cpldcpu/TouchSynth/docs/figures/s7_power.pdf

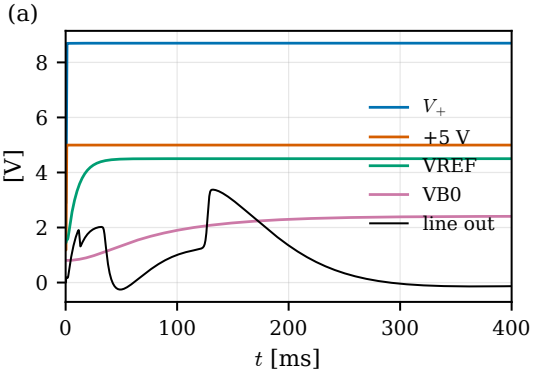
[picture p52: figure]
V + +5 V VREF; VB0 line out

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
−2024

# ¢VREF [mV] (b)
