cpldcpu/TouchSynth/docs/figures/s1_dco_waveforms.pdf

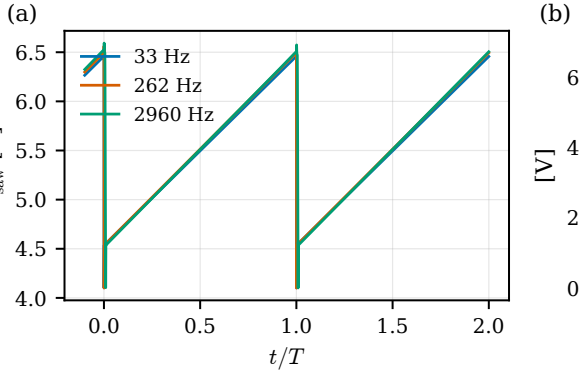
[picture p53: figure]
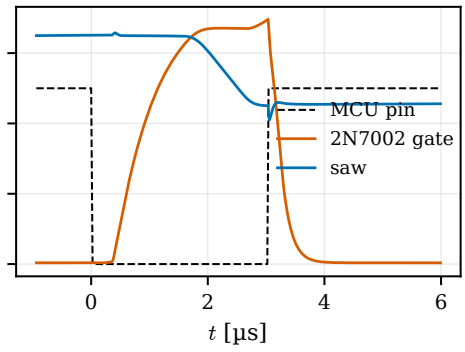
[picture p54: figure]
MCU pin; 2N7002 gate saw

### Vsaw [V]
