cpldcpu/TouchSynth/docs/figures/s2_cv_filter.pdf

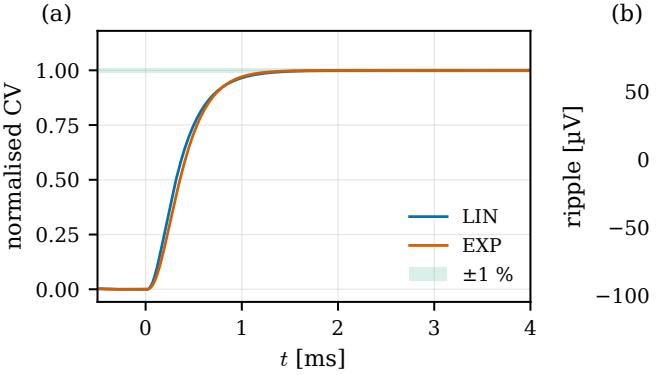
[picture p55: figure]
normalised CV; LIN EXP ±1 %; ripple [µV]
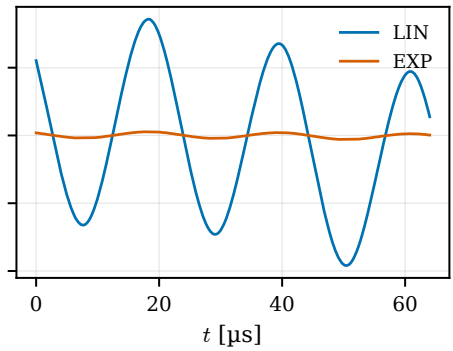
[picture p56: figure]
LIN EXP
