cpldcpu/TouchSynth/docs/figures/audio/01_saw.png

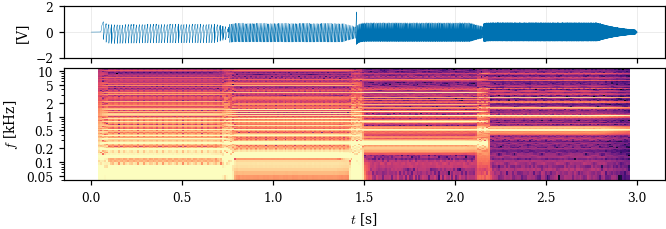
docs/figures/audio/01_saw.png
