cpldcpu/TouchSynth/docs/figures/audio/02_pulse.png

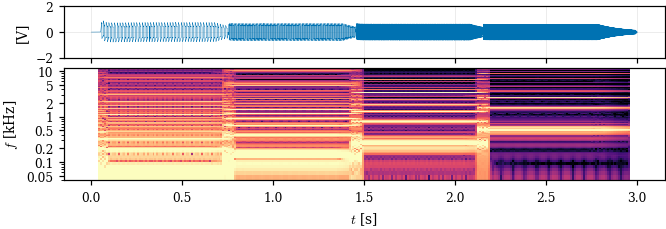
docs/figures/audio/02_pulse.png
