cpldcpu/TouchSynth/docs/figures/audio/03_pw_sweep.png

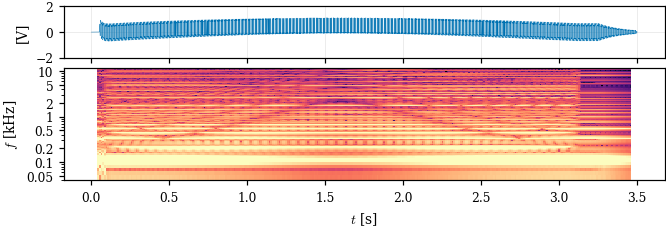
docs/figures/audio/03_pw_sweep.png
