cpldcpu/TouchSynth/docs/figures/audio/04_pwm_lfo.png

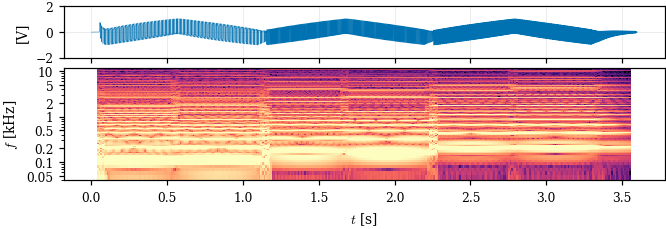
docs/figures/audio/04_pwm_lfo.png
