cpldcpu/TouchSynth/docs/figures/audio/05_sub.png

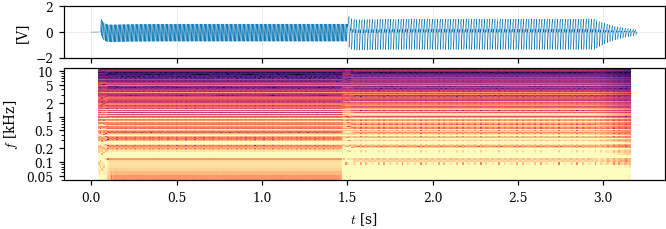
docs/figures/audio/05_sub.png
