cpldcpu/TouchSynth/docs/figures/audio/06_noise.png

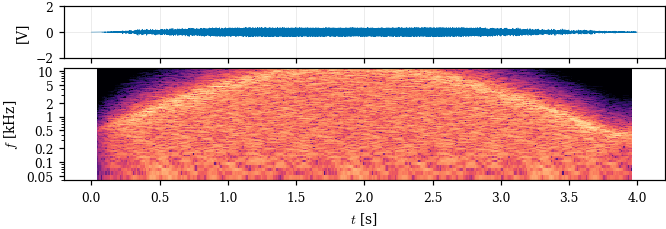
docs/figures/audio/06_noise.png
