cpldcpu/TouchSynth/docs/figures/audio/07_mix_drive.png

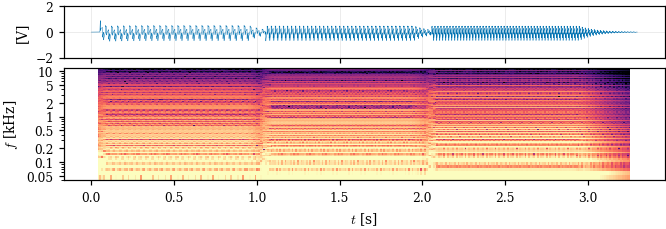
docs/figures/audio/07_mix_drive.png
