cpldcpu/TouchSynth/docs/figures/audio/09_resonance.png

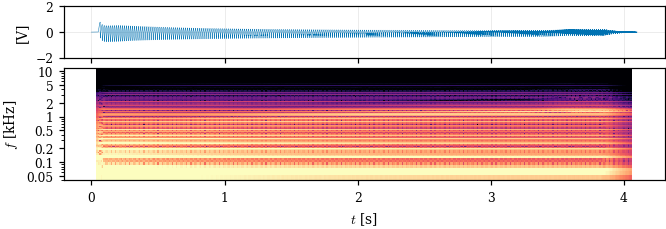
docs/figures/audio/09_resonance.png
