cpldcpu/TouchSynth/docs/figures/audio/12_filter_env.png

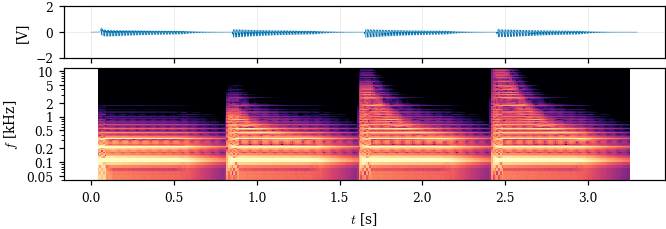
docs/figures/audio/12_filter_env.png
