cpldcpu/TouchSynth/docs/figures/audio/13_keytrack.png

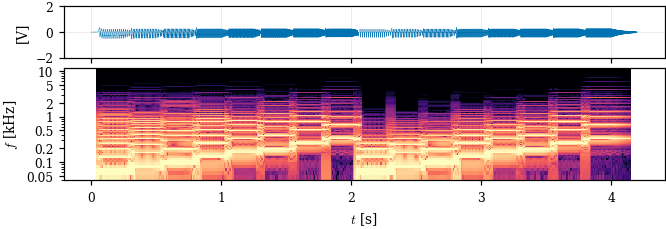
docs/figures/audio/13_keytrack.png
