cpldcpu/TouchSynth/docs/figures/audio/14_amp_env.png

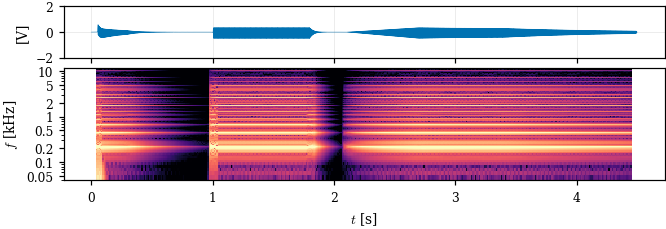
docs/figures/audio/14_amp_env.png
