cpldcpu/TouchSynth/docs/figures/audio/15_vca_trim.png

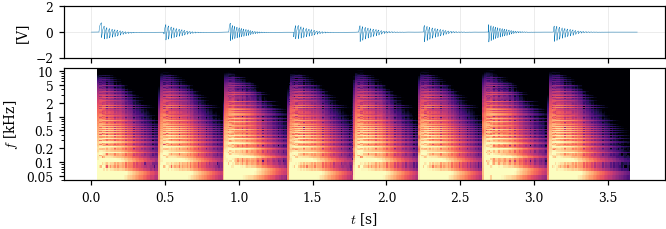
docs/figures/audio/15_vca_trim.png
