cpldcpu/TouchSynth/docs/figures/audio/16_glide.png

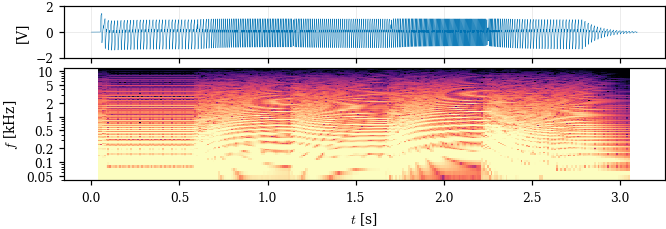
docs/figures/audio/16_glide.png
