cpldcpu/TouchSynth/docs/figures/audio/17_vibrato.png

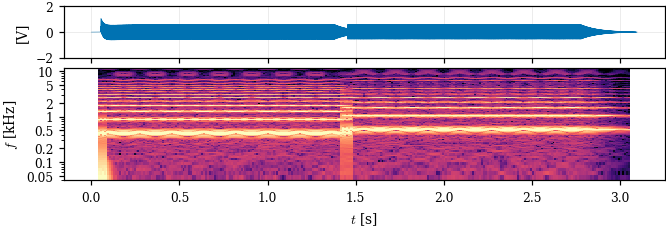
docs/figures/audio/17_vibrato.png
