cpldcpu/TouchSynth/docs/figures/audio/18_wah.png

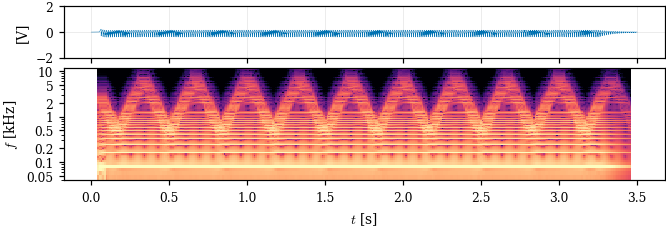
docs/figures/audio/18_wah.png
