cpldcpu/TouchSynth/docs/figures/audio/19_arp.png

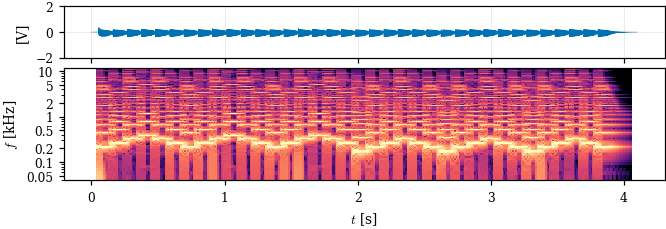
docs/figures/audio/19_arp.png
