cpldcpu/TouchSynth/docs/figures/hw_board1_dco.png

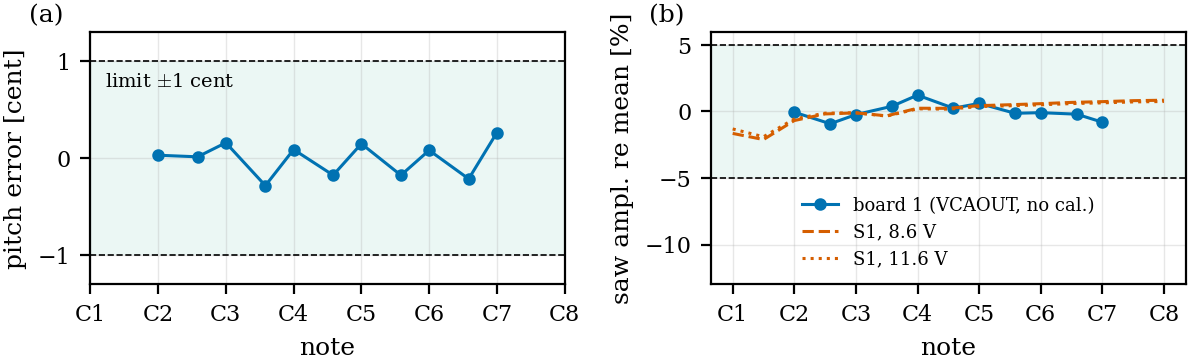
docs/figures/hw_board1_dco.png
