cpldcpu/TouchSynth/docs/figures/hw_board1_hum.png

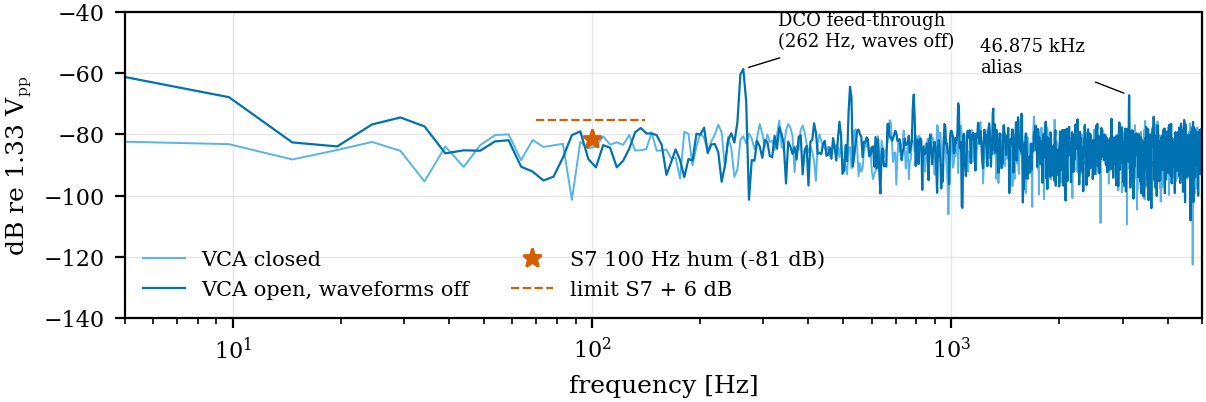
docs/figures/hw_board1_hum.png
