cpldcpu/TouchSynth/docs/figures/hw_board1_vca.png

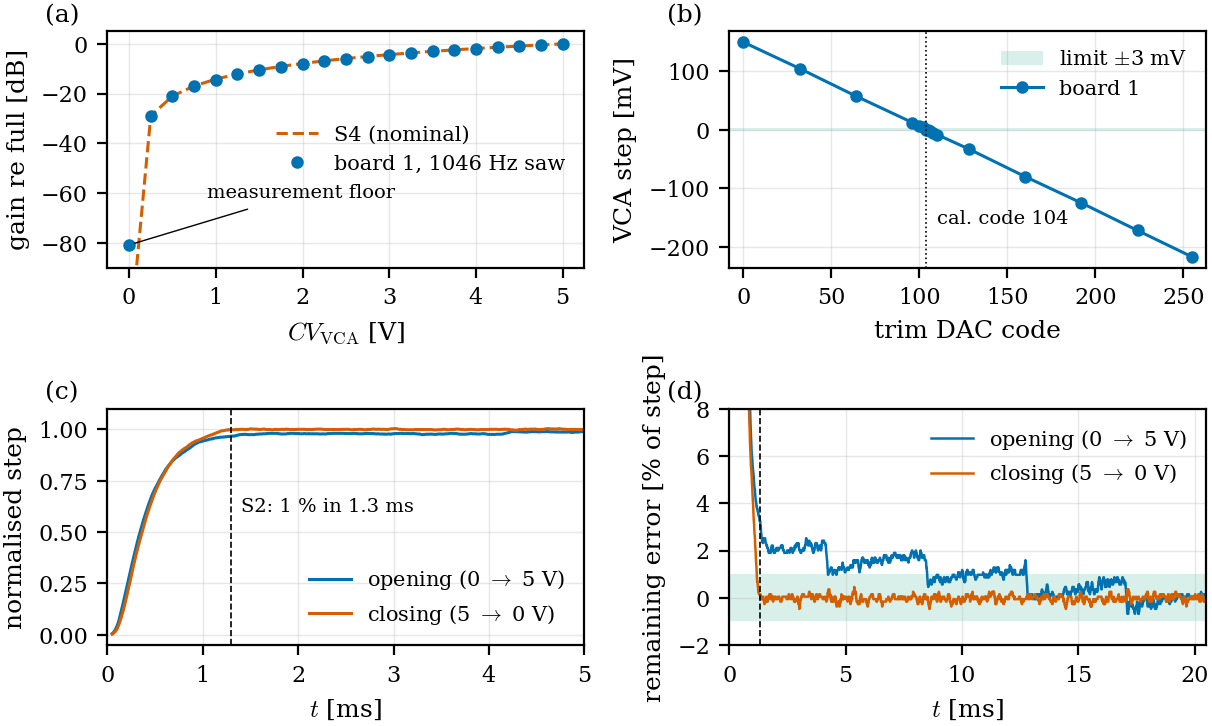
docs/figures/hw_board1_vca.png
