cpldcpu/TouchSynth/docs/figures/hw_board1_vcf.png

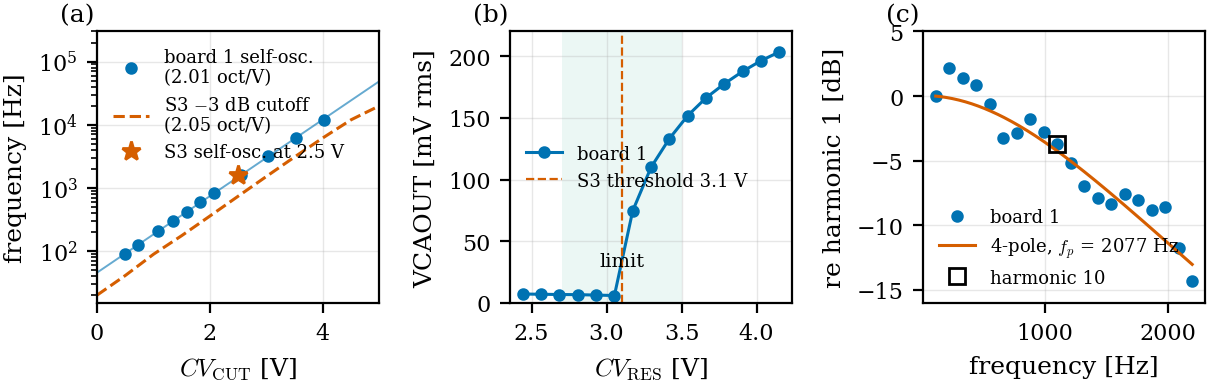
docs/figures/hw_board1_vcf.png
