cpldcpu/TouchSynth/docs/figures/pcb/render_top_placed.png

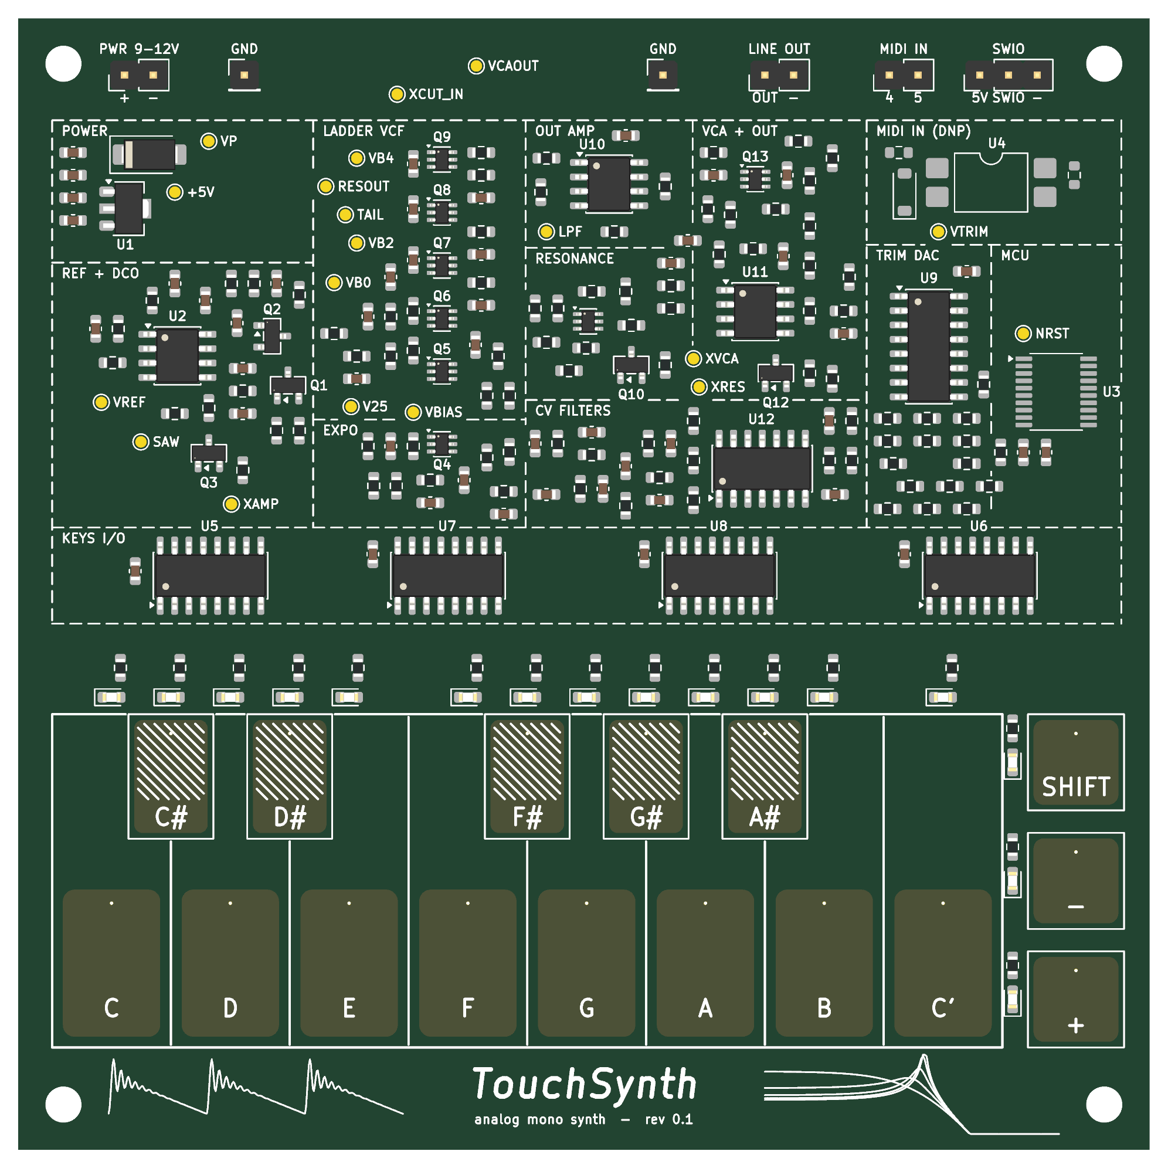
docs/figures/pcb/render_top_placed.png
