cpldcpu/TouchSynth/parts/jlcpcb_basic_and_promotional_parts.csv

lcsc | library | category | subcategory | mfr_part | brand | package | description | stock | price_usd | attributes | datasheet | url
C9634 | basic | Bipolar (BJT) | Bipolar (BJT) | D882(RANGE:160-320) | Jiangsu Changjing Electronics Technology Co., Ltd. | SOT-89-3L | -55℃~+150℃ 1 NPN 160 1uA 30V 3A 500mV 500mW 50MHz 6V NPN SOT-89-3L Bipolar (BJT) ROHS | 171660 | 0.0648 | Operating Temperature=-55℃~+150℃; Transition frequency(fT)=50MHz; Collector - Emitter Voltage VCEO=30V; Number=1 NPN; DC Current Gain=160; Current - Collector(Ic)=3A; Vce Saturation(VCE(sat))=500mV; Emitter-Base Voltage(Vebo)=6V; Pd - Power Dissipation=500mW; type=NPN; Current - Collector Cutoff=1uA | https://www.lcsc.com/datasheet/lcsc_datasheet_1809192311_Jiangsu-Changjing-Electronics-Technology-Co---Ltd--D882-RANGE-160-320_C9634.pdf | https://jlcpcb.com/partdetail/10164-D882_RANGE_160_320/C9634
C8512 | basic | Bipolar (BJT) | Bipolar (BJT) | MMBT2222A 1P | Jiangsu Changjing Electronics Technology Co., Ltd. | SOT-23 | -55℃~+150℃ 1 NPN 100 10nA 300MHz 300mW 40V 600mA 6V NPN SOT-23 Bipolar (BJT) ROHS | 585299 | 0.0174 | Operating Temperature=-55℃~+150℃; Transition frequency(fT)=300MHz; Collector - Emitter Voltage VCEO=40V; Number=1 NPN; DC Current Gain=100; Current - Collector(Ic)=600mA; Vce Saturation(VCE(sat))=-; Emitter-Base Voltage(Vebo)=6V; Pd - Power Dissipation=300mW; type=NPN; Current - Collector Cutoff=10nA | https://www.lcsc.com/datasheet/lcsc_datasheet_1811081957_Jiangsu-Changjing-Electronics-Technology-Co---Ltd--MMBT2222A-1P_C8512.pdf | https://jlcpcb.com/partdetail/9007-MMBT2222A1P/C8512
C20526 | basic | Bipolar (BJT) | Bipolar (BJT) | MMBT3904(RANGE:100-300) | Jiangsu Changjing Electronics Technology Co., Ltd. | SOT-23 | -55℃~+150℃ 1 NPN 100 100nA 200mA 200mW 300MHz 300mV 40V 6V NPN SOT-23 Bipolar (BJT) ROHS | 307260 | 0.0115 | Operating Temperature=-55℃~+150℃; Transition frequency(fT)=300MHz; Collector - Emitter Voltage VCEO=40V; Number=1 NPN; DC Current Gain=100; Current - Collector(Ic)=200mA; Vce Saturation(VCE(sat))=300mV; Emitter-Base Voltage(Vebo)=6V; Pd - Power Dissipation=200mW; type=NPN; Current - Collector Cutoff=100nA | https://www.lcsc.com/datasheet/lcsc_datasheet_2207041900_Jiangsu-Changjing-Electronics-Technology-Co---Ltd--MMBT3904-RANGE-100-300_C20526.pdf | https://jlcpcb.com/partdetail/21237-MMBT3904_RANGE_100_300/C20526
C8326 | basic | Bipolar (BJT) | Bipolar (BJT) | MMBT5401(RANGE:200-300) | Jiangsu Changjing Electronics Technology Co., Ltd. | SOT-23 | -55℃~+150℃ 1 PNP 100MHz 100nA 150V 300 300mW 500mV 5V 600mA PNP SOT-23 Bipolar (BJT) ROHS | 758577 | 0.0151 | Operating Temperature=-55℃~+150℃; Transition frequency(fT)=100MHz; Collector - Emitter Voltage VCEO=150V; Number=1 PNP; Configuration=-; DC Current Gain=300; Current - Collector(Ic)=600mA; Vce Saturation(VCE(sat))=500mV; Emitter-Base Voltage(Vebo)=5V; Pd - Power Dissipation=300mW; type=PNP; Current - Collector Cutoff=100nA | https://www.lcsc.com/datasheet/lcsc_datasheet_1809140241_Jiangsu-Changjing-Electronics-Technology-Co---Ltd--MMBT5401-RANGE-200-300_C8326.pdf | https://jlcpcb.com/partdetail/8818-MMBT5401_RANGE_200_300/C8326
C2145 | basic | Bipolar (BJT) | Bipolar (BJT) | MMBT5551(RANGE:200-300) | Jiangsu Changjing Electronics Technology Co., Ltd. | SOT-23 | -55℃~+150℃ 1 NPN 160V 200 200mV 300MHz 300mW 50nA 600mA 6V NPN SOT-23 Bipolar (BJT) ROHS | 1900579 | 0.0152 | Operating Temperature=-55℃~+150℃; Transition frequency(fT)=300MHz; Collector - Emitter Voltage VCEO=160V; Number=1 NPN; DC Current Gain=200; Current - Collector(Ic)=600mA; Vce Saturation(VCE(sat))=200mV; Emitter-Base Voltage(Vebo)=6V; Pd - Power Dissipation=300mW; type=NPN; Current - Collector Cutoff=50nA | https://www.lcsc.com/datasheet/lcsc_datasheet_2304140030_Jiangsu-Changjing-Electronics-Technology-Co---Ltd--MMBT5551-RANGE-200-300_C2145.pdf | https://jlcpcb.com/partdetail/2502-MMBT5551_RANGE_200_300/C2145
C2146 | basic | Bipolar (BJT) | Bipolar (BJT) | S8050 J3Y(RANGE:200-350) | Jiangsu Changjing Electronics Technology Co., Ltd. | SOT-23 | -55℃~+150℃ 1 NPN 100nA 150MHz 200 25V 300mW 500mA 5V 600mV NPN SOT-23 Bipolar (BJT) ROHS | 1263036 | 0.0147 | Operating Temperature=-55℃~+150℃; Transition frequency(fT)=150MHz; Collector - Emitter Voltage VCEO=25V; Number=1 NPN; Configuration=-; DC Current Gain=200; Current - Collector(Ic)=500mA; Vce Saturation(VCE(sat))=600mV; Emitter-Base Voltage(Vebo)=5V; Pd - Power Dissipation=300mW; type=NPN; Current - Collector Cutoff=100nA | https://www.lcsc.com/datasheet/lcsc_datasheet_2310131500_Jiangsu-Changjing-Electronics-Technology-Co---Ltd--S8050-J3Y-RANGE-200-350_C2146.pdf | https://jlcpcb.com/partdetail/2503-S8050_J3Y_RANGE_200_350/C2146
C105432 | basic | Bipolar (BJT) | Bipolar (BJT) | S8550(RANGE:120-200) | Jiangsu Changjing Electronics Technology Co., Ltd. | SOT-23 | -55℃~+150℃ 1 PNP 100nA 120 150MHz 25V 300mW 500mA 5V 600mV PNP SOT-23 Bipolar (BJT) ROHS | 191059 | 0.0166 | Operating Temperature=-55℃~+150℃; Transition frequency(fT)=150MHz; Collector - Emitter Voltage VCEO=25V; Number=1 PNP; DC Current Gain=120; Current - Collector(Ic)=500mA; Vce Saturation(VCE(sat))=600mV; Emitter-Base Voltage(Vebo)=5V; Pd - Power Dissipation=300mW; type=PNP; Current - Collector Cutoff=100nA | https://www.lcsc.com/datasheet/lcsc_datasheet_2304140030_Jiangsu-Changjing-Electronics-Technology-Co---Ltd--S8550-RANGE-120-200_C105432.pdf | https://jlcpcb.com/partdetail/106647-S8550_RANGE_120_200/C105432
C8543 | basic | Bipolar (BJT) | Bipolar (BJT) | S9012 2T1(RANGE:200-350) | Jiangsu Changjing Electronics Technology Co., Ltd. | SOT-23 | -55℃~+150℃ 1 PNP 100nA 120 150MHz 25V 300mW 500mA 5V 600mV PNP SOT-23 Bipolar (BJT) ROHS | 259409 | 0.0192 | Operating Temperature=-55℃~+150℃; Transition frequency(fT)=150MHz; Collector - Emitter Voltage VCEO=25V; Number=1 PNP; DC Current Gain=120; Current - Collector(Ic)=500mA; Vce Saturation(VCE(sat))=600mV; Emitter-Base Voltage(Vebo)=5V; Pd - Power Dissipation=300mW; type=PNP; Current - Collector Cutoff=100nA | https://www.lcsc.com/datasheet/lcsc_datasheet_2304140030_Jiangsu-Changjing-Electronics-Technology-Co---Ltd--S9012-2T1-RANGE-200-350_C8543.pdf | https://jlcpcb.com/partdetail/9038-S9012_2T1_RANGE_200_350/C8543
C6749 | basic | Bipolar (BJT) | Bipolar (BJT) | S9013 J3(RANGE:200-350) | Jiangsu Changjing Electronics Technology Co., Ltd. | SOT-23 | -55℃~+150℃ 1 NPN 100nA 120 150MHz 25V 300mW 500mA 5V 600mV NPN SOT-23 Bipolar (BJT) ROHS | 853229 | 0.0153 | Operating Temperature=-55℃~+150℃; Transition frequency(fT)=150MHz; Collector - Emitter Voltage VCEO=25V; Configuration=Standalone; Number=1 NPN; DC Current Gain=120; Current - Collector(Ic)=500mA; Vce Saturation(VCE(sat))=600mV; Emitter-Base Voltage(Vebo)=5V; Pd - Power Dissipation=300mW; type=NPN; Current - Collector Cutoff=100nA | https://www.lcsc.com/datasheet/lcsc_datasheet_1810051504_Jiangsu-Changjing-Electronics-Technology-Co---Ltd--S9013-J3-RANGE-200-350_C6749.pdf | https://jlcpcb.com/partdetail/7216-S9013_J3_RANGE_200_350/C6749
C2150 | basic | Bipolar (BJT) | Bipolar (BJT) | SS8050(RANGE:200-350) | Jiangsu Changjing Electronics Technology Co., Ltd. | SOT-23 | -55℃~+150℃ 1 NPN 1.5A 100MHz 100nA 200 25V 300mW 500mV 5V NPN SOT-23 Bipolar (BJT) ROHS | 1824424 | 0.0156 | Operating Temperature=-55℃~+150℃; Transition frequency(fT)=100MHz; Collector - Emitter Voltage VCEO=25V; Configuration=Standalone; Number=1 NPN; DC Current Gain=200; Current - Collector(Ic)=1.5A; Vce Saturation(VCE(sat))=500mV; Emitter-Base Voltage(Vebo)=5V; Pd - Power Dissipation=300mW; type=NPN; Current - Collector Cutoff=100nA | https://www.lcsc.com/datasheet/lcsc_datasheet_2303221100_Jiangsu-Changjing-Electronics-Technology-Co---Ltd--SS8050-RANGE-200-350_C2150.pdf | https://jlcpcb.com/partdetail/2507-SS8050_RANGE_200_350/C2150
C8542 | basic | Bipolar (BJT) | Bipolar (BJT) | SS8550 Y2(RANGE:200-350) | Jiangsu Changjing Electronics Technology Co., Ltd. | SOT-23 | -55℃~+150℃ 1 PNP 1.5A 100MHz 100nA 200 25V 300mW 500mV 5V PNP SOT-23 Bipolar (BJT) ROHS | 1075970 | 0.0155 | Operating Temperature=-55℃~+150℃; Transition frequency(fT)=100MHz; Collector - Emitter Voltage VCEO=25V; Number=1 PNP; Configuration=-; DC Current Gain=200; Current - Collector(Ic)=1.5A; Vce Saturation(VCE(sat))=500mV; Emitter-Base Voltage(Vebo)=5V; Pd - Power Dissipation=300mW; type=PNP; Current - Collector Cutoff=100nA | https://www.lcsc.com/datasheet/lcsc_datasheet_1810161212_Jiangsu-Changjing-Electronics-Technology-Co---Ltd--SS8550-Y2-RANGE-200-350_C8542.pdf | https://jlcpcb.com/partdetail/9037-SS8550_Y2_RANGE_200_350/C8542
C2488 | basic | Bridge Rectifiers | Bridge Rectifiers | MB10S-50MIL | MDD(Microdiode Semiconductor) | MBS | -55℃~+150℃ 1.1V@400mA 1A 1kV 35A 5uA@1kV Single-Phase Rectifier MBS Bridge Rectifiers ROHS | 690760 | 0.027 | Voltage - Forward(Vf@If)=1.1V@400mA; Type=Single-Phase Rectifier; Non-Repetitive Peak Forward Surge Current=35A; Voltage - DC Reverse(Vr)=1kV; Operating Junction Temperature Range=-55℃~+150℃; Current - Rectified=1A; Reverse Leakage Current (Ir)=5uA@1kV | https://www.lcsc.com/datasheet/lcsc_datasheet_2408090954_MDD-Microdiode-Semiconductor-MB10S_C2488.pdf | https://jlcpcb.com/partdetail/2865-MB10S50MIL/C2488
C17168 | basic | Chip Resistor - Surface Mount | Chip Resistor - Surface Mount | 0402WGF0000TCE | UNI-ROYAL(Uniroyal Elec) | 0402 | -55℃~+155℃ 0Ω 50V 62.5mW Thick Film Resistor ±1% ±800ppm/℃ 0402 Chip Resistor - Surface Mount ROHS | 10247414 | 0.0025 | Resistance=0Ω; Operating Temperature=-55℃~+155℃; Power(Watts)=62.5mW; Type=Thick Film Resistor; Voltage-Supply(Max)=50V; Tolerance=±1%; Temperature Coefficient=±800ppm/℃ | https://www.lcsc.com/datasheet/lcsc_datasheet_2206010216_UNI-ROYAL-Uniroyal-Elec-0402WGF0000TCE_C17168.pdf | https://jlcpcb.com/partdetail/17853-0402WGF0000TCE/C17168
C25076 | basic | Chip Resistor - Surface Mount | Chip Resistor - Surface Mount | 0402WGF1000TCE | UNI-ROYAL(Uniroyal Elec) | 0402 | -55℃~+155℃ 100Ω 50V 62.5mW Thick Film Resistor ±1% ±100ppm/℃ 0402 Chip Resistor - Surface Mount ROHS | 4679469 | 0.0012 | Resistance=100Ω; Operating Temperature=-55℃~+155℃; Power(Watts)=62.5mW; Type=Thick Film Resistor; Voltage-Supply(Max)=50V; Tolerance=±1%; Temperature Coefficient=±100ppm/℃ | https://www.lcsc.com/datasheet/lcsc_datasheet_2205311900_UNI-ROYAL-Uniroyal-Elec-0402WGF1000TCE_C25076.pdf | https://jlcpcb.com/partdetail/25819-0402WGF1000TCE/C25076
C11702 | basic | Chip Resistor - Surface Mount | Chip Resistor - Surface Mount | 0402WGF1001TCE | UNI-ROYAL(Uniroyal Elec) | 0402 | -55℃~+155℃ 1kΩ 50V 62.5mW Thick Film Resistor ±1% ±100ppm/℃ 0402 Chip Resistor - Surface Mount ROHS | 8639962 | 0.0018 | Resistance=1kΩ; Operating Temperature=-55℃~+155℃; Power(Watts)=62.5mW; Type=Thick Film Resistor; Voltage-Supply(Max)=50V; Tolerance=±1%; Temperature Coefficient=±100ppm/℃ | https://www.lcsc.com/datasheet/lcsc_datasheet_2206010216_UNI-ROYAL-Uniroyal-Elec-0402WGF1001TCE_C11702.pdf | https://jlcpcb.com/partdetail/12256-0402WGF1001TCE/C11702
C25744 | basic | Chip Resistor - Surface Mount | Chip Resistor - Surface Mount | 0402WGF1002TCE | UNI-ROYAL(Uniroyal Elec) | 0402 | -55℃~+155℃ 10kΩ 50V 62.5mW Thick Film Resistor ±1% ±100ppm/℃ 0402 Chip Resistor - Surface Mount ROHS | 23696554 | 0.0034 | Resistance=10kΩ; Operating Temperature=-55℃~+155℃; Power(Watts)=62.5mW; Type=Thick Film Resistor; Voltage-Supply(Max)=50V; Tolerance=±1%; Temperature Coefficient=±100ppm/℃ | https://www.lcsc.com/datasheet/lcsc_datasheet_2411221126_UNI-ROYAL-Uniroyal-Elec-0402WGF1002TCE_C25744.pdf | https://jlcpcb.com/partdetail/26487-0402WGF1002TCE/C25744
C25741 | basic | Chip Resistor - Surface Mount | Chip Resistor - Surface Mount | 0402WGF1003TCE | UNI-ROYAL(Uniroyal Elec) | 0402 | -55℃~+155℃ 100kΩ 50V 62.5mW Thick Film Resistor ±1% ±100ppm/℃ 0402 Chip Resistor - Surface Mount ROHS | 9789764 | 0.0025 | Resistance=100kΩ; Operating Temperature=-55℃~+155℃; Power(Watts)=62.5mW; Type=Thick Film Resistor; Voltage-Supply(Max)=50V; Tolerance=±1%; Temperature Coefficient=±100ppm/℃ | https://www.lcsc.com/datasheet/lcsc_datasheet_2206010100_UNI-ROYAL-Uniroyal-Elec-0402WGF1003TCE_C25741.pdf | https://jlcpcb.com/partdetail/26484-0402WGF1003TCE/C25741
C26083 | basic | Chip Resistor - Surface Mount | Chip Resistor - Surface Mount | 0402WGF1004TCE | UNI-ROYAL(Uniroyal Elec) | 0402 | -55℃~+155℃ 1MΩ 50V 62.5mW Thick Film Resistor ±1% ±100ppm/℃ 0402 Chip Resistor - Surface Mount ROHS | 2677038 | 0.0026 | Resistance=1MΩ; Operating Temperature=-55℃~+155℃; Power(Watts)=62.5mW; Type=Thick Film Resistor; Voltage-Supply(Max)=50V; Tolerance=±1%; Temperature Coefficient=±100ppm/℃ | https://www.lcsc.com/datasheet/lcsc_datasheet_2206010030_UNI-ROYAL-Uniroyal-Elec-0402WGF1004TCE_C26083.pdf | https://jlcpcb.com/partdetail/26826-0402WGF1004TCE/C26083
C25077 | basic | Chip Resistor - Surface Mount | Chip Resistor - Surface Mount | 0402WGF100JTCE | UNI-ROYAL(Uniroyal Elec) | 0402 | -55℃~+155℃ 10Ω 50V 62.5mW Thick Film Resistor ±1% ±200ppm/℃ 0402 Chip Resistor - Surface Mount ROHS | 1977483 | 0.0029 | Resistance=10Ω; Operating Temperature=-55℃~+155℃; Power(Watts)=62.5mW; Type=Thick Film Resistor; Voltage-Supply(Max)=50V; Tolerance=±1%; Temperature Coefficient=±200ppm/℃ | https://www.lcsc.com/datasheet/lcsc_datasheet_2411221126_UNI-ROYAL-Uniroyal-Elec-0402WGF100JTCE_C25077.pdf | https://jlcpcb.com/partdetail/25820-0402WGF100JTCE/C25077
C25079 | basic | Chip Resistor - Surface Mount | Chip Resistor - Surface Mount | 0402WGF1200TCE | UNI-ROYAL(Uniroyal Elec) | 0402 | -55℃~+155℃ 120Ω 50V 62.5mW Thick Film Resistor ±1% ±100ppm/℃ 0402 Chip Resistor - Surface Mount ROHS | 834434 | 0.0034 | Resistance=120Ω; Operating Temperature=-55℃~+155℃; Power(Watts)=62.5mW; Type=Thick Film Resistor; Voltage-Supply(Max)=50V; Tolerance=±1%; Temperature Coefficient=±100ppm/℃ | https://www.lcsc.com/datasheet/lcsc_datasheet_2205311900_UNI-ROYAL-Uniroyal-Elec-0402WGF1200TCE_C25079.pdf | https://jlcpcb.com/partdetail/25822-0402WGF1200TCE/C25079
C25752 | basic | Chip Resistor - Surface Mount | Chip Resistor - Surface Mount | 0402WGF1202TCE | UNI-ROYAL(Uniroyal Elec) | 0402 | -55℃~+155℃ 12kΩ 50V 62.5mW Thick Film Resistor ±1% ±100ppm/℃ 0402 Chip Resistor - Surface Mount ROHS | 1166447 | 0.0018 | Resistance=12kΩ; Operating Temperature=-55℃~+155℃; Power(Watts)=62.5mW; Type=Thick Film Resistor; Voltage-Supply(Max)=50V; Tolerance=±1%; Temperature Coefficient=±100ppm/℃ | https://www.lcsc.com/datasheet/lcsc_datasheet_2206010100_UNI-ROYAL-Uniroyal-Elec-0402WGF1202TCE_C25752.pdf | https://jlcpcb.com/partdetail/26495-0402WGF1202TCE/C25752
C25867 | basic | Chip Resistor - Surface Mount | Chip Resistor - Surface Mount | 0402WGF1501TCE | UNI-ROYAL(Uniroyal Elec) | 0402 | -55℃~+155℃ 1.5kΩ 50V 62.5mW Thick Film Resistor ±1% ±100ppm/℃ 0402 Chip Resistor - Surface Mount ROHS | 2260625 | 0.0029 | Resistance=1.5kΩ; Operating Temperature=-55℃~+155℃; Power(Watts)=62.5mW; Type=Thick Film Resistor; Voltage-Supply(Max)=50V; Tolerance=±1%; Temperature Coefficient=±100ppm/℃ | https://www.lcsc.com/datasheet/lcsc_datasheet_2206010045_UNI-ROYAL-Uniroyal-Elec-0402WGF1501TCE_C25867.pdf | https://jlcpcb.com/partdetail/26610-0402WGF1501TCE/C25867
C25756 | basic | Chip Resistor - Surface Mount | Chip Resistor - Surface Mount | 0402WGF1502TCE | UNI-ROYAL(Uniroyal Elec) | 0402 | -55℃~+155℃ 15kΩ 50V 62.5mW Thick Film Resistor ±1% ±100ppm/℃ 0402 Chip Resistor - Surface Mount ROHS | 1232322 | 0.0016 | Resistance=15kΩ; Operating Temperature=-55℃~+155℃; Power(Watts)=62.5mW; Type=Thick Film Resistor; Voltage-Supply(Max)=50V; Tolerance=±1%; Temperature Coefficient=±100ppm/℃ | https://www.lcsc.com/datasheet/lcsc_datasheet_2206010100_UNI-ROYAL-Uniroyal-Elec-0402WGF1502TCE_C25756.pdf | https://jlcpcb.com/partdetail/26499-0402WGF1502TCE/C25756
C25087 | basic | Chip Resistor - Surface Mount | Chip Resistor - Surface Mount | 0402WGF2000TCE | UNI-ROYAL(Uniroyal Elec) | 0402 | -55℃~+155℃ 200Ω 50V 62.5mW Thick Film Resistor ±1% ±100ppm/℃ 0402 Chip Resistor - Surface Mount ROHS | 2671147 | 0.0029 | Resistance=200Ω; Operating Temperature=-55℃~+155℃; Power(Watts)=62.5mW; Type=Thick Film Resistor; Voltage-Supply(Max)=50V; Tolerance=±1%; Temperature Coefficient=±100ppm/℃ | https://www.lcsc.com/datasheet/lcsc_datasheet_2205311900_UNI-ROYAL-Uniroyal-Elec-0402WGF2000TCE_C25087.pdf | https://jlcpcb.com/partdetail/25830-0402WGF2000TCE/C25087
C4109 | basic | Chip Resistor - Surface Mount | Chip Resistor - Surface Mount | 0402WGF2001TCE | UNI-ROYAL(Uniroyal Elec) | 0402 | -55℃~+155℃ 2kΩ 50V 62.5mW Thick Film Resistor ±1% ±100ppm/℃ 0402 Chip Resistor - Surface Mount ROHS | 8525192 | 0.0026 | Resistance=2kΩ; Operating Temperature=-55℃~+155℃; Power(Watts)=62.5mW; Type=Thick Film Resistor; Voltage-Supply(Max)=50V; Tolerance=±1%; Temperature Coefficient=±100ppm/℃ | https://www.lcsc.com/datasheet/lcsc_datasheet_2206010230_UNI-ROYAL-Uniroyal-Elec-0402WGF2001TCE_C4109.pdf | https://jlcpcb.com/partdetail/4516-0402WGF2001TCE/C4109
C25765 | basic | Chip Resistor - Surface Mount | Chip Resistor - Surface Mount | 0402WGF2002TCE | UNI-ROYAL(Uniroyal Elec) | 0402 | -55℃~+155℃ 20kΩ 50V 62.5mW Thick Film Resistor ±1% ±100ppm/℃ 0402 Chip Resistor - Surface Mount ROHS | 1274594 | 0.0022 | Resistance=20kΩ; Operating Temperature=-55℃~+155℃; Power(Watts)=62.5mW; Type=Thick Film Resistor; Voltage-Supply(Max)=50V; Tolerance=±1%; Temperature Coefficient=±100ppm/℃ | https://www.lcsc.com/datasheet/lcsc_datasheet_2206010100_UNI-ROYAL-Uniroyal-Elec-0402WGF2002TCE_C25765.pdf | https://jlcpcb.com/partdetail/26508-0402WGF2002TCE/C25765
C25764 | basic | Chip Resistor - Surface Mount | Chip Resistor - Surface Mount | 0402WGF2003TCE | UNI-ROYAL(Uniroyal Elec) | 0402 | -55℃~+155℃ 200kΩ 50V 62.5mW Thick Film Resistor ±1% ±100ppm/℃ 0402 Chip Resistor - Surface Mount ROHS | 2438420 | 0.0018 | Resistance=200kΩ; Operating Temperature=-55℃~+155℃; Power(Watts)=62.5mW; Type=Thick Film Resistor; Voltage-Supply(Max)=50V; Tolerance=±1%; Temperature Coefficient=±100ppm/℃ | https://www.lcsc.com/datasheet/lcsc_datasheet_2206010100_UNI-ROYAL-Uniroyal-Elec-0402WGF2003TCE_C25764.pdf | https://jlcpcb.com/partdetail/26507-0402WGF2003TCE/C25764
C25091 | basic | Chip Resistor - Surface Mount | Chip Resistor - Surface Mount | 0402WGF2200TCE | UNI-ROYAL(Uniroyal Elec) | 0402 | -55℃~+155℃ 220Ω 50V 62.5mW Thick Film Resistor ±1% ±100ppm/℃ 0402 Chip Resistor - Surface Mount ROHS | 1478349 | 0.0034 | Resistance=220Ω; Operating Temperature=-55℃~+155℃; Power(Watts)=62.5mW; Type=Thick Film Resistor; Voltage-Supply(Max)=50V; Tolerance=±1%; Temperature Coefficient=±100ppm/℃ | https://www.lcsc.com/datasheet/lcsc_datasheet_2205311900_UNI-ROYAL-Uniroyal-Elec-0402WGF2200TCE_C25091.pdf | https://jlcpcb.com/partdetail/25834-0402WGF2200TCE/C25091
C25879 | basic | Chip Resistor - Surface Mount | Chip Resistor - Surface Mount | 0402WGF2201TCE | UNI-ROYAL(Uniroyal Elec) | 0402 | -55℃~+155℃ 2.2kΩ 50V 62.5mW Thick Film Resistor ±1% ±100ppm/℃ 0402 Chip Resistor - Surface Mount ROHS | 1179138 | 0.0053 | Resistance=2.2kΩ; Operating Temperature=-55℃~+155℃; Power(Watts)=62.5mW; Type=Thick Film Resistor; Voltage-Supply(Max)=50V; Tolerance=±1%; Temperature Coefficient=±100ppm/℃ | https://www.lcsc.com/datasheet/lcsc_datasheet_2206010045_UNI-ROYAL-Uniroyal-Elec-0402WGF2201TCE_C25879.pdf | https://jlcpcb.com/partdetail/26622-0402WGF2201TCE/C25879
C25768 | basic | Chip Resistor - Surface Mount | Chip Resistor - Surface Mount | 0402WGF2202TCE | UNI-ROYAL(Uniroyal Elec) | 0402 | -55℃~+155℃ 22kΩ 50V 62.5mW Thick Film Resistor ±1% ±100ppm/℃ 0402 Chip Resistor - Surface Mount ROHS | 903059 | 0.0024 | Resistance=22kΩ; Operating Temperature=-55℃~+155℃; Power(Watts)=62.5mW; Type=Thick Film Resistor; Voltage-Supply(Max)=50V; Tolerance=±1%; Temperature Coefficient=±100ppm/℃ | https://www.lcsc.com/datasheet/lcsc_datasheet_2206010100_UNI-ROYAL-Uniroyal-Elec-0402WGF2202TCE_C25768.pdf | https://jlcpcb.com/partdetail/26511-0402WGF2202TCE/C25768
C25092 | basic | Chip Resistor - Surface Mount | Chip Resistor - Surface Mount | 0402WGF220JTCE | UNI-ROYAL(Uniroyal Elec) | 0402 | -55℃~+155℃ 22Ω 50V 62.5mW Thick Film Resistor ±1% ±100ppm/℃ 0402 Chip Resistor - Surface Mount ROHS | 5223959 | 0.0027 | Resistance=22Ω; Operating Temperature=-55℃~+155℃; Power(Watts)=62.5mW; Type=Thick Film Resistor; Voltage-Supply(Max)=50V; Tolerance=±1%; Temperature Coefficient=±100ppm/℃ | https://www.lcsc.com/datasheet/lcsc_datasheet_2205311900_UNI-ROYAL-Uniroyal-Elec-0402WGF220JTCE_C25092.pdf | https://jlcpcb.com/partdetail/25835-0402WGF220JTCE/C25092
C25104 | basic | Chip Resistor - Surface Mount | Chip Resistor - Surface Mount | 0402WGF3300TCE | UNI-ROYAL(Uniroyal Elec) | 0402 | -55℃~+155℃ 330Ω 50V 62.5mW Thick Film Resistor ±1% ±100ppm/℃ 0402 Chip Resistor - Surface Mount ROHS | 1303252 | 0.004 | Resistance=330Ω; Operating Temperature=-55℃~+155℃; Power(Watts)=62.5mW; Type=Thick Film Resistor; Voltage-Supply(Max)=50V; Tolerance=±1%; Temperature Coefficient=±100ppm/℃ | https://www.lcsc.com/datasheet/lcsc_datasheet_2205311900_UNI-ROYAL-Uniroyal-Elec-0402WGF3300TCE_C25104.pdf | https://jlcpcb.com/partdetail/25847-0402WGF3300TCE/C25104
C25890 | basic | Chip Resistor - Surface Mount | Chip Resistor - Surface Mount | 0402WGF3301TCE | UNI-ROYAL(Uniroyal Elec) | 0402 | -55℃~+155℃ 3.3kΩ 50V 62.5mW Thick Film Resistor ±1% ±100ppm/℃ 0402 Chip Resistor - Surface Mount ROHS | 2209038 | 0.0035 | Resistance=3.3kΩ; Operating Temperature=-55℃~+155℃; Power(Watts)=62.5mW; Type=Thick Film Resistor; Voltage-Supply(Max)=50V; Tolerance=±1%; Temperature Coefficient=±100ppm/℃ | https://www.lcsc.com/datasheet/lcsc_datasheet_2206010045_UNI-ROYAL-Uniroyal-Elec-0402WGF3301TCE_C25890.pdf | https://jlcpcb.com/partdetail/26633-0402WGF3301TCE/C25890
C25779 | basic | Chip Resistor - Surface Mount | Chip Resistor - Surface Mount | 0402WGF3302TCE | UNI-ROYAL(Uniroyal Elec) | 0402 | -55℃~+155℃ 33kΩ 50V 62.5mW Thick Film Resistor ±1% ±100ppm/℃ 0402 Chip Resistor - Surface Mount ROHS | 1303267 | 0.0058 | Resistance=33kΩ; Operating Temperature=-55℃~+155℃; Power(Watts)=62.5mW; Type=Thick Film Resistor; Voltage-Supply(Max)=50V; Tolerance=±1%; Temperature Coefficient=±100ppm/℃ | https://www.lcsc.com/datasheet/lcsc_datasheet_2206010100_UNI-ROYAL-Uniroyal-Elec-0402WGF3302TCE_C25779.pdf | https://jlcpcb.com/partdetail/26522-0402WGF3302TCE/C25779
C25105 | basic | Chip Resistor - Surface Mount | Chip Resistor - Surface Mount | 0402WGF330JTCE | UNI-ROYAL(Uniroyal Elec) | 0402 | -55℃~+155℃ 33Ω 50V 62.5mW Thick Film Resistor ±1% ±100ppm/℃ 0402 Chip Resistor - Surface Mount ROHS | 2133942 | 0.0035 | Resistance=33Ω; Operating Temperature=-55℃~+155℃; Power(Watts)=62.5mW; Type=Thick Film Resistor; Voltage-Supply(Max)=50V; Tolerance=±1%; Temperature Coefficient=±100ppm/℃ | https://www.lcsc.com/datasheet/lcsc_datasheet_2205311900_UNI-ROYAL-Uniroyal-Elec-0402WGF330JTCE_C25105.pdf | https://jlcpcb.com/partdetail/25848-0402WGF330JTCE/C25105
C25117 | basic | Chip Resistor - Surface Mount | Chip Resistor - Surface Mount | 0402WGF4700TCE | UNI-ROYAL(Uniroyal Elec) | 0402 | -55℃~+155℃ 470Ω 50V 62.5mW Thick Film Resistor ±1% ±100ppm/℃ 0402 Chip Resistor - Surface Mount ROHS | 1039898 | 0.0027 | Resistance=470Ω; Operating Temperature=-55℃~+155℃; Power(Watts)=62.5mW; Type=Thick Film Resistor; Voltage-Supply(Max)=50V; Tolerance=±1%; Temperature Coefficient=±100ppm/℃ | https://www.lcsc.com/datasheet/lcsc_datasheet_2205311900_UNI-ROYAL-Uniroyal-Elec-0402WGF4700TCE_C25117.pdf | https://jlcpcb.com/partdetail/25860-0402WGF4700TCE/C25117
C25900 | basic | Chip Resistor - Surface Mount | Chip Resistor - Surface Mount | 0402WGF4701TCE | UNI-ROYAL(Uniroyal Elec) | 0402 | -55℃~+155℃ 4.7kΩ 50V 62.5mW Thick Film Resistor ±1% ±100ppm/℃ 0402 Chip Resistor - Surface Mount ROHS | 16216317 | 0.0027 | Resistance=4.7kΩ; Operating Temperature=-55℃~+155℃; Power(Watts)=62.5mW; Type=Thick Film Resistor; Voltage-Supply(Max)=50V; Tolerance=±1%; Temperature Coefficient=±100ppm/℃ | https://www.lcsc.com/datasheet/lcsc_datasheet_2206010045_UNI-ROYAL-Uniroyal-Elec-0402WGF4701TCE_C25900.pdf | https://jlcpcb.com/partdetail/26643-0402WGF4701TCE/C25900
C25792 | basic | Chip Resistor - Surface Mount | Chip Resistor - Surface Mount | 0402WGF4702TCE | UNI-ROYAL(Uniroyal Elec) | 0402 | -55℃~+155℃ 47kΩ 50V 62.5mW Thick Film Resistor ±1% ±100ppm/℃ 0402 Chip Resistor - Surface Mount ROHS | 5804332 | 0.0026 | Resistance=47kΩ; Operating Temperature=-55℃~+155℃; Power(Watts)=62.5mW; Type=Thick Film Resistor; Voltage-Supply(Max)=50V; Tolerance=±1%; Temperature Coefficient=±100ppm/℃ | https://www.lcsc.com/datasheet/lcsc_datasheet_2206010100_UNI-ROYAL-Uniroyal-Elec-0402WGF4702TCE_C25792.pdf | https://jlcpcb.com/partdetail/26535-0402WGF4702TCE/C25792
C25120 | basic | Chip Resistor - Surface Mount | Chip Resistor - Surface Mount | 0402WGF499JTCE | UNI-ROYAL(Uniroyal Elec) | 0402 | -55℃~+155℃ 49.9Ω 50V 62.5mW Thick Film Resistor ±1% ±100ppm/℃ 0402 Chip Resistor - Surface Mount ROHS | 1499133 | 0.0027 | Resistance=49.9Ω; Operating Temperature=-55℃~+155℃; Power(Watts)=62.5mW; Type=Thick Film Resistor; Voltage-Supply(Max)=50V; Tolerance=±1%; Temperature Coefficient=±100ppm/℃ | https://www.lcsc.com/datasheet/lcsc_datasheet_2205311900_UNI-ROYAL-Uniroyal-Elec-0402WGF499JTCE_C25120.pdf | https://jlcpcb.com/partdetail/25863-0402WGF499JTCE/C25120
C25123 | basic | Chip Resistor - Surface Mount | Chip Resistor - Surface Mount | 0402WGF5100TCE | UNI-ROYAL(Uniroyal Elec) | 0402 | -55℃~+155℃ 50V 510Ω 62.5mW Thick Film Resistor ±1% ±100ppm/℃ 0402 Chip Resistor - Surface Mount ROHS | 2158015 | 0.0017 | Resistance=510Ω; Operating Temperature=-55℃~+155℃; Power(Watts)=62.5mW; Type=Thick Film Resistor; Voltage-Supply(Max)=50V; Tolerance=±1%; Temperature Coefficient=±100ppm/℃ | https://www.lcsc.com/datasheet/lcsc_datasheet_2205311900_UNI-ROYAL-Uniroyal-Elec-0402WGF5100TCE_C25123.pdf | https://jlcpcb.com/partdetail/25866-0402WGF5100TCE/C25123
C25905 | basic | Chip Resistor - Surface Mount | Chip Resistor - Surface Mount | 0402WGF5101TCE | UNI-ROYAL(Uniroyal Elec) | 0402 | -55℃~+155℃ 5.1kΩ 50V 62.5mW Thick Film Resistor ±1% ±100ppm/℃ 0402 Chip Resistor - Surface Mount ROHS | 6639240 | 0.0024 | Resistance=5.1kΩ; Operating Temperature=-55℃~+155℃; Power(Watts)=62.5mW; Type=Thick Film Resistor; Voltage-Supply(Max)=50V; Tolerance=±1%; Temperature Coefficient=±100ppm/℃ | https://www.lcsc.com/datasheet/lcsc_datasheet_2206010045_UNI-ROYAL-Uniroyal-Elec-0402WGF5101TCE_C25905.pdf | https://jlcpcb.com/partdetail/26648-0402WGF5101TCE/C25905
C25794 | basic | Chip Resistor - Surface Mount | Chip Resistor - Surface Mount | 0402WGF5102TCE | UNI-ROYAL(Uniroyal Elec) | 0402 | -55℃~+155℃ 50V 51kΩ 62.5mW Thick Film Resistor ±1% ±100ppm/℃ 0402 Chip Resistor - Surface Mount ROHS | 2000998 | 0.0019 | Resistance=51kΩ; Operating Temperature=-55℃~+155℃; Power(Watts)=62.5mW; Type=Thick Film Resistor; Voltage-Supply(Max)=50V; Tolerance=±1%; Temperature Coefficient=±100ppm/℃ | https://www.lcsc.com/datasheet/lcsc_datasheet_2411221126_UNI-ROYAL-Uniroyal-Elec-0402WGF5102TCE_C25794.pdf | https://jlcpcb.com/partdetail/26537-0402WGF5102TCE/C25794
C21189 | basic | Chip Resistor - Surface Mount | Chip Resistor - Surface Mount | 0603WAF0000T5E | UNI-ROYAL(Uniroyal Elec) | 0603 | -55℃~+155℃ 0Ω 100mW 75V Thick Film Resistor ±1% 0603 Chip Resistor - Surface Mount ROHS | 24113015 | 0.0023 | Resistance=0Ω; Operating Temperature=-55℃~+155℃; Power(Watts)=100mW; Type=Thick Film Resistor; Voltage-Supply(Max)=75V; Tolerance=±1%; Temperature Coefficient=- | https://www.lcsc.com/datasheet/lcsc_datasheet_2411221126_UNI-ROYAL-Uniroyal-Elec-0603WAF0000T5E_C21189.pdf | https://jlcpcb.com/partdetail/21903-0603WAF0000T5E/C21189
C22775 | basic | Chip Resistor - Surface Mount | Chip Resistor - Surface Mount | 0603WAF1000T5E | UNI-ROYAL(Uniroyal Elec) | 0603 | -55℃~+155℃ 100mW 100Ω 75V Thick Film Resistor ±1% ±100ppm/℃ 0603 Chip Resistor - Surface Mount ROHS | 12407886 | 0.0031 | Resistance=100Ω; Operating Temperature=-55℃~+155℃; Power(Watts)=100mW; Type=Thick Film Resistor; Voltage-Supply(Max)=75V; Tolerance=±1%; Temperature Coefficient=±100ppm/℃ | https://www.lcsc.com/datasheet/lcsc_datasheet_2411221126_UNI-ROYAL-Uniroyal-Elec-0603WAF1000T5E_C22775.pdf | https://jlcpcb.com/partdetail/23502-0603WAF1000T5E/C22775
C21190 | basic | Chip Resistor - Surface Mount | Chip Resistor - Surface Mount | 0603WAF1001T5E | UNI-ROYAL(Uniroyal Elec) | 0603 | -55℃~+155℃ 100mW 1kΩ 75V Thick Film Resistor ±1% ±100ppm/℃ 0603 Chip Resistor - Surface Mount ROHS | 23746176 | 0.0026 | Resistance=1kΩ; Operating Temperature=-55℃~+155℃; Power(Watts)=100mW; Type=Thick Film Resistor; Voltage-Supply(Max)=75V; Tolerance=±1%; Temperature Coefficient=±100ppm/℃ | https://www.lcsc.com/datasheet/lcsc_datasheet_2206010130_UNI-ROYAL-Uniroyal-Elec-0603WAF1001T5E_C21190.pdf | https://jlcpcb.com/partdetail/21904-0603WAF1001T5E/C21190
C25804 | basic | Chip Resistor - Surface Mount | Chip Resistor - Surface Mount | 0603WAF1002T5E | UNI-ROYAL(Uniroyal Elec) | 0603 | -55℃~+155℃ 100mW 10kΩ 75V Thick Film Resistor ±1% ±100ppm/℃ 0603 Chip Resistor - Surface Mount ROHS | 22947291 | 0.0018 | Resistance=10kΩ; Operating Temperature=-55℃~+155℃; Power(Watts)=100mW; Type=Thick Film Resistor; Voltage-Supply(Max)=75V; Tolerance=±1%; Temperature Coefficient=±100ppm/℃ | https://www.lcsc.com/datasheet/lcsc_datasheet_2206010045_UNI-ROYAL-Uniroyal-Elec-0603WAF1002T5E_C25804.pdf | https://jlcpcb.com/partdetail/26547-0603WAF1002T5E/C25804
C25803 | basic | Chip Resistor - Surface Mount | Chip Resistor - Surface Mount | 0603WAF1003T5E | UNI-ROYAL(Uniroyal Elec) | 0603 | -55℃~+155℃ 100kΩ 100mW 75V Thick Film Resistor ±1% ±100ppm/℃ 0603 Chip Resistor - Surface Mount ROHS | 22822734 | 0.0031 | Resistance=100kΩ; Operating Temperature=-55℃~+155℃; Power(Watts)=100mW; Type=Thick Film Resistor; Voltage-Supply(Max)=75V; Tolerance=±1%; Temperature Coefficient=±100ppm/℃ | https://www.lcsc.com/datasheet/lcsc_datasheet_2206010045_UNI-ROYAL-Uniroyal-Elec-0603WAF1003T5E_C25803.pdf | https://jlcpcb.com/partdetail/26546-0603WAF1003T5E/C25803
C22935 | basic | Chip Resistor - Surface Mount | Chip Resistor - Surface Mount | 0603WAF1004T5E | UNI-ROYAL(Uniroyal Elec) | 0603 | -55℃~+155℃ 100mW 1MΩ 75V Thick Film Resistor ±1% ±100ppm/℃ 0603 Chip Resistor - Surface Mount ROHS | 6848686 | 0.0019 | Resistance=1MΩ; Operating Temperature=-55℃~+155℃; Power(Watts)=100mW; Type=Thick Film Resistor; Voltage-Supply(Max)=75V; Tolerance=±1%; Temperature Coefficient=±100ppm/℃ | https://www.lcsc.com/datasheet/lcsc_datasheet_2206010130_UNI-ROYAL-Uniroyal-Elec-0603WAF1004T5E_C22935.pdf | https://jlcpcb.com/partdetail/23662-0603WAF1004T5E/C22935
C7250 | basic | Chip Resistor - Surface Mount | Chip Resistor - Surface Mount | 0603WAF1005T5E | UNI-ROYAL(Uniroyal Elec) | 0603 | -55℃~+155℃ 100mW 10MΩ 75V Thick Film Resistor ±1% ±100ppm/℃ 0603 Chip Resistor - Surface Mount ROHS | 330898 | 0.0037 | Resistance=10MΩ; Operating Temperature=-55℃~+155℃; Power(Watts)=100mW; Type=Thick Film Resistor; Voltage-Supply(Max)=75V; Tolerance=±1%; Temperature Coefficient=±100ppm/℃ | https://www.lcsc.com/datasheet/lcsc_datasheet_2206010216_UNI-ROYAL-Uniroyal-Elec-0603WAF1005T5E_C7250.pdf | https://jlcpcb.com/partdetail/7726-0603WAF1005T5E/C7250
C22859 | basic | Chip Resistor - Surface Mount | Chip Resistor - Surface Mount | 0603WAF100JT5E | UNI-ROYAL(Uniroyal Elec) | 0603 | -55℃~+155℃ 100mW 10Ω 75V Thick Film Resistor ±1% ±400ppm/℃ 0603 Chip Resistor - Surface Mount ROHS | 8511740 | 0.0032 | Resistance=10Ω; Operating Temperature=-55℃~+155℃; Power(Watts)=100mW; Type=Thick Film Resistor; Voltage-Supply(Max)=75V; Tolerance=±1%; Temperature Coefficient=±400ppm/℃ | https://www.lcsc.com/datasheet/lcsc_datasheet_2206010130_UNI-ROYAL-Uniroyal-Elec-0603WAF100JT5E_C22859.pdf | https://jlcpcb.com/partdetail/23586-0603WAF100JT5E/C22859
C22936 | basic | Chip Resistor - Surface Mount | Chip Resistor - Surface Mount | 0603WAF100KT5E | UNI-ROYAL(Uniroyal Elec) | 0603 | -55℃~+155℃ 100mW 1Ω 75V Thick Film Resistor ±1% ±400ppm/℃ 0603 Chip Resistor - Surface Mount ROHS | 504922 | 0.0026 | Resistance=1Ω; Operating Temperature=-55℃~+155℃; Power(Watts)=100mW; Type=Thick Film Resistor; Voltage-Supply(Max)=75V; Tolerance=±1%; Temperature Coefficient=±400ppm/℃ | https://www.lcsc.com/datasheet/lcsc_datasheet_2206010130_UNI-ROYAL-Uniroyal-Elec-0603WAF100KT5E_C22936.pdf | https://jlcpcb.com/partdetail/23663-0603WAF100KT5E/C22936
C22787 | basic | Chip Resistor - Surface Mount | Chip Resistor - Surface Mount | 0603WAF1200T5E | UNI-ROYAL(Uniroyal Elec) | 0603 | -55℃~+155℃ 100mW 120Ω 75V Thick Film Resistor ±1% ±100ppm/℃ 0603 Chip Resistor - Surface Mount ROHS | 2006145 | 0.0031 | Resistance=120Ω; Operating Temperature=-55℃~+155℃; Power(Watts)=100mW; Type=Thick Film Resistor; Voltage-Supply(Max)=75V; Tolerance=±1%; Temperature Coefficient=±100ppm/℃ | https://www.lcsc.com/datasheet/lcsc_datasheet_2206010130_UNI-ROYAL-Uniroyal-Elec-0603WAF1200T5E_C22787.pdf | https://jlcpcb.com/partdetail/23514-0603WAF1200T5E/C22787
C22765 | basic | Chip Resistor - Surface Mount | Chip Resistor - Surface Mount | 0603WAF1201T5E | UNI-ROYAL(Uniroyal Elec) | 0603 | -55℃~+155℃ 1.2kΩ 100mW 75V Thick Film Resistor ±1% ±100ppm/℃ 0603 Chip Resistor - Surface Mount ROHS | 2782739 | 0.0034 | Resistance=1.2kΩ; Operating Temperature=-55℃~+155℃; Power(Watts)=100mW; Type=Thick Film Resistor; Voltage-Supply(Max)=75V; Tolerance=±1%; Temperature Coefficient=±100ppm/℃ | https://www.lcsc.com/datasheet/lcsc_datasheet_2206010130_UNI-ROYAL-Uniroyal-Elec-0603WAF1201T5E_C22765.pdf | https://jlcpcb.com/partdetail/23492-0603WAF1201T5E/C22765
C22790 | basic | Chip Resistor - Surface Mount | Chip Resistor - Surface Mount | 0603WAF1202T5E | UNI-ROYAL(Uniroyal Elec) | 0603 | -55℃~+155℃ 100mW 12kΩ 75V Thick Film Resistor ±1% ±100ppm/℃ 0603 Chip Resistor - Surface Mount ROHS | 1297552 | 0.0031 | Resistance=12kΩ; Operating Temperature=-55℃~+155℃; Power(Watts)=100mW; Type=Thick Film Resistor; Voltage-Supply(Max)=75V; Tolerance=±1%; Temperature Coefficient=±100ppm/℃ | https://www.lcsc.com/datasheet/lcsc_datasheet_2206010130_UNI-ROYAL-Uniroyal-Elec-0603WAF1202T5E_C22790.pdf | https://jlcpcb.com/partdetail/23517-0603WAF1202T5E/C22790
C25808 | basic | Chip Resistor - Surface Mount | Chip Resistor - Surface Mount | 0603WAF1203T5E | UNI-ROYAL(Uniroyal Elec) | 0603 | -55℃~+155℃ 100mW 120kΩ 75V Thick Film Resistor ±1% ±100ppm/℃ 0603 Chip Resistor - Surface Mount ROHS | 1043746 | 0.0015 | Resistance=120kΩ; Operating Temperature=-55℃~+155℃; Power(Watts)=100mW; Type=Thick Film Resistor; Voltage-Supply(Max)=75V; Tolerance=±1%; Temperature Coefficient=±100ppm/℃ | https://www.lcsc.com/datasheet/lcsc_datasheet_2206010045_UNI-ROYAL-Uniroyal-Elec-0603WAF1203T5E_C25808.pdf | https://jlcpcb.com/partdetail/26551-0603WAF1203T5E/C25808
C22797 | basic | Chip Resistor - Surface Mount | Chip Resistor - Surface Mount | 0603WAF1302T5E | UNI-ROYAL(Uniroyal Elec) | 0603 | -55℃~+155℃ 100mW 13kΩ 75V Thick Film Resistor ±1% ±100ppm/℃ 0603 Chip Resistor - Surface Mount ROHS | 433989 | 0.0029 | Resistance=13kΩ; Operating Temperature=-55℃~+155℃; Power(Watts)=100mW; Type=Thick Film Resistor; Voltage-Supply(Max)=75V; Tolerance=±1%; Temperature Coefficient=±100ppm/℃ | https://www.lcsc.com/datasheet/lcsc_datasheet_2206010130_UNI-ROYAL-Uniroyal-Elec-0603WAF1302T5E_C22797.pdf | https://jlcpcb.com/partdetail/23524-0603WAF1302T5E/C22797
C22808 | basic | Chip Resistor - Surface Mount | Chip Resistor - Surface Mount | 0603WAF1500T5E | UNI-ROYAL(Uniroyal Elec) | 0603 | -55℃~+155℃ 100mW 150Ω 75V Thick Film Resistor ±1% ±100ppm/℃ 0603 Chip Resistor - Surface Mount ROHS | 539424 | 0.0021 | Resistance=150Ω; Operating Temperature=-55℃~+155℃; Power(Watts)=100mW; Type=Thick Film Resistor; Voltage-Supply(Max)=75V; Tolerance=±1%; Temperature Coefficient=±100ppm/℃ | https://www.lcsc.com/datasheet/lcsc_datasheet_2206010130_UNI-ROYAL-Uniroyal-Elec-0603WAF1500T5E_C22808.pdf | https://jlcpcb.com/partdetail/23535-0603WAF1500T5E/C22808
C22843 | basic | Chip Resistor - Surface Mount | Chip Resistor - Surface Mount | 0603WAF1501T5E | UNI-ROYAL(Uniroyal Elec) | 0603 | -55℃~+155℃ 1.5kΩ 100mW 75V Thick Film Resistor ±1% ±100ppm/℃ 0603 Chip Resistor - Surface Mount ROHS | 5092884 | 0.0019 | Resistance=1.5kΩ; Operating Temperature=-55℃~+155℃; Power(Watts)=100mW; Type=Thick Film Resistor; Voltage-Supply(Max)=75V; Tolerance=±1%; Temperature Coefficient=±100ppm/℃ | https://www.lcsc.com/datasheet/lcsc_datasheet_2206010130_UNI-ROYAL-Uniroyal-Elec-0603WAF1501T5E_C22843.pdf | https://jlcpcb.com/partdetail/23570-0603WAF1501T5E/C22843
C22809 | basic | Chip Resistor - Surface Mount | Chip Resistor - Surface Mount | 0603WAF1502T5E | UNI-ROYAL(Uniroyal Elec) | 0603 | -55℃~+155℃ 100mW 15kΩ 75V Thick Film Resistor ±1% ±100ppm/℃ 0603 Chip Resistor - Surface Mount ROHS | 4697081 | 0.0029 | Resistance=15kΩ; Operating Temperature=-55℃~+155℃; Power(Watts)=100mW; Type=Thick Film Resistor; Voltage-Supply(Max)=75V; Tolerance=±1%; Temperature Coefficient=±100ppm/℃ | https://www.lcsc.com/datasheet/lcsc_datasheet_2206010130_UNI-ROYAL-Uniroyal-Elec-0603WAF1502T5E_C22809.pdf | https://jlcpcb.com/partdetail/23536-0603WAF1502T5E/C22809
C22807 | basic | Chip Resistor - Surface Mount | Chip Resistor - Surface Mount | 0603WAF1503T5E | UNI-ROYAL(Uniroyal Elec) | 0603 | -55℃~+155℃ 100mW 150kΩ 75V Thick Film Resistor ±1% ±100ppm/℃ 0603 Chip Resistor - Surface Mount ROHS | 661771 | 0.0044 | Resistance=150kΩ; Operating Temperature=-55℃~+155℃; Power(Watts)=100mW; Type=Thick Film Resistor; Voltage-Supply(Max)=75V; Tolerance=±1%; Temperature Coefficient=±100ppm/℃ | https://www.lcsc.com/datasheet/lcsc_datasheet_2206010130_UNI-ROYAL-Uniroyal-Elec-0603WAF1503T5E_C22807.pdf | https://jlcpcb.com/partdetail/23534-0603WAF1503T5E/C22807
C4177 | basic | Chip Resistor - Surface Mount | Chip Resistor - Surface Mount | 0603WAF1801T5E | UNI-ROYAL(Uniroyal Elec) | 0603 | -55℃~+155℃ 1.8kΩ 100mW 75V Thick Film Resistor ±1% ±100ppm/℃ 0603 Chip Resistor - Surface Mount ROHS | 419054 | 0.0039 | Resistance=1.8kΩ; Operating Temperature=-55℃~+155℃; Power(Watts)=100mW; Type=Thick Film Resistor; Voltage-Supply(Max)=75V; Tolerance=±1%; Temperature Coefficient=±100ppm/℃ | https://www.lcsc.com/datasheet/lcsc_datasheet_2206010230_UNI-ROYAL-Uniroyal-Elec-0603WAF1801T5E_C4177.pdf | https://jlcpcb.com/partdetail/4584-0603WAF1801T5E/C4177
C25810 | basic | Chip Resistor - Surface Mount | Chip Resistor - Surface Mount | 0603WAF1802T5E | UNI-ROYAL(Uniroyal Elec) | 0603 | -55℃~+155℃ 100mW 18kΩ 75V Thick Film Resistor ±1% ±100ppm/℃ 0603 Chip Resistor - Surface Mount ROHS | 869516 | 0.004 | Resistance=18kΩ; Operating Temperature=-55℃~+155℃; Power(Watts)=100mW; Type=Thick Film Resistor; Voltage-Supply(Max)=75V; Tolerance=±1%; Temperature Coefficient=±100ppm/℃ | https://www.lcsc.com/datasheet/lcsc_datasheet_2206010045_UNI-ROYAL-Uniroyal-Elec-0603WAF1802T5E_C25810.pdf | https://jlcpcb.com/partdetail/26553-0603WAF1802T5E/C25810
C8218 | basic | Chip Resistor - Surface Mount | Chip Resistor - Surface Mount | 0603WAF2000T5E | UNI-ROYAL(Uniroyal Elec) | 0603 | -55℃~+155℃ 100mW 200Ω 75V Thick Film Resistor ±1% ±100ppm/℃ 0603 Chip Resistor - Surface Mount ROHS | 2754883 | 0.0037 | Resistance=200Ω; Operating Temperature=-55℃~+155℃; Power(Watts)=100mW; Type=Thick Film Resistor; Voltage-Supply(Max)=75V; Tolerance=±1%; Temperature Coefficient=±100ppm/℃ | https://www.lcsc.com/datasheet/lcsc_datasheet_2206010216_UNI-ROYAL-Uniroyal-Elec-0603WAF2000T5E_C8218.pdf | https://jlcpcb.com/partdetail/8708-0603WAF2000T5E/C8218
C22975 | basic | Chip Resistor - Surface Mount | Chip Resistor - Surface Mount | 0603WAF2001T5E | UNI-ROYAL(Uniroyal Elec) | 0603 | -55℃~+155℃ 100mW 2kΩ 75V Thick Film Resistor ±1% ±100ppm/℃ 0603 Chip Resistor - Surface Mount ROHS | 14084166 | 0.0024 | Resistance=2kΩ; Operating Temperature=-55℃~+155℃; Power(Watts)=100mW; Type=Thick Film Resistor; Voltage-Supply(Max)=75V; Tolerance=±1%; Temperature Coefficient=±100ppm/℃ | https://www.lcsc.com/datasheet/lcsc_datasheet_2206010116_UNI-ROYAL-Uniroyal-Elec-0603WAF2001T5E_C22975.pdf | https://jlcpcb.com/partdetail/23702-0603WAF2001T5E/C22975
C4184 | basic | Chip Resistor - Surface Mount | Chip Resistor - Surface Mount | 0603WAF2002T5E | UNI-ROYAL(Uniroyal Elec) | 0603 | -55℃~+155℃ 100mW 20kΩ 75V Thick Film Resistor ±1% ±100ppm/℃ 0603 Chip Resistor - Surface Mount ROHS | 8342838 | 0.0023 | Resistance=20kΩ; Operating Temperature=-55℃~+155℃; Power(Watts)=100mW; Type=Thick Film Resistor; Voltage-Supply(Max)=75V; Tolerance=±1%; Temperature Coefficient=±100ppm/℃ | https://www.lcsc.com/datasheet/lcsc_datasheet_2206010230_UNI-ROYAL-Uniroyal-Elec-0603WAF2002T5E_C4184.pdf | https://jlcpcb.com/partdetail/4591-0603WAF2002T5E/C4184
C25811 | basic | Chip Resistor - Surface Mount | Chip Resistor - Surface Mount | 0603WAF2003T5E | UNI-ROYAL(Uniroyal Elec) | 0603 | -55℃~+155℃ 100mW 200kΩ 75V Thick Film Resistor ±1% ±100ppm/℃ 0603 Chip Resistor - Surface Mount ROHS | 2598369 | 0.0023 | Resistance=200kΩ; Operating Temperature=-55℃~+155℃; Power(Watts)=100mW; Type=Thick Film Resistor; Voltage-Supply(Max)=75V; Tolerance=±1%; Temperature Coefficient=±100ppm/℃ | https://www.lcsc.com/datasheet/lcsc_datasheet_2206010045_UNI-ROYAL-Uniroyal-Elec-0603WAF2003T5E_C25811.pdf | https://jlcpcb.com/partdetail/26554-0603WAF2003T5E/C25811
C22976 | basic | Chip Resistor - Surface Mount | Chip Resistor - Surface Mount | 0603WAF2004T5E | UNI-ROYAL(Uniroyal Elec) | 0603 | -55℃~+155℃ 100mW 2MΩ 75V Thick Film Resistor ±1% ±100ppm/℃ 0603 Chip Resistor - Surface Mount ROHS | 1412987 | 0.0025 | Resistance=2MΩ; Operating Temperature=-55℃~+155℃; Power(Watts)=100mW; Type=Thick Film Resistor; Voltage-Supply(Max)=75V; Tolerance=±1%; Temperature Coefficient=±100ppm/℃ | https://www.lcsc.com/datasheet/lcsc_datasheet_2206010116_UNI-ROYAL-Uniroyal-Elec-0603WAF2004T5E_C22976.pdf | https://jlcpcb.com/partdetail/23703-0603WAF2004T5E/C22976
C22950 | basic | Chip Resistor - Surface Mount | Chip Resistor - Surface Mount | 0603WAF200JT5E | UNI-ROYAL(Uniroyal Elec) | 0603 | -55℃~+155℃ 100mW 20Ω 75V Thick Film Resistor ±1% ±100ppm/℃ 0603 Chip Resistor - Surface Mount ROHS | 1857069 | 0.0025 | Resistance=20Ω; Operating Temperature=-55℃~+155℃; Power(Watts)=100mW; Type=Thick Film Resistor; Voltage-Supply(Max)=75V; Tolerance=±1%; Temperature Coefficient=±100ppm/℃ | https://www.lcsc.com/datasheet/lcsc_datasheet_2206010130_UNI-ROYAL-Uniroyal-Elec-0603WAF200JT5E_C22950.pdf | https://jlcpcb.com/partdetail/23677-0603WAF200JT5E/C22950
C22977 | basic | Chip Resistor - Surface Mount | Chip Resistor - Surface Mount | 0603WAF200KT5E | UNI-ROYAL(Uniroyal Elec) | 0603 | -55℃~+155℃ 100mW 2Ω 75V Thick Film Resistor ±1% ±200ppm/℃ 0603 Chip Resistor - Surface Mount ROHS | 1136062 | 0.0022 | Resistance=2Ω; Operating Temperature=-55℃~+155℃; Power(Watts)=100mW; Type=Thick Film Resistor; Voltage-Supply(Max)=75V; Tolerance=±1%; Temperature Coefficient=±200ppm/℃ | https://www.lcsc.com/datasheet/lcsc_datasheet_2206010116_UNI-ROYAL-Uniroyal-Elec-0603WAF200KT5E_C22977.pdf | https://jlcpcb.com/partdetail/23704-0603WAF200KT5E/C22977
C22962 | basic | Chip Resistor - Surface Mount | Chip Resistor - Surface Mount | 0603WAF2200T5E | UNI-ROYAL(Uniroyal Elec) | 0603 | -55℃~+155℃ 100mW 220Ω 75V Thick Film Resistor ±1% ±100ppm/℃ 0603 Chip Resistor - Surface Mount ROHS | 2015473 | 0.0034 | Resistance=220Ω; Operating Temperature=-55℃~+155℃; Power(Watts)=100mW; Type=Thick Film Resistor; Voltage-Supply(Max)=75V; Tolerance=±1%; Temperature Coefficient=±100ppm/℃ | https://www.lcsc.com/datasheet/lcsc_datasheet_2206010130_UNI-ROYAL-Uniroyal-Elec-0603WAF2200T5E_C22962.pdf | https://jlcpcb.com/partdetail/23689-0603WAF2200T5E/C22962
C4190 | basic | Chip Resistor - Surface Mount | Chip Resistor - Surface Mount | 0603WAF2201T5E | UNI-ROYAL(Uniroyal Elec) | 0603 | -55℃~+155℃ 100mW 2.2kΩ 75V Thick Film Resistor ±1% ±100ppm/℃ 0603 Chip Resistor - Surface Mount ROHS | 7869350 | 0.0018 | Resistance=2.2kΩ; Operating Temperature=-55℃~+155℃; Power(Watts)=100mW; Type=Thick Film Resistor; Voltage-Supply(Max)=75V; Tolerance=±1%; Temperature Coefficient=±100ppm/℃ | https://www.lcsc.com/datasheet/lcsc_datasheet_2206010230_UNI-ROYAL-Uniroyal-Elec-0603WAF2201T5E_C4190.pdf | https://jlcpcb.com/partdetail/4597-0603WAF2201T5E/C4190
C31850 | basic | Chip Resistor - Surface Mount | Chip Resistor - Surface Mount | 0603WAF2202T5E | UNI-ROYAL(Uniroyal Elec) | 0603 | -55℃~+155℃ 100mW 22kΩ 75V Thick Film Resistor ±1% ±100ppm/℃ 0603 Chip Resistor - Surface Mount ROHS | 3778680 | 0.0041 | Resistance=22kΩ; Operating Temperature=-55℃~+155℃; Power(Watts)=100mW; Type=Thick Film Resistor; Voltage-Supply(Max)=75V; Tolerance=±1%; Temperature Coefficient=±100ppm/℃ | https://www.lcsc.com/datasheet/lcsc_datasheet_2206010030_UNI-ROYAL-Uniroyal-Elec-0603WAF2202T5E_C31850.pdf | https://jlcpcb.com/partdetail/32812-0603WAF2202T5E/C31850
C22961 | basic | Chip Resistor - Surface Mount | Chip Resistor - Surface Mount | 0603WAF2203T5E | UNI-ROYAL(Uniroyal Elec) | 0603 | -55℃~+155℃ 100mW 220kΩ 75V Thick Film Resistor ±1% ±100ppm/℃ 0603 Chip Resistor - Surface Mount ROHS | 1493903 | 0.0015 | Resistance=220kΩ; Operating Temperature=-55℃~+155℃; Power(Watts)=100mW; Type=Thick Film Resistor; Voltage-Supply(Max)=75V; Tolerance=±1%; Temperature Coefficient=±100ppm/℃ | https://www.lcsc.com/datasheet/lcsc_datasheet_2206010130_UNI-ROYAL-Uniroyal-Elec-0603WAF2203T5E_C22961.pdf | https://jlcpcb.com/partdetail/23688-0603WAF2203T5E/C22961
C23345 | basic | Chip Resistor - Surface Mount | Chip Resistor - Surface Mount | 0603WAF220JT5E | UNI-ROYAL(Uniroyal Elec) | 0603 | -55℃~+155℃ 100mW 22Ω 75V Thick Film Resistor ±1% ±100ppm/℃ 0603 Chip Resistor - Surface Mount ROHS | 9547466 | 0.0017 | Resistance=22Ω; Operating Temperature=-55℃~+155℃; Power(Watts)=100mW; Type=Thick Film Resistor; Voltage-Supply(Max)=75V; Tolerance=±1%; Temperature Coefficient=±100ppm/℃ | https://www.lcsc.com/datasheet/lcsc_datasheet_2206010100_UNI-ROYAL-Uniroyal-Elec-0603WAF220JT5E_C23345.pdf | https://jlcpcb.com/partdetail/24078-0603WAF220JT5E/C23345
C22939 | basic | Chip Resistor - Surface Mount | Chip Resistor - Surface Mount | 0603WAF220KT5E | UNI-ROYAL(Uniroyal Elec) | 0603 | -55℃~+155℃ 100mW 2.2Ω 75V Thick Film Resistor ±1% ±400ppm/℃ 0603 Chip Resistor - Surface Mount ROHS | 246277 | 0.0033 | Resistance=2.2Ω; Operating Temperature=-55℃~+155℃; Power(Watts)=100mW; Type=Thick Film Resistor; Voltage-Supply(Max)=75V; Tolerance=±1%; Temperature Coefficient=±400ppm/℃ | https://www.lcsc.com/datasheet/lcsc_datasheet_2206010130_UNI-ROYAL-Uniroyal-Elec-0603WAF220KT5E_C22939.pdf | https://jlcpcb.com/partdetail/23666-0603WAF220KT5E/C22939
C22940 | basic | Chip Resistor - Surface Mount | Chip Resistor - Surface Mount | 0603WAF2401T5E | UNI-ROYAL(Uniroyal Elec) | 0603 | -55℃~+155℃ 100mW 2.4kΩ 75V Thick Film Resistor ±1% ±100ppm/℃ 0603 Chip Resistor - Surface Mount ROHS | 1604437 | 0.0026 | Resistance=2.4kΩ; Operating Temperature=-55℃~+155℃; Power(Watts)=100mW; Type=Thick Film Resistor; Voltage-Supply(Max)=75V; Tolerance=±1%; Temperature Coefficient=±100ppm/℃ | https://www.lcsc.com/datasheet/lcsc_datasheet_2206010130_UNI-ROYAL-Uniroyal-Elec-0603WAF2401T5E_C22940.pdf | https://jlcpcb.com/partdetail/23667-0603WAF2401T5E/C22940
C23352 | basic | Chip Resistor - Surface Mount | Chip Resistor - Surface Mount | 0603WAF2402T5E | UNI-ROYAL(Uniroyal Elec) | 0603 | -55℃~+155℃ 100mW 24kΩ 75V Thick Film Resistor ±1% ±100ppm/℃ 0603 Chip Resistor - Surface Mount ROHS | 1039529 | 0.0024 | Resistance=24kΩ; Operating Temperature=-55℃~+155℃; Power(Watts)=100mW; Type=Thick Film Resistor; Voltage-Supply(Max)=75V; Tolerance=±1%; Temperature Coefficient=±100ppm/℃ | https://www.lcsc.com/datasheet/lcsc_datasheet_2206010100_UNI-ROYAL-Uniroyal-Elec-0603WAF2402T5E_C23352.pdf | https://jlcpcb.com/partdetail/24085-0603WAF2402T5E/C23352
C22966 | basic | Chip Resistor - Surface Mount | Chip Resistor - Surface Mount | 0603WAF2700T5E | UNI-ROYAL(Uniroyal Elec) | 0603 | -55℃~+155℃ 100mW 270Ω 75V Thick Film Resistor ±1% ±100ppm/℃ 0603 Chip Resistor - Surface Mount ROHS | 801081 | 0.0024 | Resistance=270Ω; Operating Temperature=-55℃~+155℃; Power(Watts)=100mW; Type=Thick Film Resistor; Voltage-Supply(Max)=75V; Tolerance=±1%; Temperature Coefficient=±100ppm/℃ | https://www.lcsc.com/datasheet/lcsc_datasheet_2206010130_UNI-ROYAL-Uniroyal-Elec-0603WAF2700T5E_C22966.pdf | https://jlcpcb.com/partdetail/23693-0603WAF2700T5E/C22966
C13167 | basic | Chip Resistor - Surface Mount | Chip Resistor - Surface Mount | 0603WAF2701T5E | UNI-ROYAL(Uniroyal Elec) | 0603 | -55℃~+155℃ 100mW 2.7kΩ 75V Thick Film Resistor ±1% ±100ppm/℃ 0603 Chip Resistor - Surface Mount ROHS | 1289255 | 0.0032 | Resistance=2.7kΩ; Operating Temperature=-55℃~+155℃; Power(Watts)=100mW; Type=Thick Film Resistor; Voltage-Supply(Max)=75V; Tolerance=±1%; Temperature Coefficient=±100ppm/℃ | https://www.lcsc.com/datasheet/lcsc_datasheet_2206010216_UNI-ROYAL-Uniroyal-Elec-0603WAF2701T5E_C13167.pdf | https://jlcpcb.com/partdetail/13814-0603WAF2701T5E/C13167
C22967 | basic | Chip Resistor - Surface Mount | Chip Resistor - Surface Mount | 0603WAF2702T5E | UNI-ROYAL(Uniroyal Elec) | 0603 | -55℃~+155℃ 100mW 27kΩ 75V Thick Film Resistor ±1% ±100ppm/℃ 0603 Chip Resistor - Surface Mount ROHS | 741278 | 0.0046 | Resistance=27kΩ; Operating Temperature=-55℃~+155℃; Power(Watts)=100mW; Type=Thick Film Resistor; Voltage-Supply(Max)=75V; Tolerance=±1%; Temperature Coefficient=±100ppm/℃ | https://www.lcsc.com/datasheet/lcsc_datasheet_2206010130_UNI-ROYAL-Uniroyal-Elec-0603WAF2702T5E_C22967.pdf | https://jlcpcb.com/partdetail/23694-0603WAF2702T5E/C22967
C23025 | basic | Chip Resistor - Surface Mount | Chip Resistor - Surface Mount | 0603WAF3000T5E | UNI-ROYAL(Uniroyal Elec) | 0603 | -55℃~+155℃ 100mW 300Ω 75V Thick Film Resistor ±1% ±100ppm/℃ 0603 Chip Resistor - Surface Mount ROHS | 1624110 | 0.0032 | Resistance=300Ω; Operating Temperature=-55℃~+155℃; Power(Watts)=100mW; Type=Thick Film Resistor; Voltage-Supply(Max)=75V; Tolerance=±1%; Temperature Coefficient=±100ppm/℃ | https://www.lcsc.com/datasheet/lcsc_datasheet_2206010116_UNI-ROYAL-Uniroyal-Elec-0603WAF3000T5E_C23025.pdf | https://jlcpcb.com/partdetail/23752-0603WAF3000T5E/C23025
C4211 | basic | Chip Resistor - Surface Mount | Chip Resistor - Surface Mount | 0603WAF3001T5E | UNI-ROYAL(Uniroyal Elec) | 0603 | -55℃~+155℃ 100mW 3kΩ 75V Thick Film Resistor ±1% ±100ppm/℃ 0603 Chip Resistor - Surface Mount ROHS | 8372735 | 0.0023 | Resistance=3kΩ; Operating Temperature=-55℃~+155℃; Power(Watts)=100mW; Type=Thick Film Resistor; Voltage-Supply(Max)=75V; Tolerance=±1%; Temperature Coefficient=±100ppm/℃ | https://www.lcsc.com/datasheet/lcsc_datasheet_2206010230_UNI-ROYAL-Uniroyal-Elec-0603WAF3001T5E_C4211.pdf | https://jlcpcb.com/partdetail/4618-0603WAF3001T5E/C4211
C22984 | basic | Chip Resistor - Surface Mount | Chip Resistor - Surface Mount | 0603WAF3002T5E | UNI-ROYAL(Uniroyal Elec) | 0603 | -55℃~+155℃ 100mW 30kΩ 75V Thick Film Resistor ±1% ±100ppm/℃ 0603 Chip Resistor - Surface Mount ROHS | 2015451 | 0.005 | Resistance=30kΩ; Operating Temperature=-55℃~+155℃; Power(Watts)=100mW; Type=Thick Film Resistor; Voltage-Supply(Max)=75V; Tolerance=±1%; Temperature Coefficient=±100ppm/℃ | https://www.lcsc.com/datasheet/lcsc_datasheet_2206010116_UNI-ROYAL-Uniroyal-Elec-0603WAF3002T5E_C22984.pdf | https://jlcpcb.com/partdetail/23711-0603WAF3002T5E/C22984
C23024 | basic | Chip Resistor - Surface Mount | Chip Resistor - Surface Mount | 0603WAF3003T5E | UNI-ROYAL(Uniroyal Elec) | 0603 | -55℃~+155℃ 100mW 300kΩ 75V Thick Film Resistor ±1% ±100ppm/℃ 0603 Chip Resistor - Surface Mount ROHS | 603087 | 0.0054 | Resistance=300kΩ; Operating Temperature=-55℃~+155℃; Power(Watts)=100mW; Type=Thick Film Resistor; Voltage-Supply(Max)=75V; Tolerance=±1%; Temperature Coefficient=±100ppm/℃ | https://www.lcsc.com/datasheet/lcsc_datasheet_2206010116_UNI-ROYAL-Uniroyal-Elec-0603WAF3003T5E_C23024.pdf | https://jlcpcb.com/partdetail/23751-0603WAF3003T5E/C23024
C23138 | basic | Chip Resistor - Surface Mount | Chip Resistor - Surface Mount | 0603WAF3300T5E | UNI-ROYAL(Uniroyal Elec) | 0603 | -55℃~+155℃ 100mW 330Ω 75V Thick Film Resistor ±1% ±100ppm/℃ 0603 Chip Resistor - Surface Mount ROHS | 3476451 | 0.0026 | Resistance=330Ω; Operating Temperature=-55℃~+155℃; Power(Watts)=100mW; Type=Thick Film Resistor; Voltage-Supply(Max)=75V; Tolerance=±1%; Temperature Coefficient=±100ppm/℃ | https://www.lcsc.com/datasheet/lcsc_datasheet_2206010116_UNI-ROYAL-Uniroyal-Elec-0603WAF3300T5E_C23138.pdf | https://jlcpcb.com/partdetail/23865-0603WAF3300T5E/C23138
C22978 | basic | Chip Resistor - Surface Mount | Chip Resistor - Surface Mount | 0603WAF3301T5E | UNI-ROYAL(Uniroyal Elec) | 0603 | -55℃~+155℃ 100mW 3.3kΩ 75V Thick Film Resistor ±1% ±100ppm/℃ 0603 Chip Resistor - Surface Mount ROHS | 5353876 | 0.0026 | Resistance=3.3kΩ; Operating Temperature=-55℃~+155℃; Power(Watts)=100mW; Type=Thick Film Resistor; Voltage-Supply(Max)=75V; Tolerance=±1%; Temperature Coefficient=±100ppm/℃ | https://www.lcsc.com/datasheet/lcsc_datasheet_2206010116_UNI-ROYAL-Uniroyal-Elec-0603WAF3301T5E_C22978.pdf | https://jlcpcb.com/partdetail/23705-0603WAF3301T5E/C22978
C4216 | basic | Chip Resistor - Surface Mount | Chip Resistor - Surface Mount | 0603WAF3302T5E | UNI-ROYAL(Uniroyal Elec) | 0603 | -55℃~+155℃ 100mW 33kΩ 75V Thick Film Resistor ±1% ±100ppm/℃ 0603 Chip Resistor - Surface Mount ROHS | 3313144 | 0.0022 | Resistance=33kΩ; Operating Temperature=-55℃~+155℃; Power(Watts)=100mW; Type=Thick Film Resistor; Voltage-Supply(Max)=75V; Tolerance=±1%; Temperature Coefficient=±100ppm/℃ | https://www.lcsc.com/datasheet/lcsc_datasheet_2206010230_UNI-ROYAL-Uniroyal-Elec-0603WAF3302T5E_C4216.pdf | https://jlcpcb.com/partdetail/4623-0603WAF3302T5E/C4216
C23137 | basic | Chip Resistor - Surface Mount | Chip Resistor - Surface Mount | 0603WAF3303T5E | UNI-ROYAL(Uniroyal Elec) | 0603 | -55℃~+155℃ 100mW 330kΩ 75V Thick Film Resistor ±1% ±100ppm/℃ 0603 Chip Resistor - Surface Mount ROHS | 761479 | 0.0013 | Resistance=330kΩ; Operating Temperature=-55℃~+155℃; Power(Watts)=100mW; Type=Thick Film Resistor; Voltage-Supply(Max)=75V; Tolerance=±1%; Temperature Coefficient=±100ppm/℃ | https://www.lcsc.com/datasheet/lcsc_datasheet_2206010116_UNI-ROYAL-Uniroyal-Elec-0603WAF3303T5E_C23137.pdf | https://jlcpcb.com/partdetail/23864-0603WAF3303T5E/C23137
C23140 | basic | Chip Resistor - Surface Mount | Chip Resistor - Surface Mount | 0603WAF330JT5E | UNI-ROYAL(Uniroyal Elec) | 0603 | -55℃~+155℃ 100mW 33Ω 75V Thick Film Resistor ±1% ±100ppm/℃ 0603 Chip Resistor - Surface Mount ROHS | 5834451 | 0.0025 | Resistance=33Ω; Operating Temperature=-55℃~+155℃; Power(Watts)=100mW; Type=Thick Film Resistor; Voltage-Supply(Max)=75V; Tolerance=±1%; Temperature Coefficient=±100ppm/℃ | https://www.lcsc.com/datasheet/lcsc_datasheet_2206010116_UNI-ROYAL-Uniroyal-Elec-0603WAF330JT5E_C23140.pdf | https://jlcpcb.com/partdetail/23867-0603WAF330JT5E/C23140
C22980 | basic | Chip Resistor - Surface Mount | Chip Resistor - Surface Mount | 0603WAF3601T5E | UNI-ROYAL(Uniroyal Elec) | 0603 | -55℃~+155℃ 100mW 3.6kΩ 75V Thick Film Resistor ±1% ±100ppm/℃ 0603 Chip Resistor - Surface Mount ROHS | 958514 | 0.0019 | Resistance=3.6kΩ; Operating Temperature=-55℃~+155℃; Power(Watts)=100mW; Type=Thick Film Resistor; Voltage-Supply(Max)=75V; Tolerance=±1%; Temperature Coefficient=±100ppm/℃ | https://www.lcsc.com/datasheet/lcsc_datasheet_2206010116_UNI-ROYAL-Uniroyal-Elec-0603WAF3601T5E_C22980.pdf | https://jlcpcb.com/partdetail/23707-0603WAF3601T5E/C22980
C23151 | basic | Chip Resistor - Surface Mount | Chip Resistor - Surface Mount | 0603WAF3900T5E | UNI-ROYAL(Uniroyal Elec) | 0603 | -55℃~+155℃ 100mW 390Ω 75V Thick Film Resistor ±1% ±100ppm/℃ 0603 Chip Resistor - Surface Mount ROHS | 899424 | 0.002 | Resistance=390Ω; Operating Temperature=-55℃~+155℃; Power(Watts)=100mW; Type=Thick Film Resistor; Voltage-Supply(Max)=75V; Tolerance=±1%; Temperature Coefficient=±100ppm/℃ | https://www.lcsc.com/datasheet/lcsc_datasheet_2206010116_UNI-ROYAL-Uniroyal-Elec-0603WAF3900T5E_C23151.pdf | https://jlcpcb.com/partdetail/23878-0603WAF3900T5E/C23151
C23018 | basic | Chip Resistor - Surface Mount | Chip Resistor - Surface Mount | 0603WAF3901T5E | UNI-ROYAL(Uniroyal Elec) | 0603 | -55℃~+155℃ 100mW 3.9kΩ 75V Thick Film Resistor ±1% ±100ppm/℃ 0603 Chip Resistor - Surface Mount ROHS | 885792 | 0.0027 | Resistance=3.9kΩ; Operating Temperature=-55℃~+155℃; Power(Watts)=100mW; Type=Thick Film Resistor; Voltage-Supply(Max)=75V; Tolerance=±1%; Temperature Coefficient=±100ppm/℃ | https://www.lcsc.com/datasheet/lcsc_datasheet_2206010116_UNI-ROYAL-Uniroyal-Elec-0603WAF3901T5E_C23018.pdf | https://jlcpcb.com/partdetail/23745-0603WAF3901T5E/C23018
C23153 | basic | Chip Resistor - Surface Mount | Chip Resistor - Surface Mount | 0603WAF3902T5E | UNI-ROYAL(Uniroyal Elec) | 0603 | -55℃~+155℃ 100mW 39kΩ 75V Thick Film Resistor ±1% ±100ppm/℃ 0603 Chip Resistor - Surface Mount ROHS | 483014 | 0.0016 | Resistance=39kΩ; Operating Temperature=-55℃~+155℃; Power(Watts)=100mW; Type=Thick Film Resistor; Voltage-Supply(Max)=75V; Tolerance=±1%; Temperature Coefficient=±100ppm/℃ | https://www.lcsc.com/datasheet/lcsc_datasheet_2206010116_UNI-ROYAL-Uniroyal-Elec-0603WAF3902T5E_C23153.pdf | https://jlcpcb.com/partdetail/23880-0603WAF3902T5E/C23153
C23179 | basic | Chip Resistor - Surface Mount | Chip Resistor - Surface Mount | 0603WAF4700T5E | UNI-ROYAL(Uniroyal Elec) | 0603 | -55℃~+155℃ 100mW 470Ω 75V Thick Film Resistor ±1% ±100ppm/℃ 0603 Chip Resistor - Surface Mount ROHS | 6653078 | 0.0023 | Resistance=470Ω; Operating Temperature=-55℃~+155℃; Power(Watts)=100mW; Type=Thick Film Resistor; Voltage-Supply(Max)=75V; Tolerance=±1%; Temperature Coefficient=±100ppm/℃ | https://www.lcsc.com/datasheet/lcsc_datasheet_2206010116_UNI-ROYAL-Uniroyal-Elec-0603WAF4700T5E_C23179.pdf | https://jlcpcb.com/partdetail/23906-0603WAF4700T5E/C23179
C23162 | basic | Chip Resistor - Surface Mount | Chip Resistor - Surface Mount | 0603WAF4701T5E | UNI-ROYAL(Uniroyal Elec) | 0603 | -55℃~+155℃ 100mW 4.7kΩ 75V Thick Film Resistor ±1% ±100ppm/℃ 0603 Chip Resistor - Surface Mount ROHS | 23329328 | 0.0028 | Resistance=4.7kΩ; Operating Temperature=-55℃~+155℃; Power(Watts)=100mW; Type=Thick Film Resistor; Voltage-Supply(Max)=75V; Tolerance=±1%; Temperature Coefficient=±100ppm/℃ | https://www.lcsc.com/datasheet/lcsc_datasheet_2206010116_UNI-ROYAL-Uniroyal-Elec-0603WAF4701T5E_C23162.pdf | https://jlcpcb.com/partdetail/23889-0603WAF4701T5E/C23162
C25819 | basic | Chip Resistor - Surface Mount | Chip Resistor - Surface Mount | 0603WAF4702T5E | UNI-ROYAL(Uniroyal Elec) | 0603 | -55℃~+155℃ 100mW 47kΩ 75V Thick Film Resistor ±1% ±100ppm/℃ 0603 Chip Resistor - Surface Mount ROHS | 1846877 | 0.0037 | Resistance=47kΩ; Operating Temperature=-55℃~+155℃; Power(Watts)=100mW; Type=Thick Film Resistor; Voltage-Supply(Max)=75V; Tolerance=±1%; Temperature Coefficient=±100ppm/℃ | https://www.lcsc.com/datasheet/lcsc_datasheet_2206010045_UNI-ROYAL-Uniroyal-Elec-0603WAF4702T5E_C25819.pdf | https://jlcpcb.com/partdetail/26562-0603WAF4702T5E/C25819
C23178 | basic | Chip Resistor - Surface Mount | Chip Resistor - Surface Mount | 0603WAF4703T5E | UNI-ROYAL(Uniroyal Elec) | 0603 | -55℃~+155℃ 100mW 470kΩ 75V Thick Film Resistor ±1% ±100ppm/℃ 0603 Chip Resistor - Surface Mount ROHS | 1521027 | 0.003 | Resistance=470kΩ; Operating Temperature=-55℃~+155℃; Power(Watts)=100mW; Type=Thick Film Resistor; Voltage-Supply(Max)=75V; Tolerance=±1%; Temperature Coefficient=±100ppm/℃ | https://www.lcsc.com/datasheet/lcsc_datasheet_2206010116_UNI-ROYAL-Uniroyal-Elec-0603WAF4703T5E_C23178.pdf | https://jlcpcb.com/partdetail/23905-0603WAF4703T5E/C23178
C23182 | basic | Chip Resistor - Surface Mount | Chip Resistor - Surface Mount | 0603WAF470JT5E | UNI-ROYAL(Uniroyal Elec) | 0603 | -55℃~+155℃ 100mW 47Ω 75V Thick Film Resistor ±1% ±100ppm/℃ 0603 Chip Resistor - Surface Mount ROHS | 1282446 | 0.004 | Resistance=47Ω; Operating Temperature=-55℃~+155℃; Power(Watts)=100mW; Type=Thick Film Resistor; Voltage-Supply(Max)=75V; Tolerance=±1%; Temperature Coefficient=±100ppm/℃ | https://www.lcsc.com/datasheet/lcsc_datasheet_2206010116_UNI-ROYAL-Uniroyal-Elec-0603WAF470JT5E_C23182.pdf | https://jlcpcb.com/partdetail/23909-0603WAF470JT5E/C23182
C23164 | basic | Chip Resistor - Surface Mount | Chip Resistor - Surface Mount | 0603WAF470KT5E | UNI-ROYAL(Uniroyal Elec) | 0603 | -55℃~+155℃ 100mW 4.7Ω 75V Thick Film Resistor ±1% ±400ppm/℃ 0603 Chip Resistor - Surface Mount ROHS | 677942 | 0.0026 | Resistance=4.7Ω; Operating Temperature=-55℃~+155℃; Power(Watts)=100mW; Type=Thick Film Resistor; Voltage-Supply(Max)=75V; Tolerance=±1%; Temperature Coefficient=±400ppm/℃ | https://www.lcsc.com/datasheet/lcsc_datasheet_2206010116_UNI-ROYAL-Uniroyal-Elec-0603WAF470KT5E_C23164.pdf | https://jlcpcb.com/partdetail/23891-0603WAF470KT5E/C23164
C23046 | basic | Chip Resistor - Surface Mount | Chip Resistor - Surface Mount | 0603WAF4991T5E | UNI-ROYAL(Uniroyal Elec) | 0603 | -55℃~+155℃ 100mW 4.99kΩ 75V Thick Film Resistor ±1% ±100ppm/℃ 0603 Chip Resistor - Surface Mount ROHS | 1563242 | 0.0024 | Resistance=4.99kΩ; Operating Temperature=-55℃~+155℃; Power(Watts)=100mW; Type=Thick Film Resistor; Voltage-Supply(Max)=75V; Tolerance=±1%; Temperature Coefficient=±100ppm/℃ | https://www.lcsc.com/datasheet/lcsc_datasheet_2206010116_UNI-ROYAL-Uniroyal-Elec-0603WAF4991T5E_C23046.pdf | https://jlcpcb.com/partdetail/23773-0603WAF4991T5E/C23046
C23184 | basic | Chip Resistor - Surface Mount | Chip Resistor - Surface Mount | 0603WAF4992T5E | UNI-ROYAL(Uniroyal Elec) | 0603 | -55℃~+155℃ 100mW 49.9kΩ 75V Thick Film Resistor ±1% ±100ppm/℃ 0603 Chip Resistor - Surface Mount ROHS | 1844254 | 0.0029 | Resistance=49.9kΩ; Operating Temperature=-55℃~+155℃; Power(Watts)=100mW; Type=Thick Film Resistor; Voltage-Supply(Max)=75V; Tolerance=±1%; Temperature Coefficient=±100ppm/℃ | https://www.lcsc.com/datasheet/lcsc_datasheet_2206010116_UNI-ROYAL-Uniroyal-Elec-0603WAF4992T5E_C23184.pdf | https://jlcpcb.com/partdetail/23911-0603WAF4992T5E/C23184
C23185 | basic | Chip Resistor - Surface Mount | Chip Resistor - Surface Mount | 0603WAF499JT5E | UNI-ROYAL(Uniroyal Elec) | 0603 | -55℃~+155℃ 100mW 49.9Ω 75V Thick Film Resistor ±1% ±100ppm/℃ 0603 Chip Resistor - Surface Mount ROHS | 2362519 | 0.0021 | Resistance=49.9Ω; Operating Temperature=-55℃~+155℃; Power(Watts)=100mW; Type=Thick Film Resistor; Voltage-Supply(Max)=75V; Tolerance=±1%; Temperature Coefficient=±100ppm/℃ | https://www.lcsc.com/datasheet/lcsc_datasheet_2206010116_UNI-ROYAL-Uniroyal-Elec-0603WAF499JT5E_C23185.pdf | https://jlcpcb.com/partdetail/23912-0603WAF499JT5E/C23185
C23193 | basic | Chip Resistor - Surface Mount | Chip Resistor - Surface Mount | 0603WAF5100T5E | UNI-ROYAL(Uniroyal Elec) | 0603 | -55℃~+155℃ 100mW 510Ω 75V Thick Film Resistor ±1% ±100ppm/℃ 0603 Chip Resistor - Surface Mount ROHS | 4377429 | 0.0024 | Resistance=510Ω; Operating Temperature=-55℃~+155℃; Power(Watts)=100mW; Type=Thick Film Resistor; Voltage-Supply(Max)=75V; Tolerance=±1%; Temperature Coefficient=±100ppm/℃ | https://www.lcsc.com/datasheet/lcsc_datasheet_2206010116_UNI-ROYAL-Uniroyal-Elec-0603WAF5100T5E_C23193.pdf | https://jlcpcb.com/partdetail/23920-0603WAF5100T5E/C23193
C23186 | basic | Chip Resistor - Surface Mount | Chip Resistor - Surface Mount | 0603WAF5101T5E | UNI-ROYAL(Uniroyal Elec) | 0603 | -55℃~+155℃ 100mW 5.1kΩ 75V Thick Film Resistor ±1% ±100ppm/℃ 0603 Chip Resistor - Surface Mount ROHS | 26162145 | 0.0015 | Resistance=5.1kΩ; Operating Temperature=-55℃~+155℃; Power(Watts)=100mW; Type=Thick Film Resistor; Voltage-Supply(Max)=75V; Tolerance=±1%; Temperature Coefficient=±100ppm/℃ | https://www.lcsc.com/datasheet/lcsc_datasheet_2206010116_UNI-ROYAL-Uniroyal-Elec-0603WAF5101T5E_C23186.pdf | https://jlcpcb.com/partdetail/23913-0603WAF5101T5E/C23186
C23196 | basic | Chip Resistor - Surface Mount | Chip Resistor - Surface Mount | 0603WAF5102T5E | UNI-ROYAL(Uniroyal Elec) | 0603 | -55℃~+155℃ 100mW 51kΩ 75V Thick Film Resistor ±1% ±100ppm/℃ 0603 Chip Resistor - Surface Mount ROHS | 3072868 | 0.0017 | Resistance=51kΩ; Operating Temperature=-55℃~+155℃; Power(Watts)=100mW; Type=Thick Film Resistor; Voltage-Supply(Max)=75V; Tolerance=±1%; Temperature Coefficient=±100ppm/℃ | https://www.lcsc.com/datasheet/lcsc_datasheet_2206010116_UNI-ROYAL-Uniroyal-Elec-0603WAF5102T5E_C23196.pdf | https://jlcpcb.com/partdetail/23923-0603WAF5102T5E/C23196
C23192 | basic | Chip Resistor - Surface Mount | Chip Resistor - Surface Mount | 0603WAF5103T5E | UNI-ROYAL(Uniroyal Elec) | 0603 | -55℃~+155℃ 100mW 510kΩ 75V Thick Film Resistor ±1% ±100ppm/℃ 0603 Chip Resistor - Surface Mount ROHS | 932215 | 0.0024 | Resistance=510kΩ; Operating Temperature=-55℃~+155℃; Power(Watts)=100mW; Type=Thick Film Resistor; Voltage-Supply(Max)=75V; Tolerance=±1%; Temperature Coefficient=±100ppm/℃ | https://www.lcsc.com/datasheet/lcsc_datasheet_2206010116_UNI-ROYAL-Uniroyal-Elec-0603WAF5103T5E_C23192.pdf | https://jlcpcb.com/partdetail/23919-0603WAF5103T5E/C23192
C23197 | basic | Chip Resistor - Surface Mount | Chip Resistor - Surface Mount | 0603WAF510JT5E | UNI-ROYAL(Uniroyal Elec) | 0603 | -55℃~+155℃ 100mW 51Ω 75V Thick Film Resistor ±1% ±100ppm/℃ 0603 Chip Resistor - Surface Mount ROHS | 1065529 | 0.0019 | Resistance=51Ω; Operating Temperature=-55℃~+155℃; Power(Watts)=100mW; Type=Thick Film Resistor; Voltage-Supply(Max)=75V; Tolerance=±1%; Temperature Coefficient=±100ppm/℃ | https://www.lcsc.com/datasheet/lcsc_datasheet_2206010116_UNI-ROYAL-Uniroyal-Elec-0603WAF510JT5E_C23197.pdf | https://jlcpcb.com/partdetail/23924-0603WAF510JT5E/C23197
C25197 | basic | Chip Resistor - Surface Mount | Chip Resistor - Surface Mount | 0603WAF510KT5E | UNI-ROYAL(Uniroyal Elec) | 0603 | -55℃~+155℃ 100mW 5.1Ω 75V Thick Film Resistor ±1% ±200ppm/℃ 0603 Chip Resistor - Surface Mount ROHS | 274426 | 0.0039 | Resistance=5.1Ω; Operating Temperature=-55℃~+155℃; Power(Watts)=100mW; Type=Thick Film Resistor; Voltage-Supply(Max)=75V; Tolerance=±1%; Temperature Coefficient=±200ppm/℃ | https://www.lcsc.com/datasheet/lcsc_datasheet_2205311845_UNI-ROYAL-Uniroyal-Elec-0603WAF510KT5E_C25197.pdf | https://jlcpcb.com/partdetail/25940-0603WAF510KT5E/C25197
C23204 | basic | Chip Resistor - Surface Mount | Chip Resistor - Surface Mount | 0603WAF5600T5E | UNI-ROYAL(Uniroyal Elec) | 0603 | -55℃~+155℃ 100mW 560Ω 75V Thick Film Resistor ±1% ±100ppm/℃ 0603 Chip Resistor - Surface Mount ROHS | 2999245 | 0.0033 | Resistance=560Ω; Operating Temperature=-55℃~+155℃; Power(Watts)=100mW; Type=Thick Film Resistor; Voltage-Supply(Max)=75V; Tolerance=±1%; Temperature Coefficient=±100ppm/℃ | https://www.lcsc.com/datasheet/lcsc_datasheet_2206010116_UNI-ROYAL-Uniroyal-Elec-0603WAF5600T5E_C23204.pdf | https://jlcpcb.com/partdetail/23931-0603WAF5600T5E/C23204
C23189 | basic | Chip Resistor - Surface Mount | Chip Resistor - Surface Mount | 0603WAF5601T5E | UNI-ROYAL(Uniroyal Elec) | 0603 | -55℃~+155℃ 100mW 5.6kΩ 75V Thick Film Resistor ±1% ±100ppm/℃ 0603 Chip Resistor - Surface Mount ROHS | 1193727 | 0.0032 | Resistance=5.6kΩ; Operating Temperature=-55℃~+155℃; Power(Watts)=100mW; Type=Thick Film Resistor; Voltage-Supply(Max)=75V; Tolerance=±1%; Temperature Coefficient=±100ppm/℃ | https://www.lcsc.com/datasheet/lcsc_datasheet_2206010116_UNI-ROYAL-Uniroyal-Elec-0603WAF5601T5E_C23189.pdf | https://jlcpcb.com/partdetail/23916-0603WAF5601T5E/C23189
C23206 | basic | Chip Resistor - Surface Mount | Chip Resistor - Surface Mount | 0603WAF5602T5E | UNI-ROYAL(Uniroyal Elec) | 0603 | -55℃~+155℃ 100mW 56kΩ 75V Thick Film Resistor ±1% ±100ppm/℃ 0603 Chip Resistor - Surface Mount ROHS | 1038707 | 0.0027 | Resistance=56kΩ; Operating Temperature=-55℃~+155℃; Power(Watts)=100mW; Type=Thick Film Resistor; Voltage-Supply(Max)=75V; Tolerance=±1%; Temperature Coefficient=±100ppm/℃ | https://www.lcsc.com/datasheet/lcsc_datasheet_2206010116_UNI-ROYAL-Uniroyal-Elec-0603WAF5602T5E_C23206.pdf | https://jlcpcb.com/partdetail/23933-0603WAF5602T5E/C23206
C4260 | basic | Chip Resistor - Surface Mount | Chip Resistor - Surface Mount | 0603WAF6201T5E | UNI-ROYAL(Uniroyal Elec) | 0603 | -55℃~+155℃ 100mW 6.2kΩ 75V Thick Film Resistor ±1% ±100ppm/℃ 0603 Chip Resistor - Surface Mount ROHS | 1006265 | 0.0023 | Resistance=6.2kΩ; Operating Temperature=-55℃~+155℃; Power(Watts)=100mW; Type=Thick Film Resistor; Voltage-Supply(Max)=75V; Tolerance=±1%; Temperature Coefficient=±100ppm/℃ | https://www.lcsc.com/datasheet/lcsc_datasheet_2206010230_UNI-ROYAL-Uniroyal-Elec-0603WAF6201T5E_C4260.pdf | https://jlcpcb.com/partdetail/4667-0603WAF6201T5E/C4260
C23228 | basic | Chip Resistor - Surface Mount | Chip Resistor - Surface Mount | 0603WAF6800T5E | UNI-ROYAL(Uniroyal Elec) | 0603 | -55℃~+155℃ 100mW 680Ω 75V Thick Film Resistor ±1% ±100ppm/℃ 0603 Chip Resistor - Surface Mount ROHS | 2450808 | 0.0021 | Resistance=680Ω; Operating Temperature=-55℃~+155℃; Power(Watts)=100mW; Type=Thick Film Resistor; Voltage-Supply(Max)=75V; Tolerance=±1%; Temperature Coefficient=±100ppm/℃ | https://www.lcsc.com/datasheet/lcsc_datasheet_2206010100_UNI-ROYAL-Uniroyal-Elec-0603WAF6800T5E_C23228.pdf | https://jlcpcb.com/partdetail/23955-0603WAF6800T5E/C23228
C23212 | basic | Chip Resistor - Surface Mount | Chip Resistor - Surface Mount | 0603WAF6801T5E | UNI-ROYAL(Uniroyal Elec) | 0603 | -55℃~+155℃ 100mW 6.8kΩ 75V Thick Film Resistor ±1% ±100ppm/℃ 0603 Chip Resistor - Surface Mount ROHS | 1867004 | 0.0023 | Resistance=6.8kΩ; Operating Temperature=-55℃~+155℃; Power(Watts)=100mW; Type=Thick Film Resistor; Voltage-Supply(Max)=75V; Tolerance=±1%; Temperature Coefficient=±100ppm/℃ | https://www.lcsc.com/datasheet/lcsc_datasheet_2206010116_UNI-ROYAL-Uniroyal-Elec-0603WAF6801T5E_C23212.pdf | https://jlcpcb.com/partdetail/23939-0603WAF6801T5E/C23212
C23231 | basic | Chip Resistor - Surface Mount | Chip Resistor - Surface Mount | 0603WAF6802T5E | UNI-ROYAL(Uniroyal Elec) | 0603 | -55℃~+155℃ 100mW 68kΩ 75V Thick Film Resistor ±1% ±100ppm/℃ 0603 Chip Resistor - Surface Mount ROHS | 1071772 | 0.0016 | Resistance=68kΩ; Operating Temperature=-55℃~+155℃; Power(Watts)=100mW; Type=Thick Film Resistor; Voltage-Supply(Max)=75V; Tolerance=±1%; Temperature Coefficient=±100ppm/℃ | https://www.lcsc.com/datasheet/lcsc_datasheet_2206010100_UNI-ROYAL-Uniroyal-Elec-0603WAF6802T5E_C23231.pdf | https://jlcpcb.com/partdetail/23958-0603WAF6802T5E/C23231
C23234 | basic | Chip Resistor - Surface Mount | Chip Resistor - Surface Mount | 0603WAF7501T5E | UNI-ROYAL(Uniroyal Elec) | 0603 | -55℃~+155℃ 100mW 7.5kΩ 75V Thick Film Resistor ±1% ±100ppm/℃ 0603 Chip Resistor - Surface Mount ROHS | 1479030 | 0.0018 | Resistance=7.5kΩ; Operating Temperature=-55℃~+155℃; Power(Watts)=100mW; Type=Thick Film Resistor; Voltage-Supply(Max)=75V; Tolerance=±1%; Temperature Coefficient=±100ppm/℃ | https://www.lcsc.com/datasheet/lcsc_datasheet_2206010100_UNI-ROYAL-Uniroyal-Elec-0603WAF7501T5E_C23234.pdf | https://jlcpcb.com/partdetail/23961-0603WAF7501T5E/C23234
C23242 | basic | Chip Resistor - Surface Mount | Chip Resistor - Surface Mount | 0603WAF7502T5E | UNI-ROYAL(Uniroyal Elec) | 0603 | -55℃~+155℃ 100mW 75V 75kΩ Thick Film Resistor ±1% ±100ppm/℃ 0603 Chip Resistor - Surface Mount ROHS | 794292 | 0.0027 | Resistance=75kΩ; Operating Temperature=-55℃~+155℃; Power(Watts)=100mW; Type=Thick Film Resistor; Voltage-Supply(Max)=75V; Tolerance=±1%; Temperature Coefficient=±100ppm/℃ | https://www.lcsc.com/datasheet/lcsc_datasheet_2206010100_UNI-ROYAL-Uniroyal-Elec-0603WAF7502T5E_C23242.pdf | https://jlcpcb.com/partdetail/23969-0603WAF7502T5E/C23242
C4275 | basic | Chip Resistor - Surface Mount | Chip Resistor - Surface Mount | 0603WAF750JT5E | UNI-ROYAL(Uniroyal Elec) | 0603 | -55℃~+155℃ 100mW 75V 75Ω Thick Film Resistor ±1% ±100ppm/℃ 0603 Chip Resistor - Surface Mount ROHS | 1937452 | 0.0033 | Resistance=75Ω; Operating Temperature=-55℃~+155℃; Power(Watts)=100mW; Type=Thick Film Resistor; Voltage-Supply(Max)=75V; Tolerance=±1%; Temperature Coefficient=±100ppm/℃ | https://www.lcsc.com/datasheet/lcsc_datasheet_2206010216_UNI-ROYAL-Uniroyal-Elec-0603WAF750JT5E_C4275.pdf | https://jlcpcb.com/partdetail/4682-0603WAF750JT5E/C4275
C23253 | basic | Chip Resistor - Surface Mount | Chip Resistor - Surface Mount | 0603WAF8200T5E | UNI-ROYAL(Uniroyal Elec) | 0603 | -55℃~+155℃ 100mW 75V 820Ω Thick Film Resistor ±1% ±100ppm/℃ 0603 Chip Resistor - Surface Mount ROHS | 1160389 | 0.0015 | Resistance=820Ω; Operating Temperature=-55℃~+155℃; Power(Watts)=100mW; Type=Thick Film Resistor; Voltage-Supply(Max)=75V; Tolerance=±1%; Temperature Coefficient=±100ppm/℃ | https://www.lcsc.com/datasheet/lcsc_datasheet_2206010100_UNI-ROYAL-Uniroyal-Elec-0603WAF8200T5E_C23253.pdf | https://jlcpcb.com/partdetail/23980-0603WAF8200T5E/C23253
C25981 | basic | Chip Resistor - Surface Mount | Chip Resistor - Surface Mount | 0603WAF8201T5E | UNI-ROYAL(Uniroyal Elec) | 0603 | -55℃~+155℃ 100mW 75V 8.2kΩ Thick Film Resistor ±1% ±100ppm/℃ 0603 Chip Resistor - Surface Mount ROHS | 1020214 | 0.0035 | Resistance=8.2kΩ; Operating Temperature=-55℃~+155℃; Power(Watts)=100mW; Type=Thick Film Resistor; Voltage-Supply(Max)=75V; Tolerance=±1%; Temperature Coefficient=±100ppm/℃ | https://www.lcsc.com/datasheet/lcsc_datasheet_2206010045_UNI-ROYAL-Uniroyal-Elec-0603WAF8201T5E_C25981.pdf | https://jlcpcb.com/partdetail/26724-0603WAF8201T5E/C25981
C23254 | basic | Chip Resistor - Surface Mount | Chip Resistor - Surface Mount | 0603WAF8202T5E | UNI-ROYAL(Uniroyal Elec) | 0603 | -55℃~+155℃ 100mW 75V 82kΩ Thick Film Resistor ±1% ±100ppm/℃ 0603 Chip Resistor - Surface Mount ROHS | 1334033 | 0.0027 | Resistance=82kΩ; Operating Temperature=-55℃~+155℃; Power(Watts)=100mW; Type=Thick Film Resistor; Voltage-Supply(Max)=75V; Tolerance=±1%; Temperature Coefficient=±100ppm/℃ | https://www.lcsc.com/datasheet/lcsc_datasheet_2206010100_UNI-ROYAL-Uniroyal-Elec-0603WAF8202T5E_C23254.pdf | https://jlcpcb.com/partdetail/23981-0603WAF8202T5E/C23254
C23260 | basic | Chip Resistor - Surface Mount | Chip Resistor - Surface Mount | 0603WAF9101T5E | UNI-ROYAL(Uniroyal Elec) | 0603 | -55℃~+155℃ 100mW 75V 9.1kΩ Thick Film Resistor ±1% ±100ppm/℃ 0603 Chip Resistor - Surface Mount ROHS | 771289 | 0.0031 | Resistance=9.1kΩ; Operating Temperature=-55℃~+155℃; Power(Watts)=100mW; Type=Thick Film Resistor; Voltage-Supply(Max)=75V; Tolerance=±1%; Temperature Coefficient=±100ppm/℃ | https://www.lcsc.com/datasheet/lcsc_datasheet_2206010100_UNI-ROYAL-Uniroyal-Elec-0603WAF9101T5E_C23260.pdf | https://jlcpcb.com/partdetail/23987-0603WAF9101T5E/C23260
C17477 | basic | Chip Resistor - Surface Mount | Chip Resistor - Surface Mount | 0805W8F0000T5E | UNI-ROYAL(Uniroyal Elec) | 0805 | -55℃~+155℃ 0Ω 125mW 150V Thick Film Resistor ±1% ±800ppm/℃ 0805 Chip Resistor - Surface Mount ROHS | 7085858 | 0.0044 | Resistance=0Ω; Operating Temperature=-55℃~+155℃; Power(Watts)=125mW; Type=Thick Film Resistor; Voltage-Supply(Max)=150V; Tolerance=±1%; Temperature Coefficient=±800ppm/℃ | https://www.lcsc.com/datasheet/lcsc_datasheet_2206010216_UNI-ROYAL-Uniroyal-Elec-0805W8F0000T5E_C17477.pdf | https://jlcpcb.com/partdetail/18165-0805W8F0000T5E/C17477
C17408 | basic | Chip Resistor - Surface Mount | Chip Resistor - Surface Mount | 0805W8F1000T5E | UNI-ROYAL(Uniroyal Elec) | 0805 | -55℃~+155℃ 100Ω 125mW 150V Thick Film Resistor ±1% ±100ppm/℃ 0805 Chip Resistor - Surface Mount ROHS | 9601556 | 0.0042 | Resistance=100Ω; Operating Temperature=-55℃~+155℃; Power(Watts)=125mW; Type=Thick Film Resistor; Voltage-Supply(Max)=150V; Tolerance=±1%; Temperature Coefficient=±100ppm/℃ | https://www.lcsc.com/datasheet/lcsc_datasheet_2411221126_UNI-ROYAL-Uniroyal-Elec-0805W8F1000T5E_C17408.pdf | https://jlcpcb.com/partdetail/18096-0805W8F1000T5E/C17408
C17513 | basic | Chip Resistor - Surface Mount | Chip Resistor - Surface Mount | 0805W8F1001T5E | UNI-ROYAL(Uniroyal Elec) | 0805 | -55℃~+155℃ 125mW 150V 1kΩ Thick Film Resistor ±1% ±100ppm/℃ 0805 Chip Resistor - Surface Mount ROHS | 31776103 | 0.004 | Resistance=1kΩ; Operating Temperature=-55℃~+155℃; Power(Watts)=125mW; Type=Thick Film Resistor; Voltage-Supply(Max)=150V; Tolerance=±1%; Temperature Coefficient=±100ppm/℃ | https://www.lcsc.com/datasheet/lcsc_datasheet_2205311800_UNI-ROYAL-Uniroyal-Elec-0805W8F1001T5E_C17513.pdf | https://jlcpcb.com/partdetail/18201-0805W8F1001T5E/C17513
C17414 | basic | Chip Resistor - Surface Mount | Chip Resistor - Surface Mount | 0805W8F1002T5E | UNI-ROYAL(Uniroyal Elec) | 0805 | -55℃~+155℃ 10kΩ 125mW 150V Thick Film Resistor ±1% ±100ppm/℃ 0805 Chip Resistor - Surface Mount ROHS | 51350354 | 0.0039 | Resistance=10kΩ; Operating Temperature=-55℃~+155℃; Power(Watts)=125mW; Type=Thick Film Resistor; Voltage-Supply(Max)=150V; Tolerance=±1%; Temperature Coefficient=±100ppm/℃ | https://www.lcsc.com/datasheet/lcsc_datasheet_2411221126_UNI-ROYAL-Uniroyal-Elec-0805W8F1002T5E_C17414.pdf | https://jlcpcb.com/partdetail/18102-0805W8F1002T5E/C17414
C149504 | basic | Chip Resistor - Surface Mount | Chip Resistor - Surface Mount | 0805W8F1003T5E | UNI-ROYAL(Uniroyal Elec) | 0805 | -55℃~+155℃ 100kΩ 125mW 150V Thick Film Resistor ±1% ±100ppm/℃ 0805 Chip Resistor - Surface Mount ROHS | 4520444 | 0.0059 | Resistance=100kΩ; Operating Temperature=-55℃~+155℃; Power(Watts)=125mW; Type=Thick Film Resistor; Voltage-Supply(Max)=150V; Tolerance=±1%; Temperature Coefficient=±100ppm/℃ | https://www.lcsc.com/datasheet/lcsc_datasheet_2205312316_UNI-ROYAL-Uniroyal-Elec-0805W8F1003T5E_C149504.pdf | https://jlcpcb.com/partdetail/160838-0805W8F1003T5E/C149504
C17514 | basic | Chip Resistor - Surface Mount | Chip Resistor - Surface Mount | 0805W8F1004T5E | UNI-ROYAL(Uniroyal Elec) | 0805 | -55℃~+155℃ 125mW 150V 1MΩ Thick Film Resistor ±1% ±100ppm/℃ 0805 Chip Resistor - Surface Mount ROHS | 2491642 | 0.0043 | Resistance=1MΩ; Operating Temperature=-55℃~+155℃; Power(Watts)=125mW; Type=Thick Film Resistor; Voltage-Supply(Max)=150V; Tolerance=±1%; Temperature Coefficient=±100ppm/℃ | https://www.lcsc.com/datasheet/lcsc_datasheet_2206010200_UNI-ROYAL-Uniroyal-Elec-0805W8F1004T5E_C17514.pdf | https://jlcpcb.com/partdetail/18202-0805W8F1004T5E/C17514
C17415 | basic | Chip Resistor - Surface Mount | Chip Resistor - Surface Mount | 0805W8F100JT5E | UNI-ROYAL(Uniroyal Elec) | 0805 | -55℃~+155℃ 10Ω 125mW 150V Thick Film Resistor ±1% ±200ppm/℃ 0805 Chip Resistor - Surface Mount ROHS | 7043993 | 0.004 | Resistance=10Ω; Operating Temperature=-55℃~+155℃; Power(Watts)=125mW; Type=Thick Film Resistor; Voltage-Supply(Max)=150V; Tolerance=±1%; Temperature Coefficient=±200ppm/℃ | https://www.lcsc.com/datasheet/lcsc_datasheet_2206010216_UNI-ROYAL-Uniroyal-Elec-0805W8F100JT5E_C17415.pdf | https://jlcpcb.com/partdetail/18103-0805W8F100JT5E/C17415
C25271 | basic | Chip Resistor - Surface Mount | Chip Resistor - Surface Mount | 0805W8F100KT5E | UNI-ROYAL(Uniroyal Elec) | 0805 | -55℃~+155℃ 125mW 150V 1Ω Thick Film Resistor ±1% ±200ppm/℃ 0805 Chip Resistor - Surface Mount ROHS | 225340 | 0.0047 | Resistance=1Ω; Operating Temperature=-55℃~+155℃; Power(Watts)=125mW; Type=Thick Film Resistor; Voltage-Supply(Max)=150V; Tolerance=±1%; Temperature Coefficient=±200ppm/℃ | https://www.lcsc.com/datasheet/lcsc_datasheet_2205311845_UNI-ROYAL-Uniroyal-Elec-0805W8F100KT5E_C25271.pdf | https://jlcpcb.com/partdetail/26014-0805W8F100KT5E/C25271
C17437 | basic | Chip Resistor - Surface Mount | Chip Resistor - Surface Mount | 0805W8F1200T5E | UNI-ROYAL(Uniroyal Elec) | 0805 | -55℃~+155℃ 120Ω 125mW 150V Thick Film Resistor ±1% ±100ppm/℃ 0805 Chip Resistor - Surface Mount ROHS | 1706081 | 0.0065 | Resistance=120Ω; Operating Temperature=-55℃~+155℃; Power(Watts)=125mW; Type=Thick Film Resistor; Voltage-Supply(Max)=150V; Tolerance=±1%; Temperature Coefficient=±100ppm/℃ | https://www.lcsc.com/datasheet/lcsc_datasheet_2206010216_UNI-ROYAL-Uniroyal-Elec-0805W8F1200T5E_C17437.pdf | https://jlcpcb.com/partdetail/18125-0805W8F1200T5E/C17437
C17379 | basic | Chip Resistor - Surface Mount | Chip Resistor - Surface Mount | 0805W8F1201T5E | UNI-ROYAL(Uniroyal Elec) | 0805 | -55℃~+155℃ 1.2kΩ 125mW 150V Thick Film Resistor ±1% ±100ppm/℃ 0805 Chip Resistor - Surface Mount ROHS | 1726867 | 0.0049 | Resistance=1.2kΩ; Operating Temperature=-55℃~+155℃; Power(Watts)=125mW; Type=Thick Film Resistor; Voltage-Supply(Max)=150V; Tolerance=±1%; Temperature Coefficient=±100ppm/℃ | https://www.lcsc.com/datasheet/lcsc_datasheet_2206010216_UNI-ROYAL-Uniroyal-Elec-0805W8F1201T5E_C17379.pdf | https://jlcpcb.com/partdetail/18067-0805W8F1201T5E/C17379
C17444 | basic | Chip Resistor - Surface Mount | Chip Resistor - Surface Mount | 0805W8F1202T5E | UNI-ROYAL(Uniroyal Elec) | 0805 | -55℃~+155℃ 125mW 12kΩ 150V Thick Film Resistor ±1% ±100ppm/℃ 0805 Chip Resistor - Surface Mount ROHS | 400796 | 0.0025 | Resistance=12kΩ; Operating Temperature=-55℃~+155℃; Power(Watts)=125mW; Type=Thick Film Resistor; Voltage-Supply(Max)=150V; Tolerance=±1%; Temperature Coefficient=±100ppm/℃ | https://www.lcsc.com/datasheet/lcsc_datasheet_2206010216_UNI-ROYAL-Uniroyal-Elec-0805W8F1202T5E_C17444.pdf | https://jlcpcb.com/partdetail/18132-0805W8F1202T5E/C17444
C17471 | basic | Chip Resistor - Surface Mount | Chip Resistor - Surface Mount | 0805W8F1500T5E | UNI-ROYAL(Uniroyal Elec) | 0805 | -55℃~+155℃ 125mW 150V 150Ω Thick Film Resistor ±1% ±100ppm/℃ 0805 Chip Resistor - Surface Mount ROHS | 522280 | 0.0056 | Resistance=150Ω; Operating Temperature=-55℃~+155℃; Power(Watts)=125mW; Type=Thick Film Resistor; Voltage-Supply(Max)=150V; Tolerance=±1%; Temperature Coefficient=±100ppm/℃ | https://www.lcsc.com/datasheet/lcsc_datasheet_2206010216_UNI-ROYAL-Uniroyal-Elec-0805W8F1500T5E_C17471.pdf | https://jlcpcb.com/partdetail/18159-0805W8F1500T5E/C17471
C4310 | basic | Chip Resistor - Surface Mount | Chip Resistor - Surface Mount | 0805W8F1501T5E | UNI-ROYAL(Uniroyal Elec) | 0805 | -55℃~+155℃ 1.5kΩ 125mW 150V Thick Film Resistor ±1% ±100ppm/℃ 0805 Chip Resistor - Surface Mount ROHS | 829841 | 0.0035 | Resistance=1.5kΩ; Operating Temperature=-55℃~+155℃; Power(Watts)=125mW; Type=Thick Film Resistor; Voltage-Supply(Max)=150V; Tolerance=±1%; Temperature Coefficient=±100ppm/℃ | https://www.lcsc.com/datasheet/lcsc_datasheet_2206010216_UNI-ROYAL-Uniroyal-Elec-0805W8F1501T5E_C4310.pdf | https://jlcpcb.com/partdetail/4717-0805W8F1501T5E/C4310
C17475 | basic | Chip Resistor - Surface Mount | Chip Resistor - Surface Mount | 0805W8F1502T5E | UNI-ROYAL(Uniroyal Elec) | 0805 | -55℃~+155℃ 125mW 150V 15kΩ Thick Film Resistor ±1% ±100ppm/℃ 0805 Chip Resistor - Surface Mount ROHS | 822059 | 0.0059 | Resistance=15kΩ; Operating Temperature=-55℃~+155℃; Power(Watts)=125mW; Type=Thick Film Resistor; Voltage-Supply(Max)=150V; Tolerance=±1%; Temperature Coefficient=±100ppm/℃ | https://www.lcsc.com/datasheet/lcsc_datasheet_2206010216_UNI-ROYAL-Uniroyal-Elec-0805W8F1502T5E_C17475.pdf | https://jlcpcb.com/partdetail/18163-0805W8F1502T5E/C17475
C17470 | basic | Chip Resistor - Surface Mount | Chip Resistor - Surface Mount | 0805W8F1503T5E | UNI-ROYAL(Uniroyal Elec) | 0805 | -55℃~+155℃ 125mW 150V 150kΩ Thick Film Resistor ±1% ±100ppm/℃ 0805 Chip Resistor - Surface Mount ROHS | 1037545 | 0.0048 | Resistance=150kΩ; Operating Temperature=-55℃~+155℃; Power(Watts)=125mW; Type=Thick Film Resistor; Voltage-Supply(Max)=150V; Tolerance=±1%; Temperature Coefficient=±100ppm/℃ | https://www.lcsc.com/datasheet/lcsc_datasheet_2206010216_UNI-ROYAL-Uniroyal-Elec-0805W8F1503T5E_C17470.pdf | https://jlcpcb.com/partdetail/18158-0805W8F1503T5E/C17470
C17540 | basic | Chip Resistor - Surface Mount | Chip Resistor - Surface Mount | 0805W8F2000T5E | UNI-ROYAL(Uniroyal Elec) | 0805 | -55℃~+155℃ 125mW 150V 200Ω Thick Film Resistor ±1% ±100ppm/℃ 0805 Chip Resistor - Surface Mount ROHS | 1360305 | 0.0067 | Resistance=200Ω; Operating Temperature=-55℃~+155℃; Power(Watts)=125mW; Type=Thick Film Resistor; Voltage-Supply(Max)=150V; Tolerance=±1%; Temperature Coefficient=±100ppm/℃ | https://www.lcsc.com/datasheet/lcsc_datasheet_2206010200_UNI-ROYAL-Uniroyal-Elec-0805W8F2000T5E_C17540.pdf | https://jlcpcb.com/partdetail/18228-0805W8F2000T5E/C17540
C17604 | basic | Chip Resistor - Surface Mount | Chip Resistor - Surface Mount | 0805W8F2001T5E | UNI-ROYAL(Uniroyal Elec) | 0805 | -55℃~+155℃ 125mW 150V 2kΩ Thick Film Resistor ±1% ±100ppm/℃ 0805 Chip Resistor - Surface Mount ROHS | 5688883 | 0.0039 | Resistance=2kΩ; Operating Temperature=-55℃~+155℃; Power(Watts)=125mW; Type=Thick Film Resistor; Voltage-Supply(Max)=150V; Tolerance=±1%; Temperature Coefficient=±100ppm/℃ | https://www.lcsc.com/datasheet/lcsc_datasheet_2206010200_UNI-ROYAL-Uniroyal-Elec-0805W8F2001T5E_C17604.pdf | https://jlcpcb.com/partdetail/18292-0805W8F2001T5E/C17604
C4328 | basic | Chip Resistor - Surface Mount | Chip Resistor - Surface Mount | 0805W8F2002T5E | UNI-ROYAL(Uniroyal Elec) | 0805 | -55℃~+155℃ 125mW 150V 20kΩ Thick Film Resistor ±1% ±100ppm/℃ 0805 Chip Resistor - Surface Mount ROHS | 2733839 | 0.0041 | Resistance=20kΩ; Operating Temperature=-55℃~+155℃; Power(Watts)=125mW; Type=Thick Film Resistor; Voltage-Supply(Max)=150V; Tolerance=±1%; Temperature Coefficient=±100ppm/℃ | https://www.lcsc.com/datasheet/lcsc_datasheet_2206010216_UNI-ROYAL-Uniroyal-Elec-0805W8F2002T5E_C4328.pdf | https://jlcpcb.com/partdetail/4735-0805W8F2002T5E/C4328
C17539 | basic | Chip Resistor - Surface Mount | Chip Resistor - Surface Mount | 0805W8F2003T5E | UNI-ROYAL(Uniroyal Elec) | 0805 | -55℃~+155℃ 125mW 150V 200kΩ Thick Film Resistor ±1% ±100ppm/℃ 0805 Chip Resistor - Surface Mount ROHS | 697107 | 0.0056 | Resistance=200kΩ; Operating Temperature=-55℃~+155℃; Power(Watts)=125mW; Type=Thick Film Resistor; Voltage-Supply(Max)=150V; Tolerance=±1%; Temperature Coefficient=±100ppm/℃ | https://www.lcsc.com/datasheet/lcsc_datasheet_2206010200_UNI-ROYAL-Uniroyal-Elec-0805W8F2003T5E_C17539.pdf | https://jlcpcb.com/partdetail/18227-0805W8F2003T5E/C17539
C17544 | basic | Chip Resistor - Surface Mount | Chip Resistor - Surface Mount | 0805W8F200JT5E | UNI-ROYAL(Uniroyal Elec) | 0805 | -55℃~+155℃ 125mW 150V 20Ω Thick Film Resistor ±1% ±100ppm/℃ 0805 Chip Resistor - Surface Mount ROHS | 1974339 | 0.0049 | Resistance=20Ω; Operating Temperature=-55℃~+155℃; Power(Watts)=125mW; Type=Thick Film Resistor; Voltage-Supply(Max)=150V; Tolerance=±1%; Temperature Coefficient=±100ppm/℃ | https://www.lcsc.com/datasheet/lcsc_datasheet_2206010200_UNI-ROYAL-Uniroyal-Elec-0805W8F200JT5E_C17544.pdf | https://jlcpcb.com/partdetail/18232-0805W8F200JT5E/C17544
C17557 | basic | Chip Resistor - Surface Mount | Chip Resistor - Surface Mount | 0805W8F2200T5E | UNI-ROYAL(Uniroyal Elec) | 0805 | -55℃~+155℃ 125mW 150V 220Ω Thick Film Resistor ±1% ±100ppm/℃ 0805 Chip Resistor - Surface Mount ROHS | 973252 | 0.0054 | Resistance=220Ω; Operating Temperature=-55℃~+155℃; Power(Watts)=125mW; Type=Thick Film Resistor; Voltage-Supply(Max)=150V; Tolerance=±1%; Temperature Coefficient=±100ppm/℃ | https://www.lcsc.com/datasheet/lcsc_datasheet_2206010200_UNI-ROYAL-Uniroyal-Elec-0805W8F2200T5E_C17557.pdf | https://jlcpcb.com/partdetail/18245-0805W8F2200T5E/C17557
C17520 | basic | Chip Resistor - Surface Mount | Chip Resistor - Surface Mount | 0805W8F2201T5E | UNI-ROYAL(Uniroyal Elec) | 0805 | -55℃~+155℃ 125mW 150V 2.2kΩ Thick Film Resistor ±1% ±100ppm/℃ 0805 Chip Resistor - Surface Mount ROHS | 3680276 | 0.0046 | Resistance=2.2kΩ; Operating Temperature=-55℃~+155℃; Power(Watts)=125mW; Type=Thick Film Resistor; Voltage-Supply(Max)=150V; Tolerance=±1%; Temperature Coefficient=±100ppm/℃ | https://www.lcsc.com/datasheet/lcsc_datasheet_2206010200_UNI-ROYAL-Uniroyal-Elec-0805W8F2201T5E_C17520.pdf | https://jlcpcb.com/partdetail/18208-0805W8F2201T5E/C17520
C17560 | basic | Chip Resistor - Surface Mount | Chip Resistor - Surface Mount | 0805W8F2202T5E | UNI-ROYAL(Uniroyal Elec) | 0805 | -55℃~+155℃ 125mW 150V 22kΩ Thick Film Resistor ±1% ±100ppm/℃ 0805 Chip Resistor - Surface Mount ROHS | 1806706 | 0.0048 | Resistance=22kΩ; Operating Temperature=-55℃~+155℃; Power(Watts)=125mW; Type=Thick Film Resistor; Voltage-Supply(Max)=150V; Tolerance=±1%; Temperature Coefficient=±100ppm/℃ | https://www.lcsc.com/datasheet/lcsc_datasheet_2206010200_UNI-ROYAL-Uniroyal-Elec-0805W8F2202T5E_C17560.pdf | https://jlcpcb.com/partdetail/18248-0805W8F2202T5E/C17560
C17556 | basic | Chip Resistor - Surface Mount | Chip Resistor - Surface Mount | 0805W8F2203T5E | UNI-ROYAL(Uniroyal Elec) | 0805 | -55℃~+155℃ 125mW 150V 220kΩ Thick Film Resistor ±1% ±100ppm/℃ 0805 Chip Resistor - Surface Mount ROHS | 280548 | 0.0044 | Resistance=220kΩ; Operating Temperature=-55℃~+155℃; Power(Watts)=125mW; Type=Thick Film Resistor; Voltage-Supply(Max)=150V; Tolerance=±1%; Temperature Coefficient=±100ppm/℃ | https://www.lcsc.com/datasheet/lcsc_datasheet_2206010200_UNI-ROYAL-Uniroyal-Elec-0805W8F2203T5E_C17556.pdf | https://jlcpcb.com/partdetail/18244-0805W8F2203T5E/C17556
C17561 | basic | Chip Resistor - Surface Mount | Chip Resistor - Surface Mount | 0805W8F220JT5E | UNI-ROYAL(Uniroyal Elec) | 0805 | -55℃~+155℃ 125mW 150V 22Ω Thick Film Resistor ±1% ±100ppm/℃ 0805 Chip Resistor - Surface Mount ROHS | 1807436 | 0.0045 | Resistance=22Ω; Operating Temperature=-55℃~+155℃; Power(Watts)=125mW; Type=Thick Film Resistor; Voltage-Supply(Max)=150V; Tolerance=±1%; Temperature Coefficient=±100ppm/℃ | https://www.lcsc.com/datasheet/lcsc_datasheet_2206010200_UNI-ROYAL-Uniroyal-Elec-0805W8F220JT5E_C17561.pdf | https://jlcpcb.com/partdetail/18249-0805W8F220JT5E/C17561
C17521 | basic | Chip Resistor - Surface Mount | Chip Resistor - Surface Mount | 0805W8F220KT5E | UNI-ROYAL(Uniroyal Elec) | 0805 | -55℃~+155℃ 125mW 150V 2.2Ω Thick Film Resistor ±1% ±200ppm/℃ 0805 Chip Resistor - Surface Mount ROHS | 367082 | 0.0074 | Resistance=2.2Ω; Operating Temperature=-55℃~+155℃; Power(Watts)=125mW; Type=Thick Film Resistor; Voltage-Supply(Max)=150V; Tolerance=±1%; Temperature Coefficient=±200ppm/℃ | https://www.lcsc.com/datasheet/lcsc_datasheet_2206010200_UNI-ROYAL-Uniroyal-Elec-0805W8F220KT5E_C17521.pdf | https://jlcpcb.com/partdetail/18209-0805W8F220KT5E/C17521
C17526 | basic | Chip Resistor - Surface Mount | Chip Resistor - Surface Mount | 0805W8F2401T5E | UNI-ROYAL(Uniroyal Elec) | 0805 | -55℃~+155℃ 125mW 150V 2.4kΩ Thick Film Resistor ±1% ±100ppm/℃ 0805 Chip Resistor - Surface Mount ROHS | 318124 | 0.0032 | Resistance=2.4kΩ; Operating Temperature=-55℃~+155℃; Power(Watts)=125mW; Type=Thick Film Resistor; Voltage-Supply(Max)=150V; Tolerance=±1%; Temperature Coefficient=±100ppm/℃ | https://www.lcsc.com/datasheet/lcsc_datasheet_2206010200_UNI-ROYAL-Uniroyal-Elec-0805W8F2401T5E_C17526.pdf | https://jlcpcb.com/partdetail/18214-0805W8F2401T5E/C17526
C17575 | basic | Chip Resistor - Surface Mount | Chip Resistor - Surface Mount | 0805W8F2402T5E | UNI-ROYAL(Uniroyal Elec) | 0805 | -55℃~+155℃ 125mW 150V 24kΩ Thick Film Resistor ±1% ±100ppm/℃ 0805 Chip Resistor - Surface Mount ROHS | 463183 | 0.0044 | Resistance=24kΩ; Operating Temperature=-55℃~+155℃; Power(Watts)=125mW; Type=Thick Film Resistor; Voltage-Supply(Max)=150V; Tolerance=±1%; Temperature Coefficient=±100ppm/℃ | https://www.lcsc.com/datasheet/lcsc_datasheet_2206010200_UNI-ROYAL-Uniroyal-Elec-0805W8F2402T5E_C17575.pdf | https://jlcpcb.com/partdetail/18263-0805W8F2402T5E/C17575
C17530 | basic | Chip Resistor - Surface Mount | Chip Resistor - Surface Mount | 0805W8F2701T5E | UNI-ROYAL(Uniroyal Elec) | 0805 | -55℃~+155℃ 125mW 150V 2.7kΩ Thick Film Resistor ±1% ±100ppm/℃ 0805 Chip Resistor - Surface Mount ROHS | 1849454 | 0.0056 | Resistance=2.7kΩ; Operating Temperature=-55℃~+155℃; Power(Watts)=125mW; Type=Thick Film Resistor; Voltage-Supply(Max)=150V; Tolerance=±1%; Temperature Coefficient=±100ppm/℃ | https://www.lcsc.com/datasheet/lcsc_datasheet_2206010200_UNI-ROYAL-Uniroyal-Elec-0805W8F2701T5E_C17530.pdf | https://jlcpcb.com/partdetail/18218-0805W8F2701T5E/C17530
C17593 | basic | Chip Resistor - Surface Mount | Chip Resistor - Surface Mount | 0805W8F2702T5E | UNI-ROYAL(Uniroyal Elec) | 0805 | -55℃~+155℃ 125mW 150V 27kΩ Thick Film Resistor ±1% ±100ppm/℃ 0805 Chip Resistor - Surface Mount ROHS | 242713 | 0.0022 | Resistance=27kΩ; Operating Temperature=-55℃~+155℃; Power(Watts)=125mW; Type=Thick Film Resistor; Voltage-Supply(Max)=150V; Tolerance=±1%; Temperature Coefficient=±100ppm/℃ | https://www.lcsc.com/datasheet/lcsc_datasheet_2206010200_UNI-ROYAL-Uniroyal-Elec-0805W8F2702T5E_C17593.pdf | https://jlcpcb.com/partdetail/18281-0805W8F2702T5E/C17593
C17617 | basic | Chip Resistor - Surface Mount | Chip Resistor - Surface Mount | 0805W8F3000T5E | UNI-ROYAL(Uniroyal Elec) | 0805 | -55℃~+155℃ 125mW 150V 300Ω Thick Film Resistor ±1% ±100ppm/℃ 0805 Chip Resistor - Surface Mount ROHS | 711943 | 0.005 | Resistance=300Ω; Operating Temperature=-55℃~+155℃; Power(Watts)=125mW; Type=Thick Film Resistor; Voltage-Supply(Max)=150V; Tolerance=±1%; Temperature Coefficient=±100ppm/℃ | https://www.lcsc.com/datasheet/lcsc_datasheet_2206010200_UNI-ROYAL-Uniroyal-Elec-0805W8F3000T5E_C17617.pdf | https://jlcpcb.com/partdetail/18305-0805W8F3000T5E/C17617
C17661 | basic | Chip Resistor - Surface Mount | Chip Resistor - Surface Mount | 0805W8F3001T5E | UNI-ROYAL(Uniroyal Elec) | 0805 | -55℃~+155℃ 125mW 150V 3kΩ Thick Film Resistor ±1% ±100ppm/℃ 0805 Chip Resistor - Surface Mount ROHS | 1753098 | 0.0048 | Resistance=3kΩ; Operating Temperature=-55℃~+155℃; Power(Watts)=125mW; Type=Thick Film Resistor; Voltage-Supply(Max)=150V; Tolerance=±1%; Temperature Coefficient=±100ppm/℃ | https://www.lcsc.com/datasheet/lcsc_datasheet_2206010200_UNI-ROYAL-Uniroyal-Elec-0805W8F3001T5E_C17661.pdf | https://jlcpcb.com/partdetail/18349-0805W8F3001T5E/C17661
C17621 | basic | Chip Resistor - Surface Mount | Chip Resistor - Surface Mount | 0805W8F3002T5E | UNI-ROYAL(Uniroyal Elec) | 0805 | -55℃~+155℃ 125mW 150V 30kΩ Thick Film Resistor ±1% ±100ppm/℃ 0805 Chip Resistor - Surface Mount ROHS | 967157 | 0.0047 | Resistance=30kΩ; Operating Temperature=-55℃~+155℃; Power(Watts)=125mW; Type=Thick Film Resistor; Voltage-Supply(Max)=150V; Tolerance=±1%; Temperature Coefficient=±100ppm/℃ | https://www.lcsc.com/datasheet/lcsc_datasheet_2205311830_UNI-ROYAL-Uniroyal-Elec-0805W8F3002T5E_C17621.pdf | https://jlcpcb.com/partdetail/18309-0805W8F3002T5E/C17621
C17630 | basic | Chip Resistor - Surface Mount | Chip Resistor - Surface Mount | 0805W8F3300T5E | UNI-ROYAL(Uniroyal Elec) | 0805 | -55℃~+155℃ 125mW 150V 330Ω Thick Film Resistor ±1% ±100ppm/℃ 0805 Chip Resistor - Surface Mount ROHS | 2211800 | 0.0049 | Resistance=330Ω; Operating Temperature=-55℃~+155℃; Power(Watts)=125mW; Type=Thick Film Resistor; Voltage-Supply(Max)=150V; Tolerance=±1%; Temperature Coefficient=±100ppm/℃ | https://www.lcsc.com/datasheet/lcsc_datasheet_2205311830_UNI-ROYAL-Uniroyal-Elec-0805W8F3300T5E_C17630.pdf | https://jlcpcb.com/partdetail/18318-0805W8F3300T5E/C17630
C26010 | basic | Chip Resistor - Surface Mount | Chip Resistor - Surface Mount | 0805W8F3301T5E | UNI-ROYAL(Uniroyal Elec) | 0805 | -55℃~+155℃ 125mW 150V 3.3kΩ Thick Film Resistor ±1% ±100ppm/℃ 0805 Chip Resistor - Surface Mount ROHS | 2205402 | 0.0042 | Resistance=3.3kΩ; Operating Temperature=-55℃~+155℃; Power(Watts)=125mW; Type=Thick Film Resistor; Voltage-Supply(Max)=150V; Tolerance=±1%; Temperature Coefficient=±100ppm/℃ | https://www.lcsc.com/datasheet/lcsc_datasheet_2206010045_UNI-ROYAL-Uniroyal-Elec-0805W8F3301T5E_C26010.pdf | https://jlcpcb.com/partdetail/26753-0805W8F3301T5E/C26010
C17633 | basic | Chip Resistor - Surface Mount | Chip Resistor - Surface Mount | 0805W8F3302T5E | UNI-ROYAL(Uniroyal Elec) | 0805 | -55℃~+155℃ 125mW 150V 33kΩ Thick Film Resistor ±1% ±100ppm/℃ 0805 Chip Resistor - Surface Mount ROHS | 515863 | 0.0039 | Resistance=33kΩ; Operating Temperature=-55℃~+155℃; Power(Watts)=125mW; Type=Thick Film Resistor; Voltage-Supply(Max)=150V; Tolerance=±1%; Temperature Coefficient=±100ppm/℃ | https://www.lcsc.com/datasheet/lcsc_datasheet_2205311830_UNI-ROYAL-Uniroyal-Elec-0805W8F3302T5E_C17633.pdf | https://jlcpcb.com/partdetail/18321-0805W8F3302T5E/C17633
C17634 | basic | Chip Resistor - Surface Mount | Chip Resistor - Surface Mount | 0805W8F330JT5E | UNI-ROYAL(Uniroyal Elec) | 0805 | -55℃~+155℃ 125mW 150V 33Ω Thick Film Resistor ±1% ±200ppm/℃ 0805 Chip Resistor - Surface Mount ROHS | 1646237 | 0.0047 | Resistance=33Ω; Operating Temperature=-55℃~+155℃; Power(Watts)=125mW; Type=Thick Film Resistor; Voltage-Supply(Max)=150V; Tolerance=±1%; Temperature Coefficient=±200ppm/℃ | https://www.lcsc.com/datasheet/lcsc_datasheet_2205311830_UNI-ROYAL-Uniroyal-Elec-0805W8F330JT5E_C17634.pdf | https://jlcpcb.com/partdetail/18322-0805W8F330JT5E/C17634
C17655 | basic | Chip Resistor - Surface Mount | Chip Resistor - Surface Mount | 0805W8F3900T5E | UNI-ROYAL(Uniroyal Elec) | 0805 | -55℃~+155℃ 125mW 150V 390Ω Thick Film Resistor ±1% ±100ppm/℃ 0805 Chip Resistor - Surface Mount ROHS | 1479429 | 0.0021 | Resistance=390Ω; Operating Temperature=-55℃~+155℃; Power(Watts)=125mW; Type=Thick Film Resistor; Voltage-Supply(Max)=150V; Tolerance=±1%; Temperature Coefficient=±100ppm/℃ | https://www.lcsc.com/datasheet/lcsc_datasheet_2206010200_UNI-ROYAL-Uniroyal-Elec-0805W8F3900T5E_C17655.pdf | https://jlcpcb.com/partdetail/18343-0805W8F3900T5E/C17655
C17614 | basic | Chip Resistor - Surface Mount | Chip Resistor - Surface Mount | 0805W8F3901T5E | UNI-ROYAL(Uniroyal Elec) | 0805 | -55℃~+155℃ 125mW 150V 3.9kΩ Thick Film Resistor ±1% ±100ppm/℃ 0805 Chip Resistor - Surface Mount ROHS | 207359 | 0.0025 | Resistance=3.9kΩ; Operating Temperature=-55℃~+155℃; Power(Watts)=125mW; Type=Thick Film Resistor; Voltage-Supply(Max)=150V; Tolerance=±1%; Temperature Coefficient=±100ppm/℃ | https://www.lcsc.com/datasheet/lcsc_datasheet_2206010200_UNI-ROYAL-Uniroyal-Elec-0805W8F3901T5E_C17614.pdf | https://jlcpcb.com/partdetail/18302-0805W8F3901T5E/C17614
C17710 | basic | Chip Resistor - Surface Mount | Chip Resistor - Surface Mount | 0805W8F4700T5E | UNI-ROYAL(Uniroyal Elec) | 0805 | -55℃~+155℃ 125mW 150V 470Ω Thick Film Resistor ±1% ±100ppm/℃ 0805 Chip Resistor - Surface Mount ROHS | 2874866 | 0.0048 | Resistance=470Ω; Operating Temperature=-55℃~+155℃; Power(Watts)=125mW; Type=Thick Film Resistor; Voltage-Supply(Max)=150V; Tolerance=±1%; Temperature Coefficient=±100ppm/℃ | https://www.lcsc.com/datasheet/lcsc_datasheet_2206010200_UNI-ROYAL-Uniroyal-Elec-0805W8F4700T5E_C17710.pdf | https://jlcpcb.com/partdetail/18398-0805W8F4700T5E/C17710
C17673 | basic | Chip Resistor - Surface Mount | Chip Resistor - Surface Mount | 0805W8F4701T5E | UNI-ROYAL(Uniroyal Elec) | 0805 | -55℃~+155℃ 125mW 150V 4.7kΩ Thick Film Resistor ±1% ±100ppm/℃ 0805 Chip Resistor - Surface Mount ROHS | 5406760 | 0.005 | Resistance=4.7kΩ; Operating Temperature=-55℃~+155℃; Power(Watts)=125mW; Type=Thick Film Resistor; Voltage-Supply(Max)=150V; Tolerance=±1%; Temperature Coefficient=±100ppm/℃ | https://www.lcsc.com/datasheet/lcsc_datasheet_2206010200_UNI-ROYAL-Uniroyal-Elec-0805W8F4701T5E_C17673.pdf | https://jlcpcb.com/partdetail/18361-0805W8F4701T5E/C17673
C17713 | basic | Chip Resistor - Surface Mount | Chip Resistor - Surface Mount | 0805W8F4702T5E | UNI-ROYAL(Uniroyal Elec) | 0805 | -55℃~+155℃ 125mW 150V 47kΩ Thick Film Resistor ±1% ±100ppm/℃ 0805 Chip Resistor - Surface Mount ROHS | 1919526 | 0.0067 | Resistance=47kΩ; Operating Temperature=-55℃~+155℃; Power(Watts)=125mW; Type=Thick Film Resistor; Voltage-Supply(Max)=150V; Tolerance=±1%; Temperature Coefficient=±100ppm/℃ | https://www.lcsc.com/datasheet/lcsc_datasheet_2206010200_UNI-ROYAL-Uniroyal-Elec-0805W8F4702T5E_C17713.pdf | https://jlcpcb.com/partdetail/18401-0805W8F4702T5E/C17713
C17709 | basic | Chip Resistor - Surface Mount | Chip Resistor - Surface Mount | 0805W8F4703T5E | UNI-ROYAL(Uniroyal Elec) | 0805 | -55℃~+155℃ 125mW 150V 470kΩ Thick Film Resistor ±1% ±100ppm/℃ 0805 Chip Resistor - Surface Mount ROHS | 424609 | 0.0023 | Resistance=470kΩ; Operating Temperature=-55℃~+155℃; Power(Watts)=125mW; Type=Thick Film Resistor; Voltage-Supply(Max)=150V; Tolerance=±1%; Temperature Coefficient=±100ppm/℃ | https://www.lcsc.com/datasheet/lcsc_datasheet_2206010200_UNI-ROYAL-Uniroyal-Elec-0805W8F4703T5E_C17709.pdf | https://jlcpcb.com/partdetail/18397-0805W8F4703T5E/C17709
C17714 | basic | Chip Resistor - Surface Mount | Chip Resistor - Surface Mount | 0805W8F470JT5E | UNI-ROYAL(Uniroyal Elec) | 0805 | -55℃~+155℃ 125mW 150V 47Ω Thick Film Resistor ±1% ±100ppm/℃ 0805 Chip Resistor - Surface Mount ROHS | 470061 | 0.0042 | Resistance=47Ω; Operating Temperature=-55℃~+155℃; Power(Watts)=125mW; Type=Thick Film Resistor; Voltage-Supply(Max)=150V; Tolerance=±1%; Temperature Coefficient=±100ppm/℃ | https://www.lcsc.com/datasheet/lcsc_datasheet_2206010200_UNI-ROYAL-Uniroyal-Elec-0805W8F470JT5E_C17714.pdf | https://jlcpcb.com/partdetail/18402-0805W8F470JT5E/C17714
C17675 | basic | Chip Resistor - Surface Mount | Chip Resistor - Surface Mount | 0805W8F470KT5E | UNI-ROYAL(Uniroyal Elec) | 0805 | -55℃~+155℃ 125mW 150V 4.7Ω Thick Film Resistor ±1% ±200ppm/℃ 0805 Chip Resistor - Surface Mount ROHS | 91730 | 0.0051 | Resistance=4.7Ω; Operating Temperature=-55℃~+155℃; Power(Watts)=125mW; Type=Thick Film Resistor; Voltage-Supply(Max)=150V; Tolerance=±1%; Temperature Coefficient=±200ppm/℃ | https://www.lcsc.com/datasheet/lcsc_datasheet_2206010200_UNI-ROYAL-Uniroyal-Elec-0805W8F470KT5E_C17675.pdf | https://jlcpcb.com/partdetail/18363-0805W8F470KT5E/C17675
C17720 | basic | Chip Resistor - Surface Mount | Chip Resistor - Surface Mount | 0805W8F499JT5E | UNI-ROYAL(Uniroyal Elec) | 0805 | -55℃~+155℃ 125mW 150V 49.9Ω Thick Film Resistor ±1% ±100ppm/℃ 0805 Chip Resistor - Surface Mount ROHS | 645253 | 0.005 | Resistance=49.9Ω; Operating Temperature=-55℃~+155℃; Power(Watts)=125mW; Type=Thick Film Resistor; Voltage-Supply(Max)=150V; Tolerance=±1%; Temperature Coefficient=±100ppm/℃ | https://www.lcsc.com/datasheet/lcsc_datasheet_2206010200_UNI-ROYAL-Uniroyal-Elec-0805W8F499JT5E_C17720.pdf | https://jlcpcb.com/partdetail/18408-0805W8F499JT5E/C17720
C17734 | basic | Chip Resistor - Surface Mount | Chip Resistor - Surface Mount | 0805W8F5100T5E | UNI-ROYAL(Uniroyal Elec) | 0805 | -55℃~+155℃ 125mW 150V 510Ω Thick Film Resistor ±1% ±100ppm/℃ 0805 Chip Resistor - Surface Mount ROHS | 2951982 | 0.004 | Resistance=510Ω; Operating Temperature=-55℃~+155℃; Power(Watts)=125mW; Type=Thick Film Resistor; Voltage-Supply(Max)=150V; Tolerance=±1%; Temperature Coefficient=±100ppm/℃ | https://www.lcsc.com/datasheet/lcsc_datasheet_2206010200_UNI-ROYAL-Uniroyal-Elec-0805W8F5100T5E_C17734.pdf | https://jlcpcb.com/partdetail/18422-0805W8F5100T5E/C17734
C27834 | basic | Chip Resistor - Surface Mount | Chip Resistor - Surface Mount | 0805W8F5101T5E | UNI-ROYAL(Uniroyal Elec) | 0805 | -55℃~+155℃ 125mW 150V 5.1kΩ Thick Film Resistor ±1% ±100ppm/℃ 0805 Chip Resistor - Surface Mount ROHS | 3569569 | 0.0056 | Resistance=5.1kΩ; Operating Temperature=-55℃~+155℃; Power(Watts)=125mW; Type=Thick Film Resistor; Voltage-Supply(Max)=150V; Tolerance=±1%; Temperature Coefficient=±100ppm/℃ | https://www.lcsc.com/datasheet/lcsc_datasheet_2206010030_UNI-ROYAL-Uniroyal-Elec-0805W8F5101T5E_C27834.pdf | https://jlcpcb.com/partdetail/28584-0805W8F5101T5E/C27834
C17737 | basic | Chip Resistor - Surface Mount | Chip Resistor - Surface Mount | 0805W8F5102T5E | UNI-ROYAL(Uniroyal Elec) | 0805 | -55℃~+155℃ 125mW 150V 51kΩ Thick Film Resistor ±1% ±100ppm/℃ 0805 Chip Resistor - Surface Mount ROHS | 858057 | 0.0067 | Resistance=51kΩ; Operating Temperature=-55℃~+155℃; Power(Watts)=125mW; Type=Thick Film Resistor; Voltage-Supply(Max)=150V; Tolerance=±1%; Temperature Coefficient=±100ppm/℃ | https://www.lcsc.com/datasheet/lcsc_datasheet_2206010200_UNI-ROYAL-Uniroyal-Elec-0805W8F5102T5E_C17737.pdf | https://jlcpcb.com/partdetail/18425-0805W8F5102T5E/C17737
C17738 | basic | Chip Resistor - Surface Mount | Chip Resistor - Surface Mount | 0805W8F510JT5E | UNI-ROYAL(Uniroyal Elec) | 0805 | -55℃~+155℃ 125mW 150V 51Ω Thick Film Resistor ±1% ±100ppm/℃ 0805 Chip Resistor - Surface Mount ROHS | 884020 | 0.003 | Resistance=51Ω; Operating Temperature=-55℃~+155℃; Power(Watts)=125mW; Type=Thick Film Resistor; Voltage-Supply(Max)=150V; Tolerance=±1%; Temperature Coefficient=±100ppm/℃ | https://www.lcsc.com/datasheet/lcsc_datasheet_2411221126_UNI-ROYAL-Uniroyal-Elec-0805W8F510JT5E_C17738.pdf | https://jlcpcb.com/partdetail/18426-0805W8F510JT5E/C17738
C17724 | basic | Chip Resistor - Surface Mount | Chip Resistor - Surface Mount | 0805W8F510KT5E | UNI-ROYAL(Uniroyal Elec) | 0805 | -55℃~+155℃ 125mW 150V 5.1Ω Thick Film Resistor ±1% ±200ppm/℃ 0805 Chip Resistor - Surface Mount ROHS | 529131 | 0.0041 | Resistance=5.1Ω; Operating Temperature=-55℃~+155℃; Power(Watts)=125mW; Type=Thick Film Resistor; Voltage-Supply(Max)=150V; Tolerance=±1%; Temperature Coefficient=±200ppm/℃ | https://www.lcsc.com/datasheet/lcsc_datasheet_2206010200_UNI-ROYAL-Uniroyal-Elec-0805W8F510KT5E_C17724.pdf | https://jlcpcb.com/partdetail/18412-0805W8F510KT5E/C17724
C28636 | basic | Chip Resistor - Surface Mount | Chip Resistor - Surface Mount | 0805W8F5600T5E | UNI-ROYAL(Uniroyal Elec) | 0805 | -55℃~+155℃ 125mW 150V 560Ω Thick Film Resistor ±1% ±100ppm/℃ 0805 Chip Resistor - Surface Mount ROHS | 164513 | 0.0043 | Resistance=560Ω; Operating Temperature=-55℃~+155℃; Power(Watts)=125mW; Type=Thick Film Resistor; Voltage-Supply(Max)=150V; Tolerance=±1%; Temperature Coefficient=±100ppm/℃ | https://www.lcsc.com/datasheet/lcsc_datasheet_2206010030_UNI-ROYAL-Uniroyal-Elec-0805W8F5600T5E_C28636.pdf | https://jlcpcb.com/partdetail/29388-0805W8F5600T5E/C28636
C4382 | basic | Chip Resistor - Surface Mount | Chip Resistor - Surface Mount | 0805W8F5601T5E | UNI-ROYAL(Uniroyal Elec) | 0805 | -55℃~+155℃ 125mW 150V 5.6kΩ Thick Film Resistor ±1% ±100ppm/℃ 0805 Chip Resistor - Surface Mount ROHS | 647570 | 0.0062 | Resistance=5.6kΩ; Operating Temperature=-55℃~+155℃; Power(Watts)=125mW; Type=Thick Film Resistor; Voltage-Supply(Max)=150V; Tolerance=±1%; Temperature Coefficient=±100ppm/℃ | https://www.lcsc.com/datasheet/lcsc_datasheet_2206010216_UNI-ROYAL-Uniroyal-Elec-0805W8F5601T5E_C4382.pdf | https://jlcpcb.com/partdetail/4789-0805W8F5601T5E/C4382
C17798 | basic | Chip Resistor - Surface Mount | Chip Resistor - Surface Mount | 0805W8F6800T5E | UNI-ROYAL(Uniroyal Elec) | 0805 | -55℃~+155℃ 125mW 150V 680Ω Thick Film Resistor ±1% ±100ppm/℃ 0805 Chip Resistor - Surface Mount ROHS | 1414396 | 0.0055 | Resistance=680Ω; Operating Temperature=-55℃~+155℃; Power(Watts)=125mW; Type=Thick Film Resistor; Voltage-Supply(Max)=150V; Tolerance=±1%; Temperature Coefficient=±100ppm/℃ | https://www.lcsc.com/datasheet/lcsc_datasheet_2205311830_UNI-ROYAL-Uniroyal-Elec-0805W8F6800T5E_C17798.pdf | https://jlcpcb.com/partdetail/18486-0805W8F6800T5E/C17798
C17772 | basic | Chip Resistor - Surface Mount | Chip Resistor - Surface Mount | 0805W8F6801T5E | UNI-ROYAL(Uniroyal Elec) | 0805 | -55℃~+155℃ 125mW 150V 6.8kΩ Thick Film Resistor ±1% ±100ppm/℃ 0805 Chip Resistor - Surface Mount ROHS | 322147 | 0.0059 | Resistance=6.8kΩ; Operating Temperature=-55℃~+155℃; Power(Watts)=125mW; Type=Thick Film Resistor; Voltage-Supply(Max)=150V; Tolerance=±1%; Temperature Coefficient=±100ppm/℃ | https://www.lcsc.com/datasheet/lcsc_datasheet_2205311830_UNI-ROYAL-Uniroyal-Elec-0805W8F6801T5E_C17772.pdf | https://jlcpcb.com/partdetail/18460-0805W8F6801T5E/C17772
C17801 | basic | Chip Resistor - Surface Mount | Chip Resistor - Surface Mount | 0805W8F6802T5E | UNI-ROYAL(Uniroyal Elec) | 0805 | -55℃~+155℃ 125mW 150V 68kΩ Thick Film Resistor ±1% ±100ppm/℃ 0805 Chip Resistor - Surface Mount ROHS | 317609 | 0.0034 | Resistance=68kΩ; Operating Temperature=-55℃~+155℃; Power(Watts)=125mW; Type=Thick Film Resistor; Voltage-Supply(Max)=150V; Tolerance=±1%; Temperature Coefficient=±100ppm/℃ | https://www.lcsc.com/datasheet/lcsc_datasheet_2205311830_UNI-ROYAL-Uniroyal-Elec-0805W8F6802T5E_C17801.pdf | https://jlcpcb.com/partdetail/18489-0805W8F6802T5E/C17801
C17828 | basic | Chip Resistor - Surface Mount | Chip Resistor - Surface Mount | 0805W8F8201T5E | UNI-ROYAL(Uniroyal Elec) | 0805 | -55℃~+155℃ 125mW 150V 8.2kΩ Thick Film Resistor ±1% ±100ppm/℃ 0805 Chip Resistor - Surface Mount ROHS | 232654 | 0.002 | Resistance=8.2kΩ; Operating Temperature=-55℃~+155℃; Power(Watts)=125mW; Type=Thick Film Resistor; Voltage-Supply(Max)=150V; Tolerance=±1%; Temperature Coefficient=±100ppm/℃ | https://www.lcsc.com/datasheet/lcsc_datasheet_2205311830_UNI-ROYAL-Uniroyal-Elec-0805W8F8201T5E_C17828.pdf | https://jlcpcb.com/partdetail/18516-0805W8F8201T5E/C17828
C17888 | basic | Chip Resistor - Surface Mount | Chip Resistor - Surface Mount | 1206W4F0000T5E | UNI-ROYAL(Uniroyal Elec) | 1206 | -55℃~+155℃ 0Ω 200V 250mW Thick Film Resistor ±1% ±800ppm/℃ 1206 Chip Resistor - Surface Mount ROHS | 2778116 | 0.0085 | Resistance=0Ω; Operating Temperature=-55℃~+155℃; Power(Watts)=250mW; Type=Thick Film Resistor; Voltage-Supply(Max)=200V; Tolerance=±1%; Temperature Coefficient=±800ppm/℃ | https://www.lcsc.com/datasheet/lcsc_datasheet_2206010200_UNI-ROYAL-Uniroyal-Elec-1206W4F0000T5E_C17888.pdf | https://jlcpcb.com/partdetail/18576-1206W4F0000T5E/C17888
C17901 | basic | Chip Resistor - Surface Mount | Chip Resistor - Surface Mount | 1206W4F1000T5E | UNI-ROYAL(Uniroyal Elec) | 1206 | -55℃~+155℃ 100Ω 200V 250mW Thick Film Resistor ±1% ±100ppm/℃ 1206 Chip Resistor - Surface Mount ROHS | 3242386 | 0.0059 | Resistance=100Ω; Operating Temperature=-55℃~+155℃; Power(Watts)=250mW; Type=Thick Film Resistor; Voltage-Supply(Max)=200V; Tolerance=±1%; Temperature Coefficient=±100ppm/℃ | https://www.lcsc.com/datasheet/lcsc_datasheet_2206010145_UNI-ROYAL-Uniroyal-Elec-1206W4F1000T5E_C17901.pdf | https://jlcpcb.com/partdetail/18589-1206W4F1000T5E/C17901
C4410 | basic | Chip Resistor - Surface Mount | Chip Resistor - Surface Mount | 1206W4F1001T5E | UNI-ROYAL(Uniroyal Elec) | 1206 | -55℃~+155℃ 1kΩ 200V 250mW Thick Film Resistor ±1% ±100ppm/℃ 1206 Chip Resistor - Surface Mount ROHS | 2605149 | 0.0085 | Resistance=1kΩ; Operating Temperature=-55℃~+155℃; Power(Watts)=250mW; Type=Thick Film Resistor; Voltage-Supply(Max)=200V; Tolerance=±1%; Temperature Coefficient=±100ppm/℃ | https://www.lcsc.com/datasheet/lcsc_datasheet_2206010216_UNI-ROYAL-Uniroyal-Elec-1206W4F1001T5E_C4410.pdf | https://jlcpcb.com/partdetail/4817-1206W4F1001T5E/C4410
C17902 | basic | Chip Resistor - Surface Mount | Chip Resistor - Surface Mount | 1206W4F1002T5E | UNI-ROYAL(Uniroyal Elec) | 1206 | -55℃~+155℃ 10kΩ 200V 250mW Thick Film Resistor ±1% ±100ppm/℃ 1206 Chip Resistor - Surface Mount ROHS | 3169144 | 0.0083 | Resistance=10kΩ; Operating Temperature=-55℃~+155℃; Power(Watts)=250mW; Type=Thick Film Resistor; Voltage-Supply(Max)=200V; Tolerance=±1%; Temperature Coefficient=±100ppm/℃ | https://www.lcsc.com/datasheet/lcsc_datasheet_2206010145_UNI-ROYAL-Uniroyal-Elec-1206W4F1002T5E_C17902.pdf | https://jlcpcb.com/partdetail/18590-1206W4F1002T5E/C17902
C17900 | basic | Chip Resistor - Surface Mount | Chip Resistor - Surface Mount | 1206W4F1003T5E | UNI-ROYAL(Uniroyal Elec) | 1206 | -55℃~+155℃ 100kΩ 200V 250mW Thick Film Resistor ±1% ±100ppm/℃ 1206 Chip Resistor - Surface Mount ROHS | 1525448 | 0.0102 | Resistance=100kΩ; Operating Temperature=-55℃~+155℃; Power(Watts)=250mW; Type=Thick Film Resistor; Voltage-Supply(Max)=200V; Tolerance=±1%; Temperature Coefficient=±100ppm/℃ | https://www.lcsc.com/datasheet/lcsc_datasheet_2206010145_UNI-ROYAL-Uniroyal-Elec-1206W4F1003T5E_C17900.pdf | https://jlcpcb.com/partdetail/18588-1206W4F1003T5E/C17900
C17927 | basic | Chip Resistor - Surface Mount | Chip Resistor - Surface Mount | 1206W4F1004T5E | UNI-ROYAL(Uniroyal Elec) | 1206 | -55℃~+155℃ 1MΩ 200V 250mW Thick Film Resistor ±1% ±100ppm/℃ 1206 Chip Resistor - Surface Mount ROHS | 4679913 | 0.0041 | Resistance=1MΩ; Operating Temperature=-55℃~+155℃; Power(Watts)=250mW; Type=Thick Film Resistor; Voltage-Supply(Max)=200V; Tolerance=±1%; Temperature Coefficient=±100ppm/℃ | https://www.lcsc.com/datasheet/lcsc_datasheet_2206010145_UNI-ROYAL-Uniroyal-Elec-1206W4F1004T5E_C17927.pdf | https://jlcpcb.com/partdetail/18615-1206W4F1004T5E/C17927
C17903 | basic | Chip Resistor - Surface Mount | Chip Resistor - Surface Mount | 1206W4F100JT5E | UNI-ROYAL(Uniroyal Elec) | 1206 | -55℃~+155℃ 10Ω 200V 250mW Thick Film Resistor ±1% ±400ppm/℃ 1206 Chip Resistor - Surface Mount ROHS | 970595 | 0.0113 | Resistance=10Ω; Operating Temperature=-55℃~+155℃; Power(Watts)=250mW; Type=Thick Film Resistor; Voltage-Supply(Max)=200V; Tolerance=±1%; Temperature Coefficient=±400ppm/℃ | https://www.lcsc.com/datasheet/lcsc_datasheet_2206010145_UNI-ROYAL-Uniroyal-Elec-1206W4F100JT5E_C17903.pdf | https://jlcpcb.com/partdetail/18591-1206W4F100JT5E/C17903
C17928 | basic | Chip Resistor - Surface Mount | Chip Resistor - Surface Mount | 1206W4F100KT5E | UNI-ROYAL(Uniroyal Elec) | 1206 | -55℃~+155℃ 1Ω 200V 250mW Thick Film Resistor ±1% ±200ppm/℃ 1206 Chip Resistor - Surface Mount ROHS | 207034 | 0.0233 | Resistance=1Ω; Operating Temperature=-55℃~+155℃; Power(Watts)=250mW; Type=Thick Film Resistor; Voltage-Supply(Max)=200V; Tolerance=±1%; Temperature Coefficient=±200ppm/℃ | https://www.lcsc.com/datasheet/lcsc_datasheet_2206010145_UNI-ROYAL-Uniroyal-Elec-1206W4F100KT5E_C17928.pdf | https://jlcpcb.com/partdetail/18616-1206W4F100KT5E/C17928
C25334 | basic | Chip Resistor - Surface Mount | Chip Resistor - Surface Mount | 1206W4F100LT5E | UNI-ROYAL(Uniroyal Elec) | 1206 | -55℃~+155℃ 100mΩ 200V 250mW Thick Film Resistor ±1% ±800ppm/℃ 1206 Chip Resistor - Surface Mount ROHS | 291501 | 0.0055 | Resistance=100mΩ; Operating Temperature=-55℃~+155℃; Power(Watts)=250mW; Type=Thick Film Resistor; Voltage-Supply(Max)=200V; Tolerance=±1%; Temperature Coefficient=±800ppm/℃ | https://www.lcsc.com/datasheet/lcsc_datasheet_2205311900_UNI-ROYAL-Uniroyal-Elec-1206W4F100LT5E_C25334.pdf | https://jlcpcb.com/partdetail/26077-1206W4F100LT5E/C25334
C17909 | basic | Chip Resistor - Surface Mount | Chip Resistor - Surface Mount | 1206W4F1200T5E | UNI-ROYAL(Uniroyal Elec) | 1206 | -55℃~+155℃ 120Ω 200V 250mW Thick Film Resistor ±1% ±100ppm/℃ 1206 Chip Resistor - Surface Mount ROHS | 593164 | 0.0068 | Resistance=120Ω; Operating Temperature=-55℃~+155℃; Power(Watts)=250mW; Type=Thick Film Resistor; Voltage-Supply(Max)=200V; Tolerance=±1%; Temperature Coefficient=±100ppm/℃ | https://www.lcsc.com/datasheet/lcsc_datasheet_2206010145_UNI-ROYAL-Uniroyal-Elec-1206W4F1200T5E_C17909.pdf | https://jlcpcb.com/partdetail/18597-1206W4F1200T5E/C17909
C17944 | basic | Chip Resistor - Surface Mount | Chip Resistor - Surface Mount | 1206W4F2001T5E | UNI-ROYAL(Uniroyal Elec) | 1206 | -55℃~+155℃ 200V 250mW 2kΩ Thick Film Resistor ±1% ±100ppm/℃ 1206 Chip Resistor - Surface Mount ROHS | 2184785 | 0.0077 | Resistance=2kΩ; Operating Temperature=-55℃~+155℃; Power(Watts)=250mW; Type=Thick Film Resistor; Voltage-Supply(Max)=200V; Tolerance=±1%; Temperature Coefficient=±100ppm/℃ | https://www.lcsc.com/datasheet/lcsc_datasheet_2206010145_UNI-ROYAL-Uniroyal-Elec-1206W4F2001T5E_C17944.pdf | https://jlcpcb.com/partdetail/18632-1206W4F2001T5E/C17944
C17955 | basic | Chip Resistor - Surface Mount | Chip Resistor - Surface Mount | 1206W4F200JT5E | UNI-ROYAL(Uniroyal Elec) | 1206 | -55℃~+155℃ 200V 20Ω 250mW Thick Film Resistor ±1% ±100ppm/℃ 1206 Chip Resistor - Surface Mount ROHS | 528789 | 0.0109 | Resistance=20Ω; Operating Temperature=-55℃~+155℃; Power(Watts)=250mW; Type=Thick Film Resistor; Voltage-Supply(Max)=200V; Tolerance=±1%; Temperature Coefficient=±100ppm/℃ | https://www.lcsc.com/datasheet/lcsc_datasheet_2206010145_UNI-ROYAL-Uniroyal-Elec-1206W4F200JT5E_C17955.pdf | https://jlcpcb.com/partdetail/18643-1206W4F200JT5E/C17955
C17958 | basic | Chip Resistor - Surface Mount | Chip Resistor - Surface Mount | 1206W4F220JT5E | UNI-ROYAL(Uniroyal Elec) | 1206 | -55℃~+155℃ 200V 22Ω 250mW Thick Film Resistor ±1% ±100ppm/℃ 1206 Chip Resistor - Surface Mount ROHS | 881152 | 0.0066 | Resistance=22Ω; Operating Temperature=-55℃~+155℃; Power(Watts)=250mW; Type=Thick Film Resistor; Voltage-Supply(Max)=200V; Tolerance=±1%; Temperature Coefficient=±100ppm/℃ | https://www.lcsc.com/datasheet/lcsc_datasheet_2206010145_UNI-ROYAL-Uniroyal-Elec-1206W4F220JT5E_C17958.pdf | https://jlcpcb.com/partdetail/18646-1206W4F220JT5E/C17958
C17887 | basic | Chip Resistor - Surface Mount | Chip Resistor - Surface Mount | 1206W4F3000T5E | UNI-ROYAL(Uniroyal Elec) | 1206 | -55℃~+155℃ 200V 250mW 300Ω Thick Film Resistor ±1% ±100ppm/℃ 1206 Chip Resistor - Surface Mount ROHS | 557389 | 0.0048 | Resistance=300Ω; Operating Temperature=-55℃~+155℃; Power(Watts)=250mW; Type=Thick Film Resistor; Voltage-Supply(Max)=200V; Tolerance=±1%; Temperature Coefficient=±100ppm/℃ | https://www.lcsc.com/datasheet/lcsc_datasheet_2206010200_UNI-ROYAL-Uniroyal-Elec-1206W4F3000T5E_C17887.pdf | https://jlcpcb.com/partdetail/18575-1206W4F3000T5E/C17887
C17936 | basic | Chip Resistor - Surface Mount | Chip Resistor - Surface Mount | 1206W4F4701T5E | UNI-ROYAL(Uniroyal Elec) | 1206 | -55℃~+155℃ 200V 250mW 4.7kΩ Thick Film Resistor ±1% ±100ppm/℃ 1206 Chip Resistor - Surface Mount ROHS | 3410973 | 0.0084 | Resistance=4.7kΩ; Operating Temperature=-55℃~+155℃; Power(Watts)=250mW; Type=Thick Film Resistor; Voltage-Supply(Max)=200V; Tolerance=±1%; Temperature Coefficient=±100ppm/℃ | https://www.lcsc.com/datasheet/lcsc_datasheet_2206010145_UNI-ROYAL-Uniroyal-Elec-1206W4F4701T5E_C17936.pdf | https://jlcpcb.com/partdetail/18624-1206W4F4701T5E/C17936
C7955 | basic | Comparators | Comparators | LM393DR2G | onsemi | SOIC-8 | -18V~-1V、1V~18V 0℃~+70℃ 1.3us 2 25nA 2V~36V 300ns 36V 400uA 5mV 5nA ESD protection TTL、CMOS SOIC-8 Comparators ROHS | 238619 | 0.066 | Operating Temperature=0℃~+70℃; Output Type=-; Vos - Input Offset Voltage=5mV; Input Offset Current(Ios)=5nA; Single Supply=2V~36V; Input Hysteresis Voltage (Vhys)=-; Response Time (tr)=1.3us; Common Mode Rejection Ratio(CMRR)=-; Rail to Rail=-; Number of Channels=2; Maximum Power Supply Range (Vdd-Vss)=36V; Quiescent Current=400uA; Features=ESD protection; Ib - Input Bias Current=25nA; Propagation Delay Time=300ns; Output Mode=TTL、CMOS; Dual Supply=-18V~-1V、1V~18V | https://www.lcsc.com/datasheet/lcsc_datasheet_1809171611_onsemi-LM393DR2G_C7955.pdf | https://jlcpcb.com/partdetail/onsemi-LM393DR2G/C7955
C32346 | basic | Crystals | Crystals | Q13FC13500004 | Seiko Epson | SMD3215-2P | -40℃~+85℃ 12.5pF 32.768kHz 70kΩ Crystal Oscillator ±20ppm SMD3215-2P Crystals ROHS | 499241 | 0.1715 | Load Capacitance=12.5pF; Operating Temperature=-40℃~+85℃; Type=SMD crystal oscillator; Normal temperature Frequency Tolerance=±20ppm; Equivalent Series Resistance(ESR)=70kΩ; Frequency=32.768kHz | https://www.lcsc.com/datasheet/lcsc_datasheet_2404180925_Seiko-Epson-Q13FC13500004_C32346.pdf | https://jlcpcb.com/partdetail/SeikoEpson-Q13FC13500004/C32346
C9002 | basic | Crystals | Crystals | X322512MSB4SI | YXC Crystal Oscillators | SMD3225-4P | -40℃~+85℃ 12MHz 20pF 80Ω Crystal Oscillator ±10ppm ±20ppm SMD3225-4P Crystals ROHS | 72070 | 0.0947 | Load Capacitance=20pF; Operating Temperature=-40℃~+85℃; Type=SMD crystal oscillator; Normal temperature Frequency Tolerance=±10ppm; Equivalent Series Resistance(ESR)=80Ω; Frequency Stability=±20ppm; Frequency=12MHz | https://www.lcsc.com/datasheet/lcsc_datasheet_2403291504_YXC-Crystal-Oscillators-X322512MSB4SI_C9002.pdf | https://jlcpcb.com/partdetail/YXC_CrystalOscillators-X322512MSB4SI/C9002
C13738 | basic | Crystals | Crystals | X322516MLB4SI | YXC Crystal Oscillators | SMD3225-4P | -40℃~+85℃ 16MHz 50Ω 9pF Crystal Oscillator ±10ppm ±20ppm SMD3225-4P Crystals ROHS | 132832 | 0.0928 | Load Capacitance=9pF; Operating Temperature=-40℃~+85℃; Type=SMD crystal oscillator; Normal temperature Frequency Tolerance=±10ppm; Equivalent Series Resistance(ESR)=50Ω; Frequency Stability=±20ppm; Frequency=16MHz | https://www.lcsc.com/datasheet/lcsc_datasheet_2403291504_YXC-Crystal-Oscillators-X322516MLB4SI_C13738.pdf | https://jlcpcb.com/partdetail/YXC_CrystalOscillators-X322516MLB4SI/C13738
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
