cpldcpu/TouchSynth/parts/jlcpcb_promotional_extended_parts.csv

lcsc | library | category | subcategory | mfr_part | brand | package | description | stock | price_usd | attributes | datasheet | url
C7593 | promotional_extended | 555 Timers / Counters | 555 Timers / Counters | NE555DR | Texas Instruments | SOIC-8 | 0℃~+70℃ 10mA 4.5V~16V SOIC-8 555 Timers / Counters ROHS | 242430 | 0.1202 | Operating Temperature=0℃~+70℃; Timer Number=1; Voltage - Supply=4.5V~16V; Supply Current=2mA; Output Current=200mA; Features=Adjustable duty cycle oscillation、Reset function | https://www.lcsc.com/datasheet/lcsc_datasheet_1811012330_Texas-Instruments-NE555DR_C7593.pdf | https://jlcpcb.com/partdetail/TexasInstruments-NE555DR/C7593
C24112 | promotional_extended | Accelerometers | Accelerometers | MPU-6050 | TDK InvenSense | QFN-24-EP(4x4) | -40℃~+85℃ 16bit 1KB 2.375V~3.46V 5uA Accelerometer Gyroscope I2C X,Y,Z X,Y,Z ±16g ±2000dps QFN-24-EP(4x4) Accelerometers ROHS | 7630 | 19.9988 | Operating Temperature=-40℃~+85℃; Gyroscope Measurement Range (MAX)=±2000dps; Output Bits=16bit; Standby Current=5uA; Sensor Type=IMU (accelerometer + gyroscope); Voltage - Supply=2.375V~3.46V; Acceleration Measurement Range (MAX)=±16g; Cache Size=1KB; Features=Motion event detection、Synchronization and timestamp; Gyroscope Sensing Axis=X,Y,Z; Accelerometer Sensing Axis=X,Y,Z; Interface=I2C | https://www.lcsc.com/datasheet/lcsc_datasheet_1811071024_TDK-InvenSense-MPU-6050_C24112.pdf | https://jlcpcb.com/partdetail/TDKInvenSense-MPU6050/C24112
C21379 | promotional_extended | Analog Switches, Multiplexers | Analog Switches, Multiplexers | CD4051BM96 | Texas Instruments | SOIC-16-150mil | -55℃~+125℃ 1 125Ω 20MHz 30pF 3V~20V 60ns 8:1 SOIC-16-150mil Analog Switches, Multiplexers ROHS | 138315 | 0.2574 | Ron=125Ω; Operating Temperature=-55℃~+125℃; Con=30pF; Number of Channels=1; Switch Circuit=8:1; Voltage - Supply=3V~20V; Propagation Delay (tpd)=60ns; Bandwidth=20MHz; Features=Bidirectional analog channel、Level shifting、Glitch-free switching; Turn-off time=-; Turn-on time=- | https://www.lcsc.com/datasheet/lcsc_datasheet_1809261612_Texas-Instruments-CD4051BM96_C21379.pdf | https://jlcpcb.com/partdetail/TexasInstruments-CD4051BM96/C21379
C6521 | promotional_extended | Analog Switches, Multiplexers | Analog Switches, Multiplexers | CD4052BM96 | Texas Instruments | SOIC-16 | -55℃~+125℃ 125Ω 18pF 2 25MHz 320ns 3V~20V 4:1 SOIC-16 Analog Switches, Multiplexers ROHS | 107986 | 0.2781 | Ron=125Ω; Operating Temperature=-55℃~+125℃; Con=18pF; Number of Channels=2; Switch Circuit=4:1; Voltage - Supply=3V~20V; Bandwidth=25MHz; Propagation Delay (tpd)=320ns; Features=Bidirectional analog channel、Glitch-free switching; Turn-off time=-; Turn-on time=- | https://www.lcsc.com/datasheet/lcsc_datasheet_2304140030_Texas-Instruments-CD4052BM96_C6521.pdf | https://jlcpcb.com/partdetail/TexasInstruments-CD4052BM96/C6521
C32574 | promotional_extended | Battery Management | Battery Management | TP4054-42-SOT25R | TOPPOWER(Nanjing Extension Microelectronics) | SOT-23-5 | -40℃~+85℃ 1 4.2V 450mA 45uA 4V~9V Charging IC Lithium Battery Not supported Not supported SOT-23-5 Battery Management ROHS | 28572 | 0.1326 | Charging Saturation Voltage=4.2V; Supply Current (Iq)=45uA; Operating Temperature=-40℃~+85℃; Type of Battery=Lithium Battery; Charge Current - Max=450mA; Number of Cells=1; Battery Temperature Detection=Not supported; The Chip Type=Charging IC; Balance Current=-; Voltage - Supply=4V~9V; End-Off Voltage=-; Features=Constant current charging、Constant voltage charging、Trickle charging、Automatic recharge、Charge termination、Programmable charging current、Soft-start、Under-voltage lockout; Interface=-; 0V Battery Charge=Not supported | https://www.lcsc.com/datasheet/lcsc_datasheet_1809261814_TOPPOWER-Nanjing-Extension-Microelectronics-TP4054-42-SOT25R_C32574.pdf | https://jlcpcb.com/partdetail/33539-TP4054_42SOT25R/C32574
C16581 | promotional_extended | Battery Management | Battery Management | TP4056-42-ESOP8 | TOPPOWER(Nanjing Extension Microelectronics) | ESOP-8 | -40℃~+85℃ 1 1A 2uA 4.2V 4V~8V Charging IC Lithium Battery Support ESOP-8 Battery Management ROHS | 87550 | 0.1842 | Charging Saturation Voltage=4.2V; Supply Current (Iq)=2uA; Operating Temperature=-40℃~+85℃; Type of Battery=Lithium Battery; Charge Current - Max=1A; Number of Cells=1; Battery Temperature Detection=Support; The Chip Type=Charging IC; Balance Current=-; Voltage - Supply=4V~8V; End-Off Voltage=-; Features=Constant current charging、Constant voltage charging、Trickle charging、Automatic recharge、Charge termination、Programmable charging current、Soft-start、Under-voltage lockout; Interface=-; 0V Battery Charge=- | https://www.lcsc.com/datasheet/lcsc_datasheet_1809261820_TOPPOWER-Nanjing-Extension-Microelectronics-TP4056-42-ESOP8_C16581.pdf | https://jlcpcb.com/partdetail/17264-TP4056_42ESOP8/C16581
C12044 | promotional_extended | Battery Management | Battery Management | TP4057-42-SOT26-R | TOPPOWER(Nanjing Extension Microelectronics) | SOT-23-6 | -40℃~+85℃ 1 4.2V 40uA 4V~9V 500mA Charging IC Lithium Battery Not supported Not supported SOT-23-6 Battery Management ROHS | 33443 | 0.1408 | Charging Saturation Voltage=4.2V; Supply Current (Iq)=40uA; Operating Temperature=-40℃~+85℃; Type of Battery=Lithium Battery; Charge Current - Max=500mA; Number of Cells=1; Battery Temperature Detection=Not supported; The Chip Type=Charging IC; Balance Current=-; Voltage - Supply=4V~9V; End-Off Voltage=-; Features=Constant current charging、Constant voltage charging、Trickle charging、Automatic recharge、Charge termination、Programmable charging current、Soft-start、Under-voltage lockout; Interface=-; 0V Battery Charge=Not supported | https://www.lcsc.com/datasheet/lcsc_datasheet_1811021622_TOPPOWER-Nanjing-Extension-Microelectronics-TP4057-42-SOT26-R_C12044.pdf | https://jlcpcb.com/partdetail/12599-TP4057_42_SOT26R/C12044
C41375139 | promotional_extended | Bipolar (BJT) | Bipolar (BJT) | 2SA1013 | hongjiacheng | SOT-89 | -55℃~+150℃ 1 PNP 1.5V 15MHz 160V 1A 1uA 320 500mW 6V PNP Standalone SOT-89 Bipolar (BJT) ROHS | 55063 | 0.0832 | Operating Temperature=-55℃~+150℃; Transition frequency(fT)=15MHz; Collector - Emitter Voltage VCEO=160V; Configuration=Standalone; Number=1 PNP; DC Current Gain=320; Current - Collector(Ic)=1A; Vce Saturation(VCE(sat))=1.5V; Emitter-Base Voltage(Vebo)=6V; Pd - Power Dissipation=500mW; type=PNP; Current - Collector Cutoff=1uA | https://www.lcsc.com/datasheet/lcsc_datasheet_2408301021_hongjiacheng-2SA1013_C41375139.pdf | https://jlcpcb.com/partdetail/hongjiacheng-2SA1013/C41375139
C41375121 | promotional_extended | Bipolar (BJT) | Bipolar (BJT) | 2SA1201 | hongjiacheng | SOT-89 | 1 PNP 100nA 120MHz 120V 1V 240 500mW 5V 800mA PNP SOT-89 Bipolar (BJT) ROHS | 1429 | 0.0908 | Operating Temperature=-; Transition frequency(fT)=120MHz; Collector - Emitter Voltage VCEO=120V; Number=1 PNP; Configuration=-; DC Current Gain=240; Current - Collector(Ic)=800mA; Vce Saturation(VCE(sat))=1V; Emitter-Base Voltage(Vebo)=5V; Pd - Power Dissipation=500mW; type=PNP; Current - Collector Cutoff=100nA | https://www.lcsc.com/datasheet/lcsc_datasheet_2411041735_hongjiacheng-2SA1201_C41375121.pdf | https://jlcpcb.com/partdetail/hongjiacheng-2SA1201/C41375121
C20069144 | promotional_extended | Bipolar (BJT) | Bipolar (BJT) | 2SA1213 | hongjiacheng | SOT-89 | -55℃~+150℃ 1 PNP 100nA 120MHz 2A 500mV 500mW 50V 5V 70 PNP SOT-89 Bipolar (BJT) ROHS | 43410 | 0.0814 | Operating Temperature=-55℃~+150℃; Transition frequency(fT)=120MHz; Collector - Emitter Voltage VCEO=50V; Number=1 PNP; Configuration=-; DC Current Gain=70; Current - Collector(Ic)=2A; Vce Saturation(VCE(sat))=500mV; Emitter-Base Voltage(Vebo)=5V; Pd - Power Dissipation=500mW; type=PNP; Current - Collector Cutoff=100nA | https://wmsc.lcsc.com/wmsc/upload/file/pdf/v2/lcsc/2402281642_hongjiacheng-2SA1213_C20069144.pdf | https://jlcpcb.com/partdetail/hongjiacheng-2SA1213/C20069144
C7420323 | promotional_extended | Bipolar (BJT) | Bipolar (BJT) | 2SA812 | hongjiacheng | SOT-23 | -55℃~+150℃ 1 PNP 100mA 100nA 180MHz 200mW 300mV 50V 5V 90 PNP SOT-23 Bipolar (BJT) ROHS | 20656 | 0.0126 | Operating Temperature=-55℃~+150℃; Transition frequency(fT)=180MHz; Collector - Emitter Voltage VCEO=50V; Number=1 PNP; Configuration=-; DC Current Gain=90; Current - Collector(Ic)=100mA; Vce Saturation(VCE(sat))=300mV; Emitter-Base Voltage(Vebo)=5V; type=PNP; Pd - Power Dissipation=200mW; Current - Collector Cutoff=100nA | https://wmsc.lcsc.com/wmsc/upload/file/pdf/v2/lcsc/2312221203_hongjiacheng-2SA812_C7420323.pdf | https://jlcpcb.com/partdetail/hongjiacheng-2SA812/C7420323
C7420324 | promotional_extended | Bipolar (BJT) | Bipolar (BJT) | 2SC1623 | hongjiacheng | SOT-23 | -55℃~+150℃ 1 NPN 100mA 100nA 135 200mW 250MHz 300mV 50V 5V NPN Standalone SOT-23 Bipolar (BJT) ROHS | 425438 | 0.0117 | Operating Temperature=-55℃~+150℃; Transition frequency(fT)=250MHz; Collector - Emitter Voltage VCEO=50V; Configuration=Standalone; Number=1 NPN; DC Current Gain=135; Current - Collector(Ic)=100mA; Vce Saturation(VCE(sat))=300mV; Emitter-Base Voltage(Vebo)=5V; Pd - Power Dissipation=200mW; type=NPN; Current - Collector Cutoff=100nA | https://wmsc.lcsc.com/wmsc/upload/file/pdf/v2/lcsc/2312221203_hongjiacheng-2SC1623_C7420324.pdf | https://jlcpcb.com/partdetail/hongjiacheng-2SC1623/C7420324
C20069143 | promotional_extended | Bipolar (BJT) | Bipolar (BJT) | 2SC1815 | hongjiacheng | SOT-23 | -55℃~+150℃ 1 NPN 100nA 130 150mA 200mW 250mV 50V 5V 80MHz NPN SOT-23 Bipolar (BJT) ROHS | 289176 | 0.0087 | Operating Temperature=-55℃~+150℃; Transition frequency(fT)=80MHz; Collector - Emitter Voltage VCEO=50V; Configuration=Standalone; Number=1 NPN; DC Current Gain=130; Current - Collector(Ic)=150mA; Vce Saturation(VCE(sat))=250mV; Emitter-Base Voltage(Vebo)=5V; type=NPN; Pd - Power Dissipation=200mW; Current - Collector Cutoff=100nA | https://wmsc.lcsc.com/wmsc/upload/file/pdf/v2/lcsc/2401111808_hongjiacheng-2SC1815_C20069143.pdf | https://jlcpcb.com/partdetail/hongjiacheng-2SC1815/C20069143
C41375131 | promotional_extended | Bipolar (BJT) | Bipolar (BJT) | 2SC2412 | hongjiacheng | SOT-23 | -55℃~+150℃ 1 NPN 100nA 150mA 180MHz 200mW 400mV 50V 560 7V NPN Standalone SOT-23 Bipolar (BJT) ROHS | 52718 | 0.0139 | Operating Temperature=-55℃~+150℃; Transition frequency(fT)=180MHz; Collector - Emitter Voltage VCEO=50V; Configuration=Standalone; Number=1 NPN; DC Current Gain=560; Current - Collector(Ic)=150mA; Vce Saturation(VCE(sat))=400mV; Emitter-Base Voltage(Vebo)=7V; type=NPN; Pd - Power Dissipation=200mW; Current - Collector Cutoff=100nA | https://www.lcsc.com/datasheet/lcsc_datasheet_2408301021_hongjiacheng-2SC2412_C41375131.pdf | https://jlcpcb.com/partdetail/hongjiacheng-2SC2412/C41375131
C20069145 | promotional_extended | Bipolar (BJT) | Bipolar (BJT) | 2SC2873 | hongjiacheng | SOT-89 | -55℃~+150℃ 1 NPN 100nA 120MHz 2A 500mV 500mW 50V 5V 70 NPN SOT-89 Bipolar (BJT) ROHS | 1017 | 0.0736 | Operating Temperature=-55℃~+150℃; Transition frequency(fT)=120MHz; Collector - Emitter Voltage VCEO=50V; Configuration=Standalone; Number=1 NPN; DC Current Gain=70; Current - Collector(Ic)=2A; Vce Saturation(VCE(sat))=500mV; Emitter-Base Voltage(Vebo)=5V; type=NPN; Pd - Power Dissipation=500mW; Current - Collector Cutoff=100nA | https://wmsc.lcsc.com/wmsc/upload/file/pdf/v2/lcsc/2402281642_hongjiacheng-2SC2873_C20069145.pdf | https://jlcpcb.com/partdetail/hongjiacheng-2SC2873/C20069145
C28646276 | promotional_extended | Bipolar (BJT) | Bipolar (BJT) | 2SC2884 | hongjiacheng | SOT-89 | 1 NPN 100nA 120MHz 30V 320 500mV 500mW 5V 800mA NPN Standalone SOT-89 Bipolar (BJT) ROHS | 3556 | 0.0371 | Operating Temperature=-; Transition frequency(fT)=120MHz; Collector - Emitter Voltage VCEO=30V; Configuration=Standalone; Number=1 NPN; DC Current Gain=320; Current - Collector(Ic)=800mA; Vce Saturation(VCE(sat))=500mV; Emitter-Base Voltage(Vebo)=5V; type=NPN; Pd - Power Dissipation=500mW; Current - Collector Cutoff=100nA | https://wmsc.lcsc.com/wmsc/upload/file/pdf/v2/lcsc/2407121630_hongjiacheng-2SC2884_C28646276.pdf | https://jlcpcb.com/partdetail/hongjiacheng-2SC2884/C28646276
C28646266 | promotional_extended | Bipolar (BJT) | Bipolar (BJT) | 2SC3356 | hongjiacheng | SOT-23 | -55℃~+150℃ 1 NPN 100mA 12V 1uA 200mW 250 300mV 3V 7GHz NPN Standalone SOT-23 Bipolar (BJT) ROHS | 22191 | 0.0338 | Operating Temperature=-55℃~+150℃; Transition frequency(fT)=7GHz; Collector - Emitter Voltage VCEO=12V; Configuration=Standalone; Number=1 NPN; DC Current Gain=250; Current - Collector(Ic)=100mA; Vce Saturation(VCE(sat))=300mV; Emitter-Base Voltage(Vebo)=3V; type=NPN; Pd - Power Dissipation=200mW; Current - Collector Cutoff=1uA | https://wmsc.lcsc.com/wmsc/upload/file/pdf/v2/lcsc/2407121631_hongjiacheng-2SC3356_C28646266.pdf | https://jlcpcb.com/partdetail/hongjiacheng-2SC3356/C28646266
C28646267 | promotional_extended | Bipolar (BJT) | Bipolar (BJT) | 2SC4672 | hongjiacheng | SOT-89 | -55℃~+150℃ 1 NPN 100nA 210MHz 2A 350mV 390 500mW 50V 6V NPN Standalone SOT-89 Bipolar (BJT) ROHS | 10728 | 0.0722 | Operating Temperature=-55℃~+150℃; Transition frequency(fT)=210MHz; Collector - Emitter Voltage VCEO=50V; Configuration=Standalone; Number=1 NPN; DC Current Gain=390; Current - Collector(Ic)=2A; Vce Saturation(VCE(sat))=350mV; Emitter-Base Voltage(Vebo)=6V; type=NPN; Pd - Power Dissipation=500mW; Current - Collector Cutoff=100nA | https://wmsc.lcsc.com/wmsc/upload/file/pdf/v2/lcsc/2407121629_hongjiacheng-2SC4672_C28646267.pdf | https://jlcpcb.com/partdetail/hongjiacheng-2SC4672/C28646267
C41375119 | promotional_extended | Bipolar (BJT) | Bipolar (BJT) | 2SD1664 | hongjiacheng | SOT-89 | -55℃~+155℃ 0.5mW 1 NPN 120MHz 1A 32V 390 400mV 500nA 5V NPN Standalone SOT-89 Bipolar (BJT) ROHS | 5179 | 0.048 | Operating Temperature=-55℃~+155℃; Transition frequency(fT)=120MHz; Collector - Emitter Voltage VCEO=32V; Configuration=Standalone; Number=1 NPN; DC Current Gain=390; Current - Collector(Ic)=1A; Vce Saturation(VCE(sat))=400mV; Emitter-Base Voltage(Vebo)=5V; Pd - Power Dissipation=0.5mW; type=NPN; Current - Collector Cutoff=500nA | https://www.lcsc.com/datasheet/lcsc_datasheet_2411041735_hongjiacheng-2SD1664_C41375119.pdf | https://jlcpcb.com/partdetail/hongjiacheng-2SD1664/C41375119
C41375118 | promotional_extended | Bipolar (BJT) | Bipolar (BJT) | 2SD1898 | hongjiacheng | SOT-89 | -55℃~+155℃ 1 NPN 100MHz 1A 1uA 390 400mV 500mW 5V 80V NPN Standalone SOT-89 Bipolar (BJT) ROHS | 9136 | 0.047 | Operating Temperature=-55℃~+155℃; Transition frequency(fT)=100MHz; Collector - Emitter Voltage VCEO=80V; Configuration=Standalone; Number=1 NPN; DC Current Gain=390; Current - Collector(Ic)=1A; Vce Saturation(VCE(sat))=400mV; Emitter-Base Voltage(Vebo)=5V; type=NPN; Pd - Power Dissipation=500mW; Current - Collector Cutoff=1uA | https://www.lcsc.com/datasheet/lcsc_datasheet_2501071555_hongjiacheng-2SD1898_C41375118.pdf | https://jlcpcb.com/partdetail/hongjiacheng-2SD1898/C41375118
C41375127 | promotional_extended | Bipolar (BJT) | Bipolar (BJT) | 2SD2391 | hongjiacheng | SOT-89 | -55℃~+155℃ 1 NPN 100nA 210MHz 2A 350mV 390 500mW 60V 6V NPN Standalone SOT-89 Bipolar (BJT) ROHS | 1804 | 0.0561 | Operating Temperature=-55℃~+155℃; Transition frequency(fT)=210MHz; Collector - Emitter Voltage VCEO=60V; Configuration=Standalone; Number=1 NPN; DC Current Gain=390; Current - Collector(Ic)=2A; Vce Saturation(VCE(sat))=350mV; Emitter-Base Voltage(Vebo)=6V; type=NPN; Pd - Power Dissipation=500mW; Current - Collector Cutoff=100nA | https://www.lcsc.com/datasheet/lcsc_datasheet_2411041735_hongjiacheng-2SD2391_C41375127.pdf | https://jlcpcb.com/partdetail/hongjiacheng-2SD2391/C41375127
C41375140 | promotional_extended | Bipolar (BJT) | Bipolar (BJT) | 2SD965A | hongjiacheng | SOT-89 | -55℃~+150℃ 1 NPN 100nA 150MHz 1V 30V 5A 750mW 7V 800 NPN SOT-89 Bipolar (BJT) ROHS | 14150 | 0.1045 | Operating Temperature=-55℃~+150℃; Transition frequency(fT)=150MHz; Collector - Emitter Voltage VCEO=30V; Number=1 NPN; Configuration=-; DC Current Gain=800; Current - Collector(Ic)=5A; Vce Saturation(VCE(sat))=1V; Emitter-Base Voltage(Vebo)=7V; type=NPN; Pd - Power Dissipation=750mW; Current - Collector Cutoff=100nA | https://www.lcsc.com/datasheet/lcsc_datasheet_2411041735_hongjiacheng-2SD965A_C41375140.pdf | https://jlcpcb.com/partdetail/hongjiacheng-2SD965A/C41375140
C41375129 | promotional_extended | Bipolar (BJT) | Bipolar (BJT) | A1015 | hongjiacheng | SOT-23 | -55℃~+150℃ 1 PNP 100nA 150mA 200mW 300mV 400 50V 5V 80MHz PNP SOT-23 Bipolar (BJT) ROHS | 69943 | 0.0133 | Operating Temperature=-55℃~+150℃; Transition frequency(fT)=80MHz; Collector - Emitter Voltage VCEO=50V; Number=1 PNP; Configuration=-; DC Current Gain=400; Current - Collector(Ic)=150mA; Vce Saturation(VCE(sat))=300mV; Emitter-Base Voltage(Vebo)=5V; Pd - Power Dissipation=200mW; type=PNP; Current - Collector Cutoff=100nA | https://www.lcsc.com/datasheet/lcsc_datasheet_2408301021_hongjiacheng-A1015_C41375129.pdf | https://jlcpcb.com/partdetail/hongjiacheng-A1015/C41375129
C41375134 | promotional_extended | Bipolar (BJT) | Bipolar (BJT) | B772 | hongjiacheng | SOT-89 | 1 PNP 100nA 30V 3A 400 500mV 500mW 6V 80MHz PNP Standalone SOT-89 Bipolar (BJT) ROHS | 32244 | 0.0639 | Operating Temperature=-; Transition frequency(fT)=80MHz; Collector - Emitter Voltage VCEO=30V; Configuration=Standalone; Number=1 PNP; DC Current Gain=400; Current - Collector(Ic)=3A; Vce Saturation(VCE(sat))=500mV; Emitter-Base Voltage(Vebo)=6V; Pd - Power Dissipation=500mW; type=PNP; Current - Collector Cutoff=100nA | https://www.lcsc.com/datasheet/lcsc_datasheet_2411041735_hongjiacheng-B772_C41375134.pdf | https://jlcpcb.com/partdetail/hongjiacheng-B772/C41375134
C24278 | promotional_extended | Bipolar (BJT) | Bipolar (BJT) | B772(RANGE:160-320) | Jiangsu Changjing Electronics Technology Co., Ltd. | SOT-89-3L | -55℃~+150℃ 1 PNP 160 1uA 30V 3A 500mV 500mW 50MHz 6V PNP SOT-89-3L Bipolar (BJT) ROHS | 127700 | 0.0674 | Operating Temperature=-55℃~+150℃; Transition frequency(fT)=50MHz; Collector - Emitter Voltage VCEO=30V; Number=1 PNP; DC Current Gain=160; Current - Collector(Ic)=3A; Vce Saturation(VCE(sat))=500mV; Emitter-Base Voltage(Vebo)=6V; Pd - Power Dissipation=500mW; type=PNP; Current - Collector Cutoff=1uA | https://www.lcsc.com/datasheet/lcsc_datasheet_1809211023_Jiangsu-Changjing-Electronics-Technology-Co---Ltd--B772-RANGE-160-320_C24278.pdf | https://jlcpcb.com/partdetail/25018-B772_RANGE_160_320/C24278
C41375133 | promotional_extended | Bipolar (BJT) | Bipolar (BJT) | BC807-16 | hongjiacheng | SOT-23 | -55℃~+150℃ 1 PNP 100MHz 100nA 250 300mW 45V 500mA 5V 700mV PNP SOT-23 Bipolar (BJT) ROHS | 15734 | 0.0197 | Operating Temperature=-55℃~+150℃; Transition frequency(fT)=100MHz; Collector - Emitter Voltage VCEO=45V; Number=1 PNP; Configuration=-; DC Current Gain=250; Current - Collector(Ic)=500mA; Vce Saturation(VCE(sat))=700mV; Emitter-Base Voltage(Vebo)=5V; type=PNP; Pd - Power Dissipation=300mW; Current - Collector Cutoff=100nA | https://www.lcsc.com/datasheet/lcsc_datasheet_2409051048_hongjiacheng-BC807-16_C41375133.pdf | https://jlcpcb.com/partdetail/hongjiacheng-BC80716/C41375133
C20069142 | promotional_extended | Bipolar (BJT) | Bipolar (BJT) | BC807-40 | hongjiacheng | SOT-23 | -55℃~+150℃ 1 PNP 100MHz 100nA 300mW 40 45V 500mA 5V 700mV PNP SOT-23 Bipolar (BJT) ROHS | 144543 | 0.021 | Operating Temperature=-55℃~+150℃; Transition frequency(fT)=100MHz; Collector - Emitter Voltage VCEO=45V; Number=1 PNP; Configuration=-; DC Current Gain=40; Current - Collector(Ic)=500mA; Vce Saturation(VCE(sat))=700mV; Emitter-Base Voltage(Vebo)=5V; type=PNP; Pd - Power Dissipation=300mW; Current - Collector Cutoff=100nA | https://wmsc.lcsc.com/wmsc/upload/file/pdf/v2/lcsc/2312291746_hongjiacheng-BC807-40_C20069142.pdf | https://jlcpcb.com/partdetail/hongjiacheng-BC80740/C20069142
C20069132 | promotional_extended | Bipolar (BJT) | Bipolar (BJT) | BC817-16 | hongjiacheng | SOT-23 | -55℃~+150℃ 1 NPN 100 100MHz 100nA 300mW 45V 500mA 5V 700mV NPN SOT-23 Bipolar (BJT) ROHS | 87329 | 0.0207 | Operating Temperature=-55℃~+150℃; Transition frequency(fT)=100MHz; Collector - Emitter Voltage VCEO=45V; Configuration=Standalone; Number=1 NPN; DC Current Gain=100; Current - Collector(Ic)=500mA; Vce Saturation(VCE(sat))=700mV; Emitter-Base Voltage(Vebo)=5V; type=NPN; Pd - Power Dissipation=300mW; Current - Collector Cutoff=100nA | https://wmsc.lcsc.com/wmsc/upload/file/pdf/v2/lcsc/2312291746_hongjiacheng-BC817-16_C20069132.pdf | https://jlcpcb.com/partdetail/hongjiacheng-BC81716/C20069132
C20069154 | promotional_extended | Bipolar (BJT) | Bipolar (BJT) | BC817-25 | hongjiacheng | SOT-23 | -55℃~+150℃ 1 NPN 100 100MHz 100nA 300mW 45V 500mA 5V 700mV NPN SOT-23 Bipolar (BJT) ROHS | 21955 | 0.0215 | Operating Temperature=-55℃~+150℃; Transition frequency(fT)=100MHz; Collector - Emitter Voltage VCEO=45V; Configuration=Standalone; Number=1 NPN; DC Current Gain=100; Current - Collector(Ic)=500mA; Vce Saturation(VCE(sat))=700mV; Emitter-Base Voltage(Vebo)=5V; type=NPN; Pd - Power Dissipation=300mW; Current - Collector Cutoff=100nA | https://wmsc.lcsc.com/wmsc/upload/file/pdf/v2/lcsc/2404060130_hongjiacheng-BC817-25_C20069154.pdf | https://jlcpcb.com/partdetail/hongjiacheng-BC81725/C20069154
C20069155 | promotional_extended | Bipolar (BJT) | Bipolar (BJT) | BC817-40 | hongjiacheng | SOT-23 | -55℃~+150℃ 1 NPN 100 100MHz 100nA 300mW 45V 500mA 5V 700mV NPN SOT-23 Bipolar (BJT) ROHS | 378615 | 0.0192 | Operating Temperature=-55℃~+150℃; Transition frequency(fT)=100MHz; Collector - Emitter Voltage VCEO=45V; Configuration=Standalone; Number=1 NPN; DC Current Gain=100; Current - Collector(Ic)=500mA; Vce Saturation(VCE(sat))=700mV; Emitter-Base Voltage(Vebo)=5V; type=NPN; Pd - Power Dissipation=300mW; Current - Collector Cutoff=100nA | https://wmsc.lcsc.com/wmsc/upload/file/pdf/v2/lcsc/2404060130_hongjiacheng-BC817-40_C20069155.pdf | https://jlcpcb.com/partdetail/hongjiacheng-BC81740/C20069155
C20069134 | promotional_extended | Bipolar (BJT) | Bipolar (BJT) | BC846B | hongjiacheng | SOT-23 | -55℃~+150℃ 1 NPN 100MHz 100mA 100nA 200 200mW 500mV 65V 6V NPN SOT-23 Bipolar (BJT) ROHS | 487218 | 0.0127 | Operating Temperature=-55℃~+150℃; Transition frequency(fT)=100MHz; Collector - Emitter Voltage VCEO=65V; Number=1 NPN; Configuration=-; DC Current Gain=200; Current - Collector(Ic)=100mA; Vce Saturation(VCE(sat))=500mV; Emitter-Base Voltage(Vebo)=6V; type=NPN; Pd - Power Dissipation=200mW; Current - Collector Cutoff=100nA | https://wmsc.lcsc.com/wmsc/upload/file/pdf/v2/lcsc/2312291746_hongjiacheng-BC846B_C20069134.pdf | https://jlcpcb.com/partdetail/hongjiacheng-BC846B/C20069134
C20069135 | promotional_extended | Bipolar (BJT) | Bipolar (BJT) | BC847B | hongjiacheng | SOT-23 | -55℃~+150℃ 1 NPN 100MHz 100mA 100nA 200 200mW 45V 500mV 6V NPN SOT-23 Bipolar (BJT) ROHS | 128001 | 0.0132 | Operating Temperature=-55℃~+150℃; Transition frequency(fT)=100MHz; Collector - Emitter Voltage VCEO=45V; Configuration=Standalone; Number=1 NPN; DC Current Gain=200; Current - Collector(Ic)=100mA; Vce Saturation(VCE(sat))=500mV; Emitter-Base Voltage(Vebo)=6V; type=NPN; Pd - Power Dissipation=200mW; Current - Collector Cutoff=100nA | https://wmsc.lcsc.com/wmsc/upload/file/pdf/v2/lcsc/2404081910_hongjiacheng-BC847B_C20069135.pdf | https://jlcpcb.com/partdetail/hongjiacheng-BC847B/C20069135
C41375126 | promotional_extended | Bipolar (BJT) | Bipolar (BJT) | BC847BS | hongjiacheng | SOT-363 | -55℃~+150℃ 100MHz 100mA 100nA 2 NPN 200mW 45V 500mV 6V 800 NPN Standalone SOT-363 Bipolar (BJT) ROHS | 2039 | 0.0281 | Operating Temperature=-55℃~+150℃; Transition frequency(fT)=100MHz; Collector - Emitter Voltage VCEO=45V; Configuration=Standalone; Number=2 NPN; DC Current Gain=800; Current - Collector(Ic)=100mA; Vce Saturation(VCE(sat))=500mV; Emitter-Base Voltage(Vebo)=6V; type=NPN; Pd - Power Dissipation=200mW; Current - Collector Cutoff=100nA | https://www.lcsc.com/datasheet/lcsc_datasheet_2409041457_hongjiacheng-BC847BS_C41375126.pdf | https://jlcpcb.com/partdetail/hongjiacheng-BC847BS/C41375126
C7420337 | promotional_extended | Bipolar (BJT) | Bipolar (BJT) | BC847C | hongjiacheng | SOT-23 | -55℃~+150℃ 1 NPN 100MHz 100mA 100nA 200mW 420 45V 500mV 6V NPN SOT-23 Bipolar (BJT) ROHS | 460879 | 0.0126 | Operating Temperature=-55℃~+150℃; Transition frequency(fT)=100MHz; Collector - Emitter Voltage VCEO=45V; Number=1 NPN; Configuration=-; DC Current Gain=420; Current - Collector(Ic)=100mA; Vce Saturation(VCE(sat))=500mV; Emitter-Base Voltage(Vebo)=6V; Pd - Power Dissipation=200mW; type=NPN; Current - Collector Cutoff=100nA | https://wmsc.lcsc.com/wmsc/upload/file/pdf/v2/lcsc/2312221203_hongjiacheng-BC847C_C7420337.pdf | https://jlcpcb.com/partdetail/hongjiacheng-BC847C/C7420337
C20069136 | promotional_extended | Bipolar (BJT) | Bipolar (BJT) | BC856B | hongjiacheng | SOT-23 | -55℃~+150℃ 1 PNP 100MHz 100mA 100nA 200mW 220 500mV 5V 65V PNP SOT-23 Bipolar (BJT) ROHS | 396486 | 0.0129 | Operating Temperature=-55℃~+150℃; Transition frequency(fT)=100MHz; Collector - Emitter Voltage VCEO=65V; Number=1 PNP; Configuration=-; DC Current Gain=220; Current - Collector(Ic)=100mA; Vce Saturation(VCE(sat))=500mV; Emitter-Base Voltage(Vebo)=5V; Pd - Power Dissipation=200mW; type=PNP; Current - Collector Cutoff=100nA | https://wmsc.lcsc.com/wmsc/upload/file/pdf/v2/lcsc/2312291746_hongjiacheng-BC856B_C20069136.pdf | https://jlcpcb.com/partdetail/hongjiacheng-BC856B/C20069136
C20069137 | promotional_extended | Bipolar (BJT) | Bipolar (BJT) | BC857C | hongjiacheng | SOT-23 | -55℃~+150℃ 1 PNP 100MHz 100mA 100nA 200mW 420 45V 500mV 5V PNP SOT-23 Bipolar (BJT) ROHS | 67882 | 0.014 | Operating Temperature=-55℃~+150℃; Transition frequency(fT)=100MHz; Collector - Emitter Voltage VCEO=45V; Number=1 PNP; Configuration=-; DC Current Gain=420; Current - Collector(Ic)=100mA; Vce Saturation(VCE(sat))=500mV; Emitter-Base Voltage(Vebo)=5V; Pd - Power Dissipation=200mW; type=PNP; Current - Collector Cutoff=100nA | https://wmsc.lcsc.com/wmsc/upload/file/pdf/v2/lcsc/2404082300_hongjiacheng-BC857C_C20069137.pdf | https://jlcpcb.com/partdetail/hongjiacheng-BC857C/C20069137
C41375111 | promotional_extended | Bipolar (BJT) | Bipolar (BJT) | BCP51-16 | hongjiacheng | SOT-223 | 1 PNP 1.5W 100MHz 100nA 1A 250 45V 500mV 5V PNP SOT-223 Bipolar (BJT) ROHS | 40 | 0.0741 | Operating Temperature=-; Transition frequency(fT)=100MHz; Collector - Emitter Voltage VCEO=45V; Number=1 PNP; Configuration=-; DC Current Gain=250; Current - Collector(Ic)=1A; Vce Saturation(VCE(sat))=500mV; Emitter-Base Voltage(Vebo)=5V; type=PNP; Pd - Power Dissipation=1.5W; Current - Collector Cutoff=100nA | https://www.lcsc.com/datasheet/lcsc_datasheet_2409041457_hongjiacheng-BCP51-16_C41375111.pdf | https://jlcpcb.com/partdetail/hongjiacheng-BCP5116/C41375111
C41375110 | promotional_extended | Bipolar (BJT) | Bipolar (BJT) | BCP53-16 | hongjiacheng | SOT-223 | 1 PNP 1.5W 100MHz 100V 100nA 1A 250 500mV 5V PNP SOT-223 Bipolar (BJT) ROHS | 22900 | 0.0837 | Operating Temperature=-; Transition frequency(fT)=100MHz; Collector - Emitter Voltage VCEO=100V; Number=1 PNP; Configuration=-; DC Current Gain=250; Current - Collector(Ic)=1A; Vce Saturation(VCE(sat))=500mV; Emitter-Base Voltage(Vebo)=5V; type=PNP; Pd - Power Dissipation=1.5W; Current - Collector Cutoff=100nA | https://www.lcsc.com/datasheet/lcsc_datasheet_2409041457_hongjiacheng-BCP53-16_C41375110.pdf | https://jlcpcb.com/partdetail/hongjiacheng-BCP5316/C41375110
C41376085 | promotional_extended | Bipolar (BJT) | Bipolar (BJT) | BCP55-16 | hongjiacheng | SOT-223 | 1 NPN 1.5W 100nA 130MHz 1A 25 500mV 5V 60V NPN SOT-223 Bipolar (BJT) ROHS | 8121 | 0.0566 | Operating Temperature=-; Transition frequency(fT)=130MHz; Collector - Emitter Voltage VCEO=60V; Number=1 NPN; Configuration=-; DC Current Gain=25; Current - Collector(Ic)=1A; Vce Saturation(VCE(sat))=500mV; Emitter-Base Voltage(Vebo)=5V; type=NPN; Pd - Power Dissipation=1.5W; Current - Collector Cutoff=100nA | https://www.lcsc.com/datasheet/lcsc_datasheet_2412061047_hongjiacheng-BCP55-16_C41376085.pdf | https://jlcpcb.com/partdetail/hongjiacheng-BCP5516/C41376085
C41375109 | promotional_extended | Bipolar (BJT) | Bipolar (BJT) | BCP56-16 | hongjiacheng | SOT-223 | 1 NPN 1.33W 100nA 130MHz 1A 25 500mV 5V 80V NPN SOT-223 Bipolar (BJT) ROHS | 60100 | 0.0819 | Operating Temperature=-; Transition frequency(fT)=130MHz; Collector - Emitter Voltage VCEO=80V; Number=1 NPN; Configuration=-; DC Current Gain=25; Current - Collector(Ic)=1A; Vce Saturation(VCE(sat))=500mV; Emitter-Base Voltage(Vebo)=5V; type=NPN; Pd - Power Dissipation=1.33W; Current - Collector Cutoff=100nA | https://www.lcsc.com/datasheet/lcsc_datasheet_2409041457_hongjiacheng-BCP56-16_C41375109.pdf | https://jlcpcb.com/partdetail/hongjiacheng-BCP5616/C41375109
C41375135 | promotional_extended | Bipolar (BJT) | Bipolar (BJT) | BCX53-16 | hongjiacheng | SOT-89 | 1 PNP 100 100nA 1A 500mV 500mW 50MHz 5V 80V PNP Standalone SOT-89 Bipolar (BJT) ROHS | 383332 | 0.0652 | Operating Temperature=-; Transition frequency(fT)=50MHz; Collector - Emitter Voltage VCEO=80V; Configuration=Standalone; Number=1 PNP; DC Current Gain=100; Current - Collector(Ic)=1A; Vce Saturation(VCE(sat))=500mV; Emitter-Base Voltage(Vebo)=5V; type=PNP; Pd - Power Dissipation=500mW; Current - Collector Cutoff=100nA | https://www.lcsc.com/datasheet/lcsc_datasheet_2411041735_hongjiacheng-BCX53-16_C41375135.pdf | https://jlcpcb.com/partdetail/hongjiacheng-BCX5316/C41375135
C41375120 | promotional_extended | Bipolar (BJT) | Bipolar (BJT) | BCX55-16 | hongjiacheng | SOT-89 | -55℃~+150℃ 1 NPN 130MHz 1A 250 500mV 500mW 5V 5nA 60V NPN Standalone SOT-89 Bipolar (BJT) ROHS | 467 | 0.0709 | Operating Temperature=-55℃~+150℃; Transition frequency(fT)=130MHz; Collector - Emitter Voltage VCEO=60V; Configuration=Standalone; Number=1 NPN; DC Current Gain=250; Current - Collector(Ic)=1A; Vce Saturation(VCE(sat))=500mV; Emitter-Base Voltage(Vebo)=5V; type=NPN; Pd - Power Dissipation=500mW; Current - Collector Cutoff=5nA | https://www.lcsc.com/datasheet/lcsc_datasheet_2411041735_hongjiacheng-BCX55-16_C41375120.pdf | https://jlcpcb.com/partdetail/hongjiacheng-BCX5516/C41375120
C20069156 | promotional_extended | Bipolar (BJT) | Bipolar (BJT) | BCX56-10 | hongjiacheng | SOT-89 | -55℃~+150℃ 1 NPN 100nA 130MHz 1A 40 500mV 500mW 5V 80V NPN SOT-89 Bipolar (BJT) ROHS | 6146 | 0.0769 | Operating Temperature=-55℃~+150℃; Transition frequency(fT)=130MHz; Collector - Emitter Voltage VCEO=80V; Number=1 NPN; Configuration=-; DC Current Gain=40; Current - Collector(Ic)=1A; Vce Saturation(VCE(sat))=500mV; Emitter-Base Voltage(Vebo)=5V; Pd - Power Dissipation=500mW; type=NPN; Current - Collector Cutoff=100nA | https://wmsc.lcsc.com/wmsc/upload/file/pdf/v2/lcsc/2404081545_hongjiacheng-BCX56-10_C20069156.pdf | https://jlcpcb.com/partdetail/hongjiacheng-BCX5610/C20069156
C20069133 | promotional_extended | Bipolar (BJT) | Bipolar (BJT) | BCX56-16 | hongjiacheng | SOT-89 | -55℃~+150℃ 1 NPN 100nA 130MHz 1A 40 500mV 500mW 5V 80V NPN SOT-89 Bipolar (BJT) ROHS | 108778 | 0.0723 | Operating Temperature=-55℃~+150℃; Transition frequency(fT)=130MHz; Collector - Emitter Voltage VCEO=80V; Configuration=Standalone; Number=1 NPN; DC Current Gain=40; Current - Collector(Ic)=1A; Vce Saturation(VCE(sat))=500mV; Emitter-Base Voltage(Vebo)=5V; type=NPN; Pd - Power Dissipation=500mW; Current - Collector Cutoff=100nA | https://wmsc.lcsc.com/wmsc/upload/file/pdf/v2/lcsc/2312291746_hongjiacheng-BCX56-16_C20069133.pdf | https://jlcpcb.com/partdetail/hongjiacheng-BCX5616/C20069133
C41375138 | promotional_extended | Bipolar (BJT) | Bipolar (BJT) | CXT5551 | hongjiacheng | SOT-89 | -55℃~+150℃ 1 NPN 100nA 150mV 160V 300 300MHz 500mW 600mA 6V NPN Standalone SOT-89 Bipolar (BJT) ROHS | 367856 | 0.0358 | Operating Temperature=-55℃~+150℃; Transition frequency(fT)=300MHz; Collector - Emitter Voltage VCEO=160V; Configuration=Standalone; Number=1 NPN; DC Current Gain=300; Current - Collector(Ic)=600mA; Vce Saturation(VCE(sat))=150mV; Emitter-Base Voltage(Vebo)=6V; type=NPN; Pd - Power Dissipation=500mW; Current - Collector Cutoff=100nA | https://www.lcsc.com/datasheet/lcsc_datasheet_2411041735_hongjiacheng-CXT5551_C41375138.pdf | https://jlcpcb.com/partdetail/hongjiacheng-CXT5551/C41375138
C20069128 | promotional_extended | Bipolar (BJT) | Bipolar (BJT) | D882 | hongjiacheng | SOT-89 | -55℃~+150℃ 1 NPN 1uA 30V 3A 500mV 500mW 50MHz 60 6V NPN SOT-89 Bipolar (BJT) ROHS | 30795 | 0.0686 | Operating Temperature=-55℃~+150℃; Transition frequency(fT)=50MHz; Collector - Emitter Voltage VCEO=30V; Configuration=Standalone; Number=1 NPN; DC Current Gain=60; Current - Collector(Ic)=3A; Vce Saturation(VCE(sat))=500mV; Emitter-Base Voltage(Vebo)=6V; type=NPN; Pd - Power Dissipation=500mW; Current - Collector Cutoff=1uA | https://wmsc.lcsc.com/wmsc/upload/file/pdf/v2/lcsc/2312291746_hongjiacheng-D882_C20069128.pdf | https://jlcpcb.com/partdetail/hongjiacheng-D882/C20069128
C41375123 | promotional_extended | Bipolar (BJT) | Bipolar (BJT) | D882H | hongjiacheng | SOT-89 | -55℃~+150℃ 1 NPN 1uA 320 3A 500mV 500mW 50MHz 6V 70V NPN SOT-89 Bipolar (BJT) ROHS | 48997 | 0.0686 | Operating Temperature=-55℃~+150℃; Transition frequency(fT)=50MHz; Collector - Emitter Voltage VCEO=70V; Number=1 NPN; Configuration=-; DC Current Gain=320; Current - Collector(Ic)=3A; Vce Saturation(VCE(sat))=500mV; Emitter-Base Voltage(Vebo)=6V; type=NPN; Pd - Power Dissipation=500mW; Current - Collector Cutoff=1uA | https://www.lcsc.com/datasheet/lcsc_datasheet_2411041735_hongjiacheng-D882H_C41375123.pdf | https://jlcpcb.com/partdetail/hongjiacheng-D882H/C41375123
C41375128 | promotional_extended | Bipolar (BJT) | Bipolar (BJT) | FMMT491 | hongjiacheng | SOT-23 | 1 NPN 100nA 150MHz 1A 250mW 300 500mV 5V 60V NPN Standalone SOT-23 Bipolar (BJT) ROHS | 22293 | 0.0478 | Operating Temperature=-; Transition frequency(fT)=150MHz; Collector - Emitter Voltage VCEO=60V; Configuration=Standalone; Number=1 NPN; DC Current Gain=300; Current - Collector(Ic)=1A; Vce Saturation(VCE(sat))=500mV; Emitter-Base Voltage(Vebo)=5V; type=NPN; Pd - Power Dissipation=250mW; Current - Collector Cutoff=100nA | https://www.lcsc.com/datasheet/lcsc_datasheet_2408301021_hongjiacheng-FMMT491_C41375128.pdf | https://jlcpcb.com/partdetail/hongjiacheng-FMMT491/C41375128
C28646275 | promotional_extended | Bipolar (BJT) | Bipolar (BJT) | FMMT493 | hongjiacheng | SOT-23 | -55℃~+150℃ 1 NPN 100 100V 100nA 150MHz 1A 250mW 5V 600mV NPN Standalone SOT-23 Bipolar (BJT) ROHS | 66955 | 0.0606 | Operating Temperature=-55℃~+150℃; Transition frequency(fT)=150MHz; Collector - Emitter Voltage VCEO=100V; Configuration=Standalone; Number=1 NPN; DC Current Gain=100; Current - Collector(Ic)=1A; Vce Saturation(VCE(sat))=600mV; Emitter-Base Voltage(Vebo)=5V; type=NPN; Pd - Power Dissipation=250mW; Current - Collector Cutoff=100nA | https://wmsc.lcsc.com/wmsc/upload/file/pdf/v2/lcsc/2407120922_hongjiacheng-FMMT493_C28646275.pdf | https://jlcpcb.com/partdetail/hongjiacheng-FMMT493/C28646275
C41375132 | promotional_extended | Bipolar (BJT) | Bipolar (BJT) | FMMT591 | hongjiacheng | SOT-23 | -55℃~+150℃ 1 PNP 100nA 150MHz 1A 250mW 300 5V 600mV 60V PNP SOT-23 Bipolar (BJT) ROHS | 27057 | 0.0416 | Operating Temperature=-55℃~+150℃; Transition frequency(fT)=150MHz; Collector - Emitter Voltage VCEO=60V; Number=1 PNP; Configuration=-; DC Current Gain=300; Current - Collector(Ic)=1A; Vce Saturation(VCE(sat))=600mV; Emitter-Base Voltage(Vebo)=5V; Pd - Power Dissipation=250mW; type=PNP; Current - Collector Cutoff=100nA | https://www.lcsc.com/datasheet/lcsc_datasheet_2408301021_hongjiacheng-FMMT591_C41375132.pdf | https://jlcpcb.com/partdetail/hongjiacheng-FMMT591/C41375132
C41375112 | promotional_extended | Bipolar (BJT) | Bipolar (BJT) | FZT955 | hongjiacheng | SOT-223 | -55℃~+150℃ 1 PNP 110MHz 140V 300 370mV 3W 4A 50nA 6V PNP SOT-223 Bipolar (BJT) ROHS | 885 | 0.1594 | Operating Temperature=-55℃~+150℃; Transition frequency(fT)=110MHz; Collector - Emitter Voltage VCEO=140V; Number=1 PNP; Configuration=-; DC Current Gain=300; Current - Collector(Ic)=4A; Vce Saturation(VCE(sat))=370mV; Emitter-Base Voltage(Vebo)=6V; Pd - Power Dissipation=3W; type=PNP; Current - Collector Cutoff=50nA | https://www.lcsc.com/datasheet/lcsc_datasheet_2409041457_hongjiacheng-FZT955_C41375112.pdf | https://jlcpcb.com/partdetail/hongjiacheng-FZT955/C41375112
C7420351 | promotional_extended | Bipolar (BJT) | Bipolar (BJT) | MMBT2222A | hongjiacheng | SOT-23 | -55℃~+150℃ 1 NPN 100 100nA 1V 300MHz 300mW 40V 600mA 6V NPN Standalone SOT-23 Bipolar (BJT) ROHS | 671080 | 0.0189 | Operating Temperature=-55℃~+150℃; Transition frequency(fT)=300MHz; Collector - Emitter Voltage VCEO=40V; Configuration=Standalone; Number=1 NPN; DC Current Gain=100; Current - Collector(Ic)=600mA; Vce Saturation(VCE(sat))=1V; Emitter-Base Voltage(Vebo)=6V; type=NPN; Pd - Power Dissipation=300mW; Current - Collector Cutoff=100nA | https://wmsc.lcsc.com/wmsc/upload/file/pdf/v2/lcsc/2312221203_hongjiacheng-MMBT2222A_C7420351.pdf | https://jlcpcb.com/partdetail/hongjiacheng-MMBT2222A/C7420351
C7420352 | promotional_extended | Bipolar (BJT) | Bipolar (BJT) | MMBT2907A | hongjiacheng | SOT-23 | -55℃~+150℃ 1 PNP 100 100nA 200MHz 250mW 400mV 5V 600mA 60V PNP SOT-23 Bipolar (BJT) ROHS | 112510 | 0.0203 | Operating Temperature=-55℃~+150℃; Transition frequency(fT)=200MHz; Collector - Emitter Voltage VCEO=60V; Configuration=Standalone; Number=1 PNP; DC Current Gain=100; Current - Collector(Ic)=600mA; Vce Saturation(VCE(sat))=400mV; Emitter-Base Voltage(Vebo)=5V; type=PNP; Pd - Power Dissipation=250mW; Current - Collector Cutoff=100nA | https://wmsc.lcsc.com/wmsc/upload/file/pdf/v2/lcsc/2312221203_hongjiacheng-MMBT2907A_C7420352.pdf | https://jlcpcb.com/partdetail/hongjiacheng-MMBT2907A/C7420352
C7420353 | promotional_extended | Bipolar (BJT) | Bipolar (BJT) | MMBT3904 | hongjiacheng | SOT-23 | -55℃~+150℃ 1 NPN 100 100nA 200mA 200mW 300MHz 300mV 40V 6V NPN SOT-23 Bipolar (BJT) ROHS | 5024282 | 0.012 | Operating Temperature=-55℃~+150℃; Transition frequency(fT)=300MHz; Collector - Emitter Voltage VCEO=40V; Configuration=Standalone; Number=1 NPN; DC Current Gain=100; Current - Collector(Ic)=200mA; Vce Saturation(VCE(sat))=300mV; Emitter-Base Voltage(Vebo)=6V; Pd - Power Dissipation=200mW; type=NPN; Current - Collector Cutoff=100nA | https://wmsc.lcsc.com/wmsc/upload/file/pdf/v2/lcsc/2312221203_hongjiacheng-MMBT3904_C7420353.pdf | https://jlcpcb.com/partdetail/hongjiacheng-MMBT3904/C7420353
C364310 | promotional_extended | Bipolar (BJT) | Bipolar (BJT) | MMBT3904-1AM(RANGE:100-300) | MDD(Microdiode Semiconductor) | SOT-23 | -55℃~+150℃ 1 NPN 100nA 200mA 200mW 300 300MHz 300mV 40V 6V NPN SOT-23 Bipolar (BJT) ROHS | 115805 | 0.0095 | Operating Temperature=-55℃~+150℃; Transition frequency(fT)=300MHz; Collector - Emitter Voltage VCEO=40V; Number=1 NPN; Configuration=-; DC Current Gain=300; Current - Collector(Ic)=200mA; Vce Saturation(VCE(sat))=300mV; Emitter-Base Voltage(Vebo)=6V; Pd - Power Dissipation=200mW; type=NPN; Current - Collector Cutoff=100nA | https://www.lcsc.com/datasheet/lcsc_datasheet_2308231034_MDD-Microdiode-Semiconductor-MMBT3904-1AM-RANGE-100-300_C364310.pdf | https://jlcpcb.com/partdetail/338622-MMBT3904_1AM_RANGE_100_300/C364310
C7420354 | promotional_extended | Bipolar (BJT) | Bipolar (BJT) | MMBT3906 | hongjiacheng | SOT-23 | -55℃~+150℃ 1 PNP 100 100nA 200mA 200mW 300MHz 300mV 40V 5V PNP SOT-23 Bipolar (BJT) ROHS | 742522 | 0.0117 | Operating Temperature=-55℃~+150℃; Transition frequency(fT)=300MHz; Collector - Emitter Voltage VCEO=40V; Configuration=Standalone; Number=1 PNP; DC Current Gain=100; Current - Collector(Ic)=200mA; Vce Saturation(VCE(sat))=300mV; Emitter-Base Voltage(Vebo)=5V; type=PNP; Pd - Power Dissipation=200mW; Current - Collector Cutoff=100nA | https://wmsc.lcsc.com/wmsc/upload/file/pdf/v2/lcsc/2312221203_hongjiacheng-MMBT3906_C7420354.pdf | https://jlcpcb.com/partdetail/hongjiacheng-MMBT3906/C7420354
C7420355 | promotional_extended | Bipolar (BJT) | Bipolar (BJT) | MMBT4401 | hongjiacheng | SOT-23 | -55℃~+150℃ 1 NPN 100 100nA 250MHz 300mW 400mV 40V 600mA 6V NPN Standalone SOT-23 Bipolar (BJT) ROHS | 606266 | 0.0171 | Operating Temperature=-55℃~+150℃; Collector - Emitter Voltage VCEO=40V; Transition frequency(fT)=250MHz; Configuration=Standalone; Number=1 NPN; DC Current Gain=100; Current - Collector(Ic)=600mA; Vce Saturation(VCE(sat))=400mV; Emitter-Base Voltage(Vebo)=6V; type=NPN; Pd - Power Dissipation=300mW; Current - Collector Cutoff=100nA | https://www.lcsc.com/datasheet/lcsc_datasheet_2312221203_hongjiacheng-MMBT4401_C7420355.pdf | https://jlcpcb.com/partdetail/hongjiacheng-MMBT4401/C7420355
C20069140 | promotional_extended | Bipolar (BJT) | Bipolar (BJT) | MMBT4403 | hongjiacheng | SOT-23 | -55℃~+150℃ 1 PNP 100 100nA 200MHz 300mW 400mV 40V 5V 600mA PNP SOT-23 Bipolar (BJT) ROHS | 25048 | 0.0199 | Operating Temperature=-55℃~+150℃; Collector - Emitter Voltage VCEO=40V; Transition frequency(fT)=200MHz; Configuration=Standalone; Number=1 PNP; DC Current Gain=100; Current - Collector(Ic)=600mA; Vce Saturation(VCE(sat))=400mV; Emitter-Base Voltage(Vebo)=5V; type=PNP; Pd - Power Dissipation=300mW; Current - Collector Cutoff=100nA | https://wmsc.lcsc.com/wmsc/upload/file/pdf/v2/lcsc/2312291746_hongjiacheng-MMBT4403_C20069140.pdf | https://jlcpcb.com/partdetail/hongjiacheng-MMBT4403/C20069140
C7420356 | promotional_extended | Bipolar (BJT) | Bipolar (BJT) | MMBT5401 | hongjiacheng | SOT-23 | -55℃~+150℃ 1 PNP 100 100MHz 100nA 160V 200mV 300mW 5V 600mA PNP SOT-23 Bipolar (BJT) ROHS | 4909287 | 0.0128 | Operating Temperature=-55℃~+150℃; Transition frequency(fT)=100MHz; Collector - Emitter Voltage VCEO=160V; Configuration=Standalone; Number=1 PNP; DC Current Gain=100; Current - Collector(Ic)=600mA; Vce Saturation(VCE(sat))=200mV; Emitter-Base Voltage(Vebo)=5V; type=PNP; Pd - Power Dissipation=300mW; Current - Collector Cutoff=100nA | https://wmsc.lcsc.com/wmsc/upload/file/pdf/v2/lcsc/2312221203_hongjiacheng-MMBT5401_C7420356.pdf | https://jlcpcb.com/partdetail/hongjiacheng-MMBT5401/C7420356
C408396 | promotional_extended | Bipolar (BJT) | Bipolar (BJT) | MMBT5551 | MDD(Microdiode Semiconductor) | SOT-23 | -55℃~+150℃ 1 NPN 160V 200mV 300 300MHz 300mW 50nA 600mA 6V NPN SOT-23 Bipolar (BJT) ROHS | 1529201 | 0.0137 | Operating Temperature=-55℃~+150℃; Transition frequency(fT)=300MHz; Collector - Emitter Voltage VCEO=160V; Number=1 NPN; Configuration=-; DC Current Gain=300; Current - Collector(Ic)=600mA; Vce Saturation(VCE(sat))=200mV; Emitter-Base Voltage(Vebo)=6V; Pd - Power Dissipation=300mW; type=NPN; Current - Collector Cutoff=50nA | https://www.lcsc.com/datasheet/lcsc_datasheet_2407261641_MDD-Microdiode-Semiconductor-MMBT5551_C408396.pdf | https://jlcpcb.com/partdetail/397621-MMBT5551/C408396
C7420357 | promotional_extended | Bipolar (BJT) | Bipolar (BJT) | MMBT5551 | hongjiacheng | SOT-23 | -55℃~+150℃ 1 NPN 100 100MHz 150mV 160V 300mW 50nA 600mA 6V NPN SOT-23 Bipolar (BJT) ROHS | 8226748 | 0.0121 | Operating Temperature=-55℃~+150℃; Transition frequency(fT)=100MHz; Collector - Emitter Voltage VCEO=160V; Configuration=Standalone; Number=1 NPN; DC Current Gain=100; Current - Collector(Ic)=600mA; Vce Saturation(VCE(sat))=150mV; Emitter-Base Voltage(Vebo)=6V; type=NPN; Pd - Power Dissipation=300mW; Current - Collector Cutoff=50nA | https://wmsc.lcsc.com/wmsc/upload/file/pdf/v2/lcsc/2312221203_hongjiacheng-MMBT5551_C7420357.pdf | https://jlcpcb.com/partdetail/hongjiacheng-MMBT5551/C7420357
C41375114 | promotional_extended | Bipolar (BJT) | Bipolar (BJT) | MMBTA05 | hongjiacheng | SOT-23 | 1 NPN 100MHz 100nA 250mV 300mW 400 4V 500mA 60V NPN Standalone SOT-23 Bipolar (BJT) ROHS | 14053 | 0.0298 | Operating Temperature=-; Transition frequency(fT)=100MHz; Collector - Emitter Voltage VCEO=60V; Configuration=Standalone; Number=1 NPN; DC Current Gain=400; Current - Collector(Ic)=500mA; Vce Saturation(VCE(sat))=250mV; Emitter-Base Voltage(Vebo)=4V; type=NPN; Pd - Power Dissipation=300mW; Current - Collector Cutoff=100nA | https://www.lcsc.com/datasheet/lcsc_datasheet_2410161104_hongjiacheng-MMBTA05_C41375114.pdf | https://jlcpcb.com/partdetail/hongjiacheng-MMBTA05/C41375114
C20069139 | promotional_extended | Bipolar (BJT) | Bipolar (BJT) | MMBTA06 | hongjiacheng | SOT-23 | 1 NPN 100 100MHz 100nA 200mV 300mW 4V 500mA 80V NPN SOT-23 Bipolar (BJT) ROHS | 84768 | 0.0402 | Operating Temperature=-55℃~+150℃; Transition frequency(fT)=100MHz; Collector - Emitter Voltage VCEO=80V; Configuration=Standalone; Number=1 NPN; DC Current Gain=100; Current - Collector(Ic)=500mA; Vce Saturation(VCE(sat))=200mV; Emitter-Base Voltage(Vebo)=4V; Pd - Power Dissipation=300mW; type=NPN; Current - Collector Cutoff=100nA | https://wmsc.lcsc.com/wmsc/upload/file/pdf/v2/lcsc/2312291746_hongjiacheng-MMBTA06_C20069139.pdf | https://jlcpcb.com/partdetail/hongjiacheng-MMBTA06/C20069139
C20069138 | promotional_extended | Bipolar (BJT) | Bipolar (BJT) | MMBTA42 | hongjiacheng | SOT-23 | -55℃~+150℃ 1 NPN 100 100nA 200mV 300V 350mW 500mA 50MHz 5V NPN SOT-23 Bipolar (BJT) ROHS | 311072 | 0.0285 | Operating Temperature=-55℃~+150℃; Transition frequency(fT)=50MHz; Collector - Emitter Voltage VCEO=300V; Configuration=Standalone; Number=1 NPN; DC Current Gain=100; Current - Collector(Ic)=500mA; Vce Saturation(VCE(sat))=200mV; Emitter-Base Voltage(Vebo)=5V; Pd - Power Dissipation=350mW; type=NPN; Current - Collector Cutoff=100nA | https://wmsc.lcsc.com/wmsc/upload/file/pdf/v2/lcsc/2407101109_hongjiacheng-MMBTA42_C20069138.pdf | https://jlcpcb.com/partdetail/hongjiacheng-MMBTA42/C20069138
C20069141 | promotional_extended | Bipolar (BJT) | Bipolar (BJT) | MMBTA44 | hongjiacheng | SOT-23 | -55℃~+150℃ 1 NPN 100nA 200mA 200mV 350mW 400V 50 50MHz 6V NPN SOT-23 Bipolar (BJT) ROHS | 594560 | 0.0569 | Operating Temperature=-55℃~+150℃; Transition frequency(fT)=50MHz; Collector - Emitter Voltage VCEO=400V; Number=1 NPN; Configuration=-; DC Current Gain=50; Current - Collector(Ic)=200mA; Vce Saturation(VCE(sat))=200mV; Emitter-Base Voltage(Vebo)=6V; Pd - Power Dissipation=350mW; type=NPN; Current - Collector Cutoff=100nA | https://wmsc.lcsc.com/wmsc/upload/file/pdf/v2/lcsc/2312291746_hongjiacheng-MMBTA44_C20069141.pdf | https://jlcpcb.com/partdetail/hongjiacheng-MMBTA44/C20069141
C41375115 | promotional_extended | Bipolar (BJT) | Bipolar (BJT) | MMBTA55 | hongjiacheng | SOT-23 | -55℃~+150℃ 1 PNP 100nA 225mW 250mV 400 4V 500mA 50MHz 60V PNP SOT-23 Bipolar (BJT) ROHS | 29550 | 0.029 | Operating Temperature=-55℃~+150℃; Transition frequency(fT)=50MHz; Collector - Emitter Voltage VCEO=60V; Number=1 PNP; Configuration=-; DC Current Gain=400; Current - Collector(Ic)=500mA; Vce Saturation(VCE(sat))=250mV; Emitter-Base Voltage(Vebo)=4V; Pd - Power Dissipation=225mW; type=PNP; Current - Collector Cutoff=100nA | https://www.lcsc.com/datasheet/lcsc_datasheet_2411041730_hongjiacheng-MMBTA55_C41375115.pdf | https://jlcpcb.com/partdetail/hongjiacheng-MMBTA55/C41375115
C20069147 | promotional_extended | Bipolar (BJT) | Bipolar (BJT) | MMBTA56 | hongjiacheng | SOT-23 | -55℃~+150℃ 1 PNP 100 100nA 225mW 250mV 4V 500mA 50MHz 80V PNP SOT-23 Bipolar (BJT) ROHS | 80118 | 0.0316 | Operating Temperature=-55℃~+150℃; Transition frequency(fT)=50MHz; Collector - Emitter Voltage VCEO=80V; Configuration=Standalone; Number=1 PNP; DC Current Gain=100; Current - Collector(Ic)=500mA; Vce Saturation(VCE(sat))=250mV; Emitter-Base Voltage(Vebo)=4V; Pd - Power Dissipation=225mW; type=PNP; Current - Collector Cutoff=100nA | https://wmsc.lcsc.com/wmsc/upload/file/pdf/v2/lcsc/2312291746_hongjiacheng-MMBTA56_C20069147.pdf | https://jlcpcb.com/partdetail/hongjiacheng-MMBTA56/C20069147
C20069146 | promotional_extended | Bipolar (BJT) | Bipolar (BJT) | MMBTA92 | hongjiacheng | SOT-23 | -55℃~+150℃ 1 PNP 100nA 200mV 300V 350mW 500mA 50MHz 5V 60 PNP SOT-23 Bipolar (BJT) ROHS | 441817 | 0.0288 | Operating Temperature=-55℃~+150℃; Transition frequency(fT)=50MHz; Collector - Emitter Voltage VCEO=300V; Configuration=Standalone; Number=1 PNP; DC Current Gain=60; Current - Collector(Ic)=500mA; Vce Saturation(VCE(sat))=200mV; Emitter-Base Voltage(Vebo)=5V; Pd - Power Dissipation=350mW; type=PNP; Current - Collector Cutoff=100nA | https://wmsc.lcsc.com/wmsc/upload/file/pdf/v2/lcsc/2312291746_hongjiacheng-MMBTA92_C20069146.pdf | https://jlcpcb.com/partdetail/hongjiacheng-MMBTA92/C20069146
C41375113 | promotional_extended | Bipolar (BJT) | Bipolar (BJT) | MMBTA94 | hongjiacheng | SOT-23 | -55℃~+150℃ 1 PNP 100nA 200mA 200mV 300 350mW 400V 50MHz 5V PNP SOT-23 Bipolar (BJT) ROHS | 21917 | 0.0497 | Operating Temperature=-55℃~+150℃; Transition frequency(fT)=50MHz; Collector - Emitter Voltage VCEO=400V; Number=1 PNP; Configuration=-; DC Current Gain=300; Current - Collector(Ic)=200mA; Vce Saturation(VCE(sat))=200mV; Emitter-Base Voltage(Vebo)=5V; Pd - Power Dissipation=350mW; type=PNP; Current - Collector Cutoff=100nA | https://www.lcsc.com/datasheet/lcsc_datasheet_2411041730_hongjiacheng-MMBTA94_C41375113.pdf | https://jlcpcb.com/partdetail/hongjiacheng-MMBTA94/C41375113
C41375117 | promotional_extended | Bipolar (BJT) | Bipolar (BJT) | MMDT2227 | hongjiacheng | SOT-363 | 1 NPN + 1 PNP 10nA 200mW 300 300MHz 300mV 600mA 60V 6V NPN+PNP Standalone SOT-363 Bipolar (BJT) ROHS | 44081 | 0.0652 | Operating Temperature=-; Transition frequency(fT)=300MHz; Collector - Emitter Voltage VCEO=60V; Configuration=Standalone; Number=1 NPN + 1 PNP; DC Current Gain=300; Current - Collector(Ic)=600mA; Vce Saturation(VCE(sat))=300mV; Emitter-Base Voltage(Vebo)=6V; type=NPN+PNP; Pd - Power Dissipation=200mW; Current - Collector Cutoff=10nA | https://www.lcsc.com/datasheet/lcsc_datasheet_2409051048_hongjiacheng-MMDT2227_C41375117.pdf | https://jlcpcb.com/partdetail/hongjiacheng-MMDT2227/C41375117
C41375125 | promotional_extended | Bipolar (BJT) | Bipolar (BJT) | MMDT3904 | hongjiacheng | SOT-363 | 100nA 2 NPN 200mA 200mW 300 300MHz 300mV 40V 6V NPN Standalone SOT-363 Bipolar (BJT) ROHS | 96637 | 0.0306 | Operating Temperature=-; Transition frequency(fT)=300MHz; Collector - Emitter Voltage VCEO=40V; Configuration=Standalone; Number=2 NPN; DC Current Gain=300; Current - Collector(Ic)=200mA; Vce Saturation(VCE(sat))=300mV; Emitter-Base Voltage(Vebo)=6V; type=NPN; Pd - Power Dissipation=200mW; Current - Collector Cutoff=100nA | https://www.lcsc.com/datasheet/lcsc_datasheet_2409051048_hongjiacheng-MMDT3904_C41375125.pdf | https://jlcpcb.com/partdetail/hongjiacheng-MMDT3904/C41375125
C41375116 | promotional_extended | Bipolar (BJT) | Bipolar (BJT) | MMDT5551 | hongjiacheng | SOT-363 | 160V 2 NPN 200mA 200mV 200mW 300 300MHz 50nA 6V NPN Standalone SOT-363 Bipolar (BJT) ROHS | 14872 | 0.0335 | Operating Temperature=-; Transition frequency(fT)=300MHz; Collector - Emitter Voltage VCEO=160V; Configuration=Standalone; Number=2 NPN; DC Current Gain=300; Current - Collector(Ic)=200mA; Vce Saturation(VCE(sat))=200mV; Emitter-Base Voltage(Vebo)=6V; Pd - Power Dissipation=200mW; type=NPN; Current - Collector Cutoff=50nA | https://www.lcsc.com/datasheet/lcsc_datasheet_2409051048_hongjiacheng-MMDT5551_C41375116.pdf | https://jlcpcb.com/partdetail/hongjiacheng-MMDT5551/C41375116
C22388837 | promotional_extended | Bipolar (BJT) | Bipolar (BJT) | MMST3904 | hongjiacheng | SOT-323 | -55℃~+150℃ 1 NPN 200mA 200mW 300MHz 300mV 40 40V 5V 60nA NPN Standalone SOT-323 Bipolar (BJT) ROHS | 151097 | 0.0181 | Operating Temperature=-55℃~+150℃; Transition frequency(fT)=300MHz; Collector - Emitter Voltage VCEO=40V; Configuration=Standalone; Number=1 NPN; DC Current Gain=40; Current - Collector(Ic)=200mA; Vce Saturation(VCE(sat))=300mV; Emitter-Base Voltage(Vebo)=5V; type=NPN; Pd - Power Dissipation=200mW; Current - Collector Cutoff=60nA | https://wmsc.lcsc.com/wmsc/upload/file/pdf/v2/lcsc/2404261206_hongjiacheng-MMST3904_C22388837.pdf | https://jlcpcb.com/partdetail/hongjiacheng-MMST3904/C22388837
C41375136 | promotional_extended | Bipolar (BJT) | Bipolar (BJT) | PXT8050 | hongjiacheng | SOT-89 | -55℃~+155℃ 1 NPN 1.5A 100MHz 100nA 25V 400 500mV 500mW 5V NPN Standalone SOT-89 Bipolar (BJT) ROHS | 7343 | 0.033 | Operating Temperature=-55℃~+155℃; Transition frequency(fT)=100MHz; Collector - Emitter Voltage VCEO=25V; Configuration=Standalone; Number=1 NPN; DC Current Gain=400; Current - Collector(Ic)=1.5A; Vce Saturation(VCE(sat))=500mV; Emitter-Base Voltage(Vebo)=5V; type=NPN; Pd - Power Dissipation=500mW; Current - Collector Cutoff=100nA | https://www.lcsc.com/datasheet/lcsc_datasheet_2411041735_hongjiacheng-PXT8050_C41375136.pdf | https://jlcpcb.com/partdetail/hongjiacheng-PXT8050/C41375136
C364312 | promotional_extended | Bipolar (BJT) | Bipolar (BJT) | S8050 | MDD(Microdiode Semiconductor) | SOT-23 | -55℃~+150℃ 1 NPN 100nA 150MHz 25V 300mW 400 500mA 5V 600mV NPN SOT-23 Bipolar (BJT) ROHS | 2499604 | 0.0128 | Operating Temperature=-55℃~+150℃; Transition frequency(fT)=150MHz; Collector - Emitter Voltage VCEO=25V; Number=1 NPN; Configuration=-; DC Current Gain=400; Current - Collector(Ic)=500mA; Vce Saturation(VCE(sat))=600mV; Emitter-Base Voltage(Vebo)=5V; Pd - Power Dissipation=300mW; type=NPN; Current - Collector Cutoff=100nA | https://www.lcsc.com/datasheet/lcsc_datasheet_2407101108_MDD-Microdiode-Semiconductor-S8050-J3Y_C364312.pdf | https://jlcpcb.com/partdetail/MDD_Microdiode_Semiconductor-S8050/C364312
C20069125 | promotional_extended | Bipolar (BJT) | Bipolar (BJT) | S8050 | hongjiacheng | SOT-23 | -55℃~+150℃ 1 NPN 100MHz 100nA 120 25V 300mW 500mA 5V 600mV NPN SOT-23 Bipolar (BJT) ROHS | 4896082 | 0.012 | Operating Temperature=-55℃~+150℃; Transition frequency(fT)=100MHz; Collector - Emitter Voltage VCEO=25V; Configuration=Standalone; Number=1 NPN; DC Current Gain=120; Current - Collector(Ic)=500mA; Vce Saturation(VCE(sat))=600mV; Emitter-Base Voltage(Vebo)=5V; type=NPN; Pd - Power Dissipation=300mW; Current - Collector Cutoff=100nA | https://wmsc.lcsc.com/wmsc/upload/file/pdf/v2/lcsc/2404031007_hongjiacheng-S8050_C20069125.pdf | https://jlcpcb.com/partdetail/hongjiacheng-S8050/C20069125
C20069126 | promotional_extended | Bipolar (BJT) | Bipolar (BJT) | S8550 | hongjiacheng | SOT-23 | -55℃~+150℃ 1 PNP 100nA 120 150MHz 25V 300mW 500mA 500mV 5V PNP SOT-23 Bipolar (BJT) ROHS | 1224363 | 0.0135 | Operating Temperature=-55℃~+150℃; Transition frequency(fT)=150MHz; Collector - Emitter Voltage VCEO=25V; Number=1 PNP; Configuration=-; DC Current Gain=120; Current - Collector(Ic)=500mA; Vce Saturation(VCE(sat))=500mV; Emitter-Base Voltage(Vebo)=5V; type=PNP; Pd - Power Dissipation=300mW; Current - Collector Cutoff=100nA | https://wmsc.lcsc.com/wmsc/upload/file/pdf/v2/lcsc/2312291746_hongjiacheng-S8550_C20069126.pdf | https://jlcpcb.com/partdetail/hongjiacheng-S8550/C20069126
C20069129 | promotional_extended | Bipolar (BJT) | Bipolar (BJT) | S9012 | hongjiacheng | SOT-23 | -55℃~+150℃ 1 PNP 100nA 120 150MHz 25V 300mW 500mA 5V 600mV PNP SOT-23 Bipolar (BJT) ROHS | 222532 | 0.0092 | Operating Temperature=-55℃~+150℃; Transition frequency(fT)=150MHz; Collector - Emitter Voltage VCEO=25V; Configuration=Standalone; Number=1 PNP; DC Current Gain=120; Current - Collector(Ic)=500mA; Vce Saturation(VCE(sat))=600mV; Emitter-Base Voltage(Vebo)=5V; type=PNP; Pd - Power Dissipation=300mW; Current - Collector Cutoff=100nA | https://wmsc.lcsc.com/wmsc/upload/file/pdf/v2/lcsc/2407101109_hongjiacheng-S9012_C20069129.pdf | https://jlcpcb.com/partdetail/hongjiacheng-S9012/C20069129
C20069127 | promotional_extended | Bipolar (BJT) | Bipolar (BJT) | S9013 | hongjiacheng | SOT-23 | -55℃~+150℃ 1 NPN 100nA 120 150MHz 25V 300mW 500mA 5V 600mV NPN SOT-23 Bipolar (BJT) ROHS | 675017 | 0.0125 | Operating Temperature=-55℃~+150℃; Transition frequency(fT)=150MHz; Collector - Emitter Voltage VCEO=25V; Configuration=Standalone; Number=1 NPN; DC Current Gain=120; Current - Collector(Ic)=500mA; Vce Saturation(VCE(sat))=600mV; Emitter-Base Voltage(Vebo)=5V; type=NPN; Pd - Power Dissipation=300mW; Current - Collector Cutoff=100nA | https://wmsc.lcsc.com/wmsc/upload/file/pdf/v2/lcsc/2312291746_hongjiacheng-S9013_C20069127.pdf | https://jlcpcb.com/partdetail/hongjiacheng-S9013/C20069127
C20069130 | promotional_extended | Bipolar (BJT) | Bipolar (BJT) | S9014 | hongjiacheng | SOT-23 | -55℃~+150℃ 1 NPN 100mA 100nA 150MHz 200 200mW 300mV 45V 5V NPN SOT-23 Bipolar (BJT) ROHS | 2411052 | 0.0109 | Operating Temperature=-55℃~+150℃; Transition frequency(fT)=150MHz; Collector - Emitter Voltage VCEO=45V; Number=1 NPN; Configuration=-; DC Current Gain=200; Current - Collector(Ic)=100mA; Vce Saturation(VCE(sat))=300mV; Emitter-Base Voltage(Vebo)=5V; type=NPN; Pd - Power Dissipation=200mW; Current - Collector Cutoff=100nA | https://wmsc.lcsc.com/wmsc/upload/file/pdf/v2/lcsc/2312291746_hongjiacheng-S9014_C20069130.pdf | https://jlcpcb.com/partdetail/hongjiacheng-S9014/C20069130
C20069131 | promotional_extended | Bipolar (BJT) | Bipolar (BJT) | S9015 | hongjiacheng | SOT-23 | -55℃~+150℃ 1 PNP 100mA 100nA 150MHz 200 200mW 300mV 45V 5V PNP SOT-23 Bipolar (BJT) ROHS | 42817 | 0.0099 | Operating Temperature=-55℃~+150℃; Transition frequency(fT)=150MHz; Collector - Emitter Voltage VCEO=45V; Configuration=Standalone; Number=1 PNP; DC Current Gain=200; Current - Collector(Ic)=100mA; Vce Saturation(VCE(sat))=300mV; Emitter-Base Voltage(Vebo)=5V; Pd - Power Dissipation=200mW; type=PNP; Current - Collector Cutoff=100nA | https://wmsc.lcsc.com/wmsc/upload/file/pdf/v2/lcsc/2312291746_hongjiacheng-S9015_C20069131.pdf | https://jlcpcb.com/partdetail/hongjiacheng-S9015/C20069131
C2149 | promotional_extended | Bipolar (BJT) | Bipolar (BJT) | S9015(RANGE:300-400) | Jiangsu Changjing Electronics Technology Co., Ltd. | SOT-23 | -55℃~+150℃ 1 PNP 100mA 100nA 150MHz 200 200mW 300mV 45V 5V PNP SOT-23 Bipolar (BJT) ROHS | 220398 | 0.0125 | Operating Temperature=-55℃~+150℃; Transition frequency(fT)=150MHz; Collector - Emitter Voltage VCEO=45V; Number=1 PNP; DC Current Gain=200; Current - Collector(Ic)=100mA; Vce Saturation(VCE(sat))=300mV; Emitter-Base Voltage(Vebo)=5V; Pd - Power Dissipation=200mW; type=PNP; Current - Collector Cutoff=100nA | https://www.lcsc.com/datasheet/lcsc_datasheet_1809211021_Jiangsu-Changjing-Electronics-Technology-Co---Ltd--S9015-RANGE-300-400_C2149.pdf | https://jlcpcb.com/partdetail/2506-S9015_RANGE_300_400/C2149
C41375130 | promotional_extended | Bipolar (BJT) | Bipolar (BJT) | S9018 | hongjiacheng | SOT-23 | -55℃~+150℃ 1 NPN 15V 200 200mW 500mV 50mA 50nA 5V 800MHz NPN Standalone SOT-23 Bipolar (BJT) ROHS | 32869 | 0.0151 | Operating Temperature=-55℃~+150℃; Transition frequency(fT)=800MHz; Collector - Emitter Voltage VCEO=15V; Configuration=Standalone; Number=1 NPN; DC Current Gain=200; Current - Collector(Ic)=50mA; Vce Saturation(VCE(sat))=500mV; Emitter-Base Voltage(Vebo)=5V; type=NPN; Pd - Power Dissipation=200mW; Current - Collector Cutoff=50nA | https://www.lcsc.com/datasheet/lcsc_datasheet_2410161104_hongjiacheng-S9018_C41375130.pdf | https://jlcpcb.com/partdetail/hongjiacheng-S9018/C41375130
C431710 | promotional_extended | Bipolar (BJT) | Bipolar (BJT) | SS8050 | MDD(Microdiode Semiconductor) | SOT-23 | -55℃~+150℃ 1 NPN 1.5A 100MHz 100nA 25V 300mW 400 500mV 5V NPN SOT-23 Bipolar (BJT) ROHS | 1533260 | 0.0161 | Operating Temperature=-55℃~+150℃; Transition frequency(fT)=100MHz; Collector - Emitter Voltage VCEO=25V; Number=1 NPN; Configuration=-; DC Current Gain=400; Current - Collector(Ic)=1.5A; Vce Saturation(VCE(sat))=500mV; Emitter-Base Voltage(Vebo)=5V; Pd - Power Dissipation=300mW; type=NPN; Current - Collector Cutoff=100nA | https://www.lcsc.com/datasheet/lcsc_datasheet_2407101112_MDD-Microdiode-Semiconductor-SS8050_C431710.pdf | https://jlcpcb.com/partdetail/MDD_Microdiode_Semiconductor-SS8050/C431710
C7420370 | promotional_extended | Bipolar (BJT) | Bipolar (BJT) | SS8050 | hongjiacheng | SOT-23 | -55℃~+150℃ 1 NPN 1.5A 100MHz 100nA 120 25V 300mW 500mV 5V NPN SOT-23 Bipolar (BJT) ROHS | 6112386 | 0.0128 | Operating Temperature=-55℃~+150℃; Transition frequency(fT)=100MHz; Collector - Emitter Voltage VCEO=25V; Configuration=Standalone; Number=1 NPN; DC Current Gain=120; Current - Collector(Ic)=1.5A; Vce Saturation(VCE(sat))=500mV; Emitter-Base Voltage(Vebo)=5V; type=NPN; Pd - Power Dissipation=300mW; Current - Collector Cutoff=100nA | https://wmsc.lcsc.com/wmsc/upload/file/pdf/v2/lcsc/2312221203_hongjiacheng-SS8050_C7420370.pdf | https://jlcpcb.com/partdetail/hongjiacheng-SS8050/C7420370
C7420371 | promotional_extended | Bipolar (BJT) | Bipolar (BJT) | SS8550 | hongjiacheng | SOT-23 | -55℃~+150℃ 1 PNP 1.5A 100MHz 100nA 120 25V 300mW 500mV 5V PNP SOT-23 Bipolar (BJT) ROHS | 1462850 | 0.0128 | Operating Temperature=-55℃~+150℃; Transition frequency(fT)=100MHz; Collector - Emitter Voltage VCEO=25V; Configuration=Standalone; Number=1 PNP; DC Current Gain=120; Current - Collector(Ic)=1.5A; Vce Saturation(VCE(sat))=500mV; Emitter-Base Voltage(Vebo)=5V; type=PNP; Pd - Power Dissipation=300mW; Current - Collector Cutoff=100nA | https://wmsc.lcsc.com/wmsc/upload/file/pdf/v2/lcsc/2312221203_hongjiacheng-SS8550_C7420371.pdf | https://jlcpcb.com/partdetail/hongjiacheng-SS8550/C7420371
C42406051 | promotional_extended | Bridge Rectifiers | Bridge Rectifiers | ABS10 | hongjiacheng | ABS | -55℃~+150℃ 1A 1V@0.4A 1kV 30A 5uA Single-Phase Rectifier ABS Bridge Rectifiers ROHS | 104346 | 0.0291 | Voltage - Forward(Vf@If)=1V@0.4A; Type=Single-Phase Rectifier; Non-Repetitive Peak Forward Surge Current=30A; Voltage - DC Reverse(Vr)=1kV; Operating Junction Temperature Range=-55℃~+150℃; Current - Rectified=1A; Reverse Leakage Current (Ir)=5uA | https://www.lcsc.com/datasheet/lcsc_datasheet_2501211108_hongjiacheng-ABS10_C42406051.pdf | https://jlcpcb.com/partdetail/hongjiacheng-ABS10/C42406051
C42406052 | promotional_extended | Bridge Rectifiers | Bridge Rectifiers | ABS210 | hongjiacheng | ABS | -55℃~+150℃ 1V@1A 1kV 2A 5uA 60A Single-Phase Rectifier ABS Bridge Rectifiers ROHS | 173868 | 0.0374 | Voltage - Forward(Vf@If)=1V@1A; Type=Single-Phase Rectifier; Non-Repetitive Peak Forward Surge Current=60A; Voltage - DC Reverse(Vr)=1kV; Operating Junction Temperature Range=-55℃~+150℃; Current - Rectified=2A; Reverse Leakage Current (Ir)=5uA | https://www.lcsc.com/datasheet/lcsc_datasheet_2501211108_hongjiacheng-ABS210_C42406052.pdf | https://jlcpcb.com/partdetail/hongjiacheng-ABS210/C42406052
C5377 | promotional_extended | Bridge Rectifiers | Bridge Rectifiers | DB107S | MDD(Microdiode Semiconductor) | DBS | -55℃~+150℃ 1.1V@1A 10uA@1kV 1A 1kV 30A Single-Phase Rectifier DBS Bridge Rectifiers ROHS | 241549 | 0.0687 | Voltage - Forward(Vf@If)=1.1V@1A; Type=Single-Phase Rectifier; Non-Repetitive Peak Forward Surge Current=30A; Voltage - DC Reverse(Vr)=1kV; Operating Junction Temperature Range=-55℃~+150℃; Current - Rectified=1A; Reverse Leakage Current (Ir)=10uA@1kV | https://www.lcsc.com/datasheet/lcsc_datasheet_2407101125_MDD-Microdiode-Semiconductor-DB107S_C5377.pdf | https://jlcpcb.com/partdetail/MDD_Microdiode_Semiconductor-DB107S/C5377
C42406056 | promotional_extended | Bridge Rectifiers | Bridge Rectifiers | GBJ1510 | hongjiacheng | GBJ | -55℃~+150℃ 1.1V@7.5A 10uA@1000V 15A 1kV 220A Single-Phase Rectifier GBJ Bridge Rectifiers ROHS | 1756 | 0.5457 | Voltage - Forward(Vf@If)=1.1V@7.5A; Type=Single-Phase Rectifier; Non-Repetitive Peak Forward Surge Current=220A; Voltage - DC Reverse(Vr)=1kV; Operating Junction Temperature Range=-55℃~+150℃; Current - Rectified=15A; Reverse Leakage Current (Ir)=10uA@1000V | https://www.lcsc.com/datasheet/lcsc_datasheet_2501211645_hongjiacheng-GBJ1510_C42406056.pdf | https://jlcpcb.com/partdetail/hongjiacheng-GBJ1510/C42406056
C42406062 | promotional_extended | Bridge Rectifiers | Bridge Rectifiers | GBJ2506A | hongjiacheng | GBJ | -55℃~+150℃ 1.1V@12.5A 10uA 25A 350A 600V Single-Phase Rectifier GBJ Bridge Rectifiers ROHS | 1067 | 0.6009 | Voltage - Forward(Vf@If)=1.1V@12.5A; Type=Single-Phase Rectifier; Non-Repetitive Peak Forward Surge Current=350A; Voltage - DC Reverse(Vr)=600V; Operating Junction Temperature Range=-55℃~+150℃; Current - Rectified=25A; Reverse Leakage Current (Ir)=10uA | https://www.lcsc.com/datasheet/lcsc_datasheet_2501211645_hongjiacheng-GBJ2506A_C42406062.pdf | https://jlcpcb.com/partdetail/hongjiacheng-GBJ2506A/C42406062
C42406061 | promotional_extended | Bridge Rectifiers | Bridge Rectifiers | GBJ2510A | hongjiacheng | GBJ | -55℃~+150℃ 1.1V@12.5A 10uA 1kV 25A 350A Single-Phase Rectifier GBJ Bridge Rectifiers ROHS | 1071 | 0.4142 | Voltage - Forward(Vf@If)=1.1V@12.5A; Type=Single-Phase Rectifier; Non-Repetitive Peak Forward Surge Current=350A; Voltage - DC Reverse(Vr)=1kV; Operating Junction Temperature Range=-55℃~+150℃; Current - Rectified=25A; Reverse Leakage Current (Ir)=10uA | https://www.lcsc.com/datasheet/lcsc_datasheet_2501211645_hongjiacheng-GBJ2510A_C42406061.pdf | https://jlcpcb.com/partdetail/hongjiacheng-GBJ2510A/C42406061
C42406060 | promotional_extended | Bridge Rectifiers | Bridge Rectifiers | GBJ3510 | hongjiacheng | GBJ | -55℃~+150℃ 1.1V@7.5A 10uA 1kV 35A 400A Single-Phase Rectifier GBJ Bridge Rectifiers ROHS | 2218 | 0.6577 | Voltage - Forward(Vf@If)=1.1V@7.5A; Type=Single-Phase Rectifier; Non-Repetitive Peak Forward Surge Current=400A; Voltage - DC Reverse(Vr)=1kV; Operating Junction Temperature Range=-55℃~+150℃; Current - Rectified=35A; Reverse Leakage Current (Ir)=10uA | https://www.lcsc.com/datasheet/lcsc_datasheet_2501211645_hongjiacheng-GBJ3510_C42406060.pdf | https://jlcpcb.com/partdetail/hongjiacheng-GBJ3510/C42406060
C42406055 | promotional_extended | Bridge Rectifiers | Bridge Rectifiers | GBJ5008 | hongjiacheng | GBJ | -55℃~+150℃ 1.1V@25A 10uA 500A 50A 800V Single-Phase Rectifier GBJ Bridge Rectifiers ROHS | 174 | 0.8412 | Voltage - Forward(Vf@If)=1.1V@25A; Type=Single-Phase Rectifier; Non-Repetitive Peak Forward Surge Current=500A; Voltage - DC Reverse(Vr)=800V; Operating Junction Temperature Range=-55℃~+150℃; Current - Rectified=50A; Reverse Leakage Current (Ir)=10uA | https://www.lcsc.com/datasheet/lcsc_datasheet_2501211645_hongjiacheng-GBJ5008_C42406055.pdf | https://jlcpcb.com/partdetail/hongjiacheng-GBJ5008/C42406055
C42406057 | promotional_extended | Bridge Rectifiers | Bridge Rectifiers | GBJ5010 | hongjiacheng | GBJ | -55℃~+150℃ 1.1V@25A 10uA 1kV 500A 50A Single-Phase Rectifier GBJ Bridge Rectifiers ROHS | 4286 | 0.9159 | Voltage - Forward(Vf@If)=1.1V@25A; Type=Single-Phase Rectifier; Non-Repetitive Peak Forward Surge Current=500A; Voltage - DC Reverse(Vr)=1kV; Operating Junction Temperature Range=-55℃~+150℃; Current - Rectified=50A; Reverse Leakage Current (Ir)=10uA | https://www.lcsc.com/datasheet/lcsc_datasheet_2501211645_hongjiacheng-GBJ5010_C42406057.pdf | https://jlcpcb.com/partdetail/hongjiacheng-GBJ5010/C42406057
C42406063 | promotional_extended | Bridge Rectifiers | Bridge Rectifiers | GBJL1506 | hongjiacheng | GBJ | -55℃~+150℃ 10uA 15A 380A 600V 920mV@7.5A Single-Phase Rectifier GBJ Bridge Rectifiers ROHS | 2906 | 0.6106 | Voltage - Forward(Vf@If)=920mV@7.5A; Type=Single-Phase Rectifier; Non-Repetitive Peak Forward Surge Current=380A; Voltage - DC Reverse(Vr)=600V; Operating Junction Temperature Range=-55℃~+150℃; Current - Rectified=15A; Reverse Leakage Current (Ir)=10uA | https://www.lcsc.com/datasheet/lcsc_datasheet_2501211645_hongjiacheng-GBJL1506_C42406063.pdf | https://jlcpcb.com/partdetail/hongjiacheng-GBJL1506/C42406063
C42406059 | promotional_extended | Bridge Rectifiers | Bridge Rectifiers | GBJL1508 | hongjiacheng | GBJ | -55℃~+150℃ 10uA 15A 380A 800V 920mV@7.5A Single-Phase Rectifier GBJ Bridge Rectifiers ROHS | 313 | 1.1417 | Voltage - Forward(Vf@If)=920mV@7.5A; Type=Single-Phase Rectifier; Non-Repetitive Peak Forward Surge Current=380A; Voltage - DC Reverse(Vr)=800V; Operating Junction Temperature Range=-55℃~+150℃; Current - Rectified=15A; Reverse Leakage Current (Ir)=10uA | https://www.lcsc.com/datasheet/lcsc_datasheet_2501211645_hongjiacheng-GBJL1508_C42406059.pdf | https://jlcpcb.com/partdetail/hongjiacheng-GBJL1508/C42406059
C42406058 | promotional_extended | Bridge Rectifiers | Bridge Rectifiers | GBJL1508A | hongjiacheng | GBJ | -55℃~+150℃ 10uA 15A 420A 800V 900mV@7.5A Single-Phase Rectifier GBJ Bridge Rectifiers ROHS | 139 | 1.3463 | Voltage - Forward(Vf@If)=900mV@7.5A; Type=Single-Phase Rectifier; Non-Repetitive Peak Forward Surge Current=420A; Voltage - DC Reverse(Vr)=800V; Operating Junction Temperature Range=-55℃~+150℃; Current - Rectified=15A; Reverse Leakage Current (Ir)=10uA | https://www.lcsc.com/datasheet/lcsc_datasheet_2501211645_hongjiacheng-GBJL1508A_C42406058.pdf | https://jlcpcb.com/partdetail/hongjiacheng-GBJL1508A/C42406058
C42406074 | promotional_extended | Bridge Rectifiers | Bridge Rectifiers | GBP310 | hongjiacheng | GBP | -55℃~+150℃ 1.1V@3A 10uA 1kV 3A 90A Single-Phase Rectifier GBP Bridge Rectifiers ROHS | 19444 | 0.1394 | Voltage - Forward(Vf@If)=1.1V@3A; Type=Single-Phase Rectifier; Non-Repetitive Peak Forward Surge Current=90A; Voltage - DC Reverse(Vr)=1kV; Operating Junction Temperature Range=-55℃~+150℃; Current - Rectified=3A; Reverse Leakage Current (Ir)=10uA | https://www.lcsc.com/datasheet/lcsc_datasheet_2501211645_hongjiacheng-GBP310_C42406074.pdf | https://jlcpcb.com/partdetail/hongjiacheng-GBP310/C42406074
C42406075 | promotional_extended | Bridge Rectifiers | Bridge Rectifiers | GBP410A | hongjiacheng | GBP | -55℃~+150℃ 1.1V@4A 10uA 135A 1kV 4A Single-Phase Rectifier GBP Bridge Rectifiers ROHS | 925 | 0.2243 | Voltage - Forward(Vf@If)=1.1V@4A; Type=Single-Phase Rectifier; Non-Repetitive Peak Forward Surge Current=135A; Voltage - DC Reverse(Vr)=1kV; Operating Junction Temperature Range=-55℃~+150℃; Current - Rectified=4A; Reverse Leakage Current (Ir)=10uA | https://www.lcsc.com/datasheet/lcsc_datasheet_2501211645_hongjiacheng-GBP410A_C42406075.pdf | https://jlcpcb.com/partdetail/hongjiacheng-GBP410A/C42406075
C42406071 | promotional_extended | Bridge Rectifiers | Bridge Rectifiers | GBU1010 | hongjiacheng | GBU | -55℃~+150℃ 1.05V@5A 10A 10uA 1kV 200A Single-Phase Rectifier GBU Bridge Rectifiers ROHS | 4859 | 0.2912 | Voltage - Forward(Vf@If)=1.05V@5A; Type=Single-Phase Rectifier; Non-Repetitive Peak Forward Surge Current=200A; Voltage - DC Reverse(Vr)=1kV; Operating Junction Temperature Range=-55℃~+150℃; Current - Rectified=10A; Reverse Leakage Current (Ir)=10uA | https://www.lcsc.com/datasheet/lcsc_datasheet_2501211645_hongjiacheng-GBU1010_C42406071.pdf | https://jlcpcb.com/partdetail/hongjiacheng-GBU1010/C42406071
C42406066 | promotional_extended | Bridge Rectifiers | Bridge Rectifiers | GBU1510 | hongjiacheng | GBU | -55℃~+150℃ 1.1V@7.5A 10uA 15A 1kV 220A Single-Phase Rectifier GBU Bridge Rectifiers ROHS | 2011 | 0.3057 | Voltage - Forward(Vf@If)=1.1V@7.5A; Type=Single-Phase Rectifier; Non-Repetitive Peak Forward Surge Current=220A; Voltage - DC Reverse(Vr)=1kV; Operating Junction Temperature Range=-55℃~+150℃; Current - Rectified=15A; Reverse Leakage Current (Ir)=10uA | https://www.lcsc.com/datasheet/lcsc_datasheet_2501211645_hongjiacheng-GBU1510_C42406066.pdf | https://jlcpcb.com/partdetail/hongjiacheng-GBU1510/C42406066
C42406069 | promotional_extended | Bridge Rectifiers | Bridge Rectifiers | GBU2510 | hongjiacheng | GBU | -55℃~+150℃ 1.1V@12.5A 10uA 1kV 25A 350A Single-Phase Rectifier GBU Bridge Rectifiers ROHS | 3993 | 0.3534 | Voltage - Forward(Vf@If)=1.1V@12.5A; Type=Single-Phase Rectifier; Non-Repetitive Peak Forward Surge Current=350A; Voltage - DC Reverse(Vr)=1kV; Operating Junction Temperature Range=-55℃~+150℃; Current - Rectified=25A; Reverse Leakage Current (Ir)=10uA | https://www.lcsc.com/datasheet/lcsc_datasheet_2501211645_hongjiacheng-GBU2510_C42406069.pdf | https://jlcpcb.com/partdetail/hongjiacheng-GBU2510/C42406069
C42406064 | promotional_extended | Bridge Rectifiers | Bridge Rectifiers | GBU406A | hongjiacheng | GBU | GBU Bridge Rectifiers ROHS | 220 | 0.3521 |  | https://www.lcsc.com/datasheet/lcsc_datasheet_2501211645_hongjiacheng-GBU406A_C42406064.pdf | https://jlcpcb.com/partdetail/hongjiacheng-GBU406A/C42406064
C42406068 | promotional_extended | Bridge Rectifiers | Bridge Rectifiers | GBU410A | hongjiacheng | GBU | -55℃~+150℃ 1.1V@4A 10uA 135A 1kV 4A Single-Phase Rectifier GBU Bridge Rectifiers ROHS | 791 | 0.3029 | Voltage - Forward(Vf@If)=1.1V@4A; Type=Single-Phase Rectifier; Non-Repetitive Peak Forward Surge Current=135A; Voltage - DC Reverse(Vr)=1kV; Operating Junction Temperature Range=-55℃~+150℃; Current - Rectified=4A; Reverse Leakage Current (Ir)=10uA | https://www.lcsc.com/datasheet/lcsc_datasheet_2501211645_hongjiacheng-GBU410A_C42406068.pdf | https://jlcpcb.com/partdetail/hongjiacheng-GBU410A/C42406068
C42406065 | promotional_extended | Bridge Rectifiers | Bridge Rectifiers | GBU606 | hongjiacheng | GBU | -55℃~+150℃ 1.1V@3A 10uA 150A 600V 6A Single-Phase Rectifier GBU Bridge Rectifiers ROHS | 1444 | 0.2576 | Voltage - Forward(Vf@If)=1.1V@3A; Type=Single-Phase Rectifier; Non-Repetitive Peak Forward Surge Current=150A; Voltage - DC Reverse(Vr)=600V; Operating Junction Temperature Range=-55℃~+150℃; Current - Rectified=6A; Reverse Leakage Current (Ir)=10uA | https://www.lcsc.com/datasheet/lcsc_datasheet_2501211645_hongjiacheng-GBU606_C42406065.pdf | https://jlcpcb.com/partdetail/hongjiacheng-GBU606/C42406065
C42406067 | promotional_extended | Bridge Rectifiers | Bridge Rectifiers | GBU610 | hongjiacheng | GBU | -55℃~+150℃ 1.1V@3A 10uA 150A 1kV 6A Single-Phase Rectifier GBU Bridge Rectifiers ROHS | 781 | 0.26 | Voltage - Forward(Vf@If)=1.1V@3A; Type=Single-Phase Rectifier; Non-Repetitive Peak Forward Surge Current=150A; Voltage - DC Reverse(Vr)=1kV; Operating Junction Temperature Range=-55℃~+150℃; Current - Rectified=6A; Reverse Leakage Current (Ir)=10uA | https://www.lcsc.com/datasheet/lcsc_datasheet_2501211645_hongjiacheng-GBU610_C42406067.pdf | https://jlcpcb.com/partdetail/hongjiacheng-GBU610/C42406067
C42406072 | promotional_extended | Bridge Rectifiers | Bridge Rectifiers | GBU808 | hongjiacheng | GBU | -55℃~+150℃ 1.1V@8A 10uA 175A 800V 8A Single-Phase Rectifier GBU Bridge Rectifiers ROHS | 1756 | 0.1983 | Voltage - Forward(Vf@If)=1.1V@8A; Type=Single-Phase Rectifier; Non-Repetitive Peak Forward Surge Current=175A; Voltage - DC Reverse(Vr)=800V; Operating Junction Temperature Range=-55℃~+150℃; Current - Rectified=8A; Reverse Leakage Current (Ir)=10uA | https://www.lcsc.com/datasheet/lcsc_datasheet_2501211645_hongjiacheng-GBU808_C42406072.pdf | https://jlcpcb.com/partdetail/hongjiacheng-GBU808/C42406072
C42406070 | promotional_extended | Bridge Rectifiers | Bridge Rectifiers | GBU810 | hongjiacheng | GBU | -55℃~+150℃ 1.1V@8A 10uA 175A 1kV 8A Single-Phase Rectifier GBU Bridge Rectifiers ROHS | 716 | 0.286 | Voltage - Forward(Vf@If)=1.1V@8A; Type=Single-Phase Rectifier; Non-Repetitive Peak Forward Surge Current=175A; Voltage - DC Reverse(Vr)=1kV; Operating Junction Temperature Range=-55℃~+150℃; Current - Rectified=8A; Reverse Leakage Current (Ir)=10uA | https://www.lcsc.com/datasheet/lcsc_datasheet_2501211645_hongjiacheng-GBU810_C42406070.pdf | https://jlcpcb.com/partdetail/hongjiacheng-GBU810/C42406070
C42406073 | promotional_extended | Bridge Rectifiers | Bridge Rectifiers | KBJ410 | hongjiacheng | KBJ | -55℃~+150℃ 1.1V@4A 10uA 135A 1kV 4A Single-Phase Rectifier KBJ Bridge Rectifiers ROHS | 2505 | 0.2958 | Voltage - Forward(Vf@If)=1.1V@4A; Type=Single-Phase Rectifier; Non-Repetitive Peak Forward Surge Current=135A; Voltage - DC Reverse(Vr)=1kV; Operating Junction Temperature Range=-55℃~+150℃; Current - Rectified=4A; Reverse Leakage Current (Ir)=10uA | https://www.lcsc.com/datasheet/lcsc_datasheet_2501211645_hongjiacheng-KBJ410_C42406073.pdf | https://jlcpcb.com/partdetail/hongjiacheng-KBJ410/C42406073
C42406053 | promotional_extended | Bridge Rectifiers | Bridge Rectifiers | MSB30M | hongjiacheng | UMSB | -55℃~+150℃ 1.1V@3A 100A 1kV 3A 5uA Single-Phase Rectifier UMSB Bridge Rectifiers ROHS | 4286 | 0.0962 | Voltage - Forward(Vf@If)=1.1V@3A; Type=Single-Phase Rectifier; Non-Repetitive Peak Forward Surge Current=100A; Voltage - DC Reverse(Vr)=1kV; Operating Junction Temperature Range=-55℃~+150℃; Current - Rectified=3A; Reverse Leakage Current (Ir)=5uA | https://www.lcsc.com/datasheet/lcsc_datasheet_2501211645_hongjiacheng-MSB30M_C42406053.pdf | https://jlcpcb.com/partdetail/hongjiacheng-MSB30M/C42406053
C5625 | promotional_extended | Buffers, Drivers, Receivers, Transceivers | Buffers, Drivers, Receivers, Transceivers | 74HC245D,653 | Nexperia | SOIC-20-300mil | -40℃~+125℃ 1 160uA 2V~6V 7.8mA 7.8mA 74HC 8 9ns@4.5V,50pF Bidirectional Tri-State SOIC-20-300mil Buffers, Drivers, Receivers, Transceivers ROHS | 57331 | 0.2177 | Operating Temperature=-40℃~+125℃; Input type=-; Propagation Delay=9ns@4.5V,50pF; Number of Bits per Element=8; Voltage - Supply=2V~6V; Channel Type=Bidirectional; Quiescent Current=160uA; Current - Output High(IOH)=7.8mA; Features=Output enable; Number of Elements=1; Logic Family=74HC; Current - Output Low(IOL)=7.8mA; output type=Tri-State | https://www.lcsc.com/datasheet/lcsc_datasheet_2407241044_Nexperia-74HC245D-653_C5625.pdf | https://jlcpcb.com/partdetail/Nexperia-74HC245D653/C5625
C12084 | promotional_extended | CAN Transceivers | CAN Transceivers | SN65HVD230DR | Texas Instruments | SOIC-8 | -40℃~+85℃ 1 17mA 1Mbps 370uA 3V~3.6V CAN Transceiver Low-power mode、Wake-up function、ESD protection、Thermal shutdown protection、Bus fault protection、Hot-swap protection SOIC-8 CAN Transceivers ROHS | 86504 | 0.6334 | Operating Temperature=-40℃~+85℃; Type=CAN Transceiver; Number of Channels=1; Data Rate=1Mbps; Voltage - Supply=3V~3.6V; Features=Low-power mode、Wake-up function、ESD protection、Thermal shutdown protection、Bus fault protection、Hot-swap protection; Current - Supply=17mA; Quiescent Supply Current=370uA | https://www.lcsc.com/datasheet/lcsc_datasheet_2304140030_Texas-Instruments-SN65HVD230DR_C12084.pdf | https://jlcpcb.com/partdetail/TexasInstruments-SN65HVD230DR/C12084
C6952 | promotional_extended | CAN Transceivers | CAN Transceivers | TJA1050T/CM,118 | NXP Semicon | SOP-8 | 1Mbps 4.75V~5.25V 50mA CAN Transceiver SOP-8 CAN Transceivers ROHS | 221916 | 0.8461 | Type=CAN Transceiver; Data Rate=1Mbps; Voltage - Supply=4.75V~5.25V; Features=TXD dominant timeout、ESD protection、Thermal shutdown protection、Bus fault protection、Short-Circuit Protection、Silent mode、Integrated level shifting; Current - Supply=50mA | https://www.nxp.com/docs/en/data-sheet/TJA1050.pdf | https://jlcpcb.com/partdetail/NXPSemicon-TJA1050T_CM118/C6952
C7881 | promotional_extended | Charge Pumps | Charge Pumps | ICL7660AIBAZA-T | RENESAS | SOIC-8 | -12V~-1.5V -40℃~+85℃ 1.5V~12V 100uA 8kHz 97Ω 98% Inverted SOIC-8 Charge Pumps ROHS | 19197 | 0.9858 | Function=Inverted; Operating Temperature=-40℃~+85℃; Output Resistance=97Ω; Operating Voltage=1.5V~12V; Quiescent Current=100uA; Features=Cascade support、Charge pump / inverting topology switching、Adaptive switching frequency; Switching Frequency=8kHz; Output Voltage=-12V~-1.5V; Energy Efficiency=98% | https://www.lcsc.com/datasheet/lcsc_datasheet_1811051712_RENESAS-ICL7660AIBAZA-T_C7881.pdf | https://jlcpcb.com/partdetail/RENESAS-ICL7660AIBAZAT/C7881
C26082 | promotional_extended | Chip Resistor - Surface Mount | Chip Resistor - Surface Mount | 0402WGF1005TCE | UNI-ROYAL(Uniroyal Elec) | 0402 | -55℃~+155℃ 10MΩ 50V 62.5mW Thick Film Resistor ±1% ±200ppm/℃ 0402 Chip Resistor - Surface Mount ROHS | 2 | 0.0008 | Resistance=10MΩ; Operating Temperature=-55℃~+155℃; Power(Watts)=62.5mW; Type=Thick Film Resistor; Voltage-Supply(Max)=50V; Tolerance=±1%; Temperature Coefficient=±200ppm/℃ | https://www.lcsc.com/datasheet/lcsc_datasheet_2411221126_UNI-ROYAL-Uniroyal-Elec-0402WGF1005TCE_C26082.pdf | https://jlcpcb.com/partdetail/26825-0402WGF1005TCE/C26082
C25086 | promotional_extended | Chip Resistor - Surface Mount | Chip Resistor - Surface Mount | 0402WGF100KTCE | UNI-ROYAL(Uniroyal Elec) | 0402 | -55℃~+155℃ 1Ω 50V 62.5mW Thick Film Resistor ±1% ±200ppm/℃ 0402 Chip Resistor - Surface Mount ROHS | 53569 | 0.0039 | Resistance=1Ω; Operating Temperature=-55℃~+155℃; Power(Watts)=62.5mW; Type=Thick Film Resistor; Voltage-Supply(Max)=50V; Tolerance=±1%; Temperature Coefficient=±200ppm/℃ | https://www.lcsc.com/datasheet/lcsc_datasheet_2205311900_UNI-ROYAL-Uniroyal-Elec-0402WGF100KTCE_C25086.pdf | https://jlcpcb.com/partdetail/25829-0402WGF100KTCE/C25086
C25862 | promotional_extended | Chip Resistor - Surface Mount | Chip Resistor - Surface Mount | 0402WGF1201TCE | UNI-ROYAL(Uniroyal Elec) | 0402 | -55℃~+155℃ 1.2kΩ 50V 62.5mW Thick Film Resistor ±1% ±100ppm/℃ 0402 Chip Resistor - Surface Mount ROHS | 190380 | 0.0023 | Resistance=1.2kΩ; Operating Temperature=-55℃~+155℃; Power(Watts)=62.5mW; Type=Thick Film Resistor; Voltage-Supply(Max)=50V; Tolerance=±1%; Temperature Coefficient=±100ppm/℃ | https://www.lcsc.com/datasheet/lcsc_datasheet_2206010045_UNI-ROYAL-Uniroyal-Elec-0402WGF1201TCE_C25862.pdf | https://jlcpcb.com/partdetail/26605-0402WGF1201TCE/C25862
C25750 | promotional_extended | Chip Resistor - Surface Mount | Chip Resistor - Surface Mount | 0402WGF1203TCE | UNI-ROYAL(Uniroyal Elec) | 0402 | -55℃~+155℃ 120kΩ 50V 62.5mW Thick Film Resistor ±1% ±100ppm/℃ 0402 Chip Resistor - Surface Mount ROHS | 692488 | 0.0012 | Resistance=120kΩ; Operating Temperature=-55℃~+155℃; Power(Watts)=62.5mW; Type=Thick Film Resistor; Voltage-Supply(Max)=50V; Tolerance=±1%; Temperature Coefficient=±100ppm/℃ | https://www.lcsc.com/datasheet/lcsc_datasheet_2206010100_UNI-ROYAL-Uniroyal-Elec-0402WGF1203TCE_C25750.pdf | https://jlcpcb.com/partdetail/26493-0402WGF1203TCE/C25750
C25082 | promotional_extended | Chip Resistor - Surface Mount | Chip Resistor - Surface Mount | 0402WGF1500TCE | UNI-ROYAL(Uniroyal Elec) | 0402 | -55℃~+155℃ 150Ω 50V 62.5mW Thick Film Resistor ±1% ±100ppm/℃ 0402 Chip Resistor - Surface Mount ROHS | 162891 | 0.0017 | Resistance=150Ω; Operating Temperature=-55℃~+155℃; Power(Watts)=62.5mW; Type=Thick Film Resistor; Voltage-Supply(Max)=50V; Tolerance=±1%; Temperature Coefficient=±100ppm/℃ | https://www.lcsc.com/datasheet/lcsc_datasheet_2205311900_UNI-ROYAL-Uniroyal-Elec-0402WGF1500TCE_C25082.pdf | https://jlcpcb.com/partdetail/25825-0402WGF1500TCE/C25082
C25755 | promotional_extended | Chip Resistor - Surface Mount | Chip Resistor - Surface Mount | 0402WGF1503TCE | UNI-ROYAL(Uniroyal Elec) | 0402 | -55℃~+155℃ 150kΩ 50V 62.5mW Thick Film Resistor ±1% ±100ppm/℃ 0402 Chip Resistor - Surface Mount ROHS | 300302 | 0.0014 | Resistance=150kΩ; Operating Temperature=-55℃~+155℃; Power(Watts)=62.5mW; Type=Thick Film Resistor; Voltage-Supply(Max)=50V; Tolerance=±1%; Temperature Coefficient=±100ppm/℃ | https://www.lcsc.com/datasheet/lcsc_datasheet_2206010100_UNI-ROYAL-Uniroyal-Elec-0402WGF1503TCE_C25755.pdf | https://jlcpcb.com/partdetail/26498-0402WGF1503TCE/C25755
C25762 | promotional_extended | Chip Resistor - Surface Mount | Chip Resistor - Surface Mount | 0402WGF1802TCE | UNI-ROYAL(Uniroyal Elec) | 0402 | -55℃~+155℃ 18kΩ 50V 62.5mW Thick Film Resistor ±1% ±100ppm/℃ 0402 Chip Resistor - Surface Mount ROHS | 565266 | 0.0014 | Resistance=18kΩ; Operating Temperature=-55℃~+155℃; Power(Watts)=62.5mW; Type=Thick Film Resistor; Voltage-Supply(Max)=50V; Tolerance=±1%; Temperature Coefficient=±100ppm/℃ | https://www.lcsc.com/datasheet/lcsc_datasheet_2206010100_UNI-ROYAL-Uniroyal-Elec-0402WGF1802TCE_C25762.pdf | https://jlcpcb.com/partdetail/26505-0402WGF1802TCE/C25762
C25767 | promotional_extended | Chip Resistor - Surface Mount | Chip Resistor - Surface Mount | 0402WGF2203TCE | UNI-ROYAL(Uniroyal Elec) | 0402 | -55℃~+155℃ 220kΩ 50V 62.5mW Thick Film Resistor ±1% ±100ppm/℃ 0402 Chip Resistor - Surface Mount ROHS | 102661 | 0.0022 | Resistance=220kΩ; Operating Temperature=-55℃~+155℃; Power(Watts)=62.5mW; Type=Thick Film Resistor; Voltage-Supply(Max)=50V; Tolerance=±1%; Temperature Coefficient=±100ppm/℃ | https://www.lcsc.com/datasheet/lcsc_datasheet_2206010100_UNI-ROYAL-Uniroyal-Elec-0402WGF2203TCE_C25767.pdf | https://jlcpcb.com/partdetail/26510-0402WGF2203TCE/C25767
C25882 | promotional_extended | Chip Resistor - Surface Mount | Chip Resistor - Surface Mount | 0402WGF2401TCE | UNI-ROYAL(Uniroyal Elec) | 0402 | -55℃~+155℃ 2.4kΩ 50V 62.5mW Thick Film Resistor ±1% ±100ppm/℃ 0402 Chip Resistor - Surface Mount ROHS | 256195 | 0.0017 | Resistance=2.4kΩ; Operating Temperature=-55℃~+155℃; Power(Watts)=62.5mW; Type=Thick Film Resistor; Voltage-Supply(Max)=50V; Tolerance=±1%; Temperature Coefficient=±100ppm/℃ | https://www.lcsc.com/datasheet/lcsc_datasheet_2206010045_UNI-ROYAL-Uniroyal-Elec-0402WGF2401TCE_C25882.pdf | https://jlcpcb.com/partdetail/26625-0402WGF2401TCE/C25882
C25769 | promotional_extended | Chip Resistor - Surface Mount | Chip Resistor - Surface Mount | 0402WGF2402TCE | UNI-ROYAL(Uniroyal Elec) | 0402 | -55℃~+155℃ 24kΩ 50V 62.5mW Thick Film Resistor ±1% ±100ppm/℃ 0402 Chip Resistor - Surface Mount ROHS | 92098 | 0.0046 | Resistance=24kΩ; Operating Temperature=-55℃~+155℃; Power(Watts)=62.5mW; Type=Thick Film Resistor; Voltage-Supply(Max)=50V; Tolerance=±1%; Temperature Coefficient=±100ppm/℃ | https://www.lcsc.com/datasheet/lcsc_datasheet_2206010100_UNI-ROYAL-Uniroyal-Elec-0402WGF2402TCE_C25769.pdf | https://jlcpcb.com/partdetail/26512-0402WGF2402TCE/C25769
C25771 | promotional_extended | Chip Resistor - Surface Mount | Chip Resistor - Surface Mount | 0402WGF2702TCE | UNI-ROYAL(Uniroyal Elec) | 0402 | -55℃~+155℃ 27kΩ 50V 62.5mW Thick Film Resistor ±1% ±100ppm/℃ 0402 Chip Resistor - Surface Mount ROHS | 329080 | 0.0017 | Resistance=27kΩ; Operating Temperature=-55℃~+155℃; Power(Watts)=62.5mW; Type=Thick Film Resistor; Voltage-Supply(Max)=50V; Tolerance=±1%; Temperature Coefficient=±100ppm/℃ | https://www.lcsc.com/datasheet/lcsc_datasheet_2206010100_UNI-ROYAL-Uniroyal-Elec-0402WGF2702TCE_C25771.pdf | https://jlcpcb.com/partdetail/26514-0402WGF2702TCE/C25771
C25102 | promotional_extended | Chip Resistor - Surface Mount | Chip Resistor - Surface Mount | 0402WGF3000TCE | UNI-ROYAL(Uniroyal Elec) | 0402 | -55℃~+155℃ 300Ω 50V 62.5mW Thick Film Resistor ±1% ±100ppm/℃ 0402 Chip Resistor - Surface Mount ROHS | 857031 | 0.0021 | Resistance=300Ω; Operating Temperature=-55℃~+155℃; Power(Watts)=62.5mW; Type=Thick Film Resistor; Voltage-Supply(Max)=50V; Tolerance=±1%; Temperature Coefficient=±100ppm/℃ | https://www.lcsc.com/datasheet/lcsc_datasheet_2205311900_UNI-ROYAL-Uniroyal-Elec-0402WGF3000TCE_C25102.pdf | https://jlcpcb.com/partdetail/25845-0402WGF3000TCE/C25102
C25774 | promotional_extended | Chip Resistor - Surface Mount | Chip Resistor - Surface Mount | 0402WGF3003TCE | UNI-ROYAL(Uniroyal Elec) | 0402 | -55℃~+155℃ 300kΩ 50V 62.5mW Thick Film Resistor ±1% ±100ppm/℃ 0402 Chip Resistor - Surface Mount ROHS | 312279 | 0.0019 | Resistance=300kΩ; Operating Temperature=-55℃~+155℃; Power(Watts)=62.5mW; Type=Thick Film Resistor; Voltage-Supply(Max)=50V; Tolerance=±1%; Temperature Coefficient=±100ppm/℃ | https://www.lcsc.com/datasheet/lcsc_datasheet_2206010100_UNI-ROYAL-Uniroyal-Elec-0402WGF3003TCE_C25774.pdf | https://jlcpcb.com/partdetail/26517-0402WGF3003TCE/C25774
C25778 | promotional_extended | Chip Resistor - Surface Mount | Chip Resistor - Surface Mount | 0402WGF3303TCE | UNI-ROYAL(Uniroyal Elec) | 0402 | -55℃~+155℃ 330kΩ 50V 62.5mW Thick Film Resistor ±1% ±100ppm/℃ 0402 Chip Resistor - Surface Mount ROHS | 162626 | 0.0029 | Resistance=330kΩ; Operating Temperature=-55℃~+155℃; Power(Watts)=62.5mW; Type=Thick Film Resistor; Voltage-Supply(Max)=50V; Tolerance=±1%; Temperature Coefficient=±100ppm/℃ | https://www.lcsc.com/datasheet/lcsc_datasheet_2206010100_UNI-ROYAL-Uniroyal-Elec-0402WGF3303TCE_C25778.pdf | https://jlcpcb.com/partdetail/26521-0402WGF3303TCE/C25778
C51721 | promotional_extended | Chip Resistor - Surface Mount | Chip Resistor - Surface Mount | 0402WGF3901TCE | UNI-ROYAL(Uniroyal Elec) | 0402 | -55℃~+155℃ 3.9kΩ 50V 62.5mW Thick Film Resistor ±1% ±100ppm/℃ 0402 Chip Resistor - Surface Mount ROHS | 45536 | 0.0016 | Resistance=3.9kΩ; Operating Temperature=-55℃~+155℃; Power(Watts)=62.5mW; Type=Thick Film Resistor; Voltage-Supply(Max)=50V; Tolerance=±1%; Temperature Coefficient=±100ppm/℃ | https://www.lcsc.com/datasheet/lcsc_datasheet_2206010000_UNI-ROYAL-Uniroyal-Elec-0402WGF3901TCE_C51721.pdf | https://jlcpcb.com/partdetail/52734-0402WGF3901TCE/C51721
C25783 | promotional_extended | Chip Resistor - Surface Mount | Chip Resistor - Surface Mount | 0402WGF3902TCE | UNI-ROYAL(Uniroyal Elec) | 0402 | -55℃~+155℃ 39kΩ 50V 62.5mW Thick Film Resistor ±1% ±100ppm/℃ 0402 Chip Resistor - Surface Mount ROHS | 227338 | 0.0024 | Resistance=39kΩ; Operating Temperature=-55℃~+155℃; Power(Watts)=62.5mW; Type=Thick Film Resistor; Voltage-Supply(Max)=50V; Tolerance=±1%; Temperature Coefficient=±100ppm/℃ | https://www.lcsc.com/datasheet/lcsc_datasheet_2206010100_UNI-ROYAL-Uniroyal-Elec-0402WGF3902TCE_C25783.pdf | https://jlcpcb.com/partdetail/26526-0402WGF3902TCE/C25783
C25790 | promotional_extended | Chip Resistor - Surface Mount | Chip Resistor - Surface Mount | 0402WGF4703TCE | UNI-ROYAL(Uniroyal Elec) | 0402 | -55℃~+155℃ 470kΩ 50V 62.5mW Thick Film Resistor ±1% ±100ppm/℃ 0402 Chip Resistor - Surface Mount ROHS | 310241 | 0.003 | Resistance=470kΩ; Operating Temperature=-55℃~+155℃; Power(Watts)=62.5mW; Type=Thick Film Resistor; Voltage-Supply(Max)=50V; Tolerance=±1%; Temperature Coefficient=±100ppm/℃ | https://www.lcsc.com/datasheet/lcsc_datasheet_2206010100_UNI-ROYAL-Uniroyal-Elec-0402WGF4703TCE_C25790.pdf | https://jlcpcb.com/partdetail/26533-0402WGF4703TCE/C25790
C25118 | promotional_extended | Chip Resistor - Surface Mount | Chip Resistor - Surface Mount | 0402WGF470JTCE | UNI-ROYAL(Uniroyal Elec) | 0402 | -55℃~+155℃ 47Ω 50V 62.5mW Thick Film Resistor ±1% ±100ppm/℃ 0402 Chip Resistor - Surface Mount ROHS | 457986 | 0.0023 | Resistance=47Ω; Operating Temperature=-55℃~+155℃; Power(Watts)=62.5mW; Type=Thick Film Resistor; Voltage-Supply(Max)=50V; Tolerance=±1%; Temperature Coefficient=±100ppm/℃ | https://www.lcsc.com/datasheet/lcsc_datasheet_2205311900_UNI-ROYAL-Uniroyal-Elec-0402WGF470JTCE_C25118.pdf | https://jlcpcb.com/partdetail/25861-0402WGF470JTCE/C25118
C25897 | promotional_extended | Chip Resistor - Surface Mount | Chip Resistor - Surface Mount | 0402WGF4992TCE | UNI-ROYAL(Uniroyal Elec) | 0402 | -55℃~+155℃ 49.9kΩ 50V 62.5mW Thick Film Resistor ±1% ±100ppm/℃ 0402 Chip Resistor - Surface Mount ROHS | 51246 | 0.0015 | Resistance=49.9kΩ; Operating Temperature=-55℃~+155℃; Power(Watts)=62.5mW; Type=Thick Film Resistor; Voltage-Supply(Max)=50V; Tolerance=±1%; Temperature Coefficient=±100ppm/℃ | https://www.lcsc.com/datasheet/lcsc_datasheet_2206010045_UNI-ROYAL-Uniroyal-Elec-0402WGF4992TCE_C25897.pdf | https://jlcpcb.com/partdetail/26640-0402WGF4992TCE/C25897
C11616 | promotional_extended | Chip Resistor - Surface Mount | Chip Resistor - Surface Mount | 0402WGF5103TCE | UNI-ROYAL(Uniroyal Elec) | 0402 | -55℃~+155℃ 50V 510kΩ 62.5mW Thick Film Resistor ±1% ±100ppm/℃ 0402 Chip Resistor - Surface Mount ROHS | 8260 | 0.0051 | Resistance=510kΩ; Operating Temperature=-55℃~+155℃; Power(Watts)=62.5mW; Type=Thick Film Resistor; Voltage-Supply(Max)=50V; Tolerance=±1%; Temperature Coefficient=±100ppm/℃ | https://www.lcsc.com/datasheet/lcsc_datasheet_2206010216_UNI-ROYAL-Uniroyal-Elec-0402WGF5103TCE_C11616.pdf | https://jlcpcb.com/partdetail/12170-0402WGF5103TCE/C11616
C25125 | promotional_extended | Chip Resistor - Surface Mount | Chip Resistor - Surface Mount | 0402WGF510JTCE | UNI-ROYAL(Uniroyal Elec) | 0402 | -55℃~+155℃ 50V 51Ω 62.5mW Thick Film Resistor ±1% ±100ppm/℃ 0402 Chip Resistor - Surface Mount ROHS | 110376 | 0.0038 | Resistance=51Ω; Operating Temperature=-55℃~+155℃; Power(Watts)=62.5mW; Type=Thick Film Resistor; Voltage-Supply(Max)=50V; Tolerance=±1%; Temperature Coefficient=±100ppm/℃ | https://www.lcsc.com/datasheet/lcsc_datasheet_2205311900_UNI-ROYAL-Uniroyal-Elec-0402WGF510JTCE_C25125.pdf | https://jlcpcb.com/partdetail/25868-0402WGF510JTCE/C25125
C25908 | promotional_extended | Chip Resistor - Surface Mount | Chip Resistor - Surface Mount | 0402WGF5601TCE | UNI-ROYAL(Uniroyal Elec) | 0402 | -55℃~+155℃ 5.6kΩ 50V 62.5mW Thick Film Resistor ±1% ±100ppm/℃ 0402 Chip Resistor - Surface Mount ROHS | 220299 | 0.0035 | Resistance=5.6kΩ; Operating Temperature=-55℃~+155℃; Power(Watts)=62.5mW; Type=Thick Film Resistor; Voltage-Supply(Max)=50V; Tolerance=±1%; Temperature Coefficient=±100ppm/℃ | https://www.lcsc.com/datasheet/lcsc_datasheet_2206010045_UNI-ROYAL-Uniroyal-Elec-0402WGF5601TCE_C25908.pdf | https://jlcpcb.com/partdetail/26651-0402WGF5601TCE/C25908
C25796 | promotional_extended | Chip Resistor - Surface Mount | Chip Resistor - Surface Mount | 0402WGF5602TCE | UNI-ROYAL(Uniroyal Elec) | 0402 | -55℃~+155℃ 50V 56kΩ 62.5mW Thick Film Resistor ±1% ±100ppm/℃ 0402 Chip Resistor - Surface Mount ROHS | 226422 | 0.003 | Resistance=56kΩ; Operating Temperature=-55℃~+155℃; Power(Watts)=62.5mW; Type=Thick Film Resistor; Voltage-Supply(Max)=50V; Tolerance=±1%; Temperature Coefficient=±100ppm/℃ | https://www.lcsc.com/datasheet/lcsc_datasheet_2411221126_UNI-ROYAL-Uniroyal-Elec-0402WGF5602TCE_C25796.pdf | https://jlcpcb.com/partdetail/26539-0402WGF5602TCE/C25796
C25130 | promotional_extended | Chip Resistor - Surface Mount | Chip Resistor - Surface Mount | 0402WGF6800TCE | UNI-ROYAL(Uniroyal Elec) | 0402 | -55℃~+155℃ 50V 62.5mW 680Ω Thick Film Resistor ±1% ±100ppm/℃ 0402 Chip Resistor - Surface Mount ROHS | 1017 | 0.0015 | Resistance=680Ω; Operating Temperature=-55℃~+155℃; Power(Watts)=62.5mW; Type=Thick Film Resistor; Voltage-Supply(Max)=50V; Tolerance=±1%; Temperature Coefficient=±100ppm/℃ | https://www.lcsc.com/datasheet/lcsc_datasheet_2205311900_UNI-ROYAL-Uniroyal-Elec-0402WGF6800TCE_C25130.pdf | https://jlcpcb.com/partdetail/25873-0402WGF6800TCE/C25130
C25917 | promotional_extended | Chip Resistor - Surface Mount | Chip Resistor - Surface Mount | 0402WGF6801TCE | UNI-ROYAL(Uniroyal Elec) | 0402 | -55℃~+155℃ 50V 6.8kΩ 62.5mW Thick Film Resistor ±1% ±100ppm/℃ 0402 Chip Resistor - Surface Mount ROHS | 165750 | 0.0015 | Resistance=6.8kΩ; Operating Temperature=-55℃~+155℃; Power(Watts)=62.5mW; Type=Thick Film Resistor; Voltage-Supply(Max)=50V; Tolerance=±1%; Temperature Coefficient=±100ppm/℃ | https://www.lcsc.com/datasheet/lcsc_datasheet_2206010045_UNI-ROYAL-Uniroyal-Elec-0402WGF6801TCE_C25917.pdf | https://jlcpcb.com/partdetail/26660-0402WGF6801TCE/C25917
C36871 | promotional_extended | Chip Resistor - Surface Mount | Chip Resistor - Surface Mount | 0402WGF6802TCE | UNI-ROYAL(Uniroyal Elec) | 0402 | -55℃~+155℃ 50V 62.5mW 68kΩ Thick Film Resistor ±1% ±100ppm/℃ 0402 Chip Resistor - Surface Mount ROHS | 258990 | 0.002 | Resistance=68kΩ; Operating Temperature=-55℃~+155℃; Power(Watts)=62.5mW; Type=Thick Film Resistor; Voltage-Supply(Max)=50V; Tolerance=±1%; Temperature Coefficient=±100ppm/℃ | https://www.lcsc.com/datasheet/lcsc_datasheet_2206010030_UNI-ROYAL-Uniroyal-Elec-0402WGF6802TCE_C36871.pdf | https://jlcpcb.com/partdetail/37849-0402WGF6802TCE/C36871
C25918 | promotional_extended | Chip Resistor - Surface Mount | Chip Resistor - Surface Mount | 0402WGF7501TCE | UNI-ROYAL(Uniroyal Elec) | 0402 | -55℃~+155℃ 50V 62.5mW 7.5kΩ Thick Film Resistor ±1% ±100ppm/℃ 0402 Chip Resistor - Surface Mount ROHS | 1207135 | 0.0021 | Resistance=7.5kΩ; Operating Temperature=-55℃~+155℃; Power(Watts)=62.5mW; Type=Thick Film Resistor; Voltage-Supply(Max)=50V; Tolerance=±1%; Temperature Coefficient=±100ppm/℃ | https://www.lcsc.com/datasheet/lcsc_datasheet_2206010045_UNI-ROYAL-Uniroyal-Elec-0402WGF7501TCE_C25918.pdf | https://jlcpcb.com/partdetail/26661-0402WGF7501TCE/C25918
C25798 | promotional_extended | Chip Resistor - Surface Mount | Chip Resistor - Surface Mount | 0402WGF7502TCE | UNI-ROYAL(Uniroyal Elec) | 0402 | -55℃~+155℃ 50V 62.5mW 75kΩ Thick Film Resistor ±1% ±100ppm/℃ 0402 Chip Resistor - Surface Mount ROHS | 54026 | 0.003 | Resistance=75kΩ; Operating Temperature=-55℃~+155℃; Power(Watts)=62.5mW; Type=Thick Film Resistor; Voltage-Supply(Max)=50V; Tolerance=±1%; Temperature Coefficient=±100ppm/℃ | https://www.lcsc.com/datasheet/lcsc_datasheet_2206010045_UNI-ROYAL-Uniroyal-Elec-0402WGF7502TCE_C25798.pdf | https://jlcpcb.com/partdetail/26541-0402WGF7502TCE/C25798
C25133 | promotional_extended | Chip Resistor - Surface Mount | Chip Resistor - Surface Mount | 0402WGF750JTCE | UNI-ROYAL(Uniroyal Elec) | 0402 | -55℃~+155℃ 50V 62.5mW 75Ω Thick Film Resistor ±1% ±100ppm/℃ 0402 Chip Resistor - Surface Mount ROHS | 634024 | 0.0026 | Resistance=75Ω; Operating Temperature=-55℃~+155℃; Power(Watts)=62.5mW; Type=Thick Film Resistor; Voltage-Supply(Max)=50V; Tolerance=±1%; Temperature Coefficient=±100ppm/℃ | https://www.lcsc.com/datasheet/lcsc_datasheet_2205311900_UNI-ROYAL-Uniroyal-Elec-0402WGF750JTCE_C25133.pdf | https://jlcpcb.com/partdetail/25876-0402WGF750JTCE/C25133
C25924 | promotional_extended | Chip Resistor - Surface Mount | Chip Resistor - Surface Mount | 0402WGF8201TCE | UNI-ROYAL(Uniroyal Elec) | 0402 | -55℃~+155℃ 50V 62.5mW 8.2kΩ Thick Film Resistor ±1% ±100ppm/℃ 0402 Chip Resistor - Surface Mount ROHS | 132760 | 0.002 | Resistance=8.2kΩ; Operating Temperature=-55℃~+155℃; Power(Watts)=62.5mW; Type=Thick Film Resistor; Voltage-Supply(Max)=50V; Tolerance=±1%; Temperature Coefficient=±100ppm/℃ | https://www.lcsc.com/datasheet/lcsc_datasheet_2206010045_UNI-ROYAL-Uniroyal-Elec-0402WGF8201TCE_C25924.pdf | https://jlcpcb.com/partdetail/26667-0402WGF8201TCE/C25924
C22764 | promotional_extended | Chip Resistor - Surface Mount | Chip Resistor - Surface Mount | 0603WAF1101T5E | UNI-ROYAL(Uniroyal Elec) | 0603 | -55℃~+155℃ 1.1kΩ 100mW 75V Thick Film Resistor ±1% ±100ppm/℃ 0603 Chip Resistor - Surface Mount ROHS | 235041 | 0.0018 | Resistance=1.1kΩ; Operating Temperature=-55℃~+155℃; Power(Watts)=100mW; Type=Thick Film Resistor; Voltage-Supply(Max)=75V; Tolerance=±1%; Temperature Coefficient=±100ppm/℃ | https://www.lcsc.com/datasheet/lcsc_datasheet_2206010130_UNI-ROYAL-Uniroyal-Elec-0603WAF1101T5E_C22764.pdf | https://jlcpcb.com/partdetail/23491-0603WAF1101T5E/C22764
C25950 | promotional_extended | Chip Resistor - Surface Mount | Chip Resistor - Surface Mount | 0603WAF1102T5E | UNI-ROYAL(Uniroyal Elec) | 0603 | -55℃~+155℃ 100mW 11kΩ 75V Thick Film Resistor ±1% ±100ppm/℃ 0603 Chip Resistor - Surface Mount ROHS | 341540 | 0.0019 | Resistance=11kΩ; Operating Temperature=-55℃~+155℃; Power(Watts)=100mW; Type=Thick Film Resistor; Voltage-Supply(Max)=75V; Tolerance=±1%; Temperature Coefficient=±100ppm/℃ | https://www.lcsc.com/datasheet/lcsc_datasheet_2206010045_UNI-ROYAL-Uniroyal-Elec-0603WAF1102T5E_C25950.pdf | https://jlcpcb.com/partdetail/26693-0603WAF1102T5E/C25950
C25805 | promotional_extended | Chip Resistor - Surface Mount | Chip Resistor - Surface Mount | 0603WAF1103T5E | UNI-ROYAL(Uniroyal Elec) | 0603 | -55℃~+155℃ 100mW 110kΩ 75V Thick Film Resistor ±1% ±100ppm/℃ 0603 Chip Resistor - Surface Mount ROHS | 171987 | 0.0043 | Resistance=110kΩ; Operating Temperature=-55℃~+155℃; Power(Watts)=100mW; Type=Thick Film Resistor; Voltage-Supply(Max)=75V; Tolerance=±1%; Temperature Coefficient=±100ppm/℃ | https://www.lcsc.com/datasheet/lcsc_datasheet_2206010045_UNI-ROYAL-Uniroyal-Elec-0603WAF1103T5E_C25805.pdf | https://jlcpcb.com/partdetail/26548-0603WAF1103T5E/C25805
C22795 | promotional_extended | Chip Resistor - Surface Mount | Chip Resistor - Surface Mount | 0603WAF1303T5E | UNI-ROYAL(Uniroyal Elec) | 0603 | -55℃~+155℃ 100mW 130kΩ 75V Thick Film Resistor ±1% ±100ppm/℃ 0603 Chip Resistor - Surface Mount ROHS | 604956 | 0.0014 | Resistance=130kΩ; Operating Temperature=-55℃~+155℃; Power(Watts)=100mW; Type=Thick Film Resistor; Voltage-Supply(Max)=75V; Tolerance=±1%; Temperature Coefficient=±100ppm/℃ | https://www.lcsc.com/datasheet/lcsc_datasheet_2206010130_UNI-ROYAL-Uniroyal-Elec-0603WAF1303T5E_C22795.pdf | https://jlcpcb.com/partdetail/23522-0603WAF1303T5E/C22795
C4172 | promotional_extended | Chip Resistor - Surface Mount | Chip Resistor - Surface Mount | 0603WAF1504T5E | UNI-ROYAL(Uniroyal Elec) | 0603 | -55℃~+155℃ 1.5MΩ 100mW 75V Thick Film Resistor ±1% ±100ppm/℃ 0603 Chip Resistor - Surface Mount ROHS | 218167 | 0.0019 | Resistance=1.5MΩ; Operating Temperature=-55℃~+155℃; Power(Watts)=100mW; Type=Thick Film Resistor; Voltage-Supply(Max)=75V; Tolerance=±1%; Temperature Coefficient=±100ppm/℃ | https://www.lcsc.com/datasheet/lcsc_datasheet_2206010230_UNI-ROYAL-Uniroyal-Elec-0603WAF1504T5E_C4172.pdf | https://jlcpcb.com/partdetail/4579-0603WAF1504T5E/C4172
C22810 | promotional_extended | Chip Resistor - Surface Mount | Chip Resistor - Surface Mount | 0603WAF150JT5E | UNI-ROYAL(Uniroyal Elec) | 0603 | -55℃~+155℃ 100mW 15Ω 75V Thick Film Resistor ±1% ±100ppm/℃ 0603 Chip Resistor - Surface Mount ROHS | 392192 | 0.0015 | Resistance=15Ω; Operating Temperature=-55℃~+155℃; Power(Watts)=100mW; Type=Thick Film Resistor; Voltage-Supply(Max)=75V; Tolerance=±1%; Temperature Coefficient=±100ppm/℃ | https://www.lcsc.com/datasheet/lcsc_datasheet_2206010130_UNI-ROYAL-Uniroyal-Elec-0603WAF150JT5E_C22810.pdf | https://jlcpcb.com/partdetail/23537-0603WAF150JT5E/C22810
C22818 | promotional_extended | Chip Resistor - Surface Mount | Chip Resistor - Surface Mount | 0603WAF1602T5E (SMTonly) | UNI-ROYAL(Uniroyal Elec) | 0603 | 16kΩ ±1% 0603 Chip Resistor - Surface Mount ROHS | 8 | 0.0013 | Resistance=16kΩ; Power(Watts)=-; Type=-; Voltage-Supply(Max)=-; Tolerance=±1% | https://datasheet.lcsc.com/lcsc/1811081724_UNI-ROYAL-Uniroyal-Elec-0603WAF1602T5E_C22818.pdf | https://jlcpcb.com/partdetail/23545-0603WAF1602T5E_SMTonly/C22818
C22813 | promotional_extended | Chip Resistor - Surface Mount | Chip Resistor - Surface Mount | 0603WAF1603T5E | UNI-ROYAL(Uniroyal Elec) | 0603 | -55℃~+155℃ 100mW 160kΩ 75V Thick Film Resistor ±1% ±100ppm/℃ 0603 Chip Resistor - Surface Mount ROHS | 170997 | 0.0022 | Resistance=160kΩ; Operating Temperature=-55℃~+155℃; Power(Watts)=100mW; Type=Thick Film Resistor; Voltage-Supply(Max)=75V; Tolerance=±1%; Temperature Coefficient=±100ppm/℃ | https://www.lcsc.com/datasheet/lcsc_datasheet_2206010130_UNI-ROYAL-Uniroyal-Elec-0603WAF1603T5E_C22813.pdf | https://jlcpcb.com/partdetail/23540-0603WAF1603T5E/C22813
C22828 | promotional_extended | Chip Resistor - Surface Mount | Chip Resistor - Surface Mount | 0603WAF1800T5E | UNI-ROYAL(Uniroyal Elec) | 0603 | -55℃~+155℃ 100mW 180Ω 75V Thick Film Resistor ±1% ±100ppm/℃ 0603 Chip Resistor - Surface Mount ROHS | 2453223 | 0.0018 | Resistance=180Ω; Operating Temperature=-55℃~+155℃; Power(Watts)=100mW; Type=Thick Film Resistor; Voltage-Supply(Max)=75V; Tolerance=±1%; Temperature Coefficient=±100ppm/℃ | https://www.lcsc.com/datasheet/lcsc_datasheet_2206010130_UNI-ROYAL-Uniroyal-Elec-0603WAF1800T5E_C22828.pdf | https://jlcpcb.com/partdetail/23555-0603WAF1800T5E/C22828
C22827 | promotional_extended | Chip Resistor - Surface Mount | Chip Resistor - Surface Mount | 0603WAF1803T5E | UNI-ROYAL(Uniroyal Elec) | 0603 | -55℃~+155℃ 100mW 180kΩ 75V Thick Film Resistor ±1% ±100ppm/℃ 0603 Chip Resistor - Surface Mount ROHS | 280926 | 0.0016 | Resistance=180kΩ; Operating Temperature=-55℃~+155℃; Power(Watts)=100mW; Type=Thick Film Resistor; Voltage-Supply(Max)=75V; Tolerance=±1%; Temperature Coefficient=±100ppm/℃ | https://www.lcsc.com/datasheet/lcsc_datasheet_2206010130_UNI-ROYAL-Uniroyal-Elec-0603WAF1803T5E_C22827.pdf | https://jlcpcb.com/partdetail/23554-0603WAF1803T5E/C22827
C22938 | promotional_extended | Chip Resistor - Surface Mount | Chip Resistor - Surface Mount | 0603WAF2204T5E | UNI-ROYAL(Uniroyal Elec) | 0603 | -55℃~+155℃ 100mW 2.2MΩ 75V Thick Film Resistor ±1% ±100ppm/℃ 0603 Chip Resistor - Surface Mount ROHS | 179720 | 0.0023 | Resistance=2.2MΩ; Operating Temperature=-55℃~+155℃; Power(Watts)=100mW; Type=Thick Film Resistor; Voltage-Supply(Max)=75V; Tolerance=±1%; Temperature Coefficient=±100ppm/℃ | https://www.lcsc.com/datasheet/lcsc_datasheet_2206010130_UNI-ROYAL-Uniroyal-Elec-0603WAF2204T5E_C22938.pdf | https://jlcpcb.com/partdetail/23665-0603WAF2204T5E/C22938
C23350 | promotional_extended | Chip Resistor - Surface Mount | Chip Resistor - Surface Mount | 0603WAF2400T5E | UNI-ROYAL(Uniroyal Elec) | 0603 | -55℃~+155℃ 100mW 240Ω 75V Thick Film Resistor ±1% ±100ppm/℃ 0603 Chip Resistor - Surface Mount ROHS | 101371 | 0.0024 | Resistance=240Ω; Operating Temperature=-55℃~+155℃; Power(Watts)=100mW; Type=Thick Film Resistor; Voltage-Supply(Max)=75V; Tolerance=±1%; Temperature Coefficient=±100ppm/℃ | https://www.lcsc.com/datasheet/lcsc_datasheet_2206010100_UNI-ROYAL-Uniroyal-Elec-0603WAF2400T5E_C23350.pdf | https://jlcpcb.com/partdetail/24083-0603WAF2400T5E/C23350
C4197 | promotional_extended | Chip Resistor - Surface Mount | Chip Resistor - Surface Mount | 0603WAF2403T5E | UNI-ROYAL(Uniroyal Elec) | 0603 | -55℃~+155℃ 100mW 240kΩ 75V Thick Film Resistor ±1% ±100ppm/℃ 0603 Chip Resistor - Surface Mount ROHS | 221797 | 0.0049 | Resistance=240kΩ; Operating Temperature=-55℃~+155℃; Power(Watts)=100mW; Type=Thick Film Resistor; Voltage-Supply(Max)=75V; Tolerance=±1%; Temperature Coefficient=±100ppm/℃ | https://www.lcsc.com/datasheet/lcsc_datasheet_2206010230_UNI-ROYAL-Uniroyal-Elec-0603WAF2403T5E_C4197.pdf | https://jlcpcb.com/partdetail/4604-0603WAF2403T5E/C4197
C22965 | promotional_extended | Chip Resistor - Surface Mount | Chip Resistor - Surface Mount | 0603WAF2703T5E | UNI-ROYAL(Uniroyal Elec) | 0603 | -55℃~+155℃ 100mW 270kΩ 75V Thick Film Resistor ±1% ±100ppm/℃ 0603 Chip Resistor - Surface Mount ROHS | 366443 | 0.0018 | Resistance=270kΩ; Operating Temperature=-55℃~+155℃; Power(Watts)=100mW; Type=Thick Film Resistor; Voltage-Supply(Max)=75V; Tolerance=±1%; Temperature Coefficient=±100ppm/℃ | https://www.lcsc.com/datasheet/lcsc_datasheet_2206010130_UNI-ROYAL-Uniroyal-Elec-0603WAF2703T5E_C22965.pdf | https://jlcpcb.com/partdetail/23692-0603WAF2703T5E/C22965
C25190 | promotional_extended | Chip Resistor - Surface Mount | Chip Resistor - Surface Mount | 0603WAF270JT5E | UNI-ROYAL(Uniroyal Elec) | 0603 | -55℃~+155℃ 100mW 27Ω 75V Thick Film Resistor ±1% ±200ppm/℃ 0603 Chip Resistor - Surface Mount ROHS | 116490 | 0.0021 | Resistance=27Ω; Operating Temperature=-55℃~+155℃; Power(Watts)=100mW; Type=Thick Film Resistor; Voltage-Supply(Max)=75V; Tolerance=±1%; Temperature Coefficient=±200ppm/℃ | https://www.lcsc.com/datasheet/lcsc_datasheet_2205311845_UNI-ROYAL-Uniroyal-Elec-0603WAF270JT5E_C25190.pdf | https://jlcpcb.com/partdetail/25933-0603WAF270JT5E/C25190
C23156 | promotional_extended | Chip Resistor - Surface Mount | Chip Resistor - Surface Mount | 0603WAF3004T5E | UNI-ROYAL(Uniroyal Elec) | 0603 | -55℃~+155℃ 100mW 3MΩ 75V Thick Film Resistor ±1% ±100ppm/℃ 0603 Chip Resistor - Surface Mount ROHS | 168643 | 0.0026 | Resistance=3MΩ; Operating Temperature=-55℃~+155℃; Power(Watts)=100mW; Type=Thick Film Resistor; Voltage-Supply(Max)=75V; Tolerance=±1%; Temperature Coefficient=±100ppm/℃ | https://www.lcsc.com/datasheet/lcsc_datasheet_2206010116_UNI-ROYAL-Uniroyal-Elec-0603WAF3004T5E_C23156.pdf | https://jlcpcb.com/partdetail/23883-0603WAF3004T5E/C23156
C25194 | promotional_extended | Chip Resistor - Surface Mount | Chip Resistor - Surface Mount | 0603WAF3600T5E | UNI-ROYAL(Uniroyal Elec) | 0603 | -55℃~+155℃ 100mW 360Ω 75V Thick Film Resistor ±1% ±100ppm/℃ 0603 Chip Resistor - Surface Mount ROHS | 338708 | 0.0021 | Resistance=360Ω; Operating Temperature=-55℃~+155℃; Power(Watts)=100mW; Type=Thick Film Resistor; Voltage-Supply(Max)=75V; Tolerance=±1%; Temperature Coefficient=±100ppm/℃ | https://www.lcsc.com/datasheet/lcsc_datasheet_2205311845_UNI-ROYAL-Uniroyal-Elec-0603WAF3600T5E_C25194.pdf | https://jlcpcb.com/partdetail/25937-0603WAF3600T5E/C25194
C23147 | promotional_extended | Chip Resistor - Surface Mount | Chip Resistor - Surface Mount | 0603WAF3602T5E | UNI-ROYAL(Uniroyal Elec) | 0603 | -55℃~+155℃ 100mW 36kΩ 75V Thick Film Resistor ±1% ±100ppm/℃ 0603 Chip Resistor - Surface Mount ROHS | 380332 | 0.0018 | Resistance=36kΩ; Operating Temperature=-55℃~+155℃; Power(Watts)=100mW; Type=Thick Film Resistor; Voltage-Supply(Max)=75V; Tolerance=±1%; Temperature Coefficient=±100ppm/℃ | https://www.lcsc.com/datasheet/lcsc_datasheet_2206010116_UNI-ROYAL-Uniroyal-Elec-0603WAF3602T5E_C23147.pdf | https://jlcpcb.com/partdetail/23874-0603WAF3602T5E/C23147
C23146 | promotional_extended | Chip Resistor - Surface Mount | Chip Resistor - Surface Mount | 0603WAF3603T5E | UNI-ROYAL(Uniroyal Elec) | 0603 | -55℃~+155℃ 100mW 360kΩ 75V Thick Film Resistor ±1% ±100ppm/℃ 0603 Chip Resistor - Surface Mount ROHS | 126568 | 0.0019 | Resistance=360kΩ; Operating Temperature=-55℃~+155℃; Power(Watts)=100mW; Type=Thick Film Resistor; Voltage-Supply(Max)=75V; Tolerance=±1%; Temperature Coefficient=±100ppm/℃ | https://www.lcsc.com/datasheet/lcsc_datasheet_2206010116_UNI-ROYAL-Uniroyal-Elec-0603WAF3603T5E_C23146.pdf | https://jlcpcb.com/partdetail/23873-0603WAF3603T5E/C23146
C23150 | promotional_extended | Chip Resistor - Surface Mount | Chip Resistor - Surface Mount | 0603WAF3903T5E | UNI-ROYAL(Uniroyal Elec) | 0603 | -55℃~+155℃ 100mW 390kΩ 75V Thick Film Resistor ±1% ±100ppm/℃ 0603 Chip Resistor - Surface Mount ROHS | 30797 | 0.0021 | Resistance=390kΩ; Operating Temperature=-55℃~+155℃; Power(Watts)=100mW; Type=Thick Film Resistor; Voltage-Supply(Max)=75V; Tolerance=±1%; Temperature Coefficient=±100ppm/℃ | https://www.lcsc.com/datasheet/lcsc_datasheet_2206010116_UNI-ROYAL-Uniroyal-Elec-0603WAF3903T5E_C23150.pdf | https://jlcpcb.com/partdetail/23877-0603WAF3903T5E/C23150
C12447 | promotional_extended | Chip Resistor - Surface Mount | Chip Resistor - Surface Mount | 0603WAF4022T5E | UNI-ROYAL(Uniroyal Elec) | 0603 | -55℃~+155℃ 100mW 40.2kΩ 75V Thick Film Resistor ±1% ±100ppm/℃ 0603 Chip Resistor - Surface Mount ROHS | 208433 | 0.0023 | Resistance=40.2kΩ; Operating Temperature=-55℃~+155℃; Power(Watts)=100mW; Type=Thick Film Resistor; Voltage-Supply(Max)=75V; Tolerance=±1%; Temperature Coefficient=±100ppm/℃ | https://www.lcsc.com/datasheet/lcsc_datasheet_2206010216_UNI-ROYAL-Uniroyal-Elec-0603WAF4022T5E_C12447.pdf | https://jlcpcb.com/partdetail/13081-0603WAF4022T5E/C12447
C23170 | promotional_extended | Chip Resistor - Surface Mount | Chip Resistor - Surface Mount | 0603WAF4300T5E | UNI-ROYAL(Uniroyal Elec) | 0603 | -55℃~+155℃ 100mW 430Ω 75V Thick Film Resistor ±1% ±100ppm/℃ 0603 Chip Resistor - Surface Mount ROHS | 274663 | 0.0019 | Resistance=430Ω; Operating Temperature=-55℃~+155℃; Power(Watts)=100mW; Type=Thick Film Resistor; Voltage-Supply(Max)=75V; Tolerance=±1%; Temperature Coefficient=±100ppm/℃ | https://www.lcsc.com/datasheet/lcsc_datasheet_2206010116_UNI-ROYAL-Uniroyal-Elec-0603WAF4300T5E_C23170.pdf | https://jlcpcb.com/partdetail/23897-0603WAF4300T5E/C23170
C23159 | promotional_extended | Chip Resistor - Surface Mount | Chip Resistor - Surface Mount | 0603WAF4301T5E | UNI-ROYAL(Uniroyal Elec) | 0603 | -55℃~+155℃ 100mW 4.3kΩ 75V Thick Film Resistor ±1% ±100ppm/℃ 0603 Chip Resistor - Surface Mount ROHS | 189251 | 0.0023 | Resistance=4.3kΩ; Operating Temperature=-55℃~+155℃; Power(Watts)=100mW; Type=Thick Film Resistor; Voltage-Supply(Max)=75V; Tolerance=±1%; Temperature Coefficient=±100ppm/℃ | https://www.lcsc.com/datasheet/lcsc_datasheet_2206010116_UNI-ROYAL-Uniroyal-Elec-0603WAF4301T5E_C23159.pdf | https://jlcpcb.com/partdetail/23886-0603WAF4301T5E/C23159
C23172 | promotional_extended | Chip Resistor - Surface Mount | Chip Resistor - Surface Mount | 0603WAF4302T5E | UNI-ROYAL(Uniroyal Elec) | 0603 | -55℃~+155℃ 100mW 43kΩ 75V Thick Film Resistor ±1% ±100ppm/℃ 0603 Chip Resistor - Surface Mount ROHS | 227932 | 0.0015 | Resistance=43kΩ; Operating Temperature=-55℃~+155℃; Power(Watts)=100mW; Type=Thick Film Resistor; Voltage-Supply(Max)=75V; Tolerance=±1%; Temperature Coefficient=±100ppm/℃ | https://www.lcsc.com/datasheet/lcsc_datasheet_2206010116_UNI-ROYAL-Uniroyal-Elec-0603WAF4302T5E_C23172.pdf | https://jlcpcb.com/partdetail/23899-0603WAF4302T5E/C23172
C25969 | promotional_extended | Chip Resistor - Surface Mount | Chip Resistor - Surface Mount | 0603WAF4303T5E | UNI-ROYAL(Uniroyal Elec) | 0603 | -55℃~+155℃ 100mW 430kΩ 75V Thick Film Resistor ±1% ±100ppm/℃ 0603 Chip Resistor - Surface Mount ROHS | 100971 | 0.0029 | Resistance=430kΩ; Operating Temperature=-55℃~+155℃; Power(Watts)=100mW; Type=Thick Film Resistor; Voltage-Supply(Max)=75V; Tolerance=±1%; Temperature Coefficient=±100ppm/℃ | https://www.lcsc.com/datasheet/lcsc_datasheet_2206010045_UNI-ROYAL-Uniroyal-Elec-0603WAF4303T5E_C25969.pdf | https://jlcpcb.com/partdetail/26712-0603WAF4303T5E/C25969
C23163 | promotional_extended | Chip Resistor - Surface Mount | Chip Resistor - Surface Mount | 0603WAF4704T5E | UNI-ROYAL(Uniroyal Elec) | 0603 | -55℃~+155℃ 100mW 4.7MΩ 75V Thick Film Resistor ±1% ±100ppm/℃ 0603 Chip Resistor - Surface Mount ROHS | 75 | 0.0026 | Resistance=4.7MΩ; Operating Temperature=-55℃~+155℃; Power(Watts)=100mW; Type=Thick Film Resistor; Voltage-Supply(Max)=75V; Tolerance=±1%; Temperature Coefficient=±100ppm/℃ | https://www.lcsc.com/datasheet/lcsc_datasheet_2206010116_UNI-ROYAL-Uniroyal-Elec-0603WAF4704T5E_C23163.pdf | https://jlcpcb.com/partdetail/23890-0603WAF4704T5E/C23163
C13320 | promotional_extended | Chip Resistor - Surface Mount | Chip Resistor - Surface Mount | 0603WAF5104T5E | UNI-ROYAL(Uniroyal Elec) | 0603 | -55℃~+155℃ 100mW 5.1MΩ 75V Thick Film Resistor ±1% ±100ppm/℃ 0603 Chip Resistor - Surface Mount ROHS | 1080842 | 0.0022 | Resistance=5.1MΩ; Operating Temperature=-55℃~+155℃; Power(Watts)=100mW; Type=Thick Film Resistor; Voltage-Supply(Max)=75V; Tolerance=±1%; Temperature Coefficient=±100ppm/℃ | https://www.lcsc.com/datasheet/lcsc_datasheet_2206010216_UNI-ROYAL-Uniroyal-Elec-0603WAF5104T5E_C13320.pdf | https://jlcpcb.com/partdetail/13967-0603WAF5104T5E/C13320
C23203 | promotional_extended | Chip Resistor - Surface Mount | Chip Resistor - Surface Mount | 0603WAF5603T5E | UNI-ROYAL(Uniroyal Elec) | 0603 | -55℃~+155℃ 100mW 560kΩ 75V Thick Film Resistor ±1% ±100ppm/℃ 0603 Chip Resistor - Surface Mount ROHS | 359806 | 0.0014 | Resistance=560kΩ; Operating Temperature=-55℃~+155℃; Power(Watts)=100mW; Type=Thick Film Resistor; Voltage-Supply(Max)=75V; Tolerance=±1%; Temperature Coefficient=±100ppm/℃ | https://www.lcsc.com/datasheet/lcsc_datasheet_2206010116_UNI-ROYAL-Uniroyal-Elec-0603WAF5603T5E_C23203.pdf | https://jlcpcb.com/partdetail/23930-0603WAF5603T5E/C23203
C25196 | promotional_extended | Chip Resistor - Surface Mount | Chip Resistor - Surface Mount | 0603WAF560JT5E | UNI-ROYAL(Uniroyal Elec) | 0603 | -55℃~+155℃ 100mW 56Ω 75V Thick Film Resistor ±1% ±200ppm/℃ 0603 Chip Resistor - Surface Mount ROHS | 1124328 | 0.0026 | Resistance=56Ω; Operating Temperature=-55℃~+155℃; Power(Watts)=100mW; Type=Thick Film Resistor; Voltage-Supply(Max)=75V; Tolerance=±1%; Temperature Coefficient=±200ppm/℃ | https://www.lcsc.com/datasheet/lcsc_datasheet_2205311845_UNI-ROYAL-Uniroyal-Elec-0603WAF560JT5E_C25196.pdf | https://jlcpcb.com/partdetail/25939-0603WAF560JT5E/C25196
C23220 | promotional_extended | Chip Resistor - Surface Mount | Chip Resistor - Surface Mount | 0603WAF6200T5E | UNI-ROYAL(Uniroyal Elec) | 0603 | -55℃~+155℃ 100mW 620Ω 75V Thick Film Resistor ±1% ±100ppm/℃ 0603 Chip Resistor - Surface Mount ROHS | 324302 | 0.002 | Resistance=620Ω; Operating Temperature=-55℃~+155℃; Power(Watts)=100mW; Type=Thick Film Resistor; Voltage-Supply(Max)=75V; Tolerance=±1%; Temperature Coefficient=±100ppm/℃ | https://www.lcsc.com/datasheet/lcsc_datasheet_2206010116_UNI-ROYAL-Uniroyal-Elec-0603WAF6200T5E_C23220.pdf | https://jlcpcb.com/partdetail/23947-0603WAF6200T5E/C23220
C23221 | promotional_extended | Chip Resistor - Surface Mount | Chip Resistor - Surface Mount | 0603WAF6202T5E | UNI-ROYAL(Uniroyal Elec) | 0603 | -55℃~+155℃ 100mW 62kΩ 75V Thick Film Resistor ±1% ±100ppm/℃ 0603 Chip Resistor - Surface Mount ROHS | 436208 | 0.0028 | Resistance=62kΩ; Operating Temperature=-55℃~+155℃; Power(Watts)=100mW; Type=Thick Film Resistor; Voltage-Supply(Max)=75V; Tolerance=±1%; Temperature Coefficient=±100ppm/℃ | https://www.lcsc.com/datasheet/lcsc_datasheet_2206010116_UNI-ROYAL-Uniroyal-Elec-0603WAF6202T5E_C23221.pdf | https://jlcpcb.com/partdetail/23948-0603WAF6202T5E/C23221
C25822 | promotional_extended | Chip Resistor - Surface Mount | Chip Resistor - Surface Mount | 0603WAF6803T5E | UNI-ROYAL(Uniroyal Elec) | 0603 | -55℃~+155℃ 100mW 680kΩ 75V Thick Film Resistor ±1% ±100ppm/℃ 0603 Chip Resistor - Surface Mount ROHS | 1215408 | 0.0015 | Resistance=680kΩ; Operating Temperature=-55℃~+155℃; Power(Watts)=100mW; Type=Thick Film Resistor; Voltage-Supply(Max)=75V; Tolerance=±1%; Temperature Coefficient=±100ppm/℃ | https://www.lcsc.com/datasheet/lcsc_datasheet_2206010045_UNI-ROYAL-Uniroyal-Elec-0603WAF6803T5E_C25822.pdf | https://jlcpcb.com/partdetail/26565-0603WAF6803T5E/C25822
C27592 | promotional_extended | Chip Resistor - Surface Mount | Chip Resistor - Surface Mount | 0603WAF680JT5E | UNI-ROYAL(Uniroyal Elec) | 0603 | -55℃~+155℃ 100mW 68Ω 75V Thick Film Resistor ±1% ±100ppm/℃ 0603 Chip Resistor - Surface Mount ROHS | 2073050 | 0.0013 | Resistance=68Ω; Operating Temperature=-55℃~+155℃; Power(Watts)=100mW; Type=Thick Film Resistor; Voltage-Supply(Max)=75V; Tolerance=±1%; Temperature Coefficient=±100ppm/℃ | https://www.lcsc.com/datasheet/lcsc_datasheet_2206010030_UNI-ROYAL-Uniroyal-Elec-0603WAF680JT5E_C27592.pdf | https://jlcpcb.com/partdetail/28341-0603WAF680JT5E/C27592
C23241 | promotional_extended | Chip Resistor - Surface Mount | Chip Resistor - Surface Mount | 0603WAF7500T5E | UNI-ROYAL(Uniroyal Elec) | 0603 | -55℃~+155℃ 100mW 750Ω 75V Thick Film Resistor ±1% ±100ppm/℃ 0603 Chip Resistor - Surface Mount ROHS | 553149 | 0.0035 | Resistance=750Ω; Operating Temperature=-55℃~+155℃; Power(Watts)=100mW; Type=Thick Film Resistor; Voltage-Supply(Max)=75V; Tolerance=±1%; Temperature Coefficient=±100ppm/℃ | https://www.lcsc.com/datasheet/lcsc_datasheet_2206010100_UNI-ROYAL-Uniroyal-Elec-0603WAF7500T5E_C23241.pdf | https://jlcpcb.com/partdetail/23968-0603WAF7500T5E/C23241
C23240 | promotional_extended | Chip Resistor - Surface Mount | Chip Resistor - Surface Mount | 0603WAF7503T5E | UNI-ROYAL(Uniroyal Elec) | 0603 | -55℃~+155℃ 100mW 750kΩ 75V Thick Film Resistor ±1% ±100ppm/℃ 0603 Chip Resistor - Surface Mount ROHS | 327908 | 0.0027 | Resistance=750kΩ; Operating Temperature=-55℃~+155℃; Power(Watts)=100mW; Type=Thick Film Resistor; Voltage-Supply(Max)=75V; Tolerance=±1%; Temperature Coefficient=±100ppm/℃ | https://www.lcsc.com/datasheet/lcsc_datasheet_2206010100_UNI-ROYAL-Uniroyal-Elec-0603WAF7503T5E_C23240.pdf | https://jlcpcb.com/partdetail/23967-0603WAF7503T5E/C23240
C23255 | promotional_extended | Chip Resistor - Surface Mount | Chip Resistor - Surface Mount | 0603WAF820JT5E | UNI-ROYAL(Uniroyal Elec) | 0603 | -55℃~+155℃ 100mW 75V 82Ω Thick Film Resistor ±1% ±100ppm/℃ 0603 Chip Resistor - Surface Mount ROHS | 537109 | 0.002 | Resistance=82Ω; Operating Temperature=-55℃~+155℃; Power(Watts)=100mW; Type=Thick Film Resistor; Voltage-Supply(Max)=75V; Tolerance=±1%; Temperature Coefficient=±100ppm/℃ | https://www.lcsc.com/datasheet/lcsc_datasheet_2206010100_UNI-ROYAL-Uniroyal-Elec-0603WAF820JT5E_C23255.pdf | https://jlcpcb.com/partdetail/23982-0603WAF820JT5E/C23255
C23265 | promotional_extended | Chip Resistor - Surface Mount | Chip Resistor - Surface Mount | 0603WAF9102T5E | UNI-ROYAL(Uniroyal Elec) | 0603 | -55℃~+155℃ 100mW 75V 91kΩ Thick Film Resistor ±1% ±100ppm/℃ 0603 Chip Resistor - Surface Mount ROHS | 203083 | 0.0021 | Resistance=91kΩ; Operating Temperature=-55℃~+155℃; Power(Watts)=100mW; Type=Thick Film Resistor; Voltage-Supply(Max)=75V; Tolerance=±1%; Temperature Coefficient=±100ppm/℃ | https://www.lcsc.com/datasheet/lcsc_datasheet_2206010100_UNI-ROYAL-Uniroyal-Elec-0603WAF9102T5E_C23265.pdf | https://jlcpcb.com/partdetail/23992-0603WAF9102T5E/C23265
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
