cpldcpu/TouchSynth/docs/report/generated/bom.tex

\begin{longtable}{@{}l r l l l r p{5.2cm}@{}}
\caption{Assembled parts (JLCPCB PCBA, top side). Unit prices from the JLCPCB parts list at the time of design.}\label{tab:bom}\\
\toprule Value & Qty & Package & LCSC & Library & USD/pc & Designators\\ \midrule\endfirsthead
\toprule Value & Qty & Package & LCSC & Library & USD/pc & Designators\\ \midrule\endhead
\bottomrule\endfoot
4.7k & 29 & 0603 & C23162 & Basic & 0.0028 & {\footnotesize R16--R31, R49, R50, R56, R58, R75, R76, R83, R84, R91, R92, R95, R102, R103}\\
10k & 17 & 0603 & C25804 & Basic & 0.0018 & {\footnotesize R6, R7, R55, R63, R64, R66, R67, R73, R81, R82, R85--R88, R104, R106, R109}\\
1k & 15 & 0603 & C21190 & Basic & 0.0026 & {\footnotesize R1, R9--R12, R48, R52, R57, R62, R74, R78, R90, R94, R98, R99}\\
100k & 10 & 0603 & C25803 & Basic & 0.0031 & {\footnotesize R34, R36, R38, R40, R42, R44, R46, R65, R68, R108}\\
200k & 9 & 0603 & C25811 & Basic & 0.0023 & {\footnotesize R32, R33, R35, R37, R39, R41, R43, R45, R47}\\
15k & 4 & 0603 & C22809 & Basic & 0.0029 & {\footnotesize R51, R77, R93, R110}\\
470k & 4 & 0603 & C23178 & Basic & 0.0030 & {\footnotesize R70--R72, R96}\\
33k & 3 & 0603 & C4216 & Basic & 0.0022 & {\footnotesize R53, R59, R97}\\
22k & 3 & 0603 & C31850 & Basic & 0.0041 & {\footnotesize R89, R105, R107}\\
1.5k & 2 & 0603 & C22843 & Basic & 0.0019 & {\footnotesize R5, R60}\\
2.2k & 2 & 0603 & C4190 & Basic & 0.0018 & {\footnotesize R8, R54}\\
1M & 1 & 0603 & C22935 & Basic & 0.0019 & {\footnotesize R100}\\
2M & 1 & 0603 & C22976 & Basic & 0.0025 & {\footnotesize R101}\\
2.4k & 1 & 0603 & C22940 & Basic & 0.0026 & {\footnotesize R13}\\
9.1k & 1 & 0603 & C23260 & Basic & 0.0031 & {\footnotesize R2}\\
10 & 1 & 0603 & C22859 & Basic & 0.0032 & {\footnotesize R3}\\
3.3k & 1 & 0603 & C22978 & Basic & 0.0026 & {\footnotesize R4}\\
300k & 1 & 0603 & C23024 & Basic & 0.0054 & {\footnotesize R61}\\
150k & 1 & 0603 & C22807 & Basic & 0.0044 & {\footnotesize R69}\\
6.2k & 1 & 0603 & C4260 & Basic & 0.0023 & {\footnotesize R79}\\
120k & 1 & 0603 & C25808 & Basic & 0.0015 & {\footnotesize R80}\\
100n & 17 & 0603 & C14663 & Basic & 0.0122 & {\footnotesize C2, C4, C6, C15, C17--C22, C26, C28, C34, C36, C41, C45, C48}\\
33n & 8 & 0603 & C21117 & Basic & 0.0106 & {\footnotesize C23, C27, C30--C33, C37, C42}\\
1\textmu{} & 8 & 0603 & C15849 & Basic & 0.0752 & {\footnotesize C3, C7--C9, C16, C35, C39, C44}\\
10\textmu{} & 5 & 0603 & C96446 & Basic & 0.0541 & {\footnotesize C1, C10--C13}\\
22n & 3 & 0603 & C21122 & Basic & 0.0083 & {\footnotesize C24, C38, C43}\\
10\textmu{} & 3 & 0603 & C19702 & Basic & 0.0319 & {\footnotesize C5, C14, C46}\\
1n & 2 & 0603 & C1588 & Basic & 0.0089 & {\footnotesize C29, C47}\\
10n & 1 & 0603 & C57112 & Basic & 0.0108 & {\footnotesize C25}\\
4.7\textmu{} & 1 & 0603 & C19666 & Basic & 0.0294 & {\footnotesize C40}\\
red & 16 & 0603 & C2286 & Basic & 0.0075 & {\footnotesize D3--D18}\\
SS14 & 1 & D & C2480 & Basic & 0.0191 & {\footnotesize D1}\\
BC847BS & 8 & SOT-363 & C41375126 & Promo & 0.0281 & {\footnotesize Q4--Q9, Q11, Q13}\\
MMBT3904 & 4 & SOT-23 & C20526 & Basic & 0.0115 & {\footnotesize Q1, Q3, Q10, Q12}\\
2N7002 & 1 & SOT-23 & C8545 & Basic & 0.0178 & {\footnotesize Q2}\\
TL072 & 3 & SOIC-8 & C6961 & Basic & 0.1613 & {\footnotesize U2, U10, U11}\\
74HC595 & 3 & SOIC-16 & C5947 & Basic & 0.1152 & {\footnotesize U7--U9}\\
CD4051B & 2 & SOIC-16 & C21379 & Promo & 0.2574 & {\footnotesize U5, U6}\\
78L05 & 1 & SOT-89-3 & C71136 & Basic & 0.0892 & {\footnotesize U1}\\
LM324 & 1 & SOIC-14 & C71035 & Basic & 0.1658 & {\footnotesize U12}\\
\midrule
\multicolumn{2}{@{}l}{196 parts} & \multicolumn{3}{l}{40 BOM lines} & 3.65 & per board (parts only)\\
\end{longtable}
