cpldcpu/TouchSynth/docs/verification_plan.md

# TouchSynth — Verification & Validation Plan

Status: draft v0.1 (2026-09-26). Limits come from the ngspice results in [sim_report.md](sim_report.md)
(S1–S7); they are set with margin for component tolerances. Update the limits once the first board
has been characterised.

## 1. Strategy

| Level | What | How | Who |
|---|---|---|---|
| L0 Design verification | circuit meets spec in simulation | ngspice S1–S7 (`sim/`) | done before layout |
| L1 Assembly / bring-up | board is built right, rails and bias are sane | DMM on test points, current-limited supply | manual |
| L2 Functional verification | each block meets its sim-derived limits | test firmware + audio loopback ADC, driven over SWIO by `minichlink` | automated (Claude via minichlink) |
| L3 Calibration | per-board constants stored in flash | same firmware, calibration commands | automated |
| L4 Validation | it is a playable, good-sounding instrument | playing tests, listening, long-run stability | user |

## 2. Test infrastructure

### 2.1 Hardware provisions (must be in the schematic/layout)

- **Audio loopback** VCA output → 10 k / 15 k divider + 1 nF → **PD5 (ADC A5)**: 2.7 V ± 0.6 V per volt of
  output swing, 1.8…3.6 V for the largest expected signals (S6 checks this node stays inside 0…5 V).
- **Trim DAC** 3rd 74HC595 in the LED chain → 8-bit R-2R (100 k / 200 k) → VCA offset injection.
- **Test pads** (1 mm, bottom side, labelled): GND, V+, +5V, VREF, VBIAS, V25, VB0…VB4, TAIL, SAW, LPF,
  VCAOUT, RESOUT, XAMP, XCUT (bC), XRES, XVCA, VTRIM.
- **SWIO header** 3 pads (GND, SWIO, +5V) for WCH-LinkE.

### 2.2 Test firmware (`firmware/synthtest/`, ch32fun)

A text command interface over the SWIO debug channel (`printf` / `handle_debug_input`, used with
`minichlink -T`). No UART or USB needed. Commands (all integers, 12-bit CV codes):

| Command | Action |
|---|---|
| `id` | chip type (V003/V002), firmware version, flash calibration block |
| `note <midi>` / `off` | start/stop the DCO at a MIDI note (exact TIM2 period) |
| `wave <saw> <pulse> <sub> <noise> [pw]` | enable waveforms (0/1), pulse width 0…1023 |
| `cv <amp\|cut\|res\|vca> <code>` | set a PWM CV directly (bypasses envelopes) |
| `trim <0..255>` | write the VCA trim DAC |
| `leds <hex16>` | set the 16 LEDs |
| `cap <n> <rate>` | capture n samples of the audio loopback (PD5) at a given rate, dump as hex |
| `touch [n]` | dump raw touch readings of all 16 pads (n samples each) |
| `selftest` | run T1…T12 below, print PASS/FAIL table |
| `cal <dco\|vcf\|vca\|touch>` / `calsave` | run a calibration and store constants in flash |

Host side: `tools/synthtest.py` (Windows Python) wraps `minichlink.exe -T` (prebuilt in
`firmware/ch32fun/minichlink/`, WinUSB driver on the WCH-LinkE interface 1), sends commands, parses the
dumps, computes FFTs and compares against the limits below. Results go to `docs/results/hw_<board>.csv`
so they can be plotted next to the simulation data.

## 3. L1 — Bring-up (MCU not fitted, then fitted)

Supply: lab supply 9.0 V, current limit 100 mA, meter ground on a scope-ground pin. Expected values: DC operating
point of the netlist with the MCU pins floating ([sim/bringup/bringup_op.py](../sim/bringup/bringup_op.py),
`docs/results/bringup_expected.csv`), revised 2026-10-17 after board 1.

- **Linear CVs (AMP, RES, VCA):** pulled to 0 V by their 15 k last-stage resistor.
- **Cutoff CV:** the network has no DC path of its own, so XCUT_IN floats to VBIAS and the ladder tail runs at the
  expo reference current (about 8 µA).
- **DCO:** held in reset, so SAW = VREF.
- **74HC595s:** random power-up state. Any number of the 16 red LEDs (0.68 mA each) may light, and VTRIM can read
  0.4…5 V.

| # | Step | Expected at 9 V (sim) | Limit | Board 1 (9 V, all LEDs on) |
|---|---|---|---|---|
| B1 | visual / continuity: no bridges on the ICs and MCU pads; no short VP–GND, +5V–GND | — | — | — |
| B2 | reverse polarity 9 V for 1 s | I < 1 mA | pass | 0 mA |
| B3 | input current, no MCU | 14.8 mA (LEDs off) … 25.7 mA (all on) | 10…35 mA | 25 mA |
| B4 | VP | 8.72 V | 8.4…8.9 V | 8.57 V |
| B5 | +5V | 5.00 V | 4.8…5.2 V | 5.028 V |
| B6 | VREF | 4.50 V | 4.45…4.55 V | 4.53 V |
| B6a | VBIAS / V25 | 1.56 / 2.50 V | ±3 % | 1.57 / 2.515 V |
| B7 | VB0 / VB2 / VB4 as ratio to VP | 0.281 / 0.513 / 0.745 | ±3 % | 0.279 / 0.504 / 0.733 (2.39 / 4.32 / 6.28 V) |
| B8 | TAIL (ladder emitters) | 1.96 V | 1.8…2.1 V | 1.88 V |
| B9 | LPF (INA output, no signal) | 4.50 V | 4.3…4.7 V | 4.53 V |
| B10 | SAW / RESOUT / VCAOUT | 4.50 V each | 4.3…4.7 V | 4.52 / 4.52 / 4.51 V |
| B10a | XAMP / XRES / XVCA | 0 V | < 50 mV | 0 / 0 / 0 |
| B10b | XCUT_IN (= VBIAS) | 1.56 V | ±3 % | 1.57 V |
| B10c | VTRIM | 0.4…4.96 V (random) | — | 4.92 V (code 255) |
| B11 | fit MCU, flash `firmware/touchsynth`, `id` answers | — | — | pass: `touchsynth 0.1 CH32V006` |
| B12 | input current with MCU, firmware idle | 20…31 mA (1…16 LEDs) | < 40 mA | 25 mA (all LEDs off; 12 V not recorded) |

At 12 V in: VP 11.72 V, VB0/2/4 3.28/6.00/8.72 V, TAIL 2.79 V, input current 15.9…26.8 mA without the MCU.

**Board 1:** B1–B10 pass. VP is 0.15 V below the simulation (the SS14 drops about 0.43 V). Relative to VP, VB2 and VB4
are about 1.7 % low, which is inside the limit but more than the resistor tolerance explains (about 50 µA leaves
the bias chain at the upper taps). Watch this in T6–T8. Bring-up also exposed two model errors, now fixed in
`sim/models/models.lib`: the 78L05 model drew no load current from its input, and the TL072 model drew 4 mA per
amplifier instead of 1.4 mA.

After B11 the firmware drives the LEDs, sets the trim DAC to mid-scale (VTRIM ≈ 2.7 V) and drives the cutoff PWM
low (XCUT_IN ≈ 0.2 V).

**Board 1, MCU fitted (CH32V006):** flashed with firmware 0.1 via WCH-LinkE and `minichlink` on a Linux host; the
console runs over SWIO (`tools/synthtest.py`). B11 and B12 pass. 25 mA with all LEDs off is about 5 mA above the
expected 20 mA, which suggests the MCU draws about 10 mA rather than the assumed 5 mA. Defects found and fixed:

- **PD4/PD5 solder bridge** (MCU pins 1–2). The loopback input read 0 V (4.5 V / 5 mV across R109). Located with the
  console diagnostics `adc <ch>` and `latch <0|1>`: with the latch line (PD4) high, PD5 read 4089 counts. After
  rework the loopback sits at 2209 counts (VCAOUT 4.52 V).
- **Trim DAC MSB lost** (firmware): SRCLK is shared with mux select S1, and a touch scan left it high, so the first
  bit shifted out (DAC MSB) was lost. `hw_leds_dac` now pulls the clock low first (found in T1).
- **Loopback ADC on V00x** (firmware): the ADC must be re-armed before every conversion, otherwise the capture hung.
  Also: shorter sample time for fast captures, 2048-sample capture buffer on the V006.
- **Touch** (firmware): the noise estimate underflowed (unsigned), now a signed deviation statistic over 64 scans;
  pad 0 reads ~550 counts low right after reset, so a 300 ms warm-up precedes the calibration. Ghost touches during
  long sessions (estimate as low as 48–96 counts on some boots) were removed with a threshold floor
  (`TOUCH_MIN_THR` = 200 counts; weakest real touch 486 counts) and a 2-scan debounce.
- **LEDs next to SHIFT, −, +:** not driven in normal playing by design (edit mode / value bar only). Hardware
  confirmed with `leds 0xe000`; these LEDs now light while their pad is touched.

## 4. L2 — Functional tests (automated, `selftest`)

Default conditions: 9 V in, room temperature, CV codes from the calibration defaults.

| ID | Block | Procedure | Pass limit | Sim ref |
|---|---|---|---|---|
| T1 | LEDs / 595 chain | walking-one pattern, user confirms; trim DAC walk shifts VCAOUT DC (VCA open, no signal) monotonically | monotonic, > 20 mV span | — |
| T2 | Touch | 256 readings per pad, untouched: mean, σ; user touches each pad in turn | σ < 2 LSB (V003) / 6 LSB (V002); touch Δ > 10 σ | S5: Δ(5 pF) ≥ 14.8 / 57 LSB |
| T3 | Touch scan rate | time a full 16-pad scan | ≥ 200 Hz | S5: 1.4 kHz |
| T4 | DCO frequency | filter open, VCA open, `cap` + zero-crossing / FFT at C2, C4, C6 | error < 1 cent | S1 (timer exact) |
| T5 | DCO amplitude flatness | loopback amplitude C1…C8 with default CV law | spread ±5 % after `cal dco` | S1: −2.2 / +0.8 % |
| T6 | VCF self-oscillation threshold | DCO off, CV_RES ramp, detect sustained oscillation | 2.7…3.5 V | S3: 3.1 V |
| T7 | VCF tracking | self-oscillation frequency at CV_CUT = 1…4.5 V | slope 2.05 ± 0.2 oct/V, monotonic | S3: 2.05 oct/V |
| T8 | VCF lowpass | 110 Hz saw, CV_CUT at 1 kHz: harmonic 10 vs harmonic 1 | within ±3 dB of sim | S3 |
| T9 | VCA gain law | 1 kHz filtered saw, CV_VCA sweep | monotonic, max gain within ±2 dB of sim | S4: +7.4 dB |
| T10 | VCA thump | CV_VCA 0→full steps without signal, before/after `cal vca` | after cal < 3 mV step at line out | S4: ≈ 100 → 0.6 mV |
| T11 | CV settling | VCA step response seen at loopback | 1 % in < 2.5 ms | S2: 1.3 ms |
| T12 | Hum / noise | VCA open, DCO off, 1 s capture, spectrum | 100 Hz < sim + 6 dB; broadband < −60 dB re 1.33 Vpp | S7 |
| T14 | MIDI in | external MIDI keyboard: note on/off, pitch bend, CC | all received | — |

### 4.1 Board 1 results (2026-10-17)

Run from the PC with `tools/hwtest.py` over the SWIO console (the on-chip `selftest` is not implemented yet). Loopback:
12-bit ADC at PD5 = 0.6 × VCAOUT, referenced to +5V (5.028 V), so 1 count = 2.05 mV at VCAOUT; 2048-sample captures
at 5–100 µs. All analog tests at trim code 104. Data: `docs/results/hw_board1_*.csv`, raw captures and logs in
`docs/results/hw_board1/`; figures `docs/figures/hw_board1_{dco,vcf,vca,hum}` from `tools/hw_figures.py`.

| ID | Board 1 result | Limit (sim) | Verdict |
|---|---|---|---|
| T1 | all 16 LEDs light; trim walk 0–255 moves the VCA-open level at VCAOUT monotonically over 366 mV | monotonic, > 20 mV | pass |
| T2 | untouched σ 20–28 counts (C–G) / 35–43 counts (G#–+); touches 486–4233 counts (20–90 σ); no ghost touch in a 180 s log ¹ | Δ > 10 σ | pass |
| T3 | not recorded | ≥ 200 Hz | — |
| T4 | −0.28 … +0.26 cent at 11 notes C2–C7, relative to the MCU clock ² | < 1 cent | pass |
| T5 | saw 1.495 Vpp at VCAOUT, −0.9 / +1.2 % over C2–C7, uncalibrated | ±5 % | pass |
| T6 | onset between 3.05 and 3.17 V (cutoff code 2211), oscillation at 2.0 kHz | 2.7…3.5 V (3.1 V) | pass |
| T7 | 2.01 oct/V over CV_CUT 0.49–4.02 V (89 Hz – 12.1 kHz), ≤ 45 cent from a straight line | 2.05 ± 0.2 oct/V | pass |
| T8 | harmonic 10 at −3.7 dB re harmonic 1; 4-pole fit f_p = 2077 Hz | ±3 dB of sim ³ | pass |
| T9 | gain law within −0.23 … +0.05 dB of S4 (CV 0.25–5 V); off ≥ 81 dB (measurement floor) ⁴ | ±2 dB | pass |
| T10 | thump at VCAOUT −33 mV at trim 128 (default), 0 ± 2 mV at trim 104 | < 3 mV after cal | pass |
| T11 | closing step: 1 % in 1.17 ms; opening step: ~2 % left after 1.5 ms, 1 % after 12.8 ms | 1 % < 2.5 ms (1.3 ms) | pass ⁵ |
| T12 | 50 Hz −82 dB, 100 Hz −79 dB; broadband 20 Hz–5 kHz −54 dB (VCA open) / −55 dB (closed) re 1.33 Vpp | 100 Hz < −75 dB; broadband < −60 dB | hum pass, noise marginal |
| T14 | not tested | all received | — |

¹ a raw reading is the sum of 12 conversions, so the per-conversion σ limit was not evaluated.
² DCO timer and capture share the HSI clock; absolute pitch is 14 cent flat (below).
³ an ideal 4-pole low-pass at the S3 cutoff of this code (1.0 kHz at −3 dB) gives −3.5 dB at 1.1 kHz.
⁴ relative to full gain; the absolute maximum gain (S4: +7.4 dB) was not measured separately.
⁵ for the CV network (closing step); the opening step has an additional slow component (below).

**Findings:**

- **Clock:** from the scope recordings of the demo tunes (232 kick hits against the scope timebase) the HSI runs at
  47.62 MHz (−0.80 %), so all pitches are ~14 cent flat and tunes 0.8 % slow until a clock trim is calibrated.
  Takes up to an hour apart differed by up to 0.1 % (RC oscillator drift).
- **Filter:** self-oscillation at 1611 Hz at CV_CUT 2.55 V vs S3 1606 Hz at 2.5 V (about 0.1 octave lower at equal CV);
  no sustained oscillation at 0 and 0.24 V. The low ladder bias seen in B7 has no visible effect.
- **VCA:** thump linear in the trim code (−1.4 mV/code), null at 104; the firmware still boots at 128 (−33 mV) until
  the calibration store exists. The opening step has a ~2 % tail over 10–15 ms that a linear RC network would not
  show in only one direction, most likely thermal (VCA pair warming when its current jumps from zero). 1 ADC count is
  0.9 % of the 220 mV test step, so the tail is resolved only coarsely.
- **Noise:** total 1.19–1.29 mV rms at VCAOUT (−52 dB) including discrete lines, broadband about −55 dB, nearly the
  same with the VCA closed. The loopback quantisation alone (0.59 mV rms) is −58 dB, so −60 dB cannot be verified
  here: measure at the line out with an audio interface. Discrete lines: the running DCO with all waveforms off and
  CV_AMP = 0 (feed-through, up to −59 dB), and 3125 Hz in every capture (46.875 kHz PWM/interrupt rate aliased by the
  10 kS/s capture).
- **Hum:** 100 Hz at the floor with a lab supply; hum with mains adapters (V6) still open.

Sound examples recorded from the line out with the scope: `docs/audio/hw_board1/` (demo tunes, waveform switching,
self-oscillation scale).

**Still open on board 1:** calibration store (trim 104, clock, cutoff offset), noise measurement with an audio
interface, B12 at 12 V, T3, T14, the on-chip `selftest`, V1–V8.

## 5. L3 — Calibration constants (stored in the 256 B user flash area)

| Constant | Method | Expected |
|---|---|---|
| `dco_gain` | measure saw amplitude at C4, scale CV_AMP law | 0.95…1.05 (sim 0.978) |
| `vcf_oct_per_v`, `vcf_offset` | self-oscillation frequency at two CV_CUT codes | 2.05 oct/V |
| `vca_trim` | 2-point null of the thump (S4 procedure) | code 30…230 |
| `touch_base[16]`, `touch_thr[16]` | untouched mean + k·σ | — |

## 6. L4 — Validation (user)

| ID | Criterion | Method |
|---|---|---|
| V1 | Every key triggers reliably, no ghost notes, no double triggers | play chromatic runs, glissandi, fast repeats for 5 min |
| V2 | Touch-to-sound latency feels immediate | < 10 ms (firmware timestamp from touch detect to gate) |
| V3 | Tuning holds | play A4 against a tuner after 1 min and 30 min: DCO < 2 cent; filter self-oscillation drift after warm-up noted (≈ −13 cent/K expected, uncompensated) |
| V4 | Parameters are reachable and understandable with SHIFT/−/+ and the LEDs | user walkthrough of all parameters |
| V5 | Sound: bass, lead, resonant sweeps, self-oscillation usable | listening; compare with `docs/audio/features/` (behavioural model) and `docs/audio/s6_voice.wav` |
| V8 | Demo tunes play correctly from flash | play all tunes; compare with `docs/audio/features/tune_*` |
| V6 | Works on 9 V battery and 12 V adapter; no audible hum with a typical adapter | listening + T12 |
| V7 | MIDI playable from a keyboard / DAW | play |

## 7. Traceability (spec → sim → test)

| Spec item | Sim | HW test |
|---|---|---|
| DCO range and amplitude ±5 % | S1 | T4, T5 |
| CV ripple < −70 dB, settling < 2 ms | S2 | T11 |
| VCF cutoff 30 Hz…15 kHz, 24 dB/oct, resonance to self-osc. | S3 | T6, T7, T8 |
| VCA ≥ 70 dB off, low thump | S4 | T9, T10 |
| Touch Δ ≥ 5 × noise, scan ≥ 200 Hz | S5 | T2, T3, V1, V2 |
| Full voice | S6 | V5 |
| Power 9–12 V, ripple | S7 | B2–B5, T12, V6 |
