cpldcpu/TouchSynth/docs/results/behav_cal.csv

pole_ratio | k_slope
0.470985 | 2
