cpldcpu/TouchSynth/docs/results/behav_validation.csv

metric | value
pole_ratio | 0.470985
k_slope | 2
level_mean_db | -0.573405
level_rms_db | 1.08688
centroid_mean_cent | -297.391
centroid_rms_cent | 413.539
