cpldcpu/TouchSynth/docs/results/bringup_expected.csv

testpoint | v9_min | v9_max | v12_min | v12_max
VP | 8.70687 | 8.72848 | 11.705 | 11.7257
+5V | 4.99668 | 4.99888 | 4.99848 | 5.00067
VREF | 4.50197 | 4.50394 | 4.50364 | 4.50561
VBIAS | 1.56141 | 1.56209 | 1.56197 | 1.56266
V25 | 2.49844 | 2.49954 | 2.49934 | 2.50044
VB0 | 2.45184 | 2.45783 | 3.27959 | 3.28533
VB2 | 4.46949 | 4.48052 | 5.99737 | 6.00794
VB4 | 6.48725 | 6.50332 | 8.71525 | 8.73065
TAIL | 1.95694 | 1.96292 | 2.78453 | 2.79026
LPF | 4.50205 | 4.50403 | 4.50384 | 4.50581
XCUT_IN | 1.56137 | 1.56205 | 1.56193 | 1.56262
SAW | 4.50197 | 4.50395 | 4.50369 | 4.50567
XAMP | 0.000307025 | 0.000307042 | 0.000309294 | 0.00030931
XRES | 0.000306587 | 0.000306605 | 0.000309209 | 0.000309227
RESOUT | 4.5019 | 4.50388 | 4.50359 | 4.50557
XVCA | 0.000477976 | 0.000478063 | 0.00048119 | 0.000481275
VCAOUT | 4.50181 | 4.50379 | 4.50347 | 4.50545
VTRIM | 0.408898 | 4.95495 | 0.40905 | 4.9551
I_in [mA] | 14.7592 | 25.6503 | 15.9112 | 26.8027
