cpldcpu/TouchSynth/docs/results/hw_board1/dco_36.csv

# ADC counts (12 bit, VDD 5.028 V), PD5 = 0.6 x VCAOUT, sample period 90 us
1807
1813
1820
1828
1835
1843
1849
1858
1864
1871
1878
1884
1892
1899
1905
1912
1920
1925
1931
1939
1945
1952
1958
1963
1970
1976
1982
1989
1995
2001
2007
2013
2019
2024
2031
2037
2048
2050
2055
2061
2067
2072
2076
2083
2089
2094
2098
2104
2109
2115
2121
2125
2130
2135
2140
2145
2150
2154
2161
2164
2168
2173
2179
2183
2187
2191
2197
2201
2204
2210
2214
2218
2222
2227
2231
2235
2240
2245
2248
2251
2257
2260
2264
2267
2272
2276
2279
2283
2286
2291
2294
2297
2301
2307
2310
2314
2316
2321
2324
2328
2331
2333
2338
2341
2344
2346
2350
2353
2357
2360
2363
2366
2370
2373
2375
2378
2381
2385
2388
2390
2393
2396
2399
2402
2404
2407
2409
2412
2415
2417
2420
2422
2425
2427
2430
2434
2436
2437
2440
2442
2445
2447
2450
2452
2454
2456
2459
2460
2463
2465
2468
2469
2471
2473
2476
2477
2481
2481
2484
2486
2488
2490
2491
2493
1858
1767
1773
1782
1790
1799
1806
1814
1822
1829
1836
1843
1850
1858
1864
1871
1879
1886
1892
1899
1906
1912
1918
1925
1932
1939
1945
1951
1958
1964
1970
1977
1982
1989
1994
2001
2007
2013
2019
2024
2030
2037
2048
2050
2056
2061
2067
2072
2077
2084
2089
2094
2100
2105
2109
2115
2120
2125
2131
2136
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
