cpldcpu/TouchSynth/docs/results/hw_board1/dco_43.csv

# ADC counts (12 bit, VDD 5.028 V), PD5 = 0.6 x VCAOUT, sample period 60 us
2058
2062
2068
2072
2077
2083
2087
2092
2098
2102
2107
2112
2117
2122
2126
2131
2136
2140
2146
2150
2154
2159
2163
2168
2173
2177
2182
2186
2190
2195
2199
2203
2207
2212
2216
2220
2225
2229
2233
2237
2243
2246
2250
2253
2257
2262
2266
2270
2274
2278
2282
2285
2290
2293
2296
2300
2307
2309
2313
2316
2321
2325
2328
2331
2334
2339
2343
2345
2349
2352
2357
2360
2364
2366
2371
2373
2376
2380
2384
2387
2391
2393
2397
2401
2404
2406
2409
2413
2418
2420
2423
2424
2428
2432
2435
2437
2440
2443
2446
2450
2453
2455
2457
2460
2465
2467
2469
2472
2475
2478
2481
2484
2486
2488
2492
2495
2497
2500
2502
2505
2509
2511
2513
2516
2317
1806
1799
1805
1812
1819
1826
1832
1839
1845
1851
1858
1864
1869
1876
1881
1888
1894
1900
1907
1912
1917
1924
1929
1934
1941
1946
1953
1959
1963
1969
1974
1980
1986
1991
1997
2003
2007
2012
2018
2023
2029
2033
2039
2048
2051
2057
2062
2067
2072
2077
2083
2087
2091
2098
2102
2106
2111
2117
2122
2126
2131
2135
2140
2145
2150
2154
2159
2163
2167
2171
2177
2182
2186
2189
2194
2199
2203
2207
2211
2216
2220
2225
2229
2232
2236
2241
2246
2249
2253
2257
2261
2266
2269
2273
2277
2281
2285
2289
2293
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
