cpldcpu/TouchSynth/docs/results/hw_board1/dco_48.csv

# ADC counts (12 bit, VDD 5.028 V), PD5 = 0.6 x VCAOUT, sample period 45 us
2147
2152
2156
2161
2165
2170
2173
2178
2182
2186
2191
2196
2200
2205
2209
2213
2217
2220
2225
2230
2234
2239
2243
2247
2251
2254
2259
2263
2267
2271
2276
2279
2284
2287
2291
2294
2299
2302
2308
2312
2316
2320
2323
2328
2331
2335
2339
2343
2347
2350
2355
2358
2360
2364
2369
2372
2376
2380
2383
2386
2390
2393
2396
2400
2403
2407
2411
2414
2418
2422
2424
2427
2432
2434
2438
2441
2444
2449
2451
2454
2457
2460
2464
2468
2471
2474
2477
2482
2484
2486
2489
2492
2496
2499
2502
2505
2509
2511
2514
2517
2520
2523
2525
2530
2305
1842
1811
1815
1821
1828
1834
1839
1846
1851
1859
1864
1869
1875
1880
1885
1893
1897
1903
1909
1915
1920
1925
1930
1935
1942
1947
1952
1958
1963
1969
1974
1978
1983
1990
1994
2000
2005
2011
2016
2020
2024
2030
2035
2041
2048
2053
2059
2063
2068
2072
2077
2082
2087
2092
2097
2102
2106
2110
2115
2119
2124
2130
2134
2138
2144
2149
2152
2156
2162
2166
2170
2174
2179
2184
2188
2192
2196
2200
2204
2210
2215
2218
2222
2227
2230
2234
2238
2244
2247
2251
2257
2260
2264
2268
2272
2276
2280
2283
2288
2292
2297
2300
2305
2308
2312
2315
2319
2324
2329
2332
2337
2340
2343
2347
2350
2354
2357
2361
2365
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
