cpldcpu/TouchSynth/docs/figures/audio/tune_ode.png

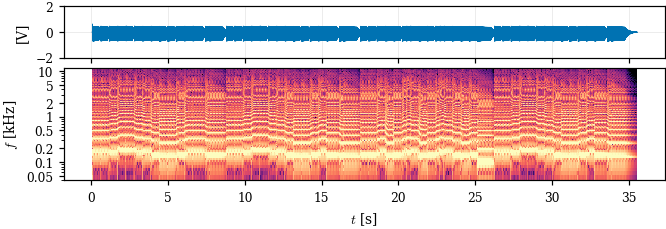
docs/figures/audio/tune_ode.png
