cpldcpu/TouchSynth/docs/figures/audio/tune_prelude.png

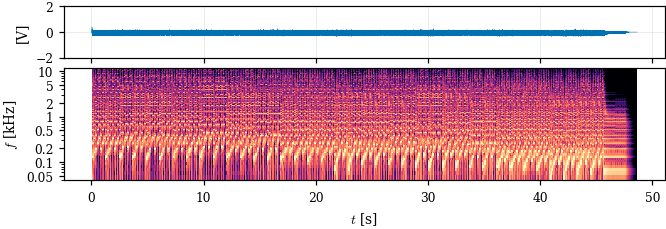
docs/figures/audio/tune_prelude.png
