cpldcpu/TouchSynth/docs/devlog.md

# TouchSynth development log

This log covers how TouchSynth was built in Claude Code sessions with Claude Opus 5.5. It runs from the first
question to the ordered board, and then through the bring-up of the first board and its demo music. Each entry quotes the prompt exactly as typed, typos included, and then summarises
what was done in response.

- **Times:** local time (CEST).
- **Queued:** a prompt sent while Claude was still busy with the previous request.
- **Dialog answer:** a reply typed into one of Claude's multiple-choice question dialogs.
- **Masked:** local user and host names in prompts are replaced by `<user>@<lab PC>`.
- **Not listed:** background-task notifications, the `/compact` commands and the session-limit interruption.

| Phase | Date | Commits |
|---|---|---|
| [1. Parts and concept](#1-parts-and-concept) | 2026-09-26 | `8f1367b` |
| [2. Simulation](#2-simulation) | 2026-09-26 | `832189b`, `66c811b`, `4f78d1a` |
| [3. Behavioural model and audio](#3-behavioural-model-and-audio) | 2026-09-26 | `eecc057`, `d467751` |
| [4. Schematic](#4-schematic) | 2026-09-26 | `ded0155`, `667ef96` |
| [5. PCB, 2-layer attempts](#5-pcb-2-layer-attempts) | 2026-09-27 | `14cf917` |
| [6. PCB, 4 layers and final floorplan](#6-pcb-4-layers-and-final-floorplan) | 2026-09-27 | `1c25794` |
| [7. Design report and firmware](#7-design-report-and-firmware) | 2026-09-27 | `a490e69`, `71ef9cc` |
| [8. Documentation](#8-documentation) | 2026-09-27 / 10-02 | — |
| [9. Bring-up and GitHub](#9-bring-up-and-github) | 2026-10-17 | `ff98477`, `90a4c37` |
| [10. MCU and functional tests](#10-mcu-and-functional-tests) | 2026-10-17 | `5665597` |
| [11. Multitrack demo](#11-multitrack-demo) | 2026-10-17 | `5665597` |
| [12. Classical and space-synth pieces](#12-classical-and-space-synth-pieces) | 2026-10-17 / 18 | `5665597` |
| [13. Drums, timpani and the report](#13-drums-timpani-and-the-report) | 2026-10-18 | `5665597` |
| [14. Board drum takes and clean-up](#14-board-drum-takes-and-clean-up) | 2026-10-18 | `5665597` |
| [15. Publishing check and a MIDI rendering](#15-publishing-check-and-a-midi-rendering) | 2026-10-18 | `c0a6ab6` |
| [16. PWM DAC and the kettle drum](#16-pwm-dac-and-the-kettle-drum-branch-polyphonic_exp) | 2026-10-18 | this commit (`polyphonic_exp`) |

---

## 1. Parts and concept

### 2026-09-26 20:59

> I want to decide a small PCB suing kicad for jlcpcb. how do i proceed?

Claude gave a step-by-step guide: deciding on the parts and who assembles them, project setup, schematic and ERC,
JLCPCB design rules, layout and DRC, Gerber/BOM/CPL export, and ordering. It listed common first-board mistakes.

### 21:09

> ah, i would like you to design a circuit, smiluate it with ngspice (available in wsl) and then design a board in kicad.
>
> we will use jlcpcbn basic parts: https://jlcpcb.com/parts/in-stock-parts
>
> Extract the part lists and then lets brainstorm what we can build out of it

- Claude found the JSON API behind the JLCPCB parts page and saved all 351 Basic parts to
  `parts/jlcpcb_basic_parts.csv`.
- It confirmed that ngspice-42 runs in WSL.
- It summarised what the list has: op-amps, 74HC logic, transistors, regulators. It also listed what the list
  lacks: an MCU, connectors, power inductors, pots and electrolytics.
- It proposed seven project ideas and recommended an electronic load or a function generator.

### 21:12

> they are called "promotional extended parts"

- Claude found the API filter for this list (`preferredComponentFlag: true`, with no library type) and fetched
  1,235 promotional extended parts.
- It wrote the combined list to `parts/jlcpcb_basic_and_promotional_parts.csv` (1,586 parts).
- The new list adds ATmega328P, STM32, CP2102, NE555, CD4051, matched BJT pairs (BC847BS), TP4056 and LM317. The
  ideas list was updated.
- The API trick went into Claude's memory.

### 21:17

> i could also populate a mcu later. i have a lot of ch32v002 and v003.

Claude proposed a constant-current load with the CH32V as an optional add-on: PWM sets the current, the ADC reads
back. It asked about package, power range and supply.

### 21:18

> i have both sop-8 and tssop-02

Claude picked TSSOP-20 and opened a question dialog to choose the project.

**Dialog answers:**

> Which project should we build? → how about some kind of synthesizer?
>
> Power rating for the load (if electronic load)? → na
>
> How is the board's own logic/op-amp supply powered? → 2-pin header 5–12V

Claude sketched a classic mono-synth voice from parts on the lists: expo VCO with BC847BS, transistor ladder VCF,
envelope, VCA, and the MCU as a do-not-populate (DNP) option. It noted that the analog part needs 9–12 V. A second
dialog followed.

**Dialog answers:**

> Scope of the synth? → I don't want to add too many parts beyond the ones that are available. how about an analog synth that is controlled by the mcu?
>
> Knobs: hand-soldered through-hole pots OK? → No pots, MCU sets everything
>
> Keyboard? → 13 buttons, one octave (Recommended)

This revised concept became the design:

- **Oscillator:** a Juno-style DCO. The MCU timer resets a TL072 integrator, so the pitch is crystal-accurate.
- **Control voltages:** four PWM-derived CVs (oscillator amplitude, cutoff, resonance, VCA).
- **Voice:** a ladder VCF and a BJT VCA.
- **Controls:** keys plus SHIFT / − / + and LEDs for parameter editing, and MIDI in.

### 21:23

> hey, lets use captouch for the keys?

- **Touch method:** Claude checked the CH32V002 and V003 datasheets (saved in `docs/datasheets/`). The V002 has
  touch hardware. The V003 can sense touch through its ADC (charge sharing), which works on both chips.
- **16 pads:** two CD4051 muxes put the 16 pads on 2 ADC pins.
- **16 LEDs:** two 74HC595 drive them and share the mux select lines, with one extra latch pin.
- **Pin plan:** a first TSSOP-20 pin plan with the remapped TIM1/TIM2 outputs.

### 21:28

> lets use ch32fun for the firmware.

- Claude built ch32fun's touch example in WSL for both the CH32V003 and the CH32V002, and confirmed that one code
  base covers both chips.
- It wrote `docs/spec.md`: block diagram, requirements, pin map, preliminary BOM with LCSC numbers, simulation plan
  S1–S7, and firmware and PCB notes.
- It suggested `git init`.

### 21:51

> yes, do git init. and then link ch32fun as submoviulde for the firmware.

**Queued, 21:51:**

> specs look good!

**Queued, 21:51:**

> i have kicad 10 installed in windows

- Claude created the git repository and added ch32fun as a submodule in `firmware/ch32fun`.
- Line endings: the global CRLF setting broke `make` in WSL. Claude turned off line-ending conversion for this repo
  only, added `.gitattributes` (LF) and `.gitignore`.
- It found KiCad 10.0.6 in the per-user install folder, with `kicad-cli` and its bundled Python.
- Initial commit `8f1367b`.

## 2. Simulation

### 21:53

> ok, go ahead and finish all simulations.

**Queued, 22:00:**

> write a report with figures about the simulations

**Queued, 22:01:**

> I will later ask for a design report in latex - possible it may already help to consider that in the figure styles etc

**Queued, 22:13:**

> ok, here is an idea: in the circuit also consider loopback of audioi and possibly other test signals into the mcu. Once the board is there, I can connect you with minichlnk to debug the design. ideally, set up a verificaion/validation plan beforehand

**Queued, 22:17:**

> is a third cd4051 really needed? there should be some free pins?

Claude built a Python harness for ngspice in WSL (`sim/lib/`) and ran seven simulation blocks:

- **S1, DCO:** saw amplitude flat over C1–C8.
- **S2, PWM CV filters:** ripple and settling checked against the targets.
- **S3, ladder VCF:** response and resonance up to self-oscillation.
- **S4, VCA:** off-attenuation and thump.
- **S5, touch through CD4051:** SNR 39 (V003) / 152 (V002).
- **S6, full voice:** rendered to WAV.
- **S7, power and hum.**

**Design changes forced by the simulations:**
- PWM became 10-bit at 46.9 kHz with 2-bit dither.
- The resonance path was redesigned with a difference amplifier.
- The VCA got a 470 k anti-offset resistor and an 8-bit R-2R trim DAC on a third 74HC595 to remove the thump.
- The VREF buffer became a follower with a snubber.
- The ladder capacitors went from 47 nF to 33 nF.

**Output and your other requests:**
- **Figures:** a uniform, LaTeX-ready style, saved as vector PDFs, with every result also in a CSV (`docs/results/`).
- **Loopback:** audio out goes into PD5 with no third CD4051. A temperature sensor was added on a freed pin.
- **Reports:** `docs/sim_report.md` and `docs/verification_plan.md` (bring-up, 14 automated tests, calibration, a
  test-console command set over minichlink).
- **Open question:** whether to accept the power-on pop.
- Commits `832189b` and `66c811b`.

### 22:59

> pop is ok.
>
> the temp sensor seems a bit excessive? this is only a demonstrator thing.

The temperature sensor came out. The 74HC595 latch went back to PD4, and PD7 stays NRST. The pop and the
−13 cent/K filter drift are documented as accepted limitations. Commit `4f78d1a`.

## 3. Behavioural model and audio

### 23:00

> how about creating a behavioral model and then generating some audio examples? would be interesting to see what each feature does

**Queued, 23:01:**

> there could also be some demo tunes in the mcu

**The model:**
- Claude wrote a fast Python behavioural model (`sim/behav/`) that takes its constants from the simulation CSVs
  and validated it against the SPICE voice: about 0.6 dB in level, about 2 % in self-oscillation pitch.
- It found a real circuit bug: the last RC stage of each CV filter was loaded by the stages before it. Because of
  that, three CVs only reached about 60 % of their range and the cutoff only went from 44 Hz to 4 kHz.
- The networks were redesigned and all simulations now drive the real networks. The cutoff now spans
  19.9 Hz–19.8 kHz. VCA gain and the loopback divider were adjusted, and S1–S7 were re-run.

**Audio and tunes:**
- 19 feature clips and 3 demo tunes (an original acid line, Bach's BWV 846 prelude, Beethoven's Ode to Joy) in a
  3-byte step format for the MCU.
- A private listening page with spectrograms was published as an artifact.

Simulation report rev 2. Commits `eecc057` and `d467751`.

## 4. Schematic

### 23:24

> good work! yes, lets go for kicad

**How the schematic is built:**
- `hw/design.py` is the single source of truth: parts, LCSC numbers, footprints, simulation names and nets.
- `hw/lcsc.py` picks passives from the lists, with voltage ratings checked.
- `hw/gen_sch.py` writes seven KiCad 10 sheets.

**Checks, all passing:**
- ERC: 0 violations.
- `check_netlist.py`: KiCad's netlist matches the design.
- `check_sim.py`: all 145 simulated components match the schematic.

Claude also added a project footprint library with the touch pads. The LED resistor arrays became 4.7 k, and the
line out got a 100 k pull-down. Commit `ded0155`.

### 23:39

> any chance to turn this into a proper schematic?

*(screenshot of the label-only schematic attached)*

**Queued, 23:41:**

> hm... i think we don't need midi, i can't test it. maybe we leave it unpopulated?

- Claude wrote a drawing layer (`hw/draw.py`) that works out connectivity from the geometry, labels split nets
  automatically and refuses to write a sheet with a short.
- Every sheet now has a hand-drawn layout in `hw/layouts.py`, with signal flow left to right and parts wired as
  circuits. The writer is `hw/gen_sch2.py`.
- The MIDI parts are DNP.
- ERC, netlist and simulation checks all pass. Schematic PDF: `docs/touchsynth_schematic.pdf`. Commit `667ef96`.

## 5. PCB, 2-layer attempts

### 2026-09-27 00:01

> excellent! lets go for the pcb then

- The board grew from the proposed 100 × 80 mm to 100 × 100 mm, still in JLCPCB's cheapest size tier, because about
  230 parts would not route well on 2 layers in the smaller size.
- `hw/gen_pcb.py` generates the board with KiCad's Python API: fixed keyboard, LEDs, connectors and holes, and
  automatic cluster packing.
- A first Freerouting run started.

### 00:17

> should the part placement follow the functional blocks?

Claude explained that the clusters followed blocks but not signal flow. It proposed a floorplan in signal-flow
order, placement templates for each block, and analog/digital separation.

### 00:18

> sounds good

Claude stopped the old routing run and began the block floorplan. The session limit then interrupted the work.

### 08:07

> continue

The run was cut off by a transient sign-in (OAuth) token error.

### 08:11

> continue

- The routing run had finished. Claude checked DRC and applied PCB fixes: courtyards and ground-pour connectivity.
- A new route started.
- The context was compacted after this.

### 08:18

> some thoughts: it would be cool to have silk screen that indicates the different circuit blocks. Also, i wonder whether using discrete resistors instead of the arrays is easire for routing and cheaper?

**Queued, 08:18:**

> also, in general, some nice silkscreen art would be cool

**Discrete LED resistors:** the arrays became 16 discrete 4.7 k resistors, one next to each LED. Cost is about the
same, and routing is much easier.

**Silkscreen art (`hw/pcb_art.py`):**
- **Front:** a dashed frame with a name tab for each functional block, a piano-style keybed with hatched black keys,
  and a bottom strip with the logo, a resonant saw and the ladder response curves.
- **Back:** a signal-flow diagram.
- All text meets JLCPCB's silkscreen minimum (0.8 mm text, 0.15 mm lines).

**Placement:** the placer now packs parts inside "street"-inset block rectangles. Commit `14cf917`.

### 08:42

> wait, where can i see the images?

The renders were only in Claude's scratch folder. Claude copied them to `docs/figures/pcb/`.

### 08:45

> i like it! also add data on the read side and author (opus 5.5

**Queued, 08:45:**

> +cpldcpu

**Credit line:** the back now carries board facts and
"rev 0.1 | 2026-09-27 | design: cpldcpu & Claude Opus 5.5".

**Routing on 2 layers stayed hard:**
- **Timeout:** Freerouting's optimiser ran past the time limit. The fix was to run it with `-mt 0`.
- **Touch keys unrouted:** the key no-pour areas were being exported as keep-outs. They are now taken out while
  routing and put back afterwards.
- **Ground stitching:** each GND pad gets a locked via before routing, and a GND via grid is added after.
- **Clean-up tools:** island linking, a `--finish` mode, and a 2.4 mm-strip keep-out on the back under each key.
- **Progress:** unconnected items went from 78 to 27 to 7. Ground islands kept coming back.

## 6. PCB, 4 layers and final floorplan

### 10:48

> maybe its woth considering a 4 layer pcb? that would allow for better signal integrity as well

**New stack-up:**

| Layer | Use |
|---|---|
| F.Cu | signals, GND pour |
| In1 | solid GND |
| In2 | split power: VP for analog, +5V, GND under the keys |
| B.Cu | signals, GND pour |

**Supporting changes:**
- No inner-layer copper under the touch pads.
- Every GND, VP and +5V pad gets a via into its plane before routing.
- A new A* maze router (`hw/pcb_maze.py`) pre-routes supply pins outside their plane and finishes any leftovers.
- The via grid keeps clear of the mounting holes.

The first 4-layer route had no ground islands and only a few open nets.

### 12:12 (queued)

> status? the freerouting window disappeared

- The run had finished with 7 nets boxed in (SUB, PWM_AMP, DCO_RST, EXPO_NA, LED_Q3, RES_IN1, XAMP).
- Claude started a rip-up repair pass: clear a corridor, re-route with Freerouting, then the maze router.
- Renders were updated, and the vias that punched through the back lettering were removed.

### 13:22

> maybe providing more space is also an option? there is still a free area at the bottom, moving the keys down a little may clear up routing space at the top (maybe also with less dense component placement)

- White keys went from 16 to 13 mm. The black keys, function pads and LEDs moved down 3 mm.
- The circuit area grew to y 9–53.5, and all blocks stretch evenly into it.
- Part spacing went from 0.15 to 0.3 mm.
- GND grid vias now avoid all silkscreen.
- A full reroute started.

### 13:25

> can you also show the render after placement?

Claude added `docs/figures/pcb/render_top_placed.png` and described what changed.

### 13:26

> looks good

Acknowledged. Routing continued.

### 13:28

> minor nitpick: the shift, +,- keys dont align anymore

*(screenshot attached)*

The SHIFT / − / + pads are now evenly spaced and flush with the keybed outline at top and bottom. Routing
restarted.

### 14:04

> another idea to reduce congestion: add the testpoint directly in the circuit blocks where they origine. Also, add a ground pin (tht) for the scope

**Queued, 14:07:**

> move the gnd test pins a little further away from the othe headers plz

**Queued, 14:08:**

> the +5v test point should be in the power block

- **Test points:** each one now sits in the block where its net has the most pins, with space reserved for its
  label. That removes about 20 long traces.
- **Scope ground:** two through-hole GND pins (1×01 header) on the top edge, well away from the other headers.
- **+5V test point:** now in the power block.
- The schematic was updated to 242 parts.

### 15:18

> it seems to routing issues are mostly coupled to the leds and touch keys, right? maybe a different component placement would help here, where the shift registers and multiplexers are closer to the keys

**Queued, 15:18:**

> the DAC shift register does of course need to be close to the vca

**New floorplan:**
- **KEYS I/O row:** a full-width row directly above the LEDs, holding mux A, LED shift register 0–7, LED shift
  register 8–15 and mux B. The 32 LED and touch lines became short vertical drops.
- **Trim DAC:** its own block next to the VCA, with the 74HC595 and the R-2R ladder.
- **MCU and MIDI:** a right-hand column.
- **Analog area:** 72 × 36 mm, in signal-flow order.
- **Power layer:** In2 split in an L shape. Decoupling capacitors are tied to their ICs.

**Result:**
- Fully routed in 24 minutes: DRC 0 violations, 0 unconnected.
- `hw/fab.py` writes the JLCPCB Gerbers, BOM (40 lines, 196 placements) and CPL.
- Renders and per-layer images are in `docs/figures/pcb/`.
- Commit `1c25794`.

## 7. Design report and firmware

### 16:04

> ok, ordered. will take 3 weeks until we can move to verficiation and validation
>
> can you write a design report in latex?

Claude wrote `docs/report/touchsynth_report.tex` (PDF committed, 32 pages). It covers requirements, architecture
(TikZ block diagram), circuits (circuitikz DCO and CV filter), S1–S7, the behavioural model, the PCB, the BOM
(about USD 3.65 of parts per board), the firmware plan, V&V, open points and the schematic appendix.

`gen_tables.py` generates the BOM, floorplan and statistics tables from the design data. The report builds with no
overfull boxes. Commit `a490e69`.

### 16:18

> great!
>
> can you also implement a first version of the firmware? that is a good consistency check whether the pin assignment is correct

**Queued, 16:22:**

> I can also use a V006 if you need more sram/flash

**Queued, 16:31:**

> maybe the demo songs could also be a bit longer

**Pin check:**
- `check_pins.py` checks every firmware pin against the netlist, the KiCad symbol and the remap tables of both chip
  families. All 16 signal pins are OK.
- It found that the remap *codes* differ:

  | | CH32V003 | CH32V002 / V006 |
  |---|---|---|
  | TIM1 | 01 | 0010 |
  | TIM2 | 01 | 010 |

  This closed the open point in the spec.

**Firmware 0.1** (`firmware/touchsynth/`, ch32fun):
- **Control voltages:** dithered CV PWM in a 46.9 kHz interrupt, which also generates the noise LFSR.
- **Oscillator:** DCO reset, pulse and sub-oscillator.
- **I/O:** the 595 chain for the LEDs and trim DAC, the touch scan through the muxes, the loopback ADC capture, and
  MIDI receive.
- **Voice engine:** 1 kHz, mirroring the behavioural model, with presets and the tune player.
- **UI:** SHIFT + key selects a parameter, − / + changes it, and the LEDs show the value.
- **Test console:** over SWIO, for the verification plan.
- **Size:** builds for V003, V002 and V006. On the V003 it uses 11.7 KB of 16 KB flash and 1.3 KB of 2 KB RAM, so
  the V006 isn't needed yet.

**Longer tunes:** acid A-A-B-A with a turnaround (about 19 s), prelude bars 1–19 (about 48 s), the full Ode theme
(about 35 s). The audio was re-rendered.

The report got a firmware chapter. Commit `71ef9cc`.

### 16:52

> great! lets compact now and then see you in about three weeks!

Claude wrapped up with the next steps for when the boards arrive:
1. Bring-up without the MCU.
2. Solder and flash the MCU.
3. Run the verification plan over `minichlink -T`.

## 8. Documentation

### 17:07

> also create a readme for the main folder

`README.md` covers the overview, status, demo-tune links, a document index, the repository layout, the script
flow from `design.py` to the fab files, and the key numbers.

### 2026-10-02 05:53

> can you create a development log? devlog.md in main
>
> - include all my prompts verbatim
> - summarize what was done in response

This file. The prompts were extracted from the session transcript, including queued messages and question-dialog
answers.

## 9. Bring-up and GitHub

### 2026-10-17 15:52

> ok, the boards have arrived now

Sent to the first session, which ended there. The work continued two minutes later in a new session.

### 15:54

> The manufactured boards are now available for bring up

Before the first measurement Claude checked the expected values and found a model error: the 78L05 model drew
only its quiescent current from the input, so the current budget missed everything on +5 V. The regulator is now
a series pass element in `sim/models/models.lib`. The expected voltage at every test point with the MCU not
fitted was recomputed (`sim/bringup/bringup_op.py`) and became the bring-up table, with instructions for B1–B10.

### 15:57

> can you update the bring up section in the report? i will commence with the measurements then

S7 was rerun with the corrected regulator. The report's S7 section, `docs/sim_report.md` and the README supply
line got the new current, and the report's bring-up section the new table.

### 17:17

> 9V IN - all LEDs light up, no MCU mounted
> B2 0mA
> B3 25mA
> B4 8.57
> B5 5.028
> B6 4.53
> B6a 1.57 / 2.515
> B7 2.39 / 4.32 / 6.28
> B8  1.88
> B9 4.53
> B10 4.52 / 4.52 / 4.51
> B10a 0 / 0 /  0
> B10b 1.57
> B10c 4.92

Board 1 passes B1–B10. The two readings that looked wrong were errors in the expectations:
- **Floating MCU pins:** the missing MCU had been modelled as pins driven to 0 V. In reality they float, so
  XCUT_IN rises to VBIAS and the ladder runs at about 8 µA, which matches XCUT_IN, TAIL and VBIAS as measured.
- **Input current:** the TL072 model drew 4 mA per amplifier instead of the datasheet's 1.4 mA. With both fixes
  the simulation predicts 25.7 mA with all LEDs lit, against 25 mA measured; S7 became 31 / 32 mA.

Two small observations went into the report: VP is 0.15 V low (the SS14 drops more than modelled), and the
upper ladder bias taps are about 1.7 % low.

### 17:30

> I would like to commit this repo to: https://github.com/cpldcpu/TouchSynth
> Can you set that up? please do not add anything.
>
> Also check whether gitignore is up to date and there are no temp artifacts commited

Claude looked at the remote, which held only a `LICENSE` file. The request was then interrupted.

### 17:31

> don't commit anything yet

Claude stopped. The work was then committed as `initial` (`ff98477`) outside the session.

### 17:32

> ok, check and publish

The `initial` commit was checked: no build or temporary files, `.gitignore` complete, and the `ch32fun`
submodule points to a commit that exists upstream. The remote's `LICENSE` commit was merged instead of
force-pushing, the branch renamed from `main` to `master` to match GitHub, and pushed (`90a4c37`).

## 10. MCU and functional tests

### 18:05

> ok, a CH32V006 is mounted now. The programmer is connected to a linux system on the network: <user>@<lab PC>

The V006 datasheet gives the TSSOP-20 part the same pin numbers as the V003 / V002 and the V002's timer remap
codes, so firmware 0.1 runs unchanged (PA4 is bonded to PD7 and must never be an output). The firmware was built
for the V006. Claude asked for SSH key access to the lab PC.

### 18:07

> ok, you got access now

`minichlink` was built on the lab PC from the project's ch32fun, the firmware flashed, and the console answered
`id` (B11). Two firmware fixes came first: the touch thresholds, and key C sticking after reset.

### 18:17

> input current is approx 25mA with the current state of the LED. (all are off).
>
> tell me when to start touching the keys

B12 passes with 25 mA. A 3-minute touch log started, with instructions to touch all 16 pads in turn.

### 18:18

> ok, all keys seem to work. the leds next to +,- and shift never light up though

T2 passes: every pad recognised, touches 20–90 times above the noise. The three LEDs were forced on from the
console to tell a board fault from a firmware one.

### 18:25

> they are not on

The console had parsed `e000` as 0. With `0xe000` the LEDs lit:

### 18:26 (queued)

> ok, now they are on

So the LEDs and their drivers are fine. The display only lit them in edit mode or as the top of a value bar.
They now light while their pad is touched, and `leds` accepts hex with or without `0x`.

### 18:30

> ok continue with the bring up

The analog tests use the audio loopback into the MCU, which read wrong. Claude asked for a measurement at R109.

### 18:40

> on R109, i got 4.5V on the left side and 5mV on the right side

Two new console diagnostics, `adc` and `latch`, showed PD5 (loopback) following PD4 (595 latch): MCU pins 1
and 2 were bridged by solder. Claude described the rework.

### 18:45

> check againb

No answer on SWIO: the board was unpowered or the cable moved.

### 18:46

> power was off, should work now

With the bridge removed the loopback worked. Claude wrote `tools/hwtest.py`, which runs the functional tests
over the console, and found one more firmware bug on the way: the trim DAC lost its MSB because the shift
clock was not low before the first bit. T1, T2 and T4–T12 pass; the opening VCA step has a ~2 % slow (thermal)
tail and the noise floor of about −55 dB is marginal.

### 18:52 (queued)

> take some recordings for nice figures for the bring up report

The test captures were saved as CSV in `docs/results/hw_board1*` for the report figures.

### 19:10

> i connected a scope to the audio output now. when i touch the keys i do not see any output?
> you can access the scope via ethernet on the <lab PC> machine. it is a rigol mso0574. ch1 connects with 1x attention to audio out

The tests had left the board in manual mode with the VCA closed, where the keys are ignored. Touching a key now
ends manual mode. `tools/scope.py` talks SCPI to the scope; a console note showed 600 mVpp at 259 Hz on CH1.

### 19:17

> can you record some sound examples via the scope? you can use hires mode or oversamplnig to improve enob. (i dont have audio attached and want to hear how it sounds)

The first attempt hung the scope's network socket: 16-bit transfers send more bytes than announced. Claude
asked for a LAN reset and made the recorder use 8-bit blocks of known length.

### 19:33

> done

Five recordings in `docs/audio/hw_board1/`: the three demo tunes, a waveform tour and a scale on the
self-oscillating filter. HRES mode does not help (the scope stores 8 bits even then), so the recorder takes
50 M points in normal mode and averages them down to 48 kHz; the noise floor is about −55 dB.

## 11. Multitrack demo

### 20:09

> can you compose and arrange a multi-voice tune? you can record them one after another and then mix

### 20:09 (queued)

> make it a longer demo to show off the synth

### 20:10 (queued)

> how good are percussions?

The *TouchSynth Demo*: 7 parts (kick, snare, hat, acid bass, arp, lead, pad), 118 bpm, 69 bars in six sections.
Each part starts with a sync step, a 4 ms fully open VCA pulse, so the takes can be aligned. Each part was
recorded as one scope take and mixed with `tools/mix_parts.py`. On the way the MCU clock was found to run
0.8 % slow (47.62 MHz, about 14 cents flat). The percussion presets were tuned on the board: a pinged filter
rang like a tom, so the kick became a filtered sub square.

### 21:11

> i see some leds flickering occasionally. maybe the tough threshold is too low?

They were ghost touches: the noise estimate at power-up was sometimes very low, giving thresholds of 48–96 counts.
The touch calibration now averages 64 scans after a warm-up, the threshold has a floor of 200 counts, and a key
counts only after two consecutive scans.

### 21:24

> the c key led is blinking

No ghost touch: the LEDs show the notes of the part being recorded, and the hat part plays C4. Meanwhile the
scope triggering was fixed: at slow timebases it only started on a real trigger, so it now triggers on each
part's sync pulse.

### 21:58

> status?

The demo was finished: [touchsynth_demo_hw.mp3](audio/demo/touchsynth_demo_hw.mp3), 2:24, with a model
version next to it. Each take's clock is fitted from its note onsets, because it drifts by up to 0.1 % between
takes.

## 12. Classical and space-synth pieces

### 22:15

> maybe we could try another demosong? how about some cool classical moog synthesizer song? also to use nice filter sweeps.
>
> maybe something by wendy carlos? clockwork oranga title?
> or oxygene from jmj?

Claude offered four options, without copying Carlos's or Jarre's arrangements: Bach's Toccata, an original
Oxygène-style piece, Purcell's Queen Mary March (the piece behind the Clockwork Orange title), or a suite of a
space-synth intro and the Toccata.

### 22:17 (dialog answer)

> all great ideas! lets do 1,2,4 and i will find the score for the queen mary march

### 22:19 (queued)

> score is in the temp folder

The firmware got control steps (cutoff and resonance ramps within a tune), hold and tie flags, and eight new
presets. The March came from the WIMA edition's PMX source (four trumpets, C minor), checked against the PDF.
The Toccata was first written from memory, Aerosphere composed as an original piece. Recording started.

### 22:36

> why dont you just deactivate the keys for the session?

New console command `keys 0`: the pads are still scanned but play nothing, so no touch can stop a recording.

### 22:49

> in the march there is a strange pumping background noise. is this from the original sheet?

Not the score: the tom preset self-oscillated at 84 Hz between hits, and the pedal's sub-oscillator played
33 Hz. The pedal lost its sub, the tom was rebuilt from noise, and the March was remixed.

### 23:13 (queued)

> soimething is wrong with the toccata. i found a midi file and the sheet musing, they are in temp

The Toccata from memory was wrong. It was rebuilt from the MusicXML score (measures 1–30, up to the Fugue) with a
small reader (`sim/behav/musicxml.py`): mordents and the trill written out, fermatas doubled, up to nine voices
allocated by nearest pitch to eight manual tracks plus pedal. Tunes now store a step time in ms, so the fast
runs fit a 20 ms grid.

### 2026-10-18 00:31

> status?

Aerosphere was mixed. Two of its takes had been captured without their sync pulse, so `mix_parts.py` now also
aligns each take to the model render of its part. A bug in that alignment, which could not look back far
enough, was fixed afterwards. The Toccata takes were recording.

### 00:59 (queued)

> how much is still left? can i turn off the hardware?

Everything was recorded: the March, the Toccata, Aerosphere and the suite, each as a board and a model version.
The opening wind of Aerosphere had been lost and was re-recorded first.

## 13. Drums, timpani and the report

### 01:10

> the drums do not really sound like drums

### 01:11 (queued)

> but the oscillator is software controlled, right? so the pitch envolope could be added by software

Measured on the board takes: a constant 41 Hz kick without attack, a snare tone ringing for 300 ms, a tom that
was a filter ring. The engine got a **pitch envelope** (the DCO timer is retuned every ms), a **wave switch**
(tone and noise separated in time) and **source muting** below −66 dB (the closed VCA leaks at about −40 dB).
New kick, snare and hat presets, at first in the model only, since the hardware was off.

### 01:25

> what is the drum used in the march? it sounds still off

### 01:26 (queued)

> its rather the sound of the drum

Purcell's score has no drum part; the tom was an addition and, now clearly pitched, sat on D3 against C minor.
It became timpani on C and G that follow the harmony bar by bar.

### 01:27 (queued)

> btw, did you already write a bring up report?

### 01:28 (queued)

> you can use a subagent for the report

The report had only B1–B10. A subagent added B11 / B12, the T1–T14 results with four figures from the
measurement data (`tools/hw_figures.py`), the defects found and the open points. T3 (touch scan rate) and T14
(MIDI) had never been measured and are marked so.

### 01:31

> i found a timpani recording and it sounds quite different. i put it into temp

A kettledrum has little energy at its nominal pitch; its partials sit near 1.5, 2 and 2.5 times it, the double
the strongest. The new timpani locks the filter resonance onto the second harmonic, and for the first 40 ms adds
the sub-octave and noise for the 1.5- and 2.5-fold partials. It matches the recording's level per time window
within about 3 dB; the inharmonic partials remain out of reach of one oscillator.

### 01:33 (queued)

> tex is available in wsl

Passed on to the report subagent.

### 01:43 (queued)

> also add a section about the demotunes and how the instruments are implemented

New report section *Demo tunes and instruments*: the tune format, the demos, the multitrack pieces and how they
are recorded, a table of all presets, the percussion engine and a drum figure (`tools/instrument_figures.py`).

### 01:45 (queued)

> gitignore temp/

Done.

## 14. Board drum takes and clean-up

### 08:39

> the hardware is available again

The new firmware was flashed and the six drum parts recorded. On the board the timpani's partials match the
model, so the resonance lands on the second harmonic.

### 08:48

> what exactly is missing in the hardware to make the timpani sound better?

In order of importance: a second, independent oscillator for inharmonic partials (or the self-oscillating
filter used as one), a band- or high-pass mode to remove the fundamental, separate decays per partial, and
polyphony, since each stroke cuts off the previous one.

### 09:03

> status?

The new drums measured on the board: the kick falls from 108 to 55 Hz and peaks after 2.6 ms, the snare is
bright and short, the hat reaches −20 dB after 41 ms.

### 09:04

> can you add readme.md to the docs folder explaining all the content that is there now?

`docs/README.md` indexes the documents, figures, result data and audio. Meanwhile all pieces were remixed with
the new drums, after a fix to the clock fit: dense hats had locked it onto a neighbouring grid.

### 09:26

> can you create a fork where we can experiment with more modified hardware to improve sound quality? Lets call it polyphonic_exp

Interrupted.

### 09:27

> sorry, a branch, not a fork

Branch `polyphonic_exp` created at `90a4c37`, without switching to it, since the work since then is not yet
committed.

### 09:27

> check whether anything needs to be cleaned up

Found: stale READMEs and devlog, lab-specific hosts and paths in the bench tools, the recording script only on
the lab PC, and about 45 MB of new MP3s.

### 09:34

> ok, update readme and devlog

### 09:34 (queued)

> regarding environment specific - can you fix that? maybe a config file that is gitignored

### 09:35 (queued)

> also update the pdf report. link it and the examples from the main readme

The README now gives the board 1 status and links the report, the board recordings and the model versions;
the firmware README has the current sizes, presets and console commands. The bench settings (lab PC, its
directory, `minichlink`, scope address) moved to `tools/lab.conf`, which is gitignored, with
`tools/lab.conf.example` as the template; `tools/record_parts.sh` is the recording script from the lab PC.
The report got corrected firmware sizes and the bench steps under *Reproducing the design*. This log was
extended from the transcripts.

## 15. Publishing check and a MIDI rendering

### 09:47

> is there any personally identifiable information or anthing else that i should not publish in the repo and logs?

A scan of all files to be published, the PDF metadata and the git history found no secrets, keys or private
addresses. Findings: a Windows user path in `hw/sexp.py` (also in the history), the lab login and host name in
two quoted prompts, the WCH datasheets, and the unknown licence of the timpani recording behind one figure.

### 09:53

> gitignore the wch datasheets.
> move the devlog to docs/. no need to link it from the main, but link from docs readme

### 09:53 (queued)

> yes, and remove the windows paths from future commits

`docs/datasheets/` is ignored and the two tracked datasheets untracked. This log moved to `docs/` and is linked
from `docs/README.md`; the host names in the quoted prompts are masked. `hw/sexp.py` finds KiCad through
`KICAD_DIR` or the standard install folders, and provides `kicad-cli` to `check_netlist.py` and `fab.py`.

### 09:57

> ok, commit

Commit `5665597` on `master`: board 1 bring-up, the demo pieces, the percussion engine, docs and tools.

### 09:58

> i put a midi of oxygene into the temp folder. can you implement this using the emulator first?

The piece is under copyright, so everything derived from the MIDI stays in a new gitignored folder, `private/`;
only a generic Standard MIDI File reader (`sim/behav/midifile.py`) is part of the repository. The arrangement
maps the 13 MIDI channels onto 19 monophonic parts on a 41 ms grid (triplets and 16ths), splits the pad chords
into voices by nearest pitch, and renders and mixes them with the behavioural model. Part levels were balanced
from measurements.

### 10:19

> the instrument starting at ~0:06 sounds very off

Pitches and timing were right; the sounds were not. The intro blips (a marimba in the MIDI) had been put on a
resonant sequencer patch, the sequence itself was squelchy instead of round, and the sea noise whistled through
a near-self-oscillating filter. The blips got a soft mallet patch of their own, the sequence a rounder one with
milder filter waves, and the sea plain swelling noise.

### 10:25

> ok, commit. then update the polyphonic branch and switch to thtere

Commit `c0a6ab6`; then `polyphonic_exp` was moved to it and checked out.

## 16. PWM DAC and the kettle drum (branch polyphonic_exp)

### 10:32

> ok, I would like to brainstorm a bit how we can extend the synthesizer. First, it seems we should add more oscillators?

Constraints first: each independent pitch needs its own timer, the CH32V003's two timers are taken, the
CH32V006 has a third (TIM3, interrupt only), and all 18 GPIOs are in use. Options from cheap to ambitious: a
second square oscillator from TIM3 on the sub pin (firmware only), a second analog saw DCO, an XOR ring
modulator, a bigger MCU with more timers or a DAC, or several boards chained over MIDI for polyphony.

### 10:36

> a minimoog has three oscillators, right?

Yes: three VCOs plus noise with a level each in the mixer. On board 1 three oscillators are possible in
firmware (TIM2, TIM3, SysTick), but the digital outputs enter the mixer at fixed, equal levels.

### 10:46

> what would we need to properly generate the timpani sound?

Inharmonic modes that beat, a separate decay per mode, a soft mallet and two ringing drums. Ways to get there:
additive synthesis with oscillators and per-oscillator levels, modal synthesis with a resonator bank, or
samples. The last two need an audio DAC.

### 10:48

> we could just use the pulse output for an PWM based dac, couldnt we?

Yes: the pulse pin feeds the passive mixer and the ladder, which can reconstruct a PWM signal. The ladder's
input pair sees only two levels, so its tanh does not distort the duty code. The CH32V006 has a hardware
multiplier and a 7-channel DMA.

### 10:50

> sounds good, do it

- **S8 (ngspice):** a PWM-encoded sine through the real netlist.
- **Model:** `sim/behav/dsp.py`, and a PWM input path for the ladder in `behav.py`.
- **Firmware:** DAC mode (TIM2 at a fixed carrier, DMA1 channel 2 from a ring buffer, DSP in the main loop)
  and `dsp.c`, modal synthesis in fixed point.
- **Kettle preset:** modes fitted to the recorded timpani.

### 11:20

> much better! maybe it could have more harsh metallic sound?

Three variants: a hard mallet, louder and longer upper modes with four more high modes, and beating pairs of
split modes.

### 11:23

> i like kettle c. but it seems to clip a little? in any case, can you render a variant of the march with it for me to listen?

The DSP sum reached 8 times full scale in the March's rolls. A cubic soft clipper and a lower gain fixed it.

### 11:36

> the drum pitch sounds too high compared to the original. can you check that?

Two causes. The recording is an F3-A3-C4 triad, and the fit had read the C4 drum as a C3 drum with a strong
octave, so every mode was an octave too high. On top, variant C's boosted 3.23x mode outlasted the principal.
The ratios were halved and the upper modes kept below the principal; the strongest partial is now the note
at every timpani pitch.

### 11:49

> hardware is back up, you can test on hardware

Four problems on board 1:
- **Stack overflow:** only 280 bytes of stack were left; the DAC ring now shares the console's capture buffer.
- **Stalled control tick:** a preset switch blocked interrupts for over 1 ms and SysTick waited for a counter
  wrap; it now resynchronises.
- **DSP too slow:** the sample rate was halved to 15.625 kHz, and the excitation term is computed only during
  the mallet contact.
- **Blocking console `wait`:** it starved the DAC in test sequences.

### 12:02 (queued)

> you can move the inner loop to sram for a speed up

Done: the refill loop runs from SRAM, the longest refill dropped from 8 to 4.4 ms of the 8.2 ms half. On the
board the kettle sounds at the note (scaled by the -0.8 % clock) and decays as in the model; the March
timpani part was recorded and mixed.

### 12:20

> can you explain in the report what you did to implement the new kettle drums?

New report sections: S8 (PWM DAC), the kettle on the PWM DAC (design, fit, firmware, board results), DAC mode
in the firmware chapter, a figure with the kettle against the recording and against the model, and an open
point for the faint 122 Hz line at the buffer-half rate.

### 12:30

> are you using symmetric dac and interpolation?

### 12:30 (interrupted, then)

> dymmatric pwm

No: the DAC used edge-aligned PWM and held each sample. Centred pulses would remove the pulse-position
modulation, and linear interpolation would lower the sampling images.

### 12:31

> ok, do that

TIM2 now counts up and down in DAC mode, a 93.75 kHz carrier with centred pulses. The update comes twice per
period, so each duty value is stored twice. The refill interpolates linearly between samples. S8 with three
variants: the second harmonic drops from -45 to -68 dB, the first image from -26 to -49 dB; the carrier is
only 28 dB down with the filter fully open, but below -74 dB at the kettle's 4 kHz cutoff. On the board the
high band drops by 5 dB and the tail noise from 2.6 to 2.2 mV. The March timpani was recorded again.

### 12:45

> ok, update docs, then commit

READMEs, devlog and report updated; commit `313b7e2` on `polyphonic_exp`.

### 12:51

> submit a pull request

The GitHub CLI is not installed here, so the branch was pushed with git and the pull request form opened in the
browser with title and description filled in. It covers three commits, because `master` on GitHub was still at
the initial state.

### 12:55

> I hear more noise in the march_hw recording not. Is this possibly due to the lower PWM frequency?

Partly, but not on the line out. Measured at 1 MSa/s, the line out is at the board's noise floor in the audio
band. About 5.8 mV of the 93.75 kHz carrier reaches it past the filter and the VCA (crosstalk on the board, still
4.9 mV with the VCA closed). A 200 s scope take is sampled at only 200 kSa/s, which folds the carrier's sidebands
into 2-8 kHz; the old 187.5 kHz carrier had folded to 8-20 kHz, where it is less audible. Second-order noise
shaping with independent codes per half period changed nothing measurable and was reverted.

### 13:04

> or go to higher carrier at lower resolution, but still with symmetric pwm, linear interpoliation and sigma delta

A 375 kHz carrier (6 bits) would fold to 25 kHz, outside the audio band, but the DMA would need 750,000 values
per second: the 4 KB ring then covers only 2.7 ms per half, while a console exchange blocks the main loop for
about 20 ms. That showed a real problem too: the recorder's status polling caused a DAC dropout about once a
second.

### 13:06 (queued)

> for the recording with the oscilloscope - you are oversampling anyways, cant you just use a digital downfilter?

The recorder now stores the scope's raw 8-bit samples at full rate and `mix_parts.py` decimates them with a
proper FIR low-pass. It removes the folding of the old 2-sample average, but the scope memory (50 Mpts) limits a
200 s take to 200 kSa/s, so the folding in the scope itself remains. Takes no longer poll the console.

### 13:20

> i think we can stay with the original lower pwm for now, lets earmark this for a board revision.

The 93.75 kHz carrier stays. The report lists the crosstalk as a board-revision item (slow the PULSE edges with
a series R and small C, review the routing), with the higher carrier as the firmware alternative. The March
timpani was recorded again with the committed firmware, without console polling.

### 13:23

> ok, lets commit

This commit.

---

**Next:** more digital voices on the DAC (snare, cymbals, bells), and the hardware experiments on this branch.
