cpldcpu/TouchSynth/docs/touchsynth_schematic.pdf

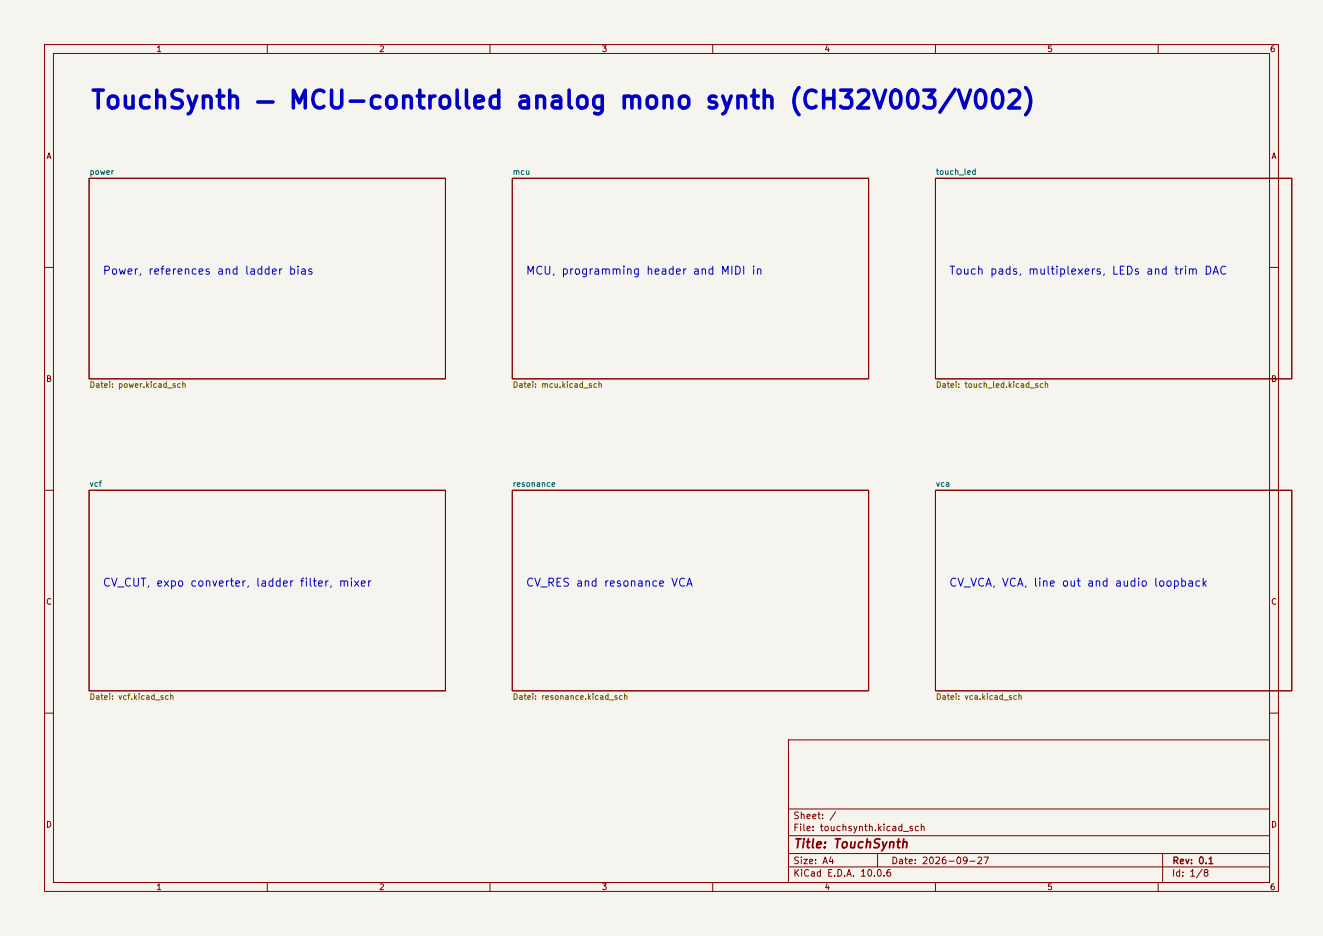
[picture p80: page 1]

TouchSynth — MCU-controlled analog mono synth (CH32V003/V002)

CV_VCA, VCA, line out and audio loopback

Size: A4 | Rev: 0.1
KiCad E.D.A. 10.0.6 | Id: 1/8

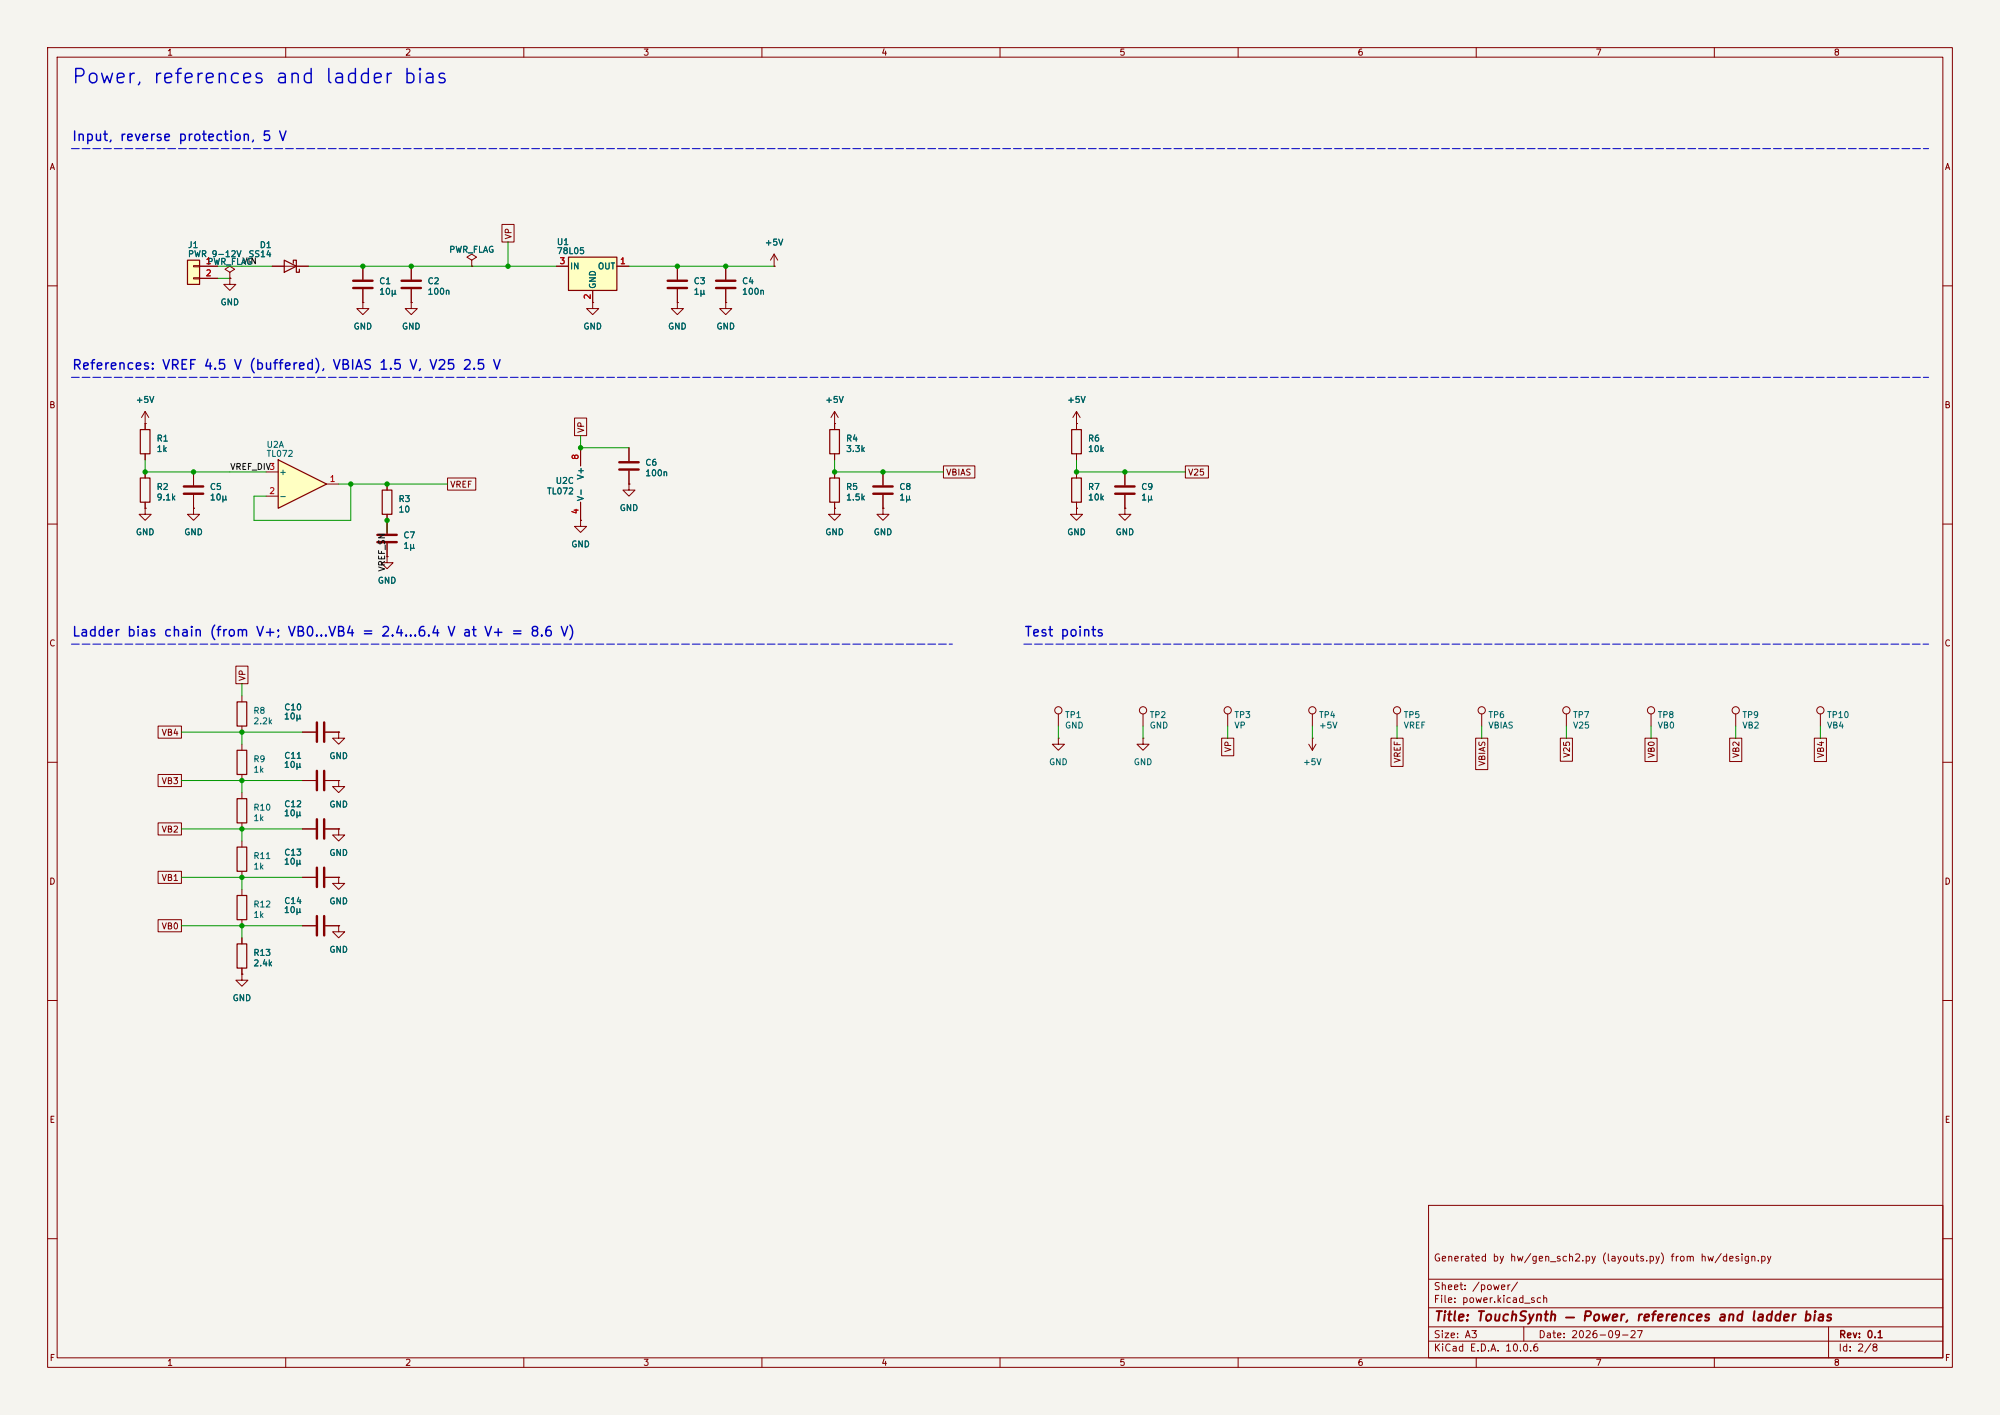
[picture p81: page 2]

Power, references and ladder bias

References: VREF 4.5 V (buffered), VBIAS 1.5 V, V25 2.5 V

Generated by hw/gen_sch2.py (layouts.py) from hw/design.py

Sheet: /power/
File: power.kicad_sch
Title: TouchSynth — Power, references and ladder bias

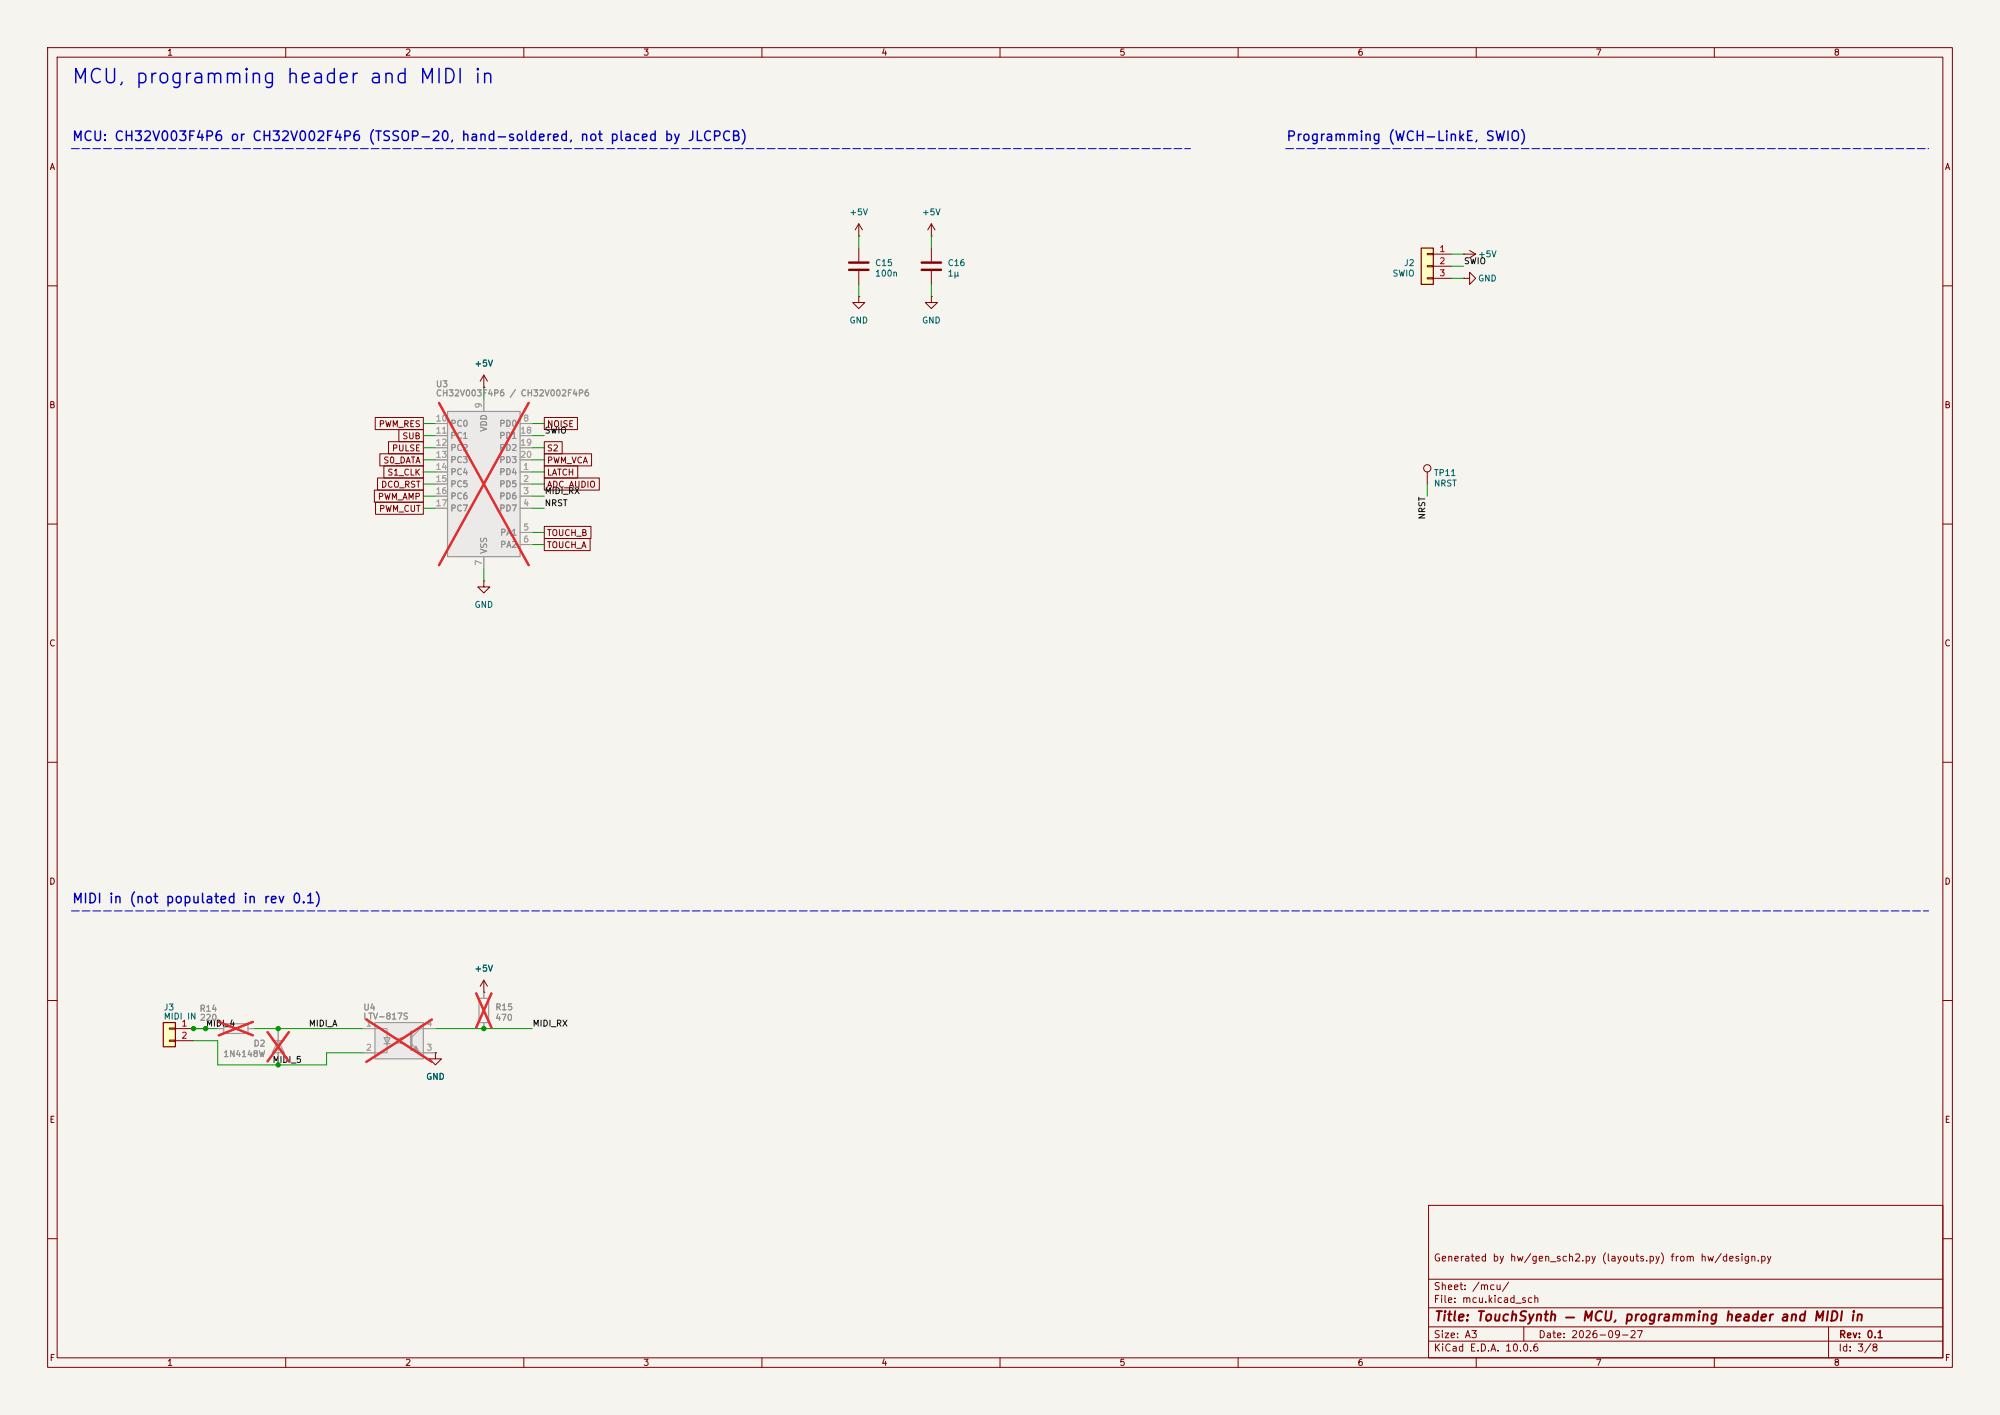
[picture p82: page 3]

MCU, programming header and MIDI in
SWIO MIDI_RX MIDI_5
NRST MIDI_A

MCU: CH32V003F4P6 or CH32V002F4P6 (TSSOP-20, hand-soldered, not placed by JLCPCB)

MIDI in (not populated in rev 0.1)

Generated by hw/gen_sch2.py (layouts.py) from hw/design.py

Sheet: /mcu/
File: mcu.kicad_sch
Title: TouchSynth — MCU, programming header and MIDI in

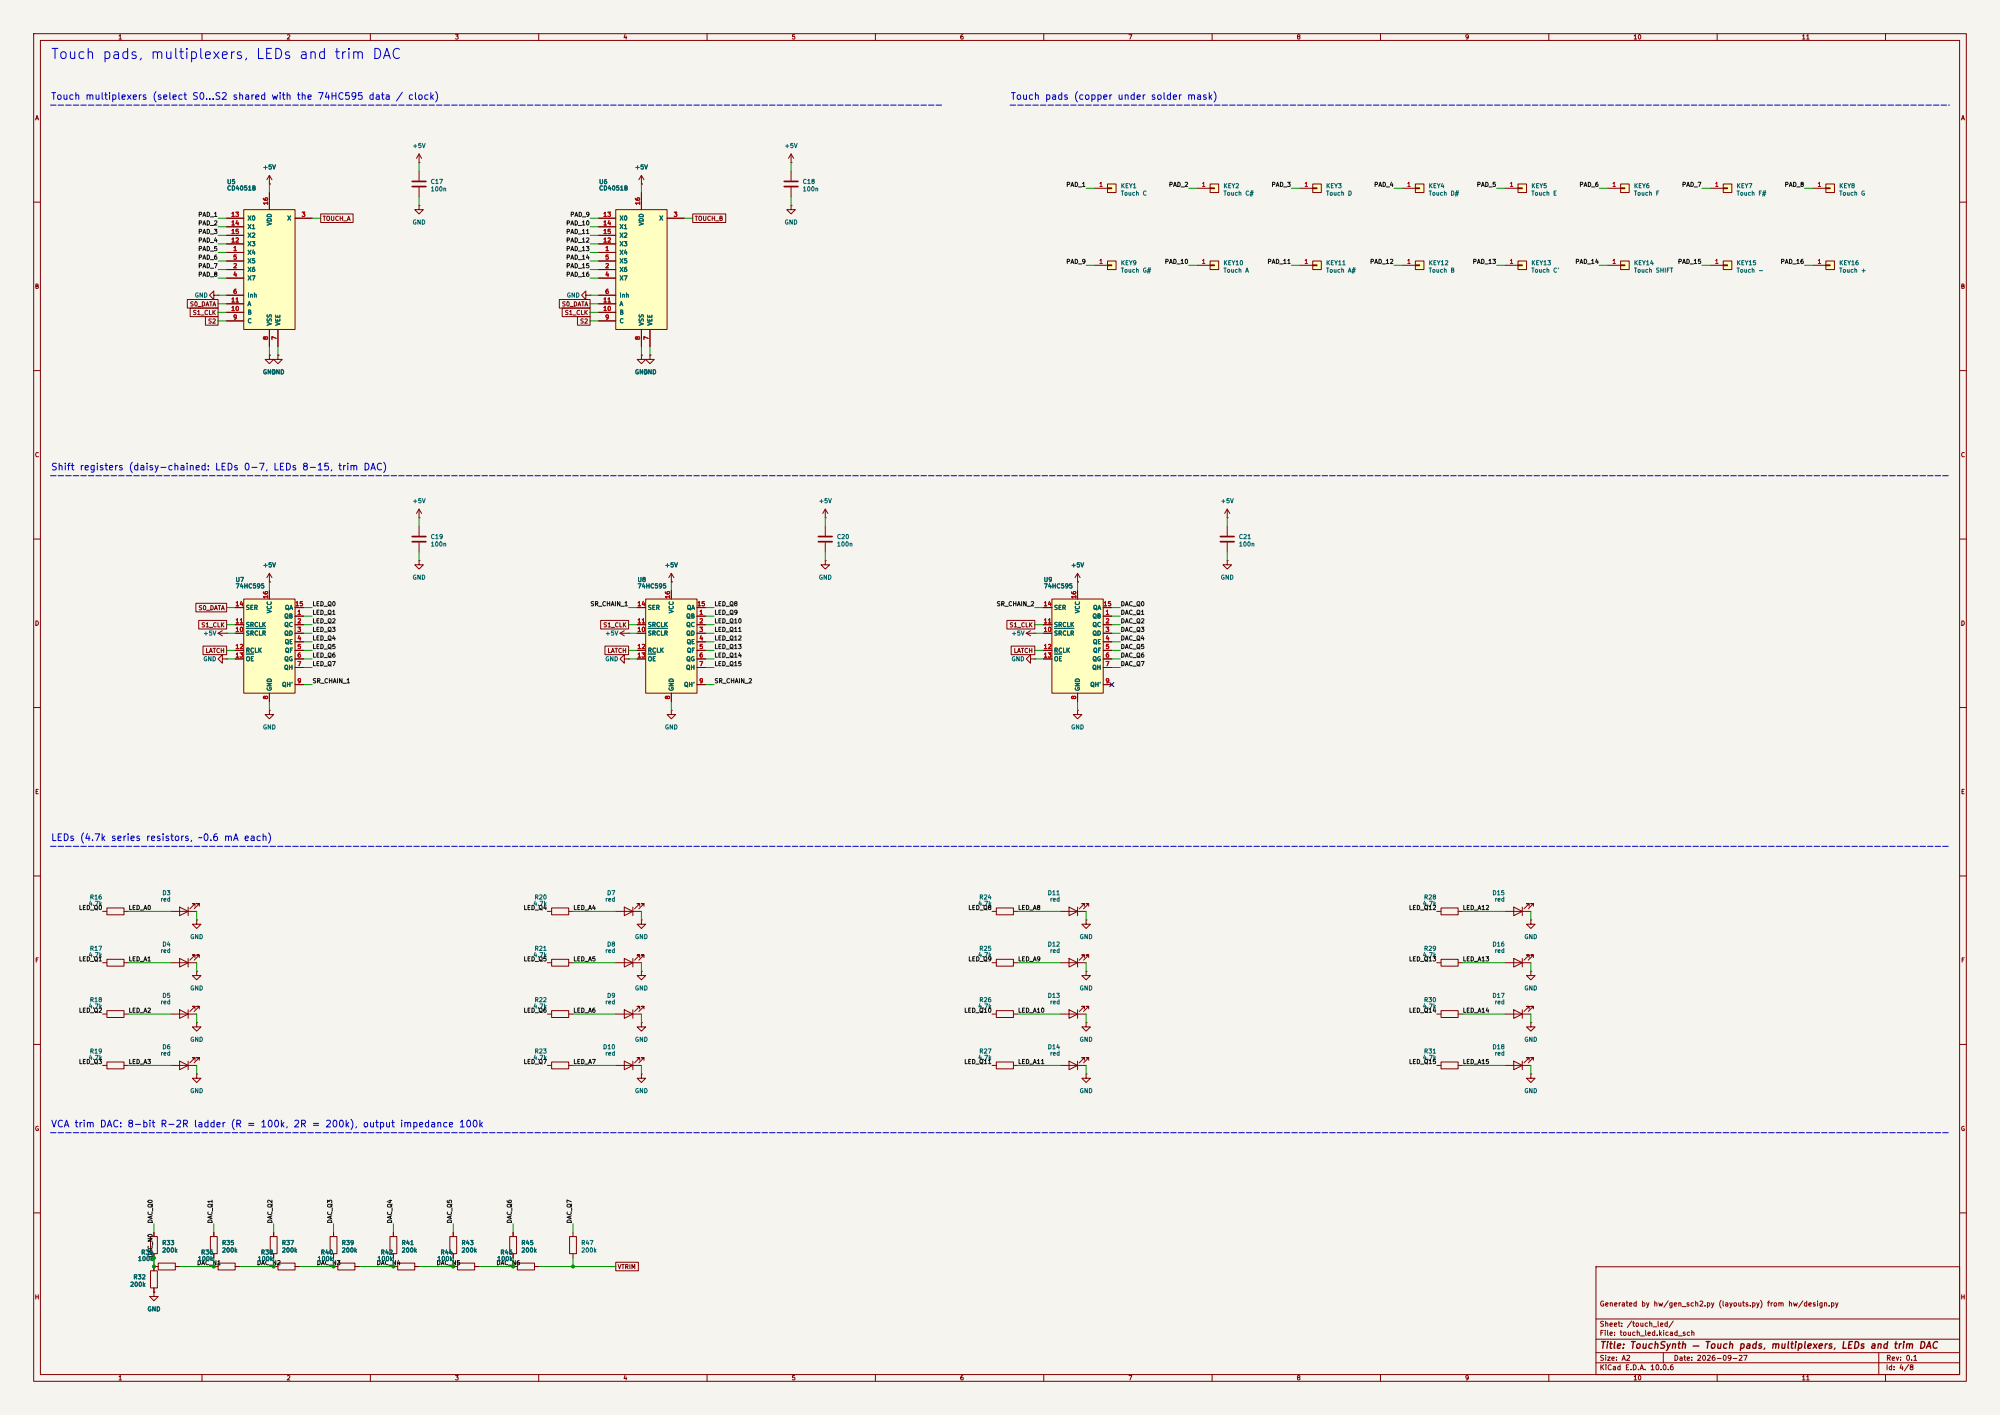
[picture p83: page 4]

Touch pads, multiplexers, LEDs and trim DAC

Touch multiplexers (select S0...S2 shared with the 74HC595 data / clock)

Shift registers (daisy-chained: LEDs 0-7, LEDs 8-15, trim DAC)

SRCLR 10 SRCLK 11 RCLK 12 OE 13

LEDs (4.7k series resistors, ~0.6 mA each)

VCA trim DAC: 8-bit R-2R ladder (R = 100k, 2R = 200k), output impedance 100k

Generated by hw/gen_sch2.py (layouts.py) from hw/design.py

Sheet: /touch_led/
File: touch_led.kicad_sch
Title: TouchSynth — Touch pads, multiplexers, LEDs and trim DAC

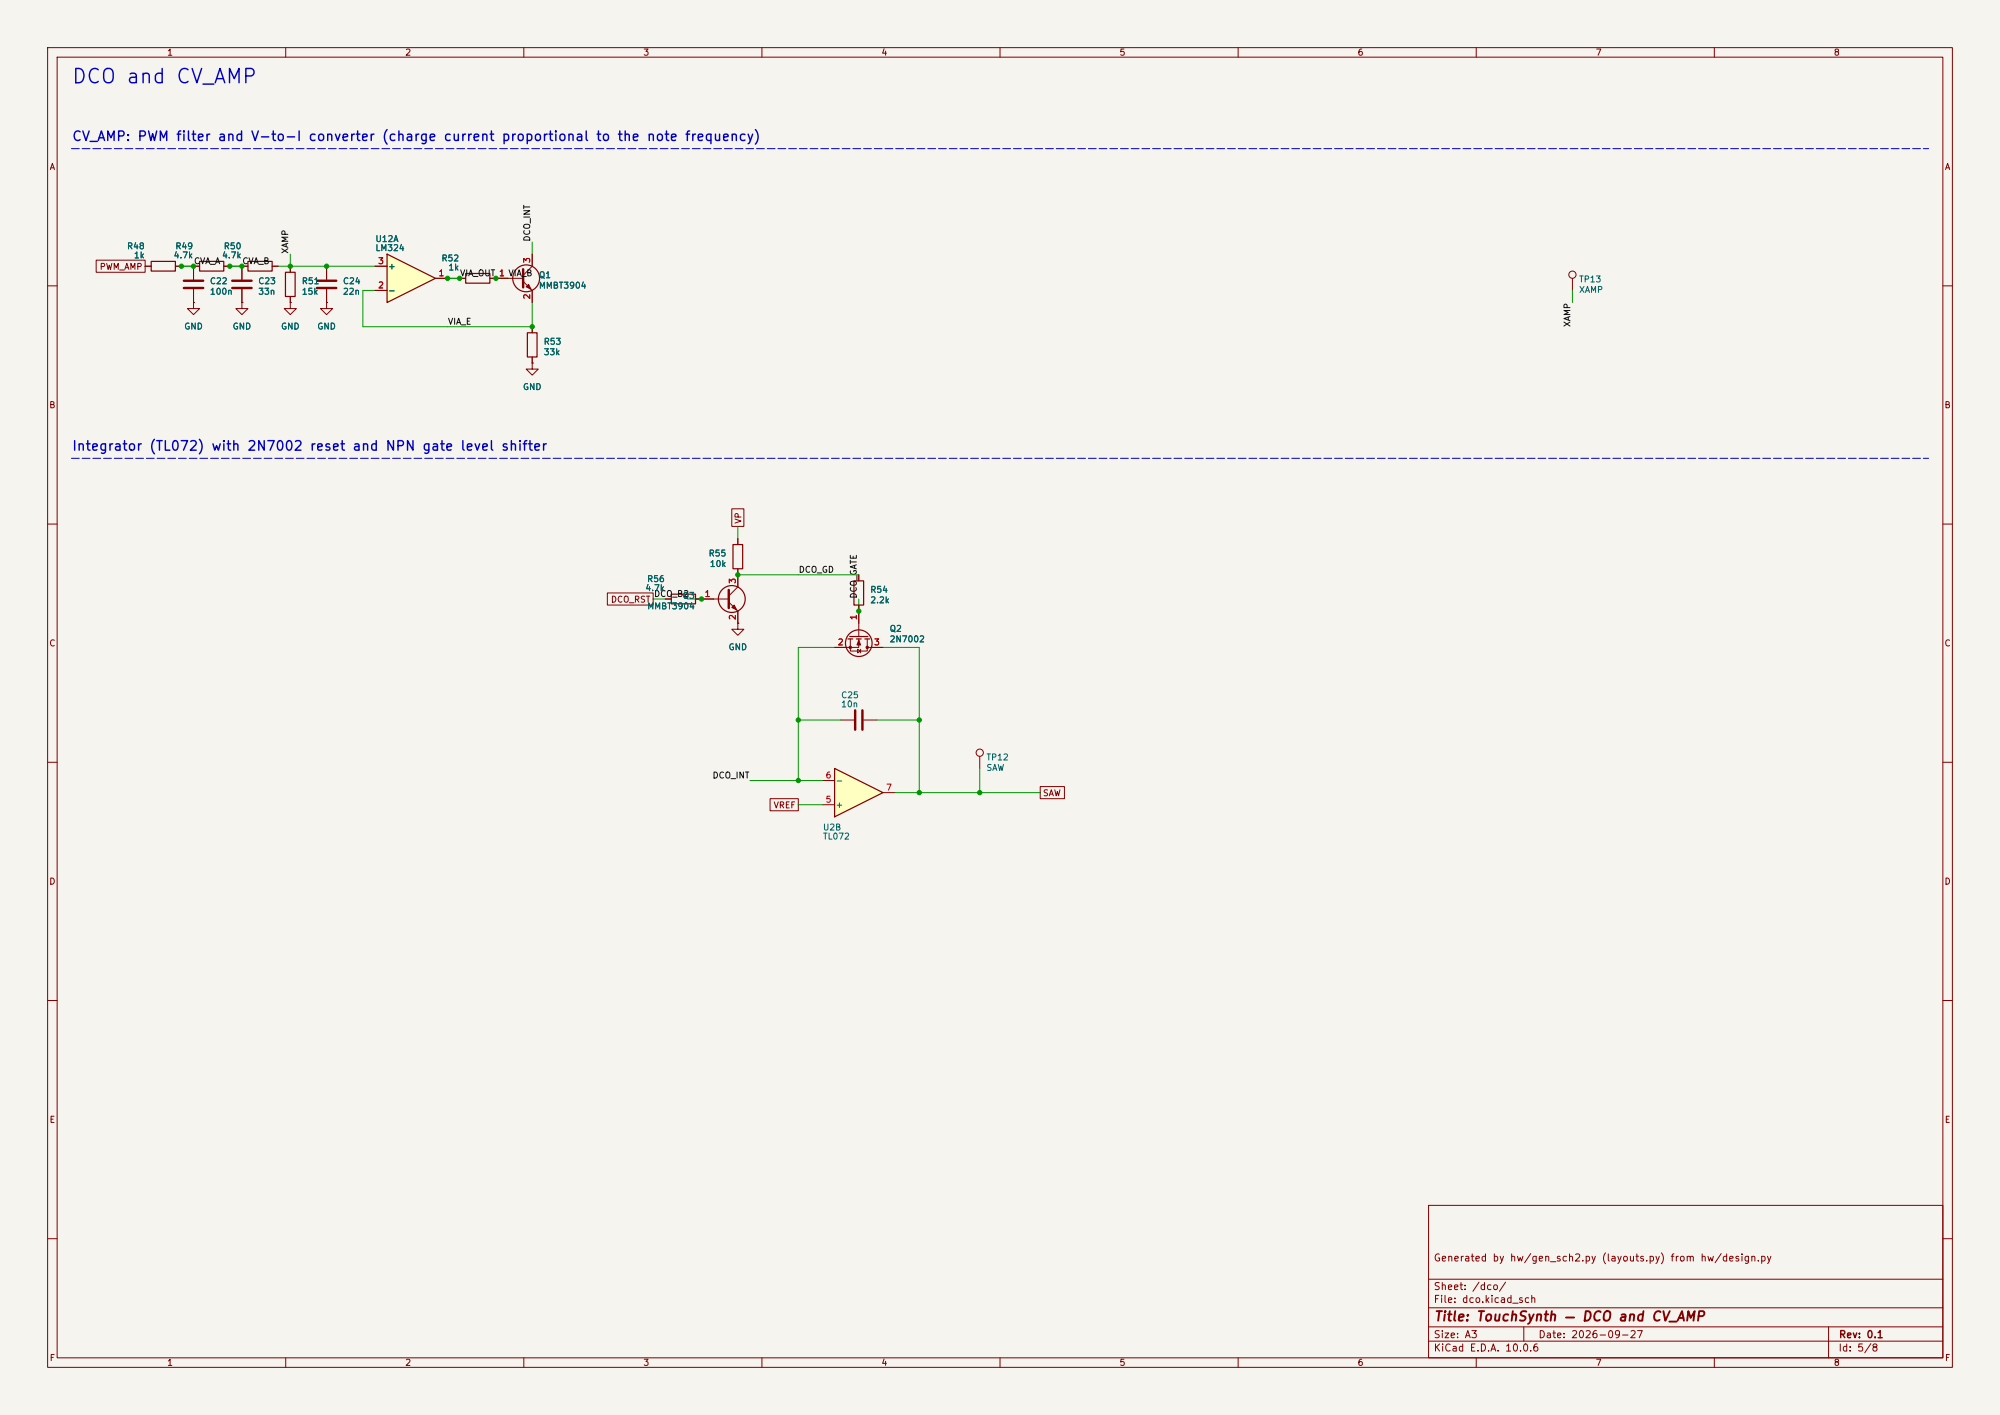
[picture p84: page 5]

Integrator (TL072) with 2N7002 reset and NPN gate level shifter

Generated by hw/gen_sch2.py (layouts.py) from hw/design.py

Sheet: /dco/
File: dco.kicad_sch
Title: TouchSynth — DCO and CV_AMP

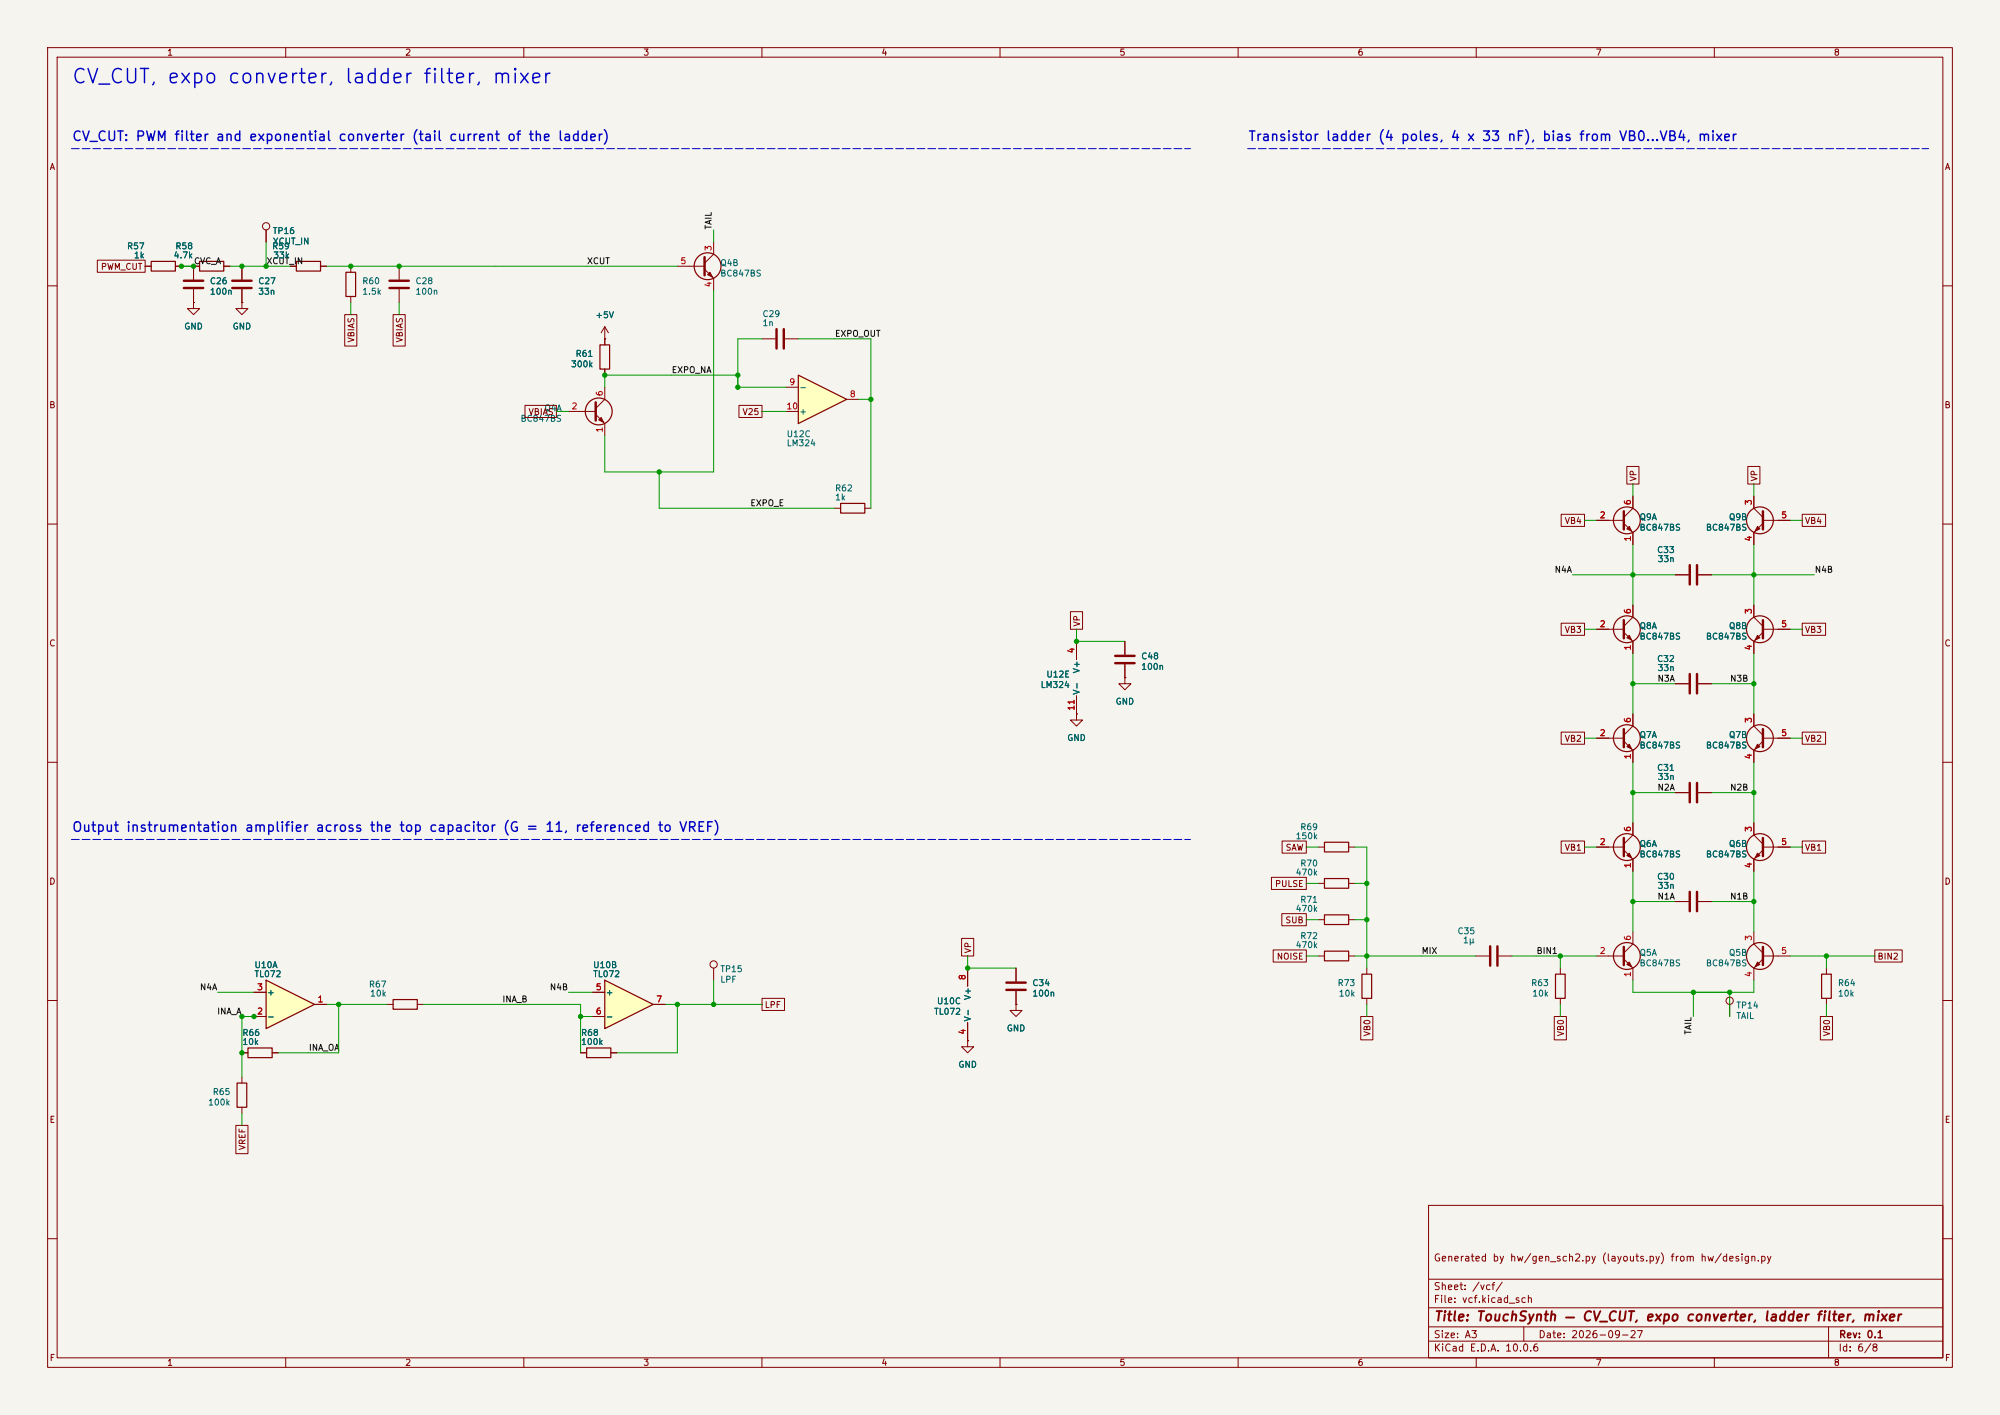
[picture p85: page 6]

CV_CUT: PWM filter and exponential converter (tail current of the ladder)

Transistor ladder (4 poles, 4 x 33 nF), bias from VB0...VB4, mixer R61

Output instrumentation amplifier across the top capacitor (G = 11, referenced to VREF)

Generated by hw/gen_sch2.py (layouts.py) from hw/design.py R63

Sheet: /vcf/
File: vcf.kicad_sch
Title: TouchSynth — CV_CUT, expo converter, ladder filter, mixer

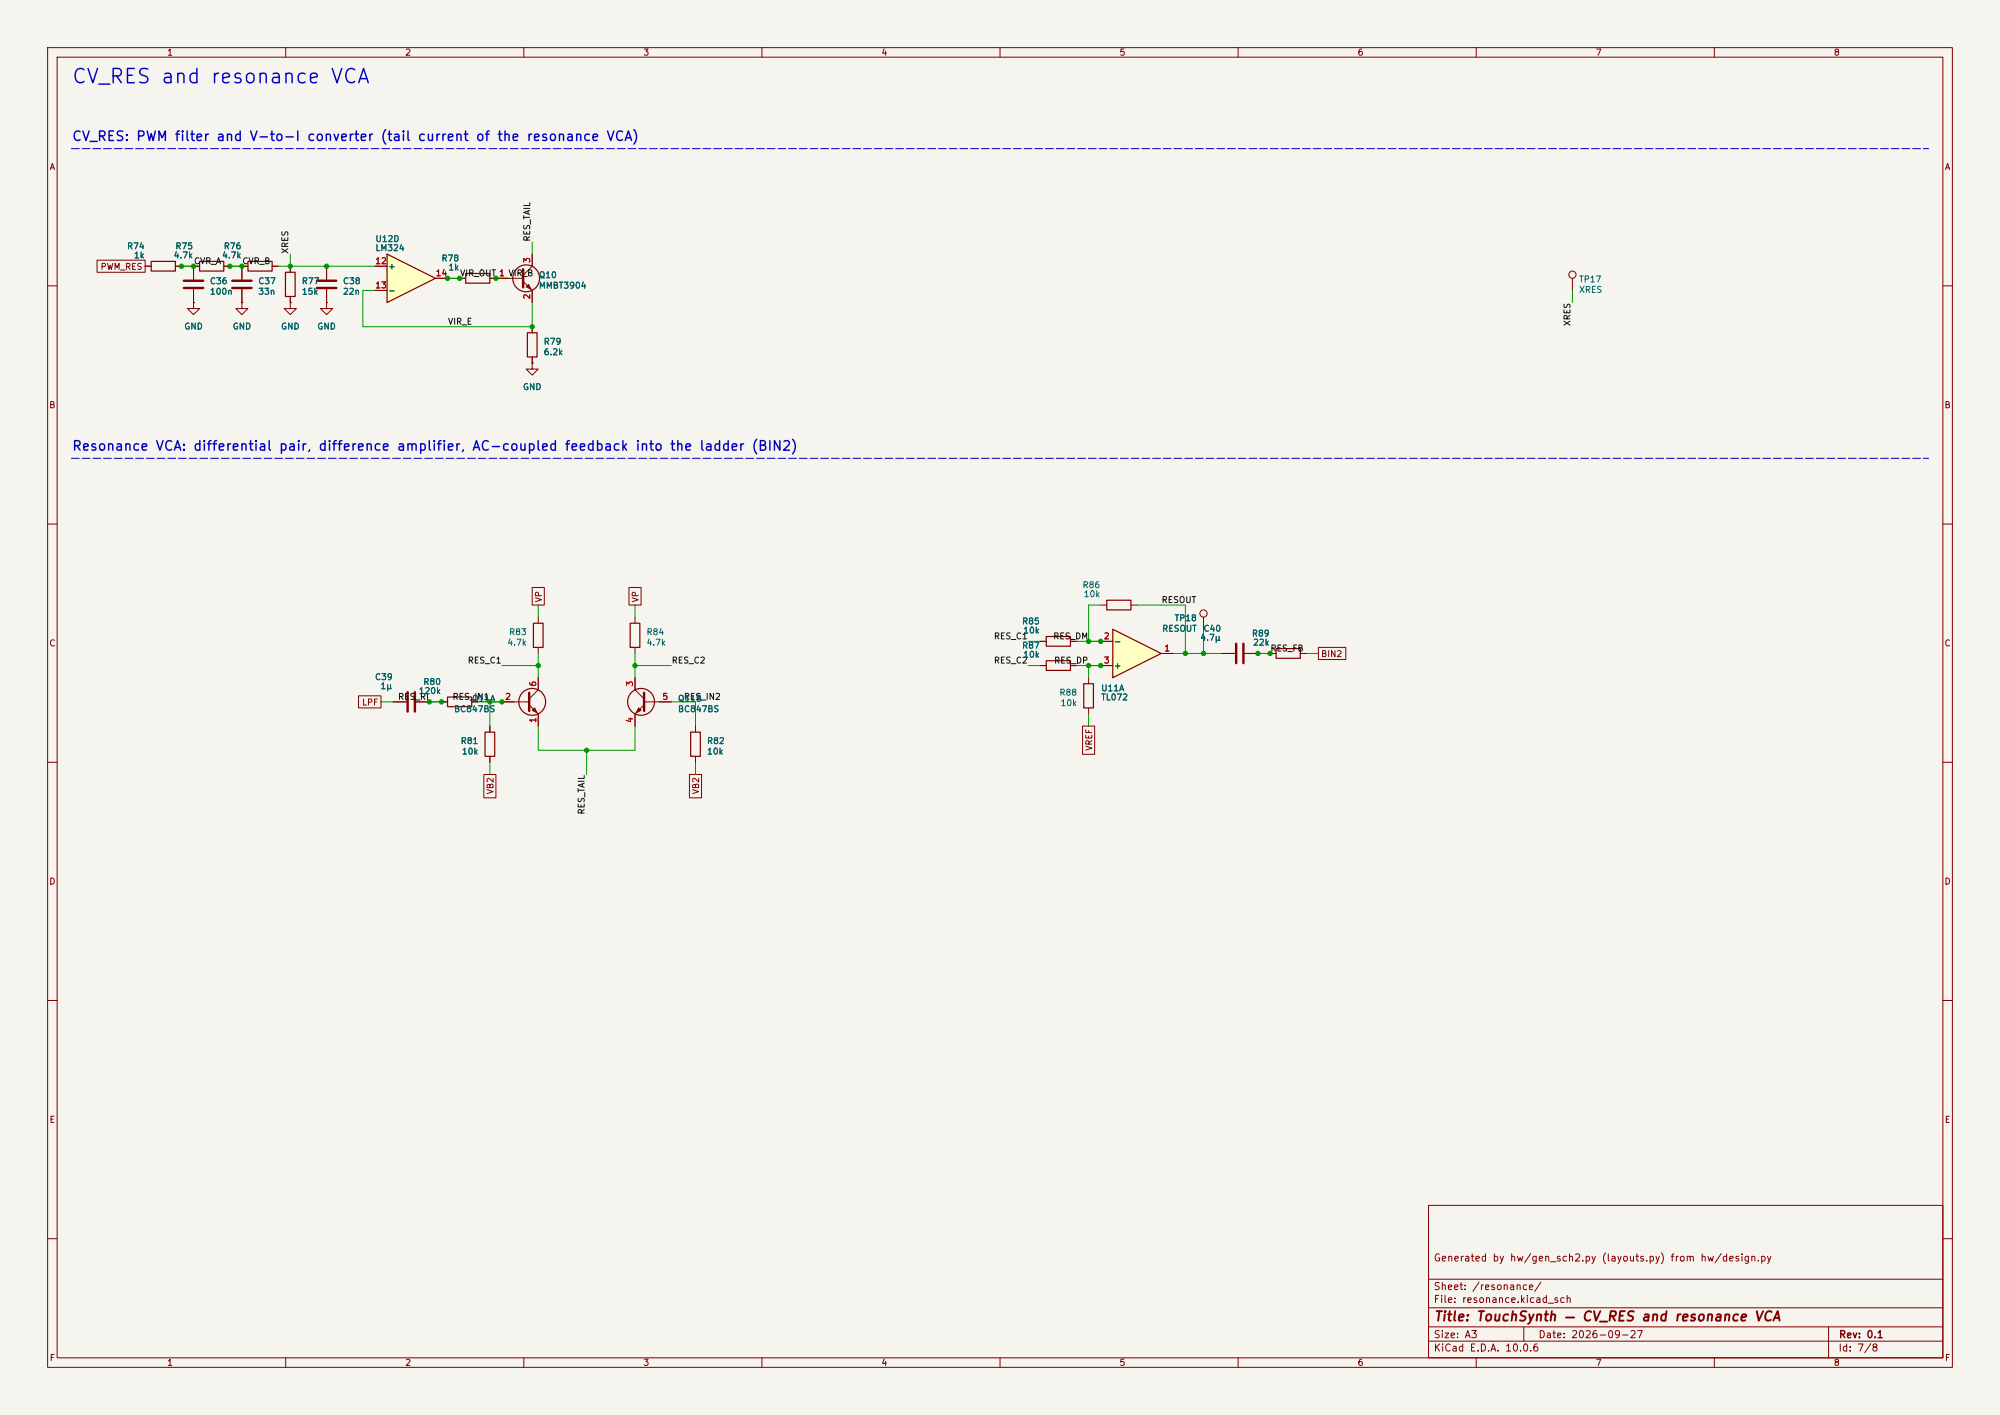
[picture p86: page 7]

CV_RES: PWM filter and V-to-I converter (tail current of the resonance VCA)

Resonance VCA: differential pair, difference amplifier, AC-coupled feedback into the ladder (BIN2)

Generated by hw/gen_sch2.py (layouts.py) from hw/design.py

Sheet: /resonance/
File: resonance.kicad_sch
Title: TouchSynth — CV_RES and resonance VCA

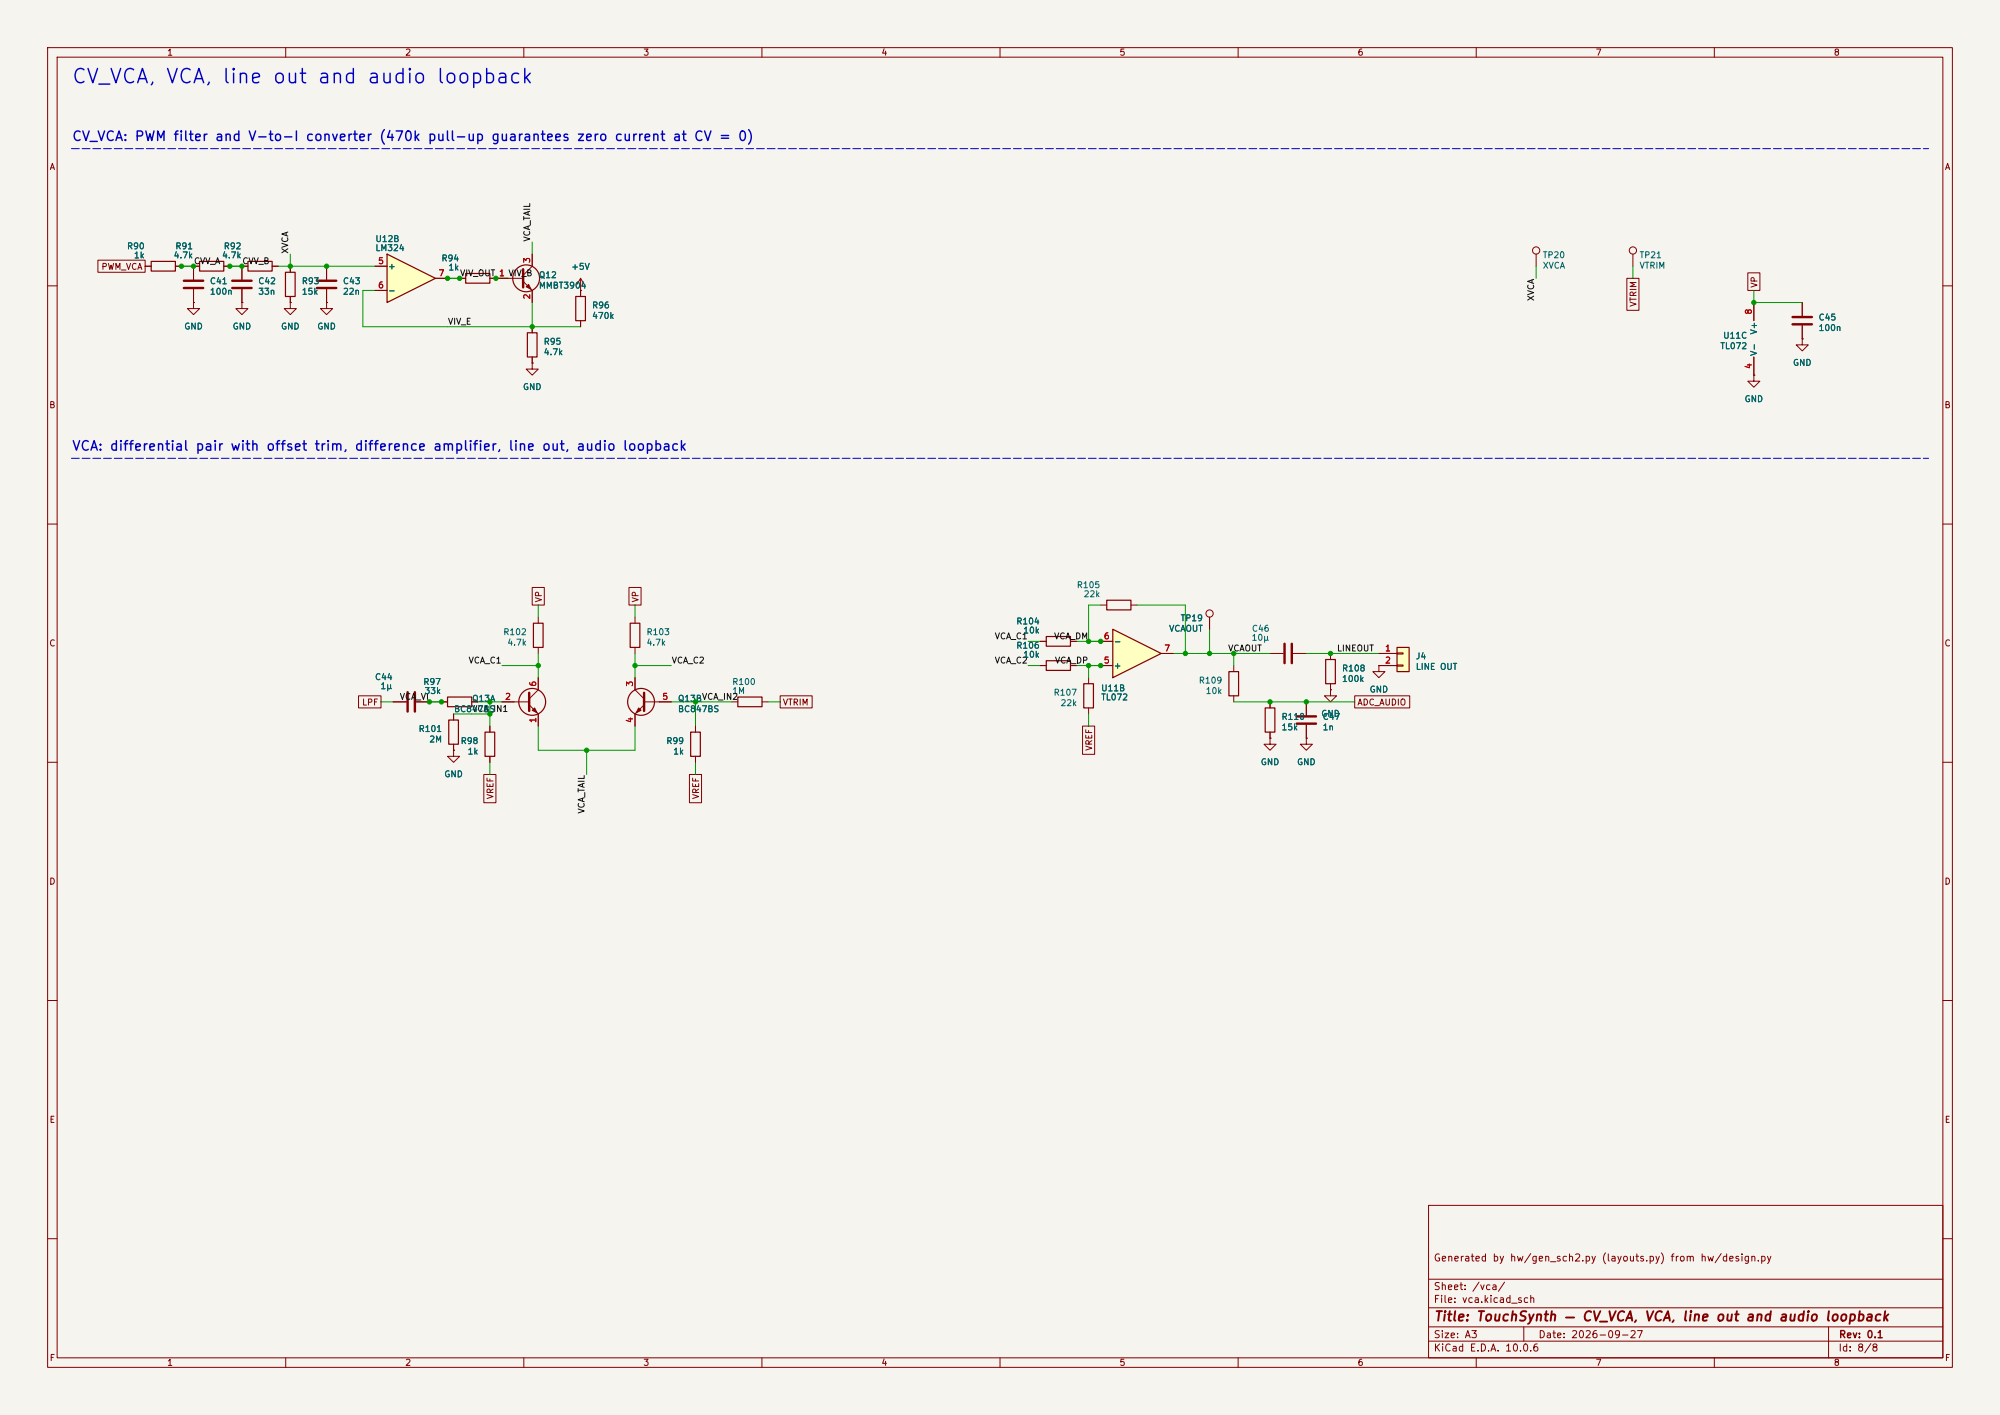
[picture p87: page 8]

CV_VCA, VCA, line out and audio loopback
VCA_IN1 XVCA

VCA: differential pair with offset trim, difference amplifier, line out, audio loopback

Generated by hw/gen_sch2.py (layouts.py) from hw/design.py

Sheet: /vca/
File: vca.kicad_sch
Title: TouchSynth — CV_VCA, VCA, line out and audio loopback
