cpldcpu/TouchSynth/docs/figures/hw_board1_dco.pdf

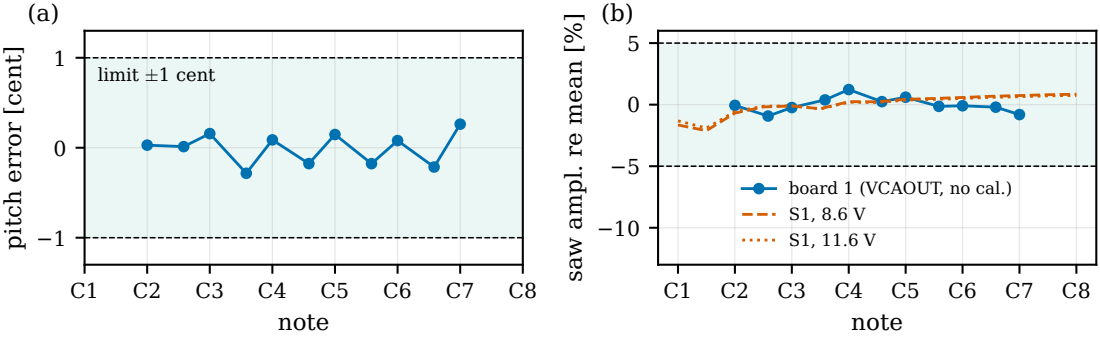
[picture p88: page 1]

saw ampl. re mean [%]

board 1 (VCAOUT, no cal.) S1, 8.6 V
