cpldcpu/TouchSynth/docs/figures/hw_board1_hum.pdf

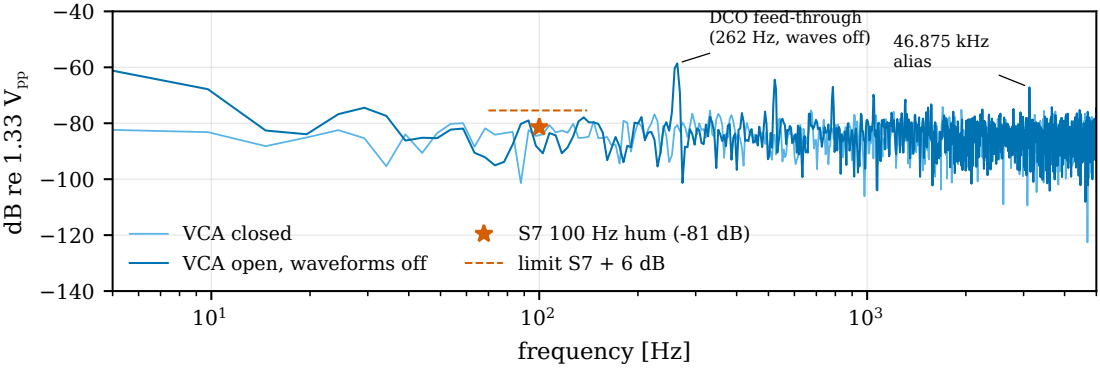
[picture p89: page 1]
frequency [Hz]; B re 1.33 Vpp; alias

DCO feed-through
(262 Hz, waves off) 46.875 kHz

VCA closed
VCA open, waveforms off

S7 100 Hz hum (-81 dB)
limit S7 + 6 dB
