cpldcpu/TouchSynth/docs/figures/hw_board1_vca.pdf

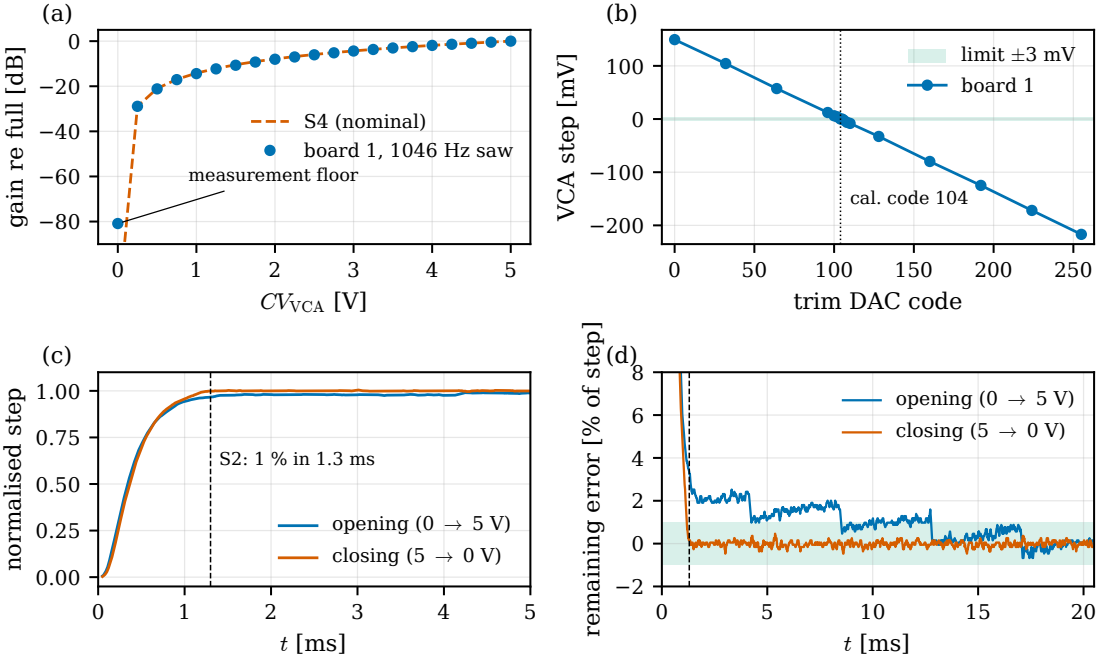
[picture p90: page 1]
normalised step

gain re full [dB]

l i m | i t § 3 m V
board 1

VCA step [mV]

S4 (nominal)

measurement floor | board 1, 1046 Hz saw

cal. code 104

trim DAC code

remaining error [% of step] (d)

o p e n i n g | ( 0 5 V ) !
c l o s i n g ( | 5 0 V ) !

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
