cpldcpu/TouchSynth/docs/figures/hw_board1_vcf.pdf

1

0

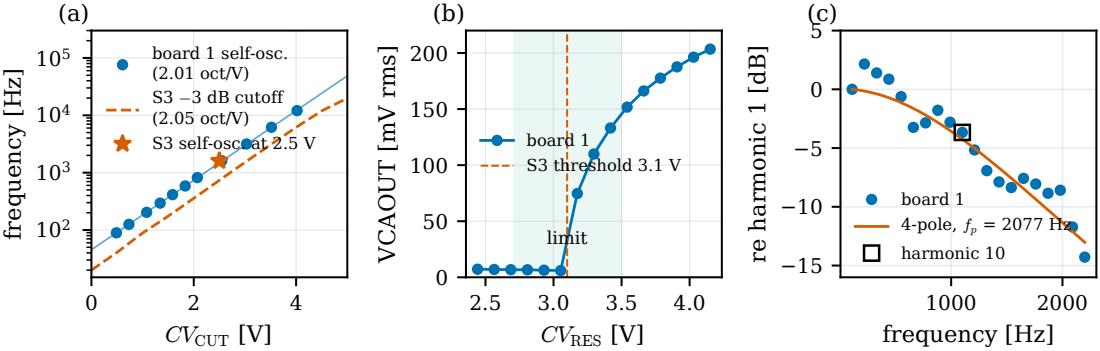
[picture p91: page 1]
frequency [Hz]; (2.05 oct/V); 4.0 CVRES [V]; limit; S3 threshold 3.1 V; board 1 4-pole,; harmonic 10

board 1 self-osc.
(2.01 oct/V) S3 ¡3 dB cu | t o ff

VCAOUT [mV rms]

re harmonic 1 [dB]

board 1

S3 self-osc. at 2.5 V
