cpldcpu/TouchSynth/docs/figures/instr_drums.pdf

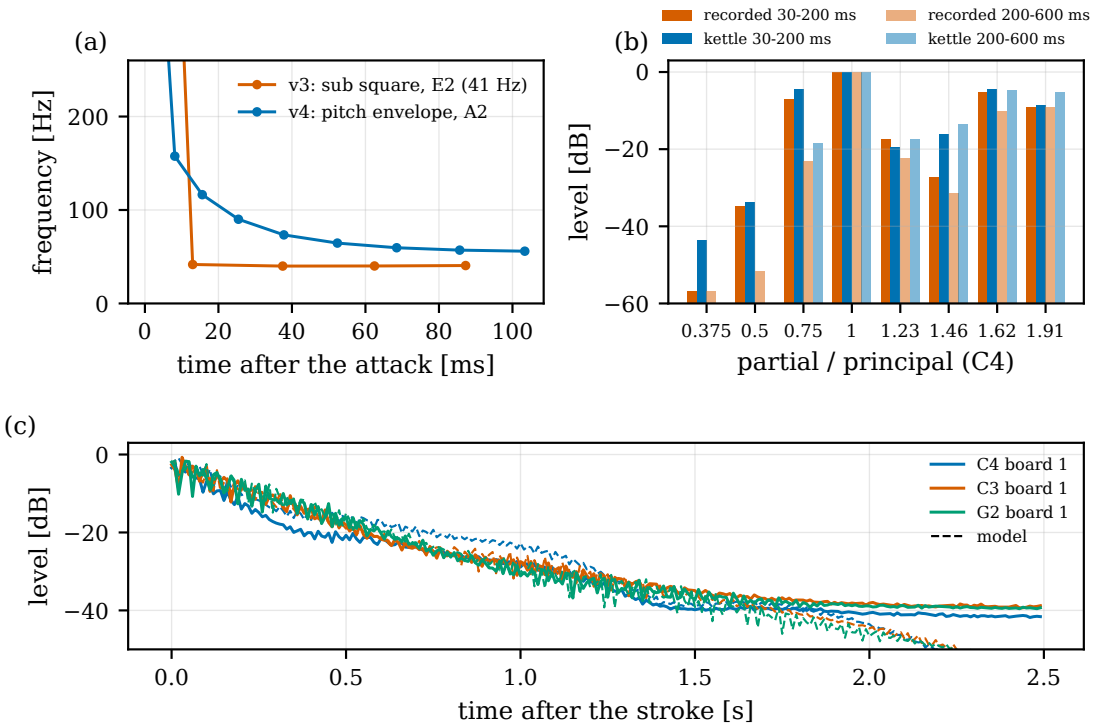
[picture p92: page 1]
frequency [Hz]; 0.375 0.5 0.75 1 1.23 1.46 1.62 1.91 partial / principal (C4); level [dB]; recorded 30-200 ms kettle 30-200 ms; recorded 200-600 ms kettle 200-600 ms; C4 board 1 C3 board 1 G2 board 1 model

v3: sub square, E2 (41 Hz)
v4: pitch envelope, A2

time after the attack [ms]

time after the stroke [s]
