cpldcpu/TouchSynth/docs/figures/s1_dco_amplitude.pdf

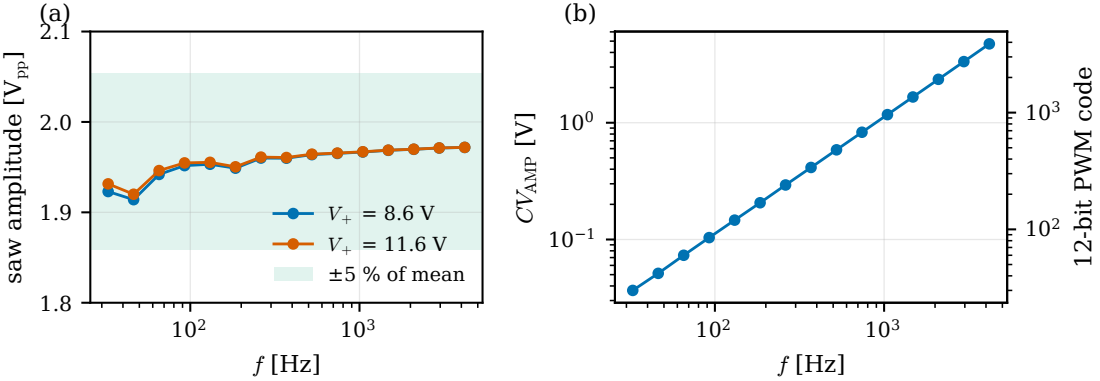
[picture p93: page 1]
V ±5 % of mean; CVAMP [V]

saw amplitude [Vpp]

12-bit PWM code
