cpldcpu/TouchSynth/docs/figures/s3_vcf_response.pdf

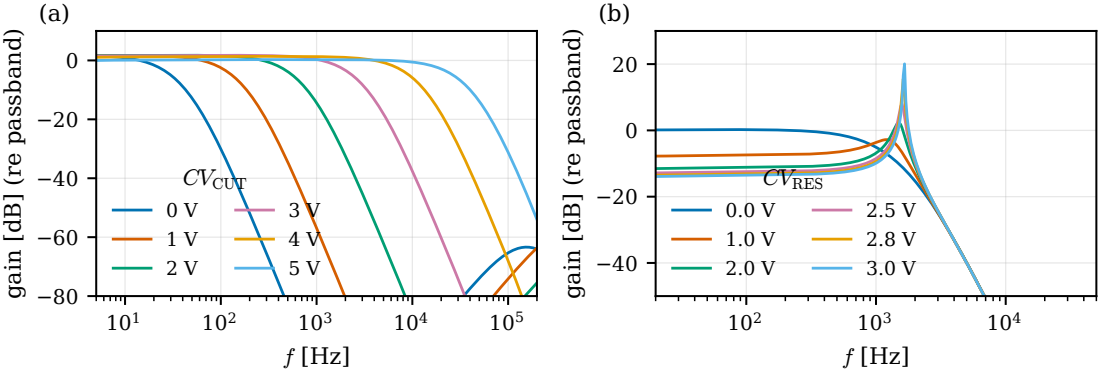
[picture p94: page 1]
gain [dB] (re passband)

gain [dB] (re passband)

C VR E S
0.0 V 1.0 V | 2.5 V 2.8 V
