cpldcpu/TouchSynth/docs/figures/s5_touch.pdf

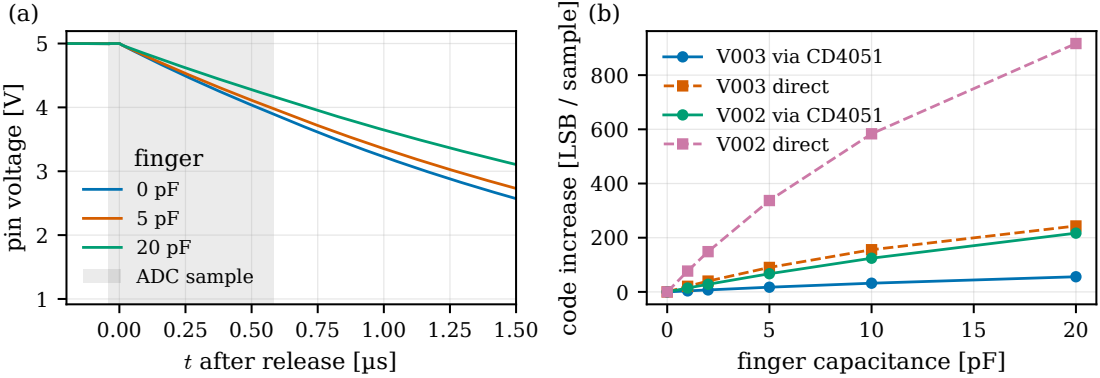
[picture p95: page 1]
pin voltage [V]; finger capacitance [pF]

code increase [LSB / sample]

V003 via CD4051
V003 direct V002 via CD4051

finger
0 pF 5 pF

V002 direct

20 pF ADC sample

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
