cpldcpu/TouchSynth/docs/figures/behav_validation.pdf

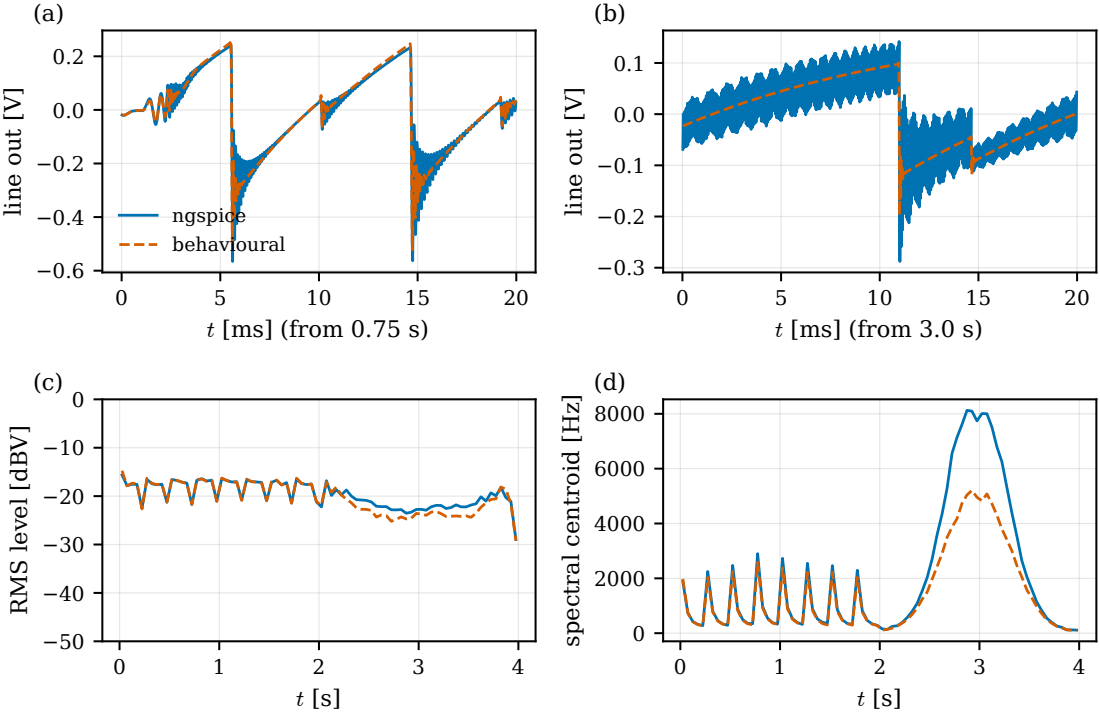
[picture p96: page 1]
line out [V]; 20 t [ms] (from 3.0 s)

ngspice
behavioural

spectral centroid [Hz]

RMS level [dBV]
