cpldcpu/TouchSynth/docs/figures/s3_vcf_transient.pdf

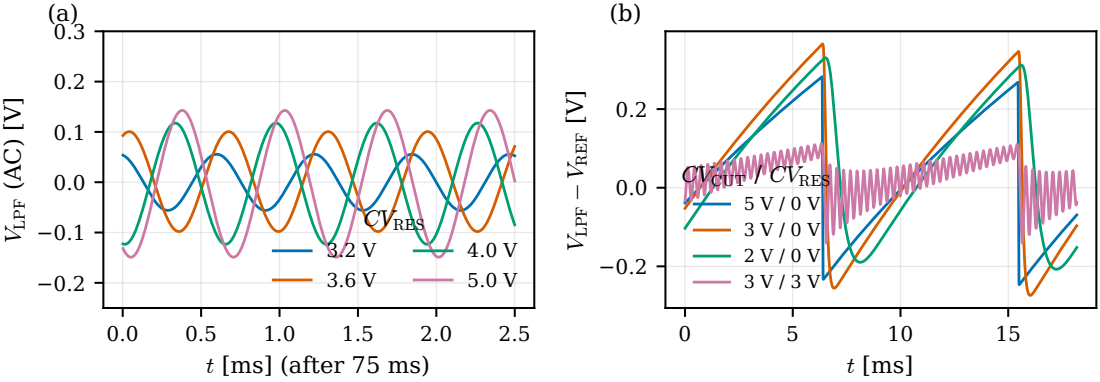
[picture p97: page 1]
2.5 t [ms] (after 75 ms); VLPF (AC) [V]; VLPF ¡ VREF [V]
