cpldcpu/TouchSynth/docs/figures/s4_vca.pdf

−200

(a)

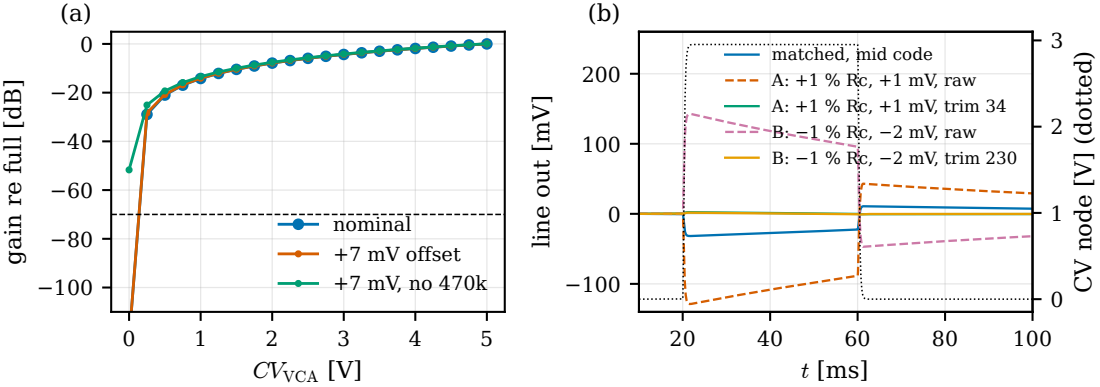
[picture p98: page 1]

matched, mid code
A: +1 % Rc, +1 mV, raw A: +1 % Rc, +1 mV, trim 34 B: −1 % Rc, −2 mV, raw

CV node [V] (dotted)

gain re full [dB]

line out [mV]

B: −1 % Rc, −2 mV, trim 230

nominal
+7 mV offset +7 mV, no 470k
