cpldcpu/TouchSynth/docs/figures/s6_voice.pdf

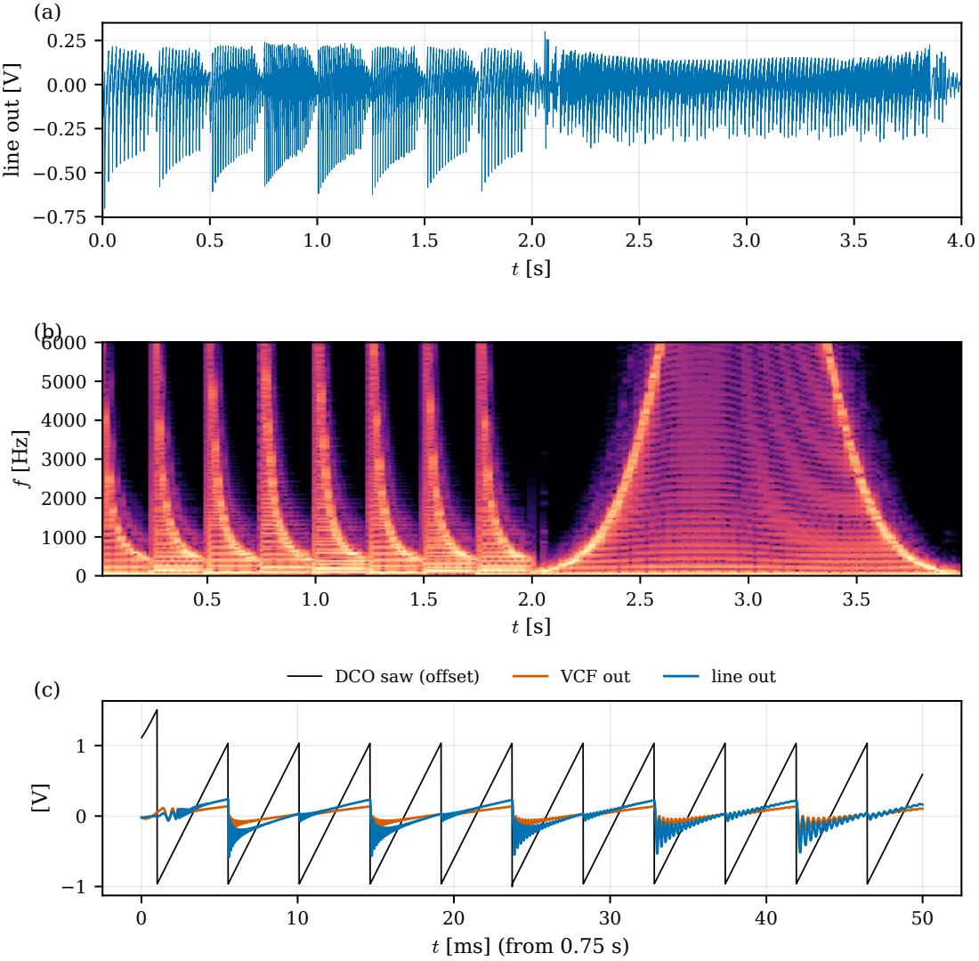
[picture p99: page 1]
line out [V]; t [ms] (from 0.75 s); DCO saw (offset); VCF out; line out
