cpldcpu/TouchSynth/hw/touchsynth/touchsynth.kicad_pcb

## KiCad design hw/touchsynth/touchsynth.kicad_pcb (2026-09-27)

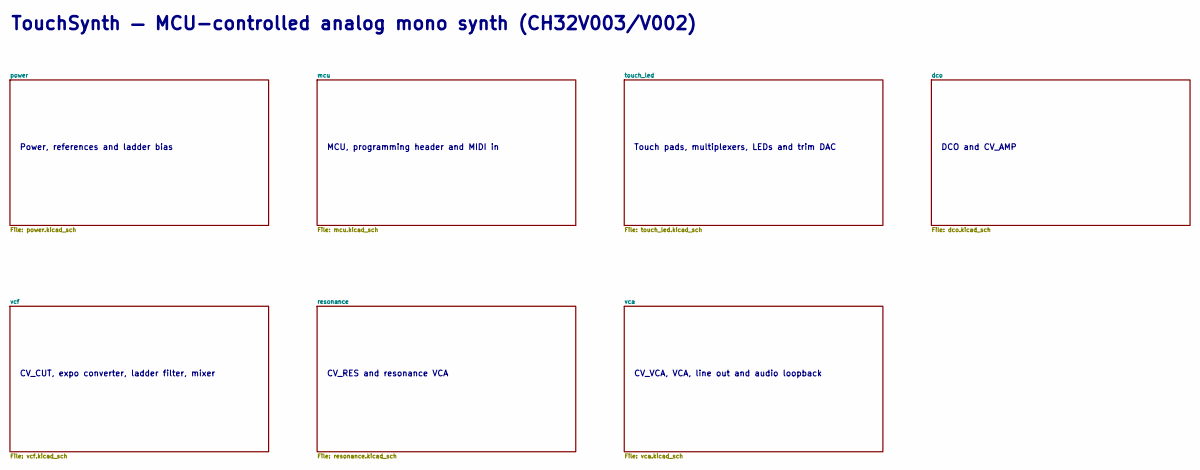
[picture p100: schematic touchsynth.kicad_sch]

Notes on the sheet:
Power, references and ladder bias
MCU, programming header and MIDI in
Touch pads, multiplexers, LEDs and trim DAC
DCO and CV_AMP
CV_CUT, expo converter, ladder filter, mixer
CV_RES and resonance VCA
CV_VCA, VCA, line out and audio loopback
TouchSynth — MCU-controlled analog mono synth (CH32V003/V002)

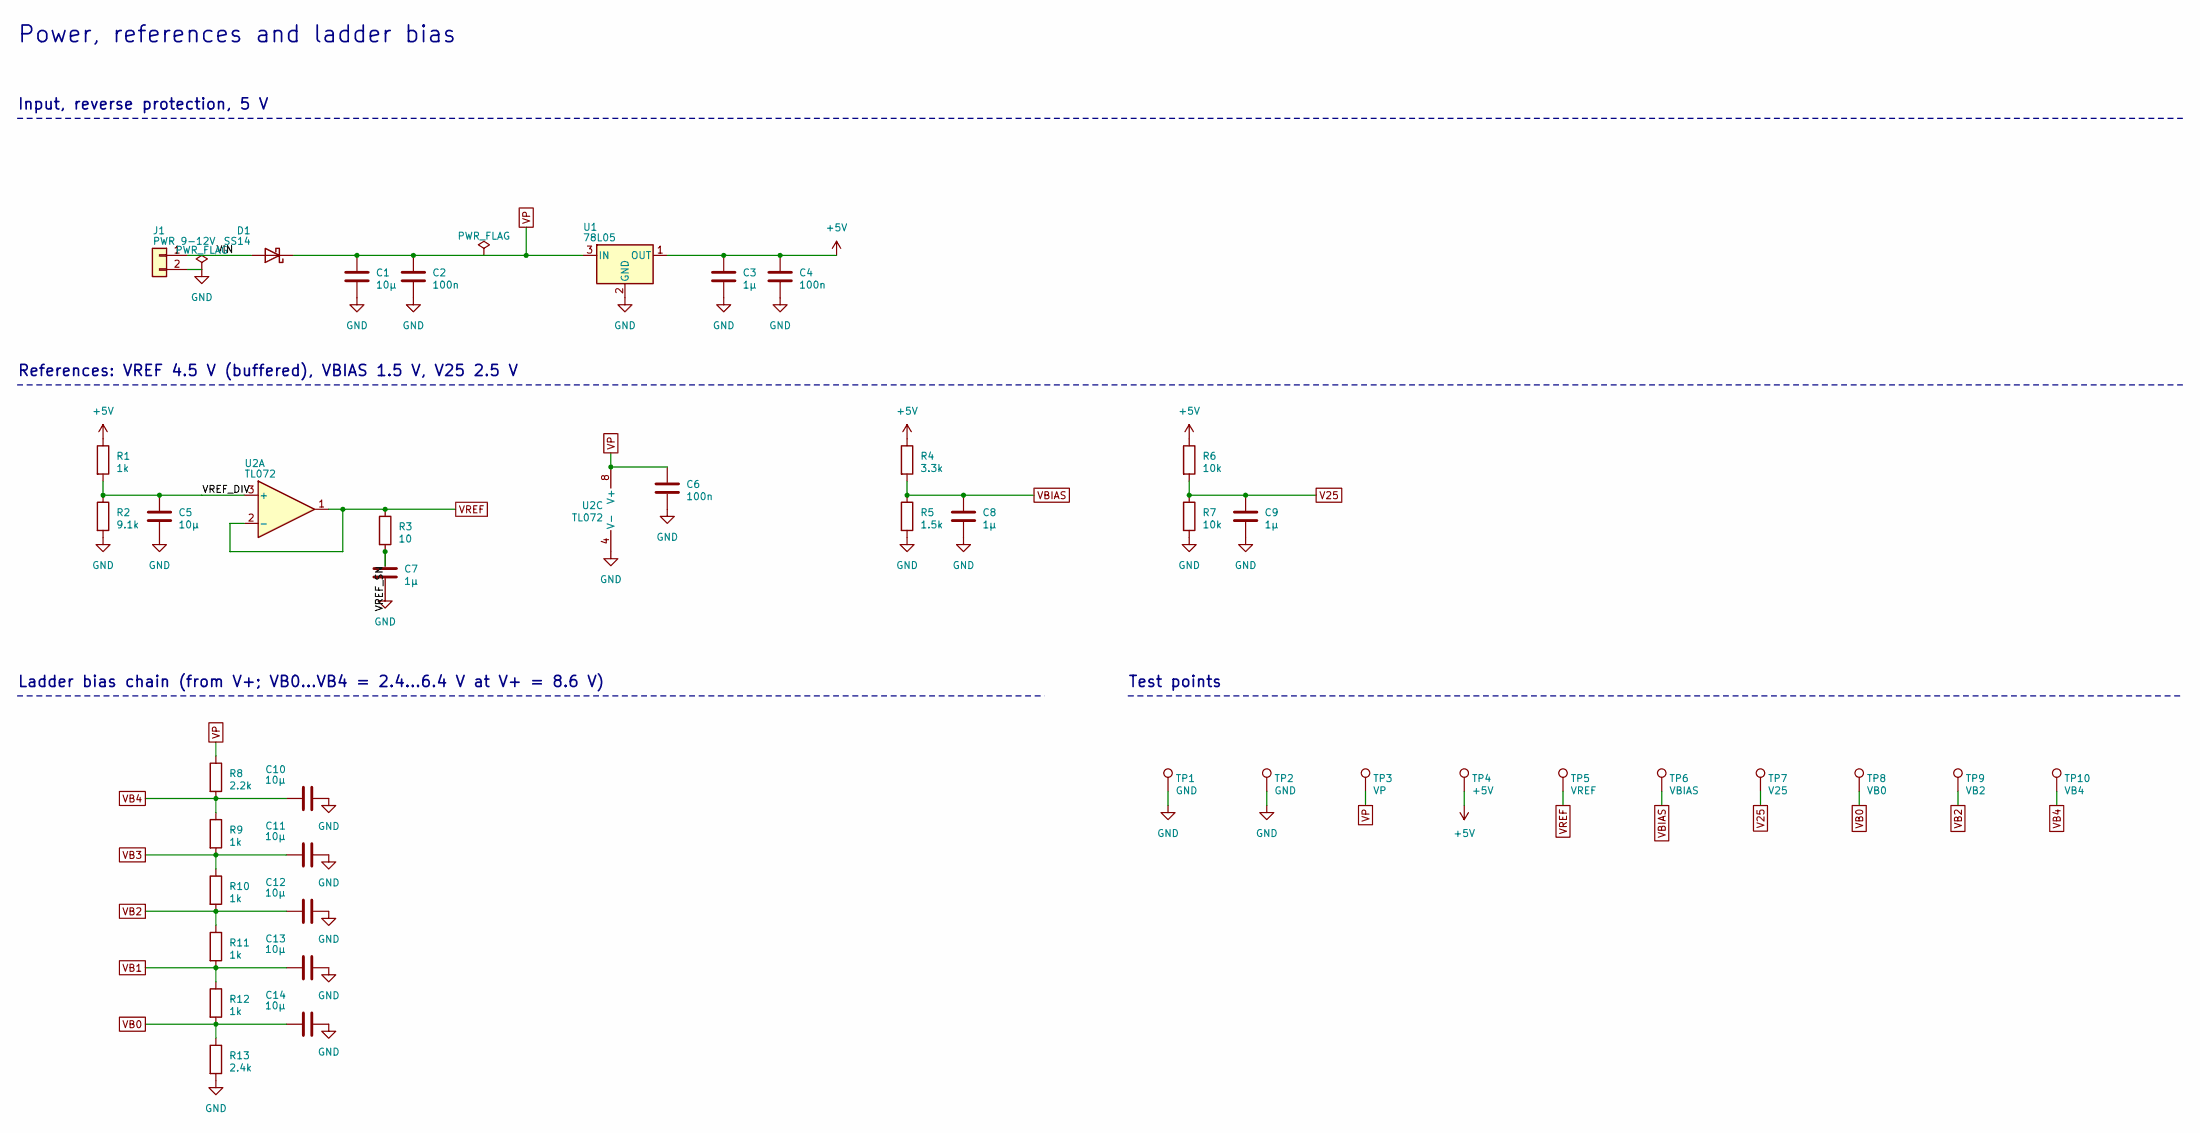
[picture p101: schematic power.kicad_sch, TouchSynth — Power, references and ladder bias]

Parts:
C1, C10, C11, C12, C13: 10µ; C_0603_1608Metric; LCSC C96446
C2, C4, C6: 100n; C_0603_1608Metric; LCSC C14663
C3, C7, C8, C9: 1µ; C_0603_1608Metric; LCSC C15849
C5, C14: 10µ; C_0603_1608Metric; LCSC C19702
D1: SS14; D_SMA; LCSC C2480
J1: PWR 9-12V; PinHeader_1x02_P2.54mm_Vertical
R1, R9, R10, R11, R12: 1k; R_0603_1608Metric; LCSC C21190
R2: 9.1k; R_0603_1608Metric; LCSC C23260
R3: 10; R_0603_1608Metric; LCSC C22859
R4: 3.3k; R_0603_1608Metric; LCSC C22978
R5: 1.5k; R_0603_1608Metric; LCSC C22843
R6, R7: 10k; R_0603_1608Metric; LCSC C25804
R8: 2.2k; R_0603_1608Metric; LCSC C4190
R13: 2.4k; R_0603_1608Metric; LCSC C22940
TP1, TP2: GND; PinHeader_1x01_P2.54mm_Vertical
TP3: VP; TestPoint_Pad_D1.0mm
TP4: +5V; TestPoint_Pad_D1.0mm
TP5: VREF; TestPoint_Pad_D1.0mm
TP6: VBIAS; TestPoint_Pad_D1.0mm
TP7: V25; TestPoint_Pad_D1.0mm
TP8: VB0; TestPoint_Pad_D1.0mm
TP9: VB2; TestPoint_Pad_D1.0mm
TP10: VB4; TestPoint_Pad_D1.0mm
U1: 78L05; SOT-89-3; LCSC C71136
U2: TL072; SOIC-8_3.9x4.9mm_P1.27mm; LCSC C6961

Connections:
+5V: C3.1, C4.1, R1.1, R4.1, R6.1, TP4.1, U1.1 (OUT); also elsewhere on the board
/power/VIN: D1.2 (A), J1.1
/power/VREF_DIV: C5.1, R1.2, R2.1, U2.3 (+)
/power/VREF_SN: C7.1, R3.2
GND: C1.2, C2.2, C3.2, C4.2, C5.2, C6.2, C7.2, C8.2, C9.2, C10.2, C11.2, C12.2, C13.2, C14.2, J1.2, R2.2, R5.2, R7.2, R13.2, TP1.1, TP2.1, U1.2 (GND), U2.4 (V-); also elsewhere on the board
V25: C9.1, R6.2, R7.1, TP7.1; also elsewhere on the board
VB0: C14.1, R12.2, R13.1, TP8.1; also elsewhere on the board
VB1: C13.1, R11.2, R12.1; also elsewhere on the board
VB2: C12.1, R10.2, R11.1, TP9.1; also elsewhere on the board
VB3: C11.1, R9.2, R10.1; also elsewhere on the board
VB4: C10.1, R8.2, R9.1, TP10.1; also elsewhere on the board
VBIAS: C8.1, R4.2, R5.1, TP6.1; also elsewhere on the board
VP: C1.1, C2.1, C6.1, D1.1 (K), R8.1, TP3.1, U1.3 (IN), U2.8 (V+); also elsewhere on the board
VREF: R3.1, TP5.1, U2.1, U2.2 (-); also elsewhere on the board

Notes on the sheet:
Power, references and ladder bias
Input, reverse protection, 5 V
References: VREF 4.5 V (buffered), VBIAS 1.5 V, V25 2.5 V
Ladder bias chain (from V+; VB0...VB4 = 2.4...6.4 V at V+ = 8.6 V)
Test points

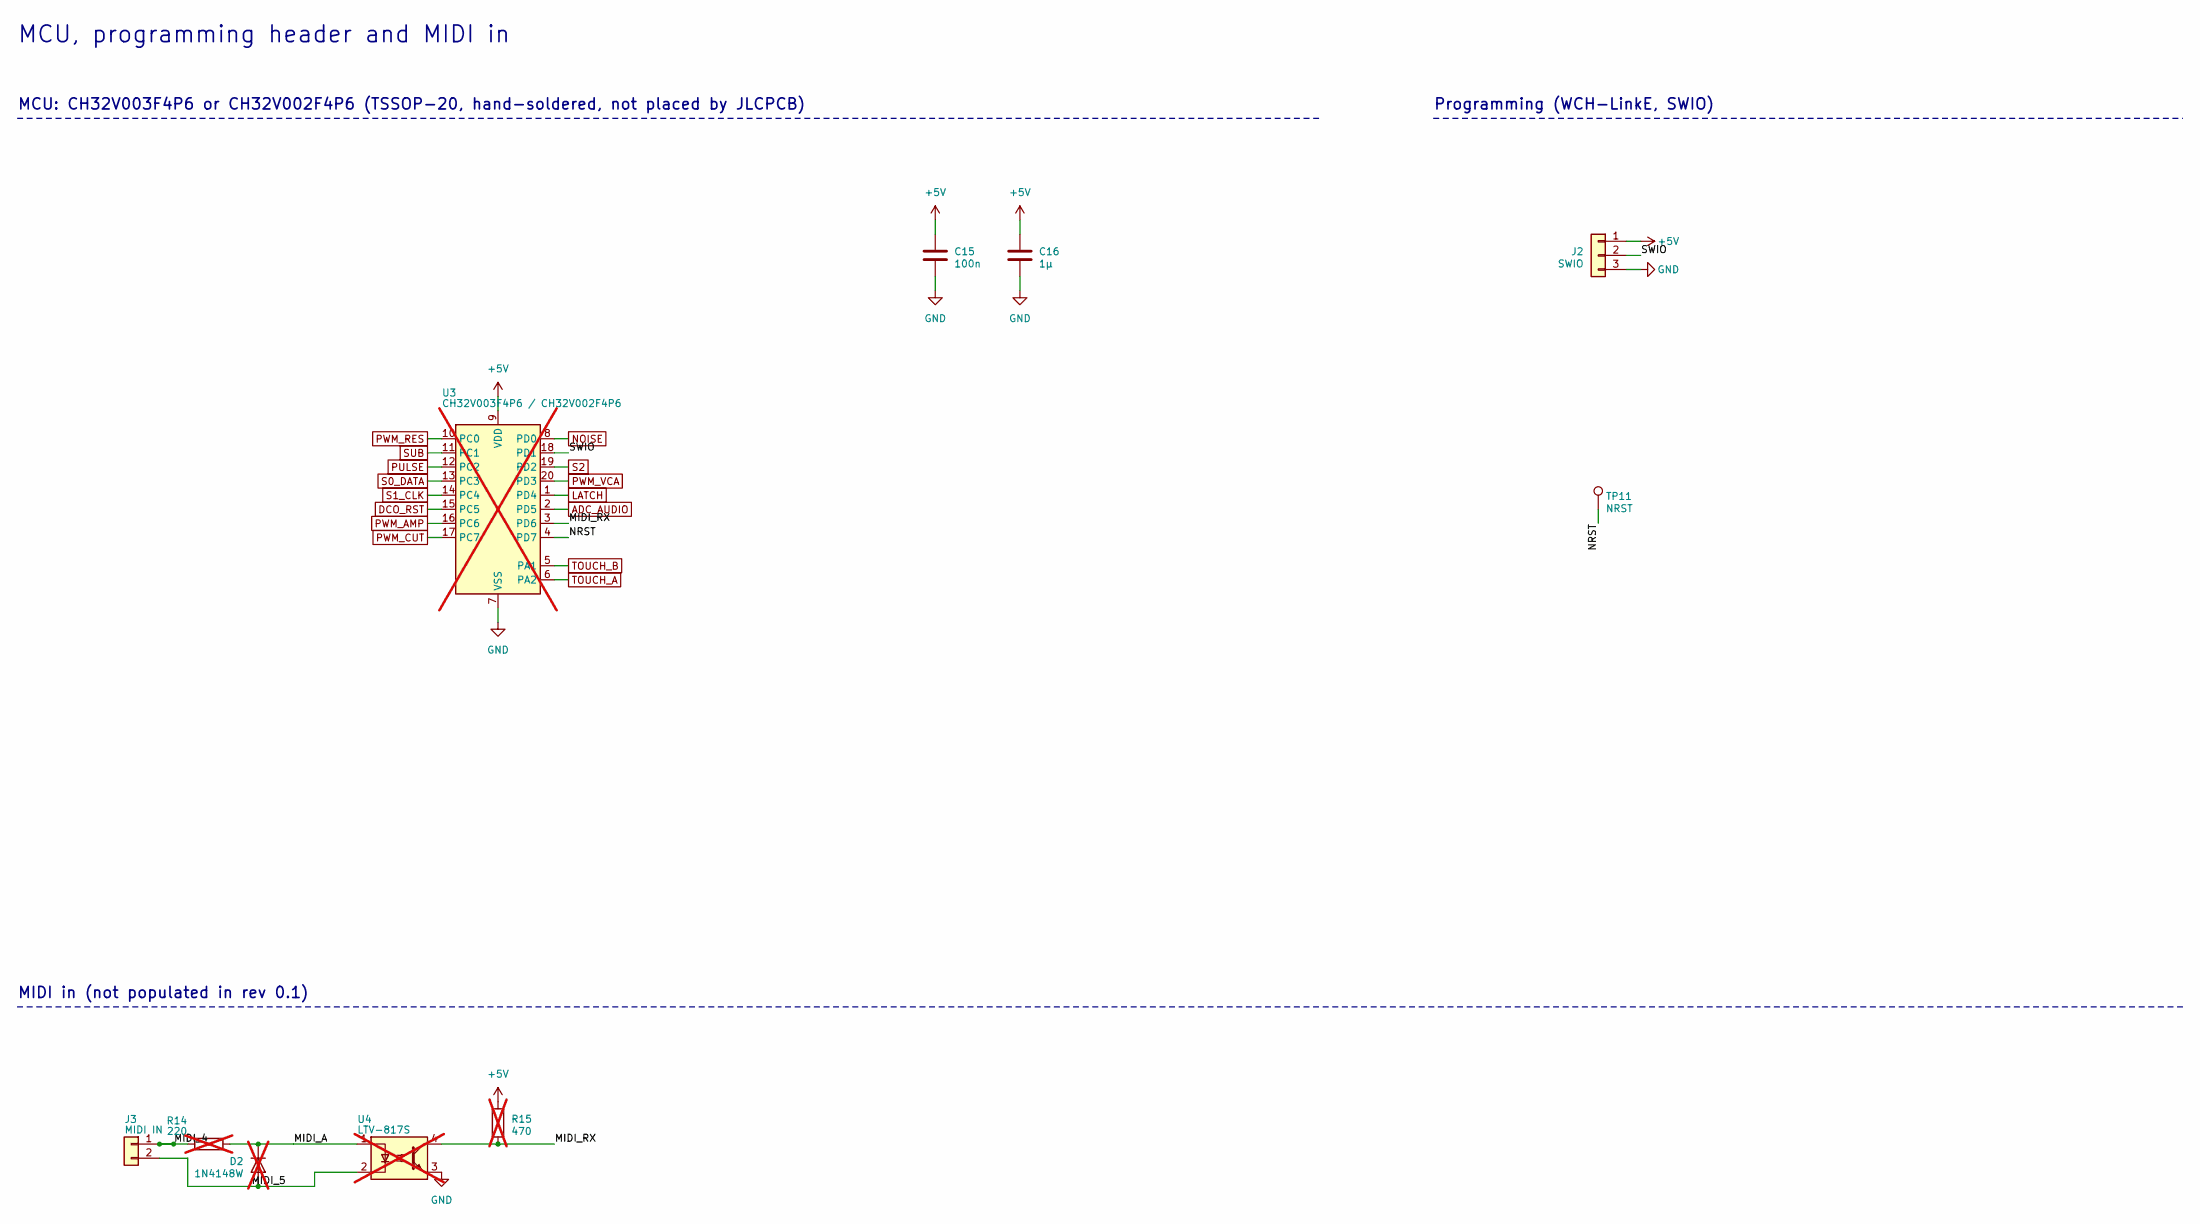
[picture p102: schematic mcu.kicad_sch, TouchSynth — MCU, programming header and MIDI in]

Parts:
C15: 100n; C_0603_1608Metric; LCSC C14663
C16: 1µ; C_0603_1608Metric; LCSC C15849
D2: 1N4148W; D_SOD-123; LCSC C81598; not fitted
J2: SWIO; PinHeader_1x03_P2.54mm_Vertical
J3: MIDI IN; PinHeader_1x02_P2.54mm_Vertical
R14: 220; R_0603_1608Metric; LCSC C22962; not fitted
R15: 470; R_0603_1608Metric; LCSC C23179; not fitted
TP11: NRST; TestPoint_Pad_D1.0mm
U3: CH32V003F4P6 / CH32V002F4P6; TSSOP-20_4.4x6.5mm_P0.65mm; not fitted
U4: LTV-817S; SMDIP-4_W9.53mm; LCSC C109227; not fitted

Connections:
+5V: C15.1, C16.1, J2.1, R15.1, U3.9 (VDD); also elsewhere on the board
/mcu/MIDI_4: J3.1, R14.1
/mcu/MIDI_5: D2.2 (A), J3.2, U4.2
/mcu/MIDI_A: D2.1 (K), R14.2, U4.1
/mcu/MIDI_RX: R15.2, U3.3 (PD6), U4.4
/mcu/NRST: TP11.1, U3.4 (PD7)
/mcu/SWIO: J2.2, U3.18 (PD1)
ADC_AUDIO: U3.2 (PD5); also elsewhere on the board
DCO_RST: U3.15 (PC5); also elsewhere on the board
GND: C15.2, C16.2, J2.3, U3.7 (VSS), U4.3; also elsewhere on the board
LATCH: U3.1 (PD4); also elsewhere on the board
NOISE: U3.8 (PD0); also elsewhere on the board
PULSE: U3.12 (PC2); also elsewhere on the board
PWM_AMP: U3.16 (PC6); also elsewhere on the board
PWM_CUT: U3.17 (PC7); also elsewhere on the board
PWM_RES: U3.10 (PC0); also elsewhere on the board
PWM_VCA: U3.20 (PD3); also elsewhere on the board
S0_DATA: U3.13 (PC3); also elsewhere on the board
S1_CLK: U3.14 (PC4); also elsewhere on the board
S2: U3.19 (PD2); also elsewhere on the board
SUB: U3.11 (PC1); also elsewhere on the board
TOUCH_A: U3.6 (PA2); also elsewhere on the board
TOUCH_B: U3.5 (PA1); also elsewhere on the board

Notes on the sheet:
MCU, programming header and MIDI in
MCU: CH32V003F4P6 or CH32V002F4P6 (TSSOP-20, hand-soldered, not placed by JLCPCB)
Programming (WCH-LinkE, SWIO)
MIDI in (not populated in rev 0.1)

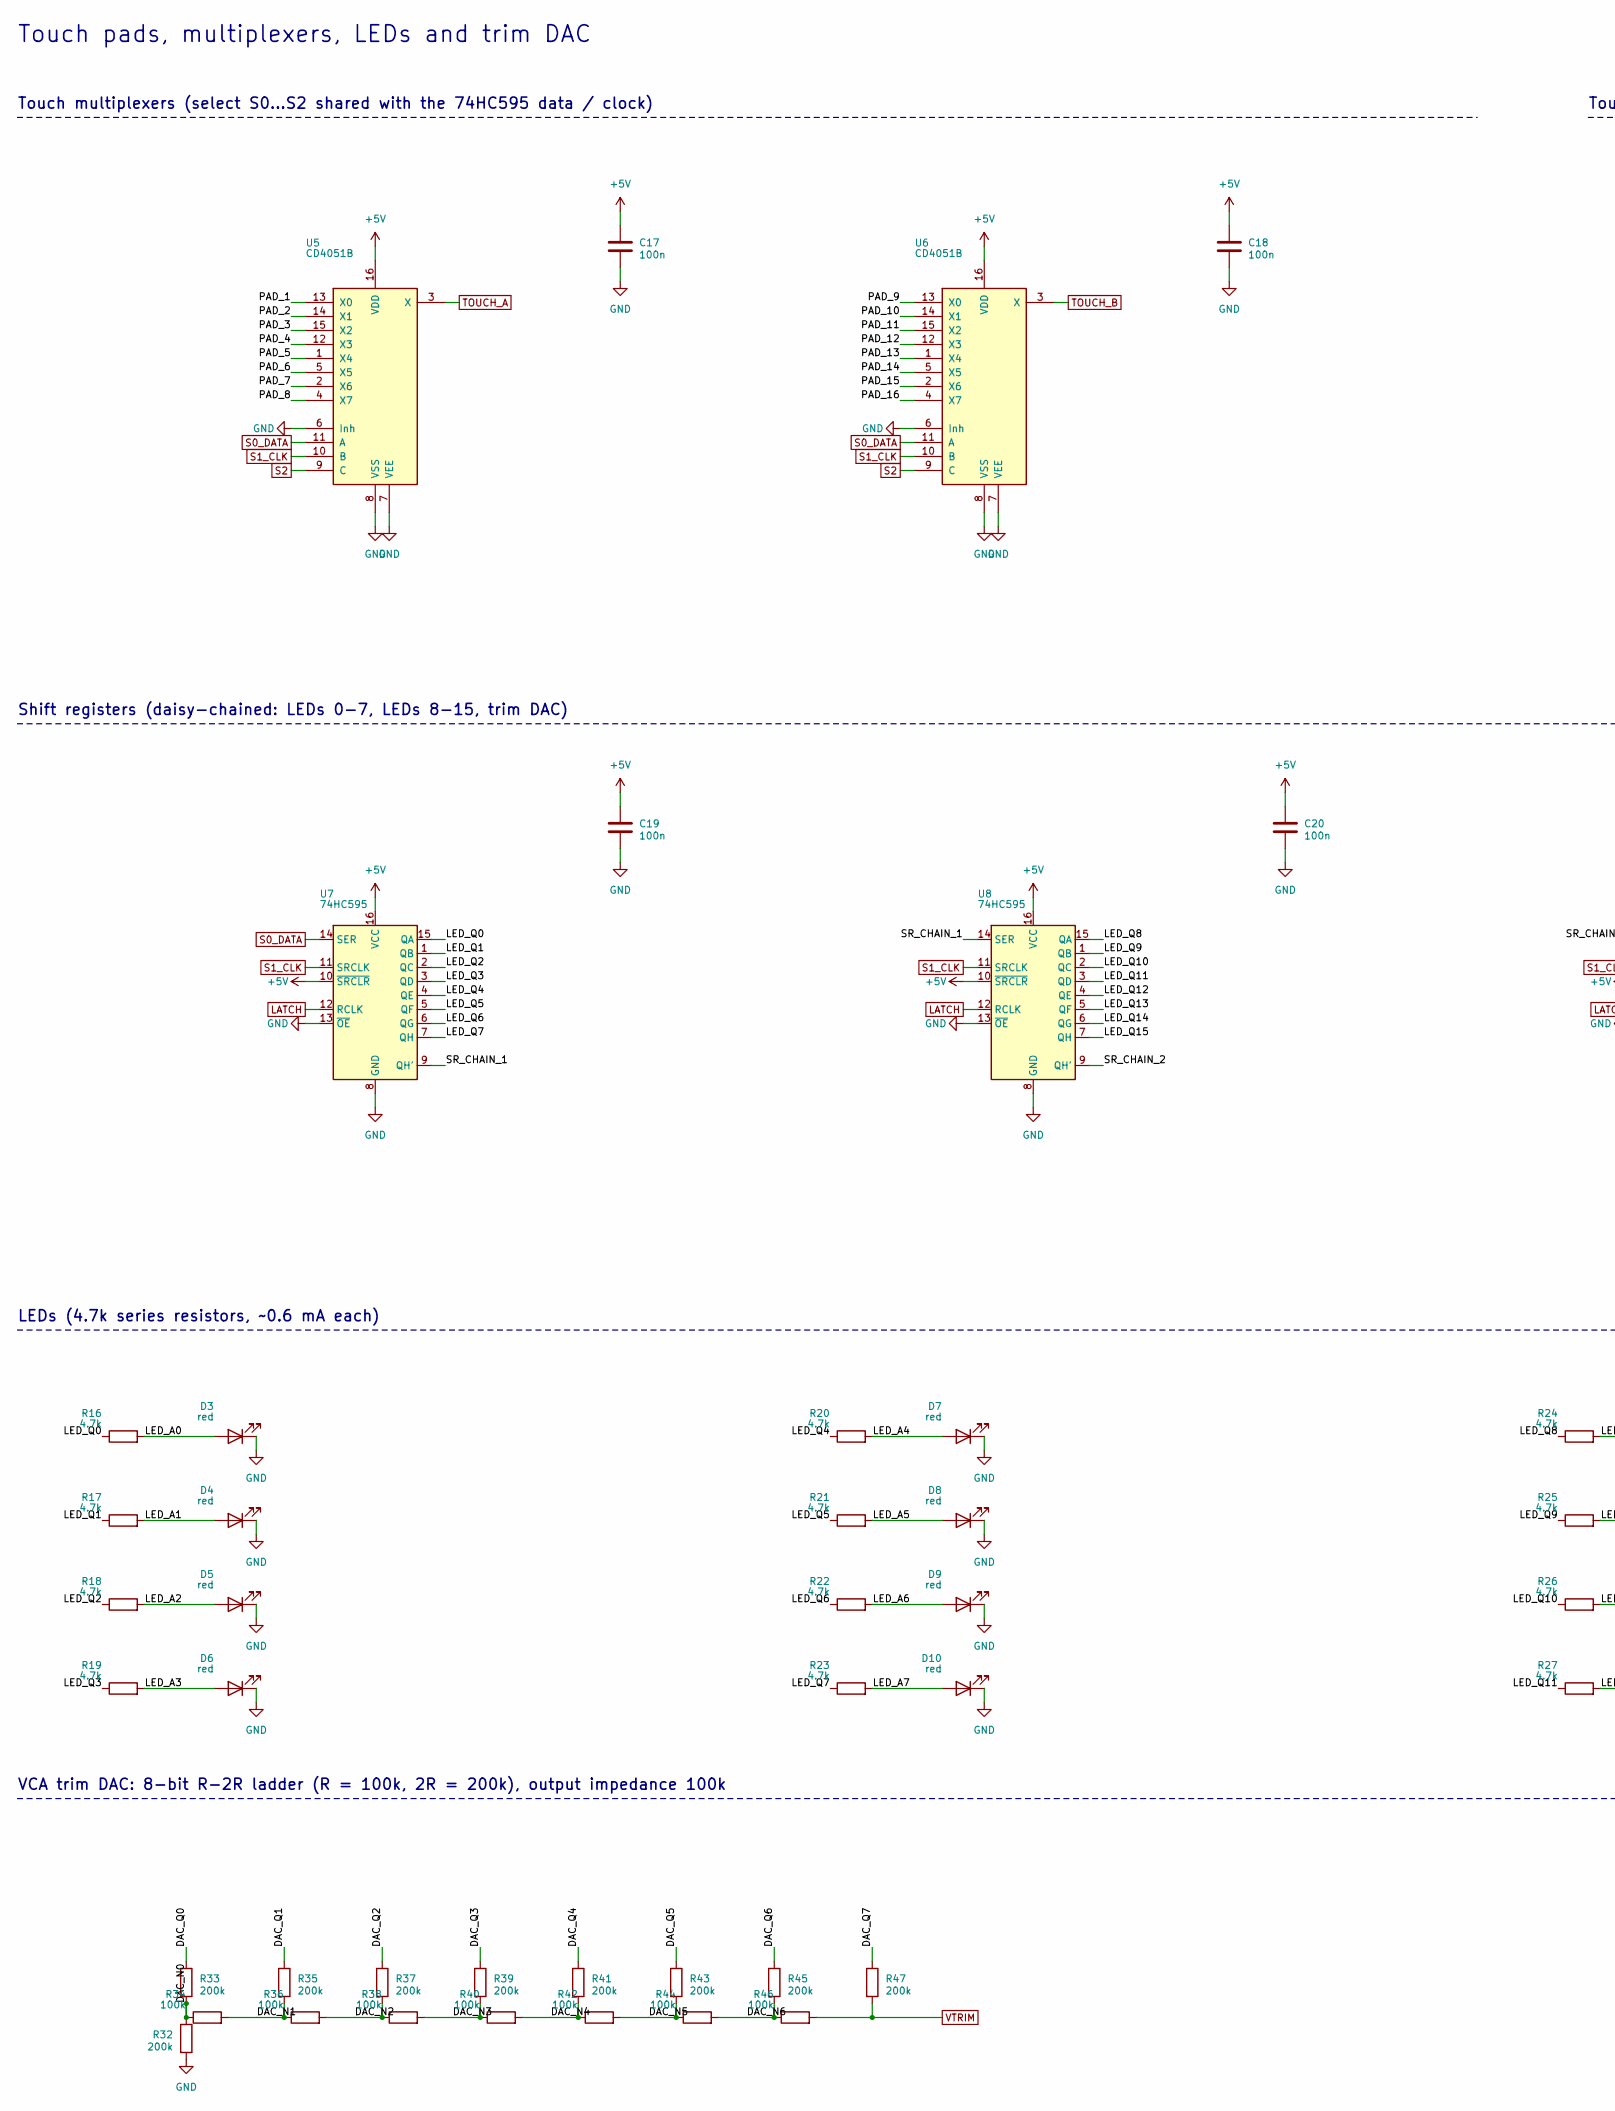
[picture p103: schematic touch_led.kicad_sch, TouchSynth — Touch pads, multiplexers, LEDs and trim DAC, part in row 1, column 1]

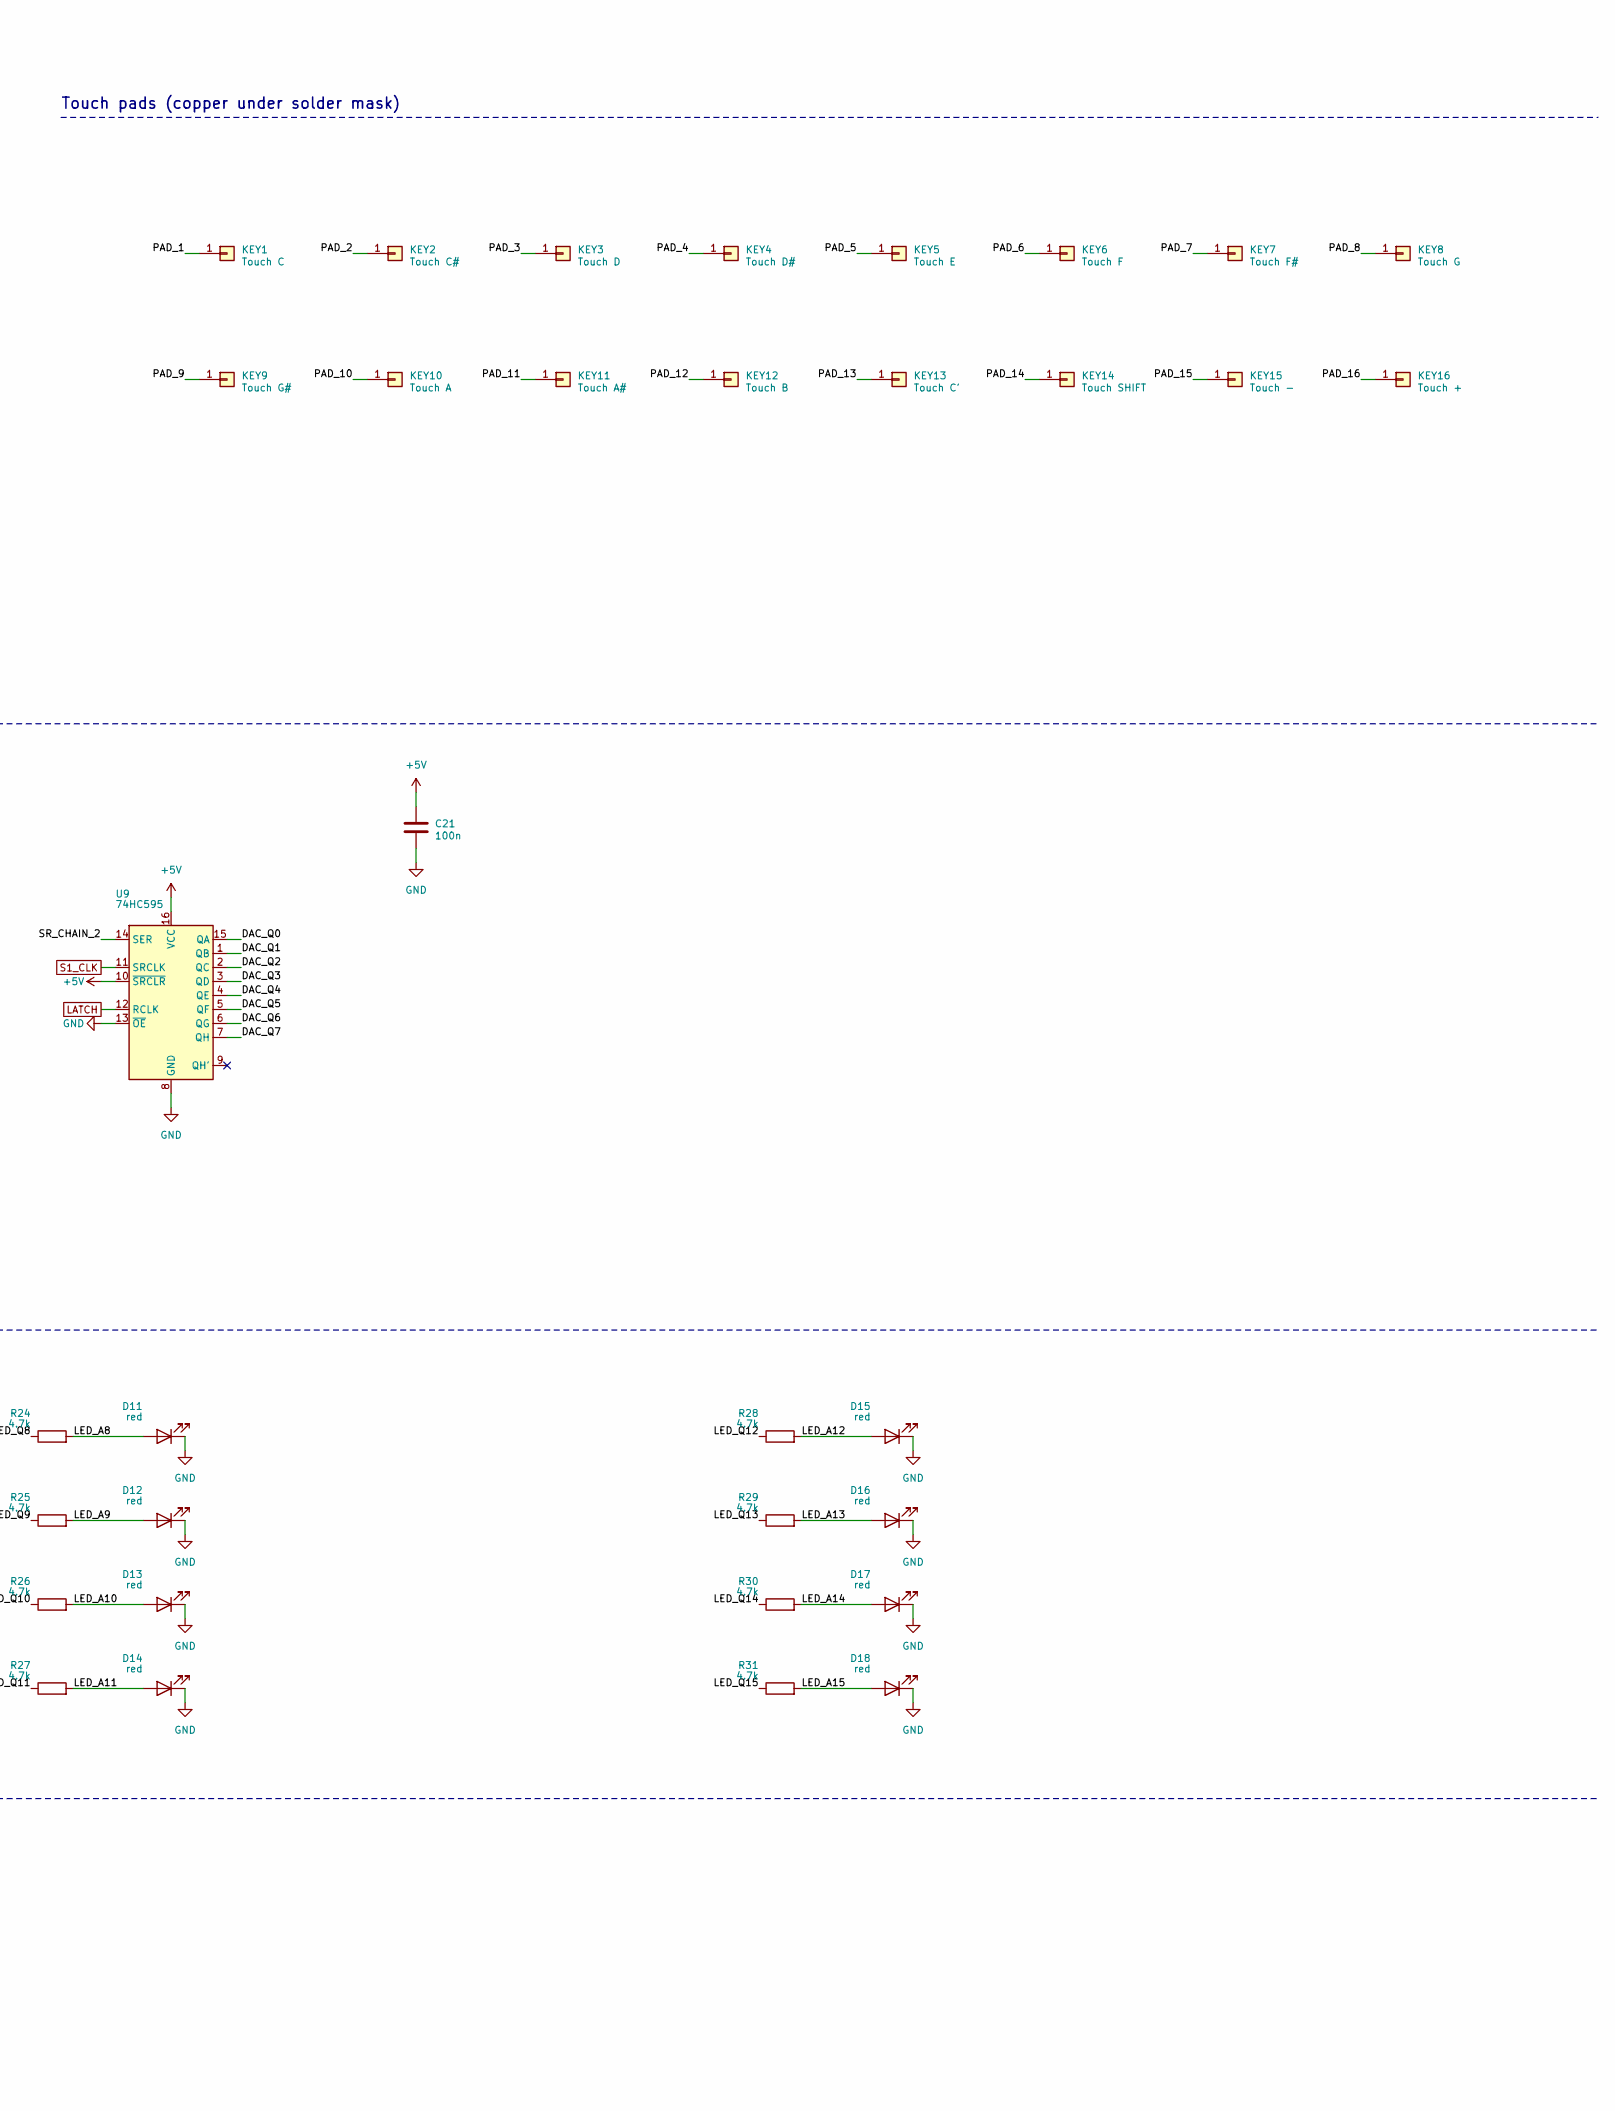
[picture p104: schematic touch_led.kicad_sch, TouchSynth — Touch pads, multiplexers, LEDs and trim DAC, part in row 1, column 2]

Parts:
C17, C18, C19, C20, C21: 100n; C_0603_1608Metric; LCSC C14663
D3, D4, D5, D6, D7, D8, D9, D10, D11, D12, D13, D14, D15, D16, D17, D18: red; LED_0603_1608Metric; LCSC C2286
KEY1: Touch C; TouchPad_White
KEY2: Touch C#; TouchPad_Black
KEY3: Touch D; TouchPad_White
KEY4: Touch D#; TouchPad_Black
KEY5: Touch E; TouchPad_White
KEY6: Touch F; TouchPad_White
KEY7: Touch F#; TouchPad_Black
KEY8: Touch G; TouchPad_White
KEY9: Touch G#; TouchPad_Black
KEY10: Touch A; TouchPad_White
KEY11: Touch A#; TouchPad_Black
KEY12: Touch B; TouchPad_White
KEY13: Touch C'; TouchPad_White
KEY14: Touch SHIFT; TouchPad_Func
KEY15: Touch -; TouchPad_Func
KEY16: Touch +; TouchPad_Func
R16, R17, R18, R19, R20, R21, R22, R23, R24, R25, R26, R27, R28, R29, R30, R31: 4.7k; R_0603_1608Metric; LCSC C23162
R32, R33, R35, R37, R39, R41, R43, R45, R47: 200k; R_0603_1608Metric; LCSC C25811
R34, R36, R38, R40, R42, R44, R46: 100k; R_0603_1608Metric; LCSC C25803
U5, U6: CD4051B; SOIC-16_3.9x9.9mm_P1.27mm; LCSC C21379
U7, U8, U9: 74HC595; SOIC-16_3.9x9.9mm_P1.27mm; LCSC C5947

Connections:
+5V: C17.1, C18.1, C19.1, C20.1, C21.1, U5.16 (VDD), U6.16 (VDD), U7.10 (~SRCLR), U7.16 (VCC), U8.10 (~SRCLR), U8.16 (VCC), U9.10 (~SRCLR), U9.16 (VCC); also elsewhere on the board
/touch_led/DAC_N0: R32.1, R33.2, R34.1
/touch_led/DAC_N1: R34.2, R35.2, R36.1
/touch_led/DAC_N2: R36.2, R37.2, R38.1
/touch_led/DAC_N3: R38.2, R39.2, R40.1
/touch_led/DAC_N4: R40.2, R41.2, R42.1
/touch_led/DAC_N5: R42.2, R43.2, R44.1
/touch_led/DAC_N6: R44.2, R45.2, R46.1
/touch_led/DAC_Q0: R33.1, U9.15 (QA)
/touch_led/DAC_Q1: R35.1, U9.1 (QB)
/touch_led/DAC_Q2: R37.1, U9.2 (QC)
/touch_led/DAC_Q3: R39.1, U9.3 (QD)
/touch_led/DAC_Q4: R41.1, U9.4 (QE)
/touch_led/DAC_Q5: R43.1, U9.5 (QF)
/touch_led/DAC_Q6: R45.1, U9.6 (QG)
/touch_led/DAC_Q7: R47.1, U9.7 (QH)
/touch_led/LED_A0: D3.2 (A), R16.2
/touch_led/LED_A1: D4.2 (A), R17.2
/touch_led/LED_A2: D5.2 (A), R18.2
/touch_led/LED_A3: D6.2 (A), R19.2
/touch_led/LED_A4: D7.2 (A), R20.2
/touch_led/LED_A5: D8.2 (A), R21.2
/touch_led/LED_A6: D9.2 (A), R22.2
/touch_led/LED_A7: D10.2 (A), R23.2
/touch_led/LED_A8: D11.2 (A), R24.2
/touch_led/LED_A9: D12.2 (A), R25.2
/touch_led/LED_A10: D13.2 (A), R26.2
/touch_led/LED_A11: D14.2 (A), R27.2
/touch_led/LED_A12: D15.2 (A), R28.2
/touch_led/LED_A13: D16.2 (A), R29.2
/touch_led/LED_A14: D17.2 (A), R30.2
/touch_led/LED_A15: D18.2 (A), R31.2
/touch_led/LED_Q0: R16.1, U7.15 (QA)
/touch_led/LED_Q1: R17.1, U7.1 (QB)
/touch_led/LED_Q2: R18.1, U7.2 (QC)
/touch_led/LED_Q3: R19.1, U7.3 (QD)
/touch_led/LED_Q4: R20.1, U7.4 (QE)
/touch_led/LED_Q5: R21.1, U7.5 (QF)
/touch_led/LED_Q6: R22.1, U7.6 (QG)
/touch_led/LED_Q7: R23.1, U7.7 (QH)
/touch_led/LED_Q8: R24.1, U8.15 (QA)
/touch_led/LED_Q9: R25.1, U8.1 (QB)
/touch_led/LED_Q10: R26.1, U8.2 (QC)
/touch_led/LED_Q11: R27.1, U8.3 (QD)
/touch_led/LED_Q12: R28.1, U8.4 (QE)
/touch_led/LED_Q13: R29.1, U8.5 (QF)
/touch_led/LED_Q14: R30.1, U8.6 (QG)
/touch_led/LED_Q15: R31.1, U8.7 (QH)
/touch_led/PAD_1: KEY1.1, U5.13 (X0)
/touch_led/PAD_2: KEY2.1, U5.14 (X1)
/touch_led/PAD_3: KEY3.1, U5.15 (X2)
/touch_led/PAD_4: KEY4.1, U5.12 (X3)
/touch_led/PAD_5: KEY5.1, U5.1 (X4)
/touch_led/PAD_6: KEY6.1, U5.5 (X5)
/touch_led/PAD_7: KEY7.1, U5.2 (X6)
/touch_led/PAD_8: KEY8.1, U5.4 (X7)
/touch_led/PAD_9: KEY9.1, U6.13 (X0)
/touch_led/PAD_10: KEY10.1, U6.14 (X1)
/touch_led/PAD_11: KEY11.1, U6.15 (X2)
/touch_led/PAD_12: KEY12.1, U6.12 (X3)
/touch_led/PAD_13: KEY13.1, U6.1 (X4)
/touch_led/PAD_14: KEY14.1, U6.5 (X5)
/touch_led/PAD_15: KEY15.1, U6.2 (X6)
/touch_led/PAD_16: KEY16.1, U6.4 (X7)
/touch_led/SR_CHAIN_1: U7.9 (QH'), U8.14 (SER)
/touch_led/SR_CHAIN_2: U8.9 (QH'), U9.14 (SER)
GND: C17.2, C18.2, C19.2, C20.2, C21.2, D3.1 (K), D4.1 (K), D5.1 (K), D6.1 (K), D7.1 (K), D8.1 (K), D9.1 (K), D10.1 (K), D11.1 (K), D12.1 (K), D13.1 (K), D14.1 (K), D15.1 (K), D16.1 (K), D17.1 (K), D18.1 (K), R32.2, U5.6 (Inh), U5.7 (VEE), U5.8 (VSS), U6.6 (Inh), U6.7 (VEE), U6.8 (VSS), U7.8 (GND), U7.13 (~OE), U8.8 (GND), U8.13 (~OE), U9.8 (GND), U9.13 (~OE); also elsewhere on the board
LATCH: U7.12 (RCLK), U8.12 (RCLK), U9.12 (RCLK); also elsewhere on the board
S0_DATA: U5.11 (A), U6.11 (A), U7.14 (SER); also elsewhere on the board
S1_CLK: U5.10 (B), U6.10 (B), U7.11 (SRCLK), U8.11 (SRCLK), U9.11 (SRCLK); also elsewhere on the board
S2: U5.9 (C), U6.9 (C); also elsewhere on the board
TOUCH_A: U5.3 (X); also elsewhere on the board
TOUCH_B: U6.3 (X); also elsewhere on the board
VTRIM: R46.2, R47.2; also elsewhere on the board

Notes on the sheet:
Touch pads, multiplexers, LEDs and trim DAC
Touch multiplexers (select S0...S2 shared with the 74HC595 data / clock)
Touch pads (copper under solder mask)
Shift registers (daisy-chained: LEDs 0-7, LEDs 8-15, trim DAC)
LEDs (4.7k series resistors, ~0.6 mA each)
VCA trim DAC: 8-bit R-2R ladder (R = 100k, 2R = 200k), output impedance 100k

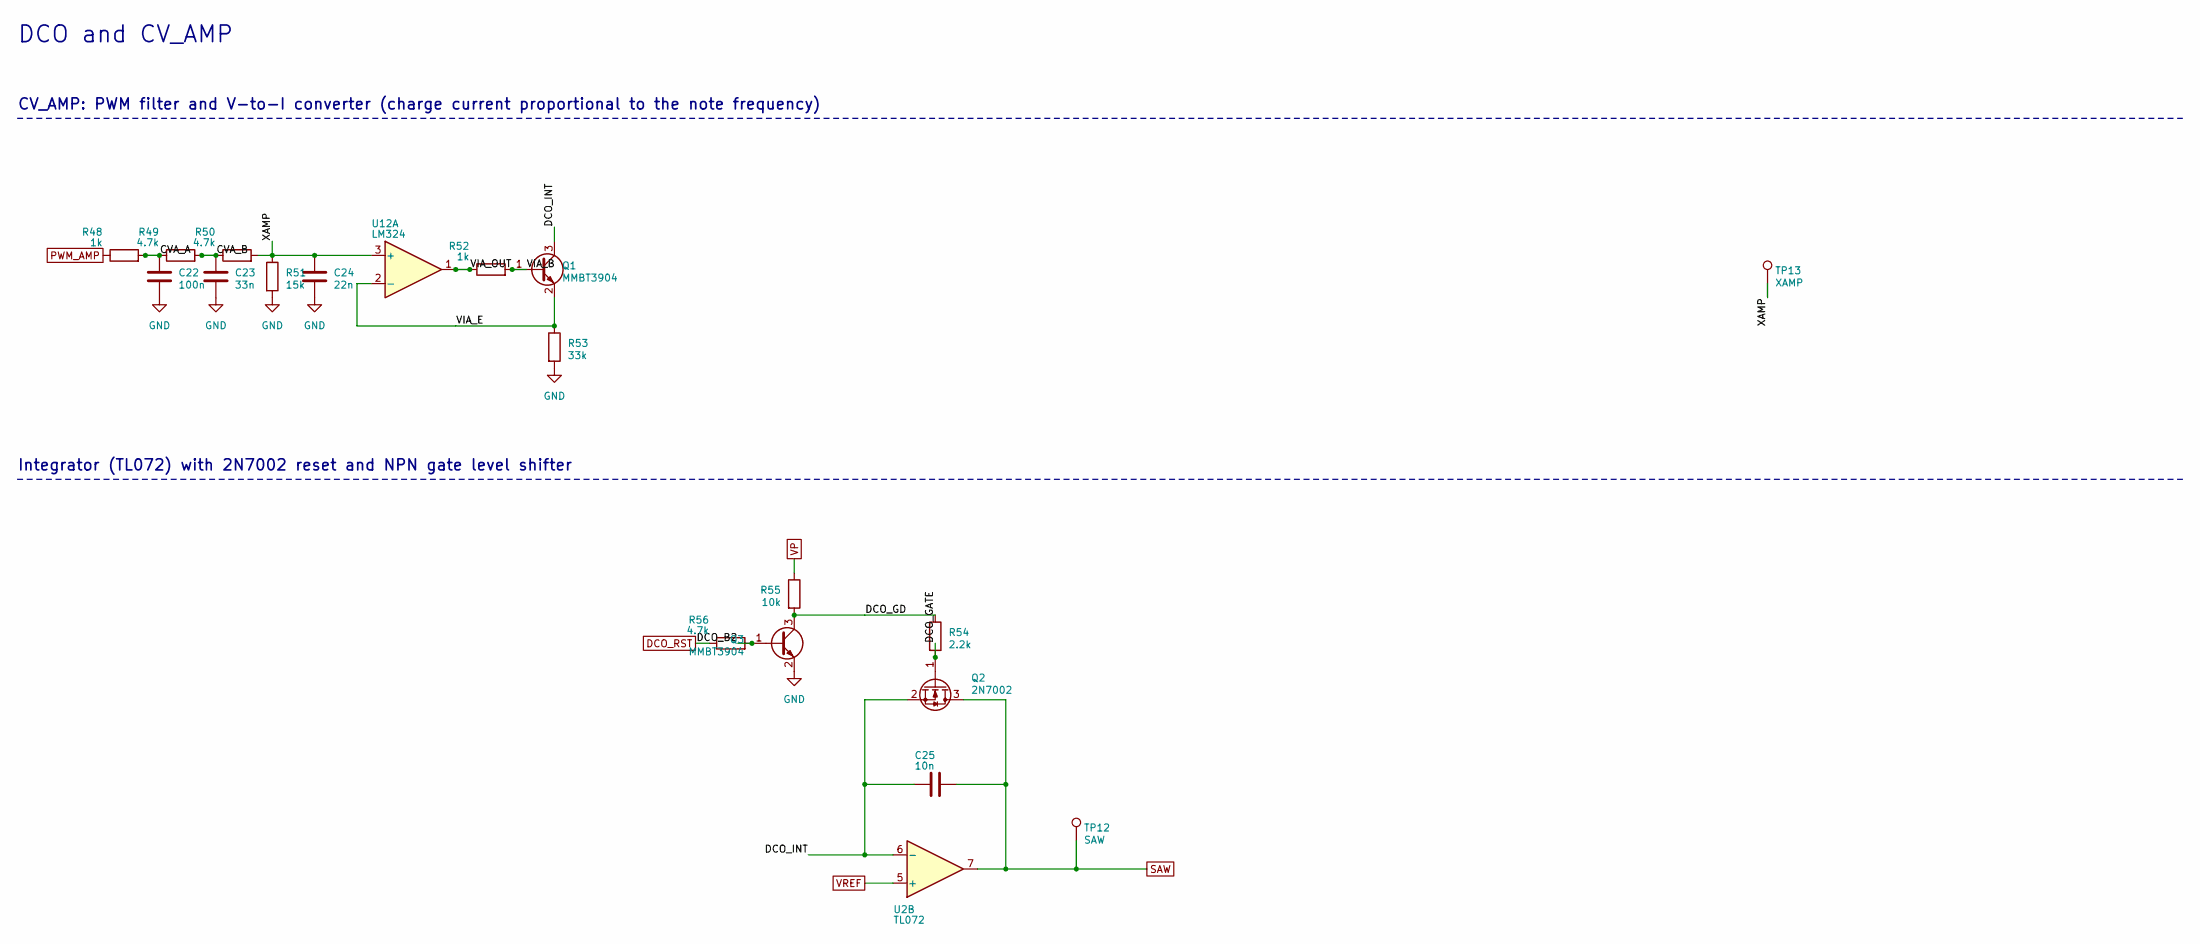
[picture p105: schematic dco.kicad_sch, TouchSynth — DCO and CV_AMP]

Parts:
C22: 100n; C_0603_1608Metric; LCSC C14663
C23: 33n; C_0603_1608Metric; LCSC C21117
C24: 22n; C_0603_1608Metric; LCSC C21122
C25: 10n; C_0603_1608Metric; LCSC C57112
Q1, Q3: MMBT3904; SOT-23; LCSC C20526
Q2: 2N7002; SOT-23; LCSC C8545
R48, R52: 1k; R_0603_1608Metric; LCSC C21190
R49, R50, R56: 4.7k; R_0603_1608Metric; LCSC C23162
R51: 15k; R_0603_1608Metric; LCSC C22809
R53: 33k; R_0603_1608Metric; LCSC C4216
R54: 2.2k; R_0603_1608Metric; LCSC C4190
R55: 10k; R_0603_1608Metric; LCSC C25804
TP12: SAW; TestPoint_Pad_D1.0mm
TP13: XAMP; TestPoint_Pad_D1.0mm
U2: TL072; SOIC-8_3.9x4.9mm_P1.27mm; LCSC C6961
U12: LM324; SOIC-14_3.9x8.7mm_P1.27mm; LCSC C71035

Connections:
/dco/CVA_A: C22.1, R48.2, R49.1
/dco/CVA_B: C23.1, R49.2, R50.1
/dco/DCO_B2: Q3.1 (B), R56.2
/dco/DCO_GATE: Q2.1 (G), R54.2
/dco/DCO_GD: Q3.3 (C), R54.1, R55.2
/dco/DCO_INT: C25.2, Q1.3 (C), Q2.2 (S), U2.6 (-)
/dco/VIA_B: Q1.1 (B), R52.2
/dco/VIA_E: Q1.2 (E), R53.1, U12.2 (-)
/dco/VIA_OUT: R52.1, U12.1
/dco/XAMP: C24.1, R50.2, R51.1, TP13.1, U12.3 (+)
DCO_RST: R56.1; also elsewhere on the board
GND: C22.2, C23.2, C24.2, Q3.2 (E), R51.2, R53.2; also elsewhere on the board
PWM_AMP: R48.1; also elsewhere on the board
SAW: C25.1, Q2.3 (D), TP12.1, U2.7; also elsewhere on the board
VP: R55.1; also elsewhere on the board
VREF: U2.5 (+); also elsewhere on the board

Notes on the sheet:
DCO and CV_AMP
CV_AMP: PWM filter and V-to-I converter (charge current proportional to the note frequency)
Integrator (TL072) with 2N7002 reset and NPN gate level shifter
