cpldcpu/TouchSynth/hw/touchsynth/touchsynth.kicad_pcb

## KiCad design hw/touchsynth/touchsynth.kicad_pcb (continued)

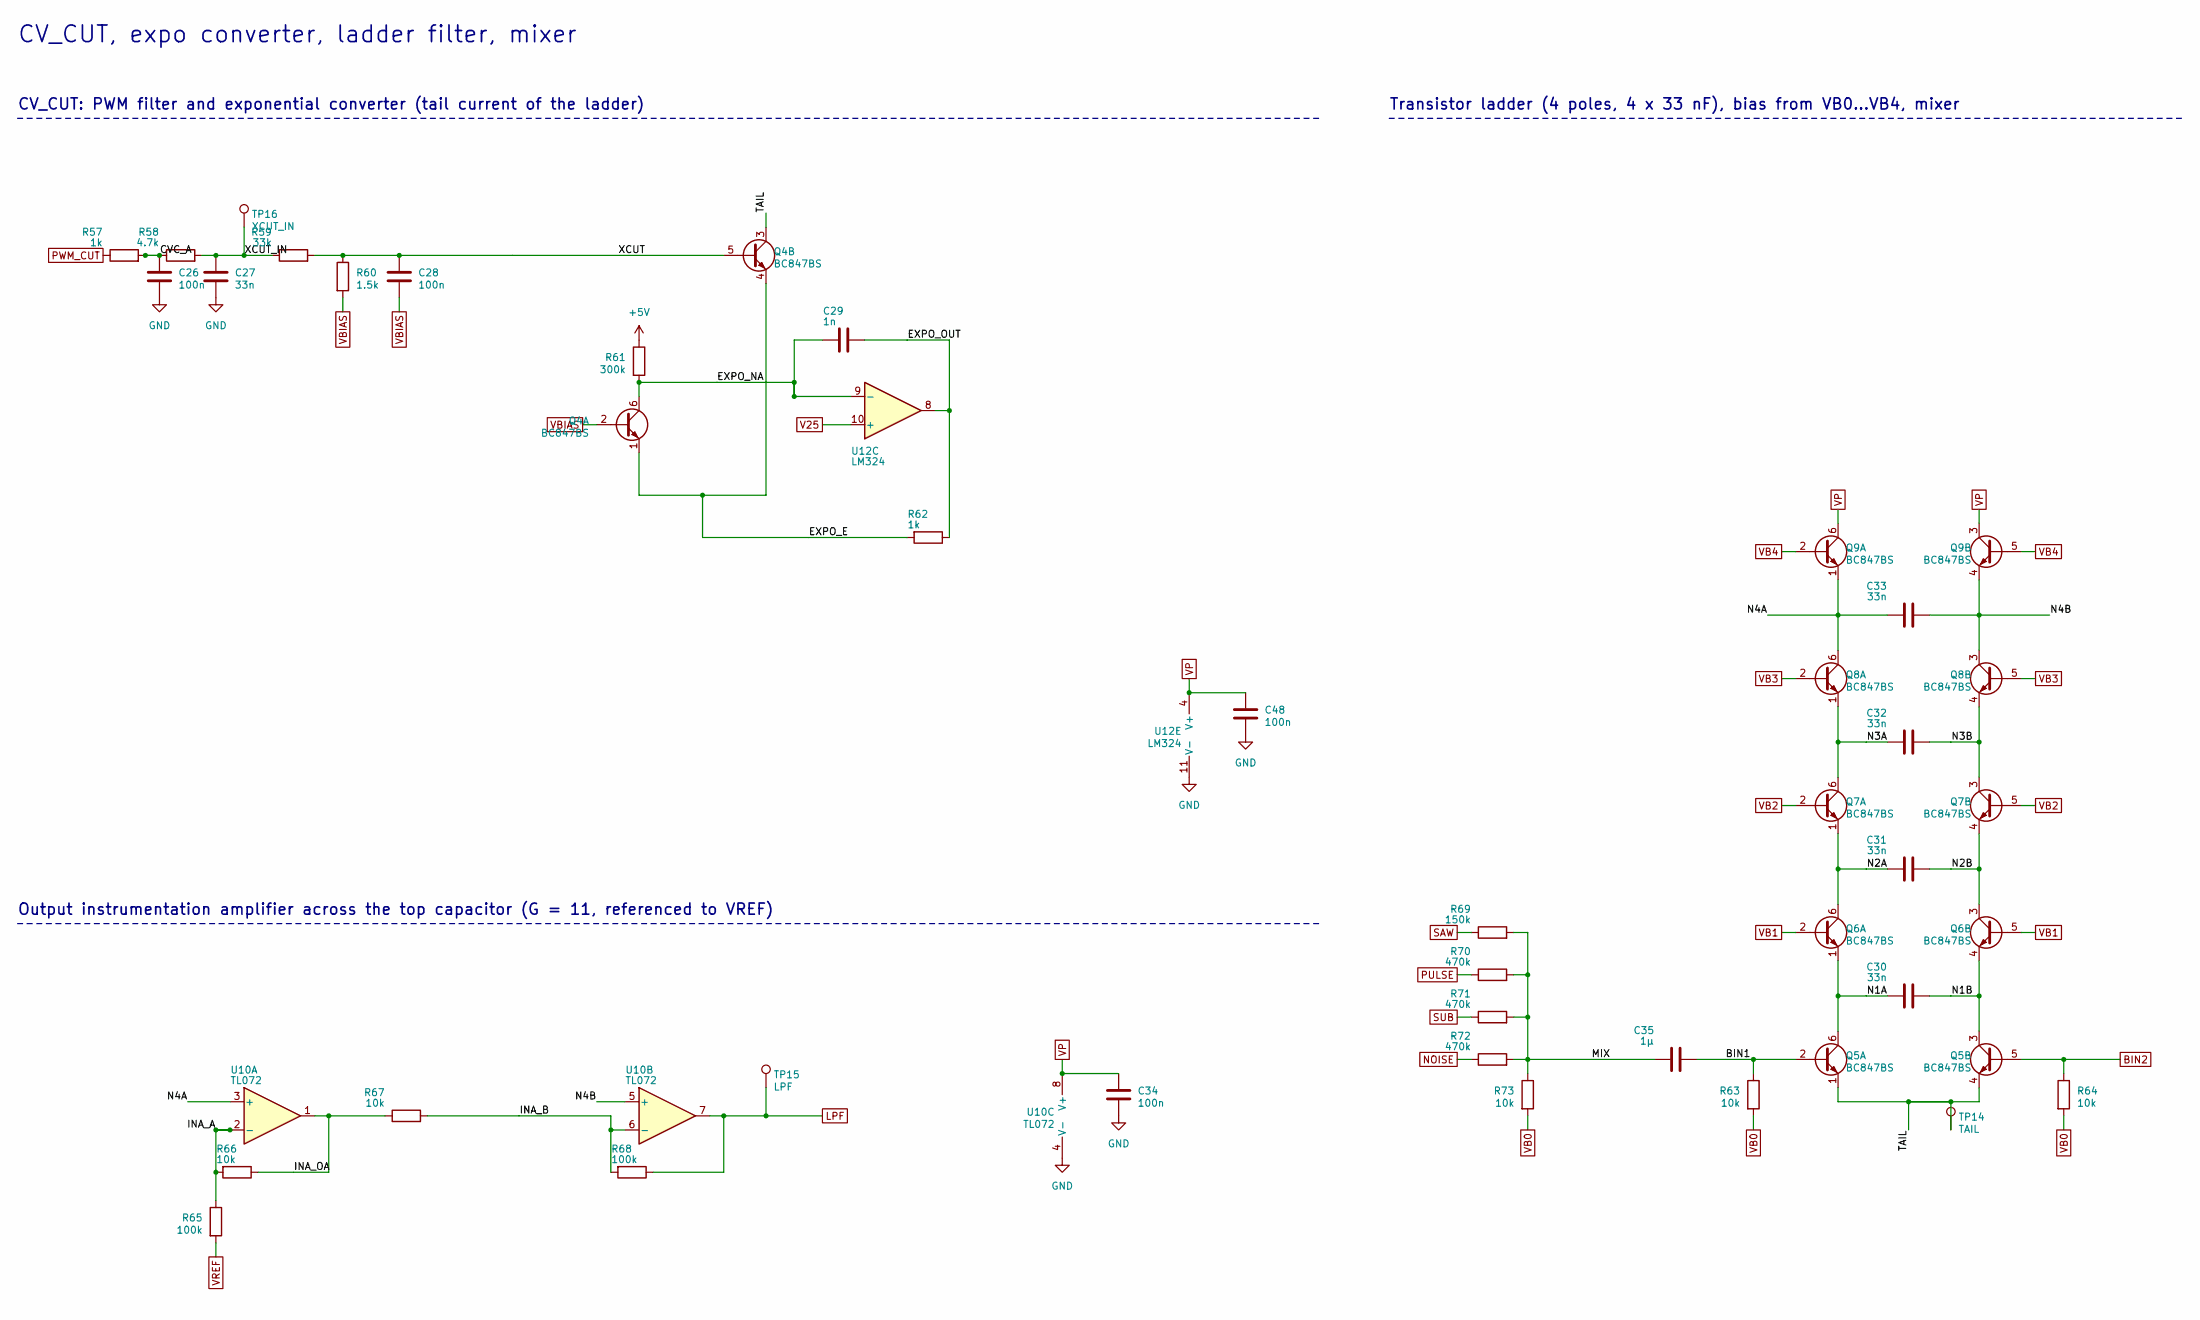
[picture p106: schematic vcf.kicad_sch, TouchSynth — CV_CUT, expo converter, ladder filter, mixer]

Parts:
C26, C28, C34, C48: 100n; C_0603_1608Metric; LCSC C14663
C27, C30, C31, C32, C33: 33n; C_0603_1608Metric; LCSC C21117
C29: 1n; C_0603_1608Metric; LCSC C1588
C35: 1µ; C_0603_1608Metric; LCSC C15849
Q4, Q5, Q6, Q7, Q8, Q9: BC847BS; SOT-363_SC-70-6; LCSC C41375126
R57, R62: 1k; R_0603_1608Metric; LCSC C21190
R58: 4.7k; R_0603_1608Metric; LCSC C23162
R59: 33k; R_0603_1608Metric; LCSC C4216
R60: 1.5k; R_0603_1608Metric; LCSC C22843
R61: 300k; R_0603_1608Metric; LCSC C23024
R63, R64, R66, R67, R73: 10k; R_0603_1608Metric; LCSC C25804
R65, R68: 100k; R_0603_1608Metric; LCSC C25803
R69: 150k; R_0603_1608Metric; LCSC C22807
R70, R71, R72: 470k; R_0603_1608Metric; LCSC C23178
TP14: TAIL; TestPoint_Pad_D1.0mm
TP15: LPF; TestPoint_Pad_D1.0mm
TP16: XCUT_IN; TestPoint_Pad_D1.0mm
U10: TL072; SOIC-8_3.9x4.9mm_P1.27mm; LCSC C6961
U12: LM324; SOIC-14_3.9x8.7mm_P1.27mm; LCSC C71035

Connections:
+5V: R61.1; also elsewhere on the board
/vcf/BIN1: C35.2, Q5.2 (B1), R63.1
/vcf/CVC_A: C26.1, R57.2, R58.1
/vcf/EXPO_E: Q4.1 (E1), Q4.4 (E2), R62.2
/vcf/EXPO_NA: C29.2, Q4.6 (C1), R61.2, U12.9 (-)
/vcf/EXPO_OUT: C29.1, R62.1, U12.8
/vcf/INA_A: R65.1, R66.2, U10.2 (-)
/vcf/INA_B: R67.2, R68.2, U10.6 (-)
/vcf/INA_OA: R66.1, R67.1, U10.1
/vcf/MIX: C35.1, R69.2, R70.2, R71.2, R72.2, R73.1
/vcf/N1A: C30.1, Q5.6 (C1), Q6.1 (E1)
/vcf/N1B: C30.2, Q5.3 (C2), Q6.4 (E2)
/vcf/N2A: C31.1, Q6.6 (C1), Q7.1 (E1)
/vcf/N2B: C31.2, Q6.3 (C2), Q7.4 (E2)
/vcf/N3A: C32.1, Q7.6 (C1), Q8.1 (E1)
/vcf/N3B: C32.2, Q7.3 (C2), Q8.4 (E2)
/vcf/N4A: C33.1, Q8.6 (C1), Q9.1 (E1), U10.3 (+)
/vcf/N4B: C33.2, Q8.3 (C2), Q9.4 (E2), U10.5 (+)
/vcf/TAIL: Q4.3 (C2), Q5.1 (E1), Q5.4 (E2), TP14.1
/vcf/XCUT: C28.1, Q4.5 (B2), R59.2, R60.1
/vcf/XCUT_IN: C27.1, R58.2, R59.1, TP16.1
BIN2: Q5.5 (B2), R64.1; also elsewhere on the board
GND: C26.2, C27.2, C34.2, C48.2, U10.4 (V-), U12.11 (V-); also elsewhere on the board
LPF: R68.1, TP15.1, U10.7; also elsewhere on the board
NOISE: R72.1; also elsewhere on the board
PULSE: R70.1; also elsewhere on the board
PWM_CUT: R57.1; also elsewhere on the board
SAW: R69.1; also elsewhere on the board
SUB: R71.1; also elsewhere on the board
V25: U12.10 (+); also elsewhere on the board
VB0: R63.2, R64.2, R73.2; also elsewhere on the board
VB1: Q6.2 (B1), Q6.5 (B2); also elsewhere on the board
VB2: Q7.2 (B1), Q7.5 (B2); also elsewhere on the board
VB3: Q8.2 (B1), Q8.5 (B2); also elsewhere on the board
VB4: Q9.2 (B1), Q9.5 (B2); also elsewhere on the board
VBIAS: C28.2, Q4.2 (B1), R60.2; also elsewhere on the board
VP: C34.1, C48.1, Q9.3 (C2), Q9.6 (C1), U10.8 (V+), U12.4 (V+); also elsewhere on the board
VREF: R65.2; also elsewhere on the board

Notes on the sheet:
CV_CUT, expo converter, ladder filter, mixer
CV_CUT: PWM filter and exponential converter (tail current of the ladder)
Transistor ladder (4 poles, 4 x 33 nF), bias from VB0...VB4, mixer
Output instrumentation amplifier across the top capacitor (G = 11, referenced to VREF)

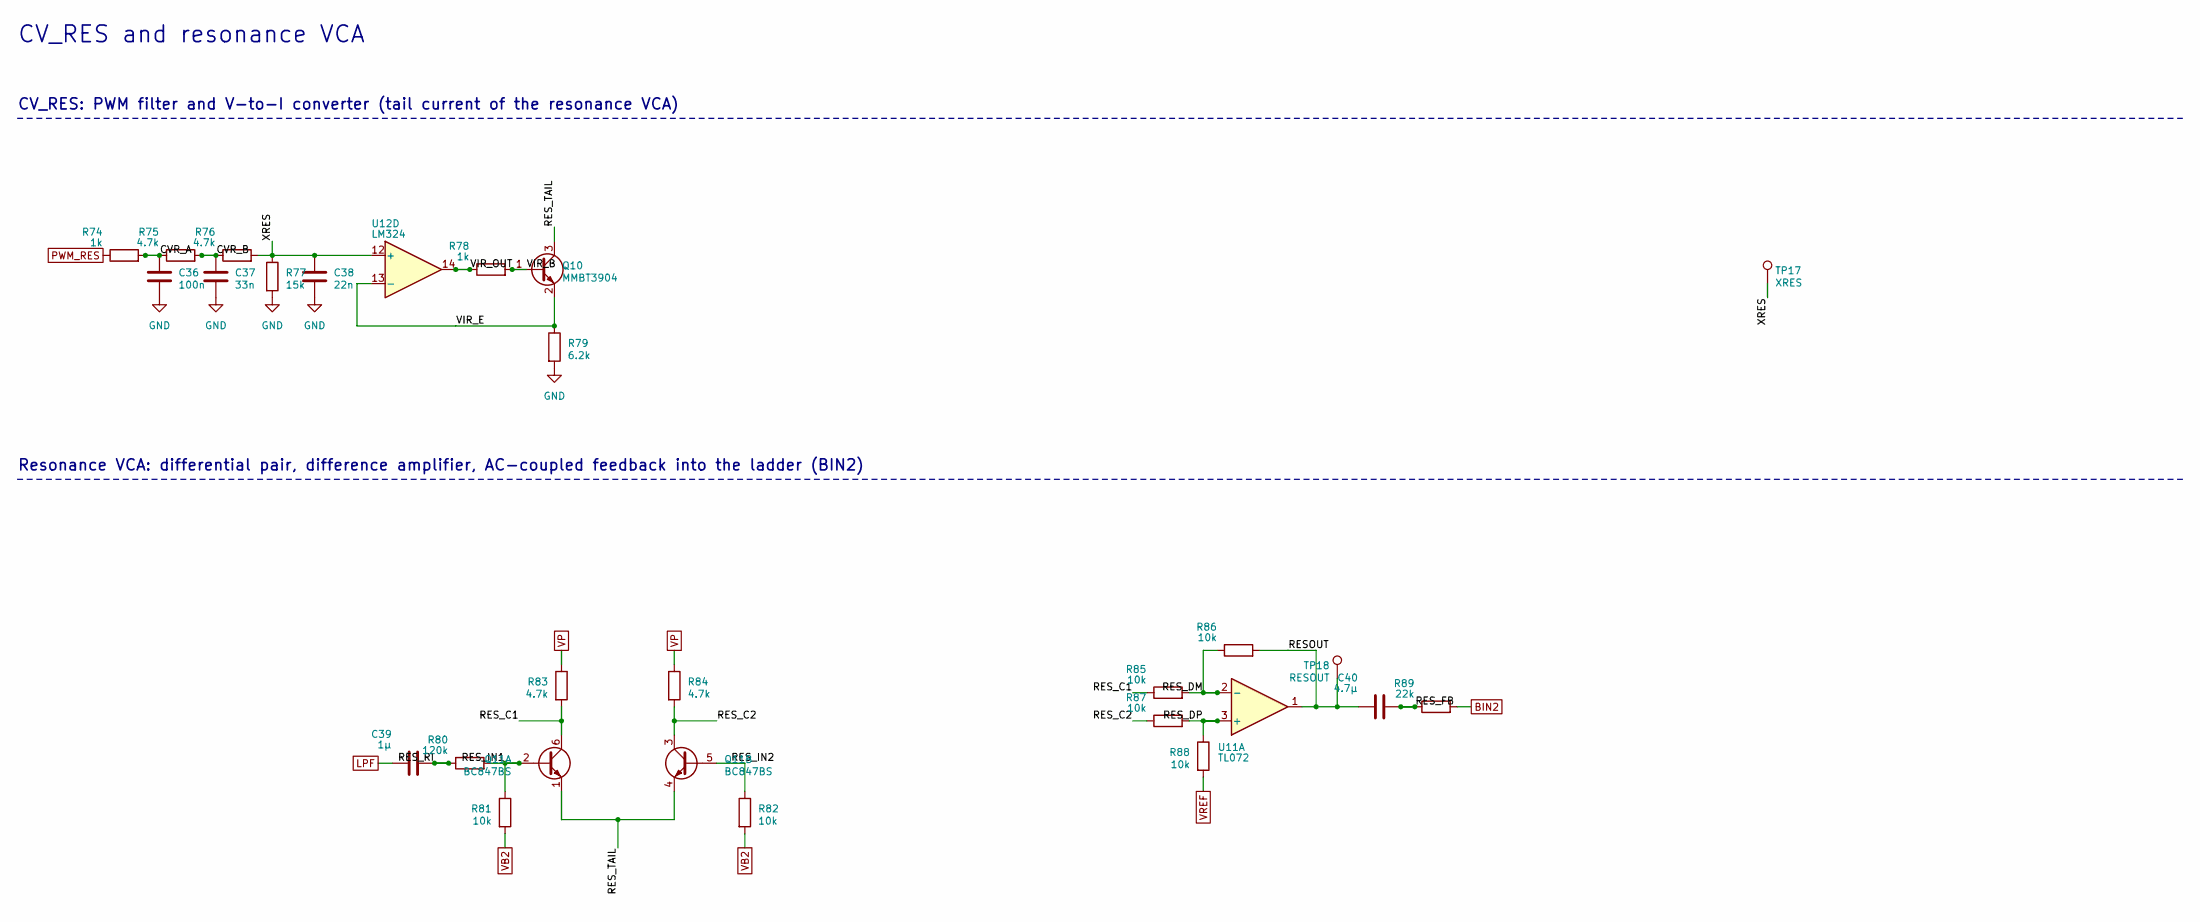
[picture p107: schematic resonance.kicad_sch, TouchSynth — CV_RES and resonance VCA]

Parts:
C36: 100n; C_0603_1608Metric; LCSC C14663
C37: 33n; C_0603_1608Metric; LCSC C21117
C38: 22n; C_0603_1608Metric; LCSC C21122
C39: 1µ; C_0603_1608Metric; LCSC C15849
C40: 4.7µ; C_0603_1608Metric; LCSC C19666
Q10: MMBT3904; SOT-23; LCSC C20526
Q11: BC847BS; SOT-363_SC-70-6; LCSC C41375126
R74, R78: 1k; R_0603_1608Metric; LCSC C21190
R75, R76, R83, R84: 4.7k; R_0603_1608Metric; LCSC C23162
R77: 15k; R_0603_1608Metric; LCSC C22809
R79: 6.2k; R_0603_1608Metric; LCSC C4260
R80: 120k; R_0603_1608Metric; LCSC C25808
R81, R82, R85, R86, R87, R88: 10k; R_0603_1608Metric; LCSC C25804
R89: 22k; R_0603_1608Metric; LCSC C31850
TP17: XRES; TestPoint_Pad_D1.0mm
TP18: RESOUT; TestPoint_Pad_D1.0mm
U11: TL072; SOIC-8_3.9x4.9mm_P1.27mm; LCSC C6961
U12: LM324; SOIC-14_3.9x8.7mm_P1.27mm; LCSC C71035

Connections:
/resonance/CVR_A: C36.1, R74.2, R75.1
/resonance/CVR_B: C37.1, R75.2, R76.1
/resonance/RESOUT: C40.1, R86.2, TP18.1, U11.1
/resonance/RES_C1: Q11.6 (C1), R83.2, R85.1
/resonance/RES_C2: Q11.3 (C2), R84.2, R87.1
/resonance/RES_DM: R85.2, R86.1, U11.2 (-)
/resonance/RES_DP: R87.2, R88.1, U11.3 (+)
/resonance/RES_FB: C40.2, R89.1
/resonance/RES_IN1: Q11.2 (B1), R80.2, R81.1
/resonance/RES_IN2: Q11.5 (B2), R82.1
/resonance/RES_RI: C39.2, R80.1
/resonance/RES_TAIL: Q10.3 (C), Q11.1 (E1), Q11.4 (E2)
/resonance/VIR_B: Q10.1 (B), R78.2
/resonance/VIR_E: Q10.2 (E), R79.1, U12.13 (-)
/resonance/VIR_OUT: R78.1, U12.14
/resonance/XRES: C38.1, R76.2, R77.1, TP17.1, U12.12 (+)
BIN2: R89.2; also elsewhere on the board
GND: C36.2, C37.2, C38.2, R77.2, R79.2; also elsewhere on the board
LPF: C39.1; also elsewhere on the board
PWM_RES: R74.1; also elsewhere on the board
VB2: R81.2, R82.2; also elsewhere on the board
VP: R83.1, R84.1; also elsewhere on the board
VREF: R88.2; also elsewhere on the board

Notes on the sheet:
CV_RES and resonance VCA
CV_RES: PWM filter and V-to-I converter (tail current of the resonance VCA)
Resonance VCA: differential pair, difference amplifier, AC-coupled feedback into the ladder (BIN2)

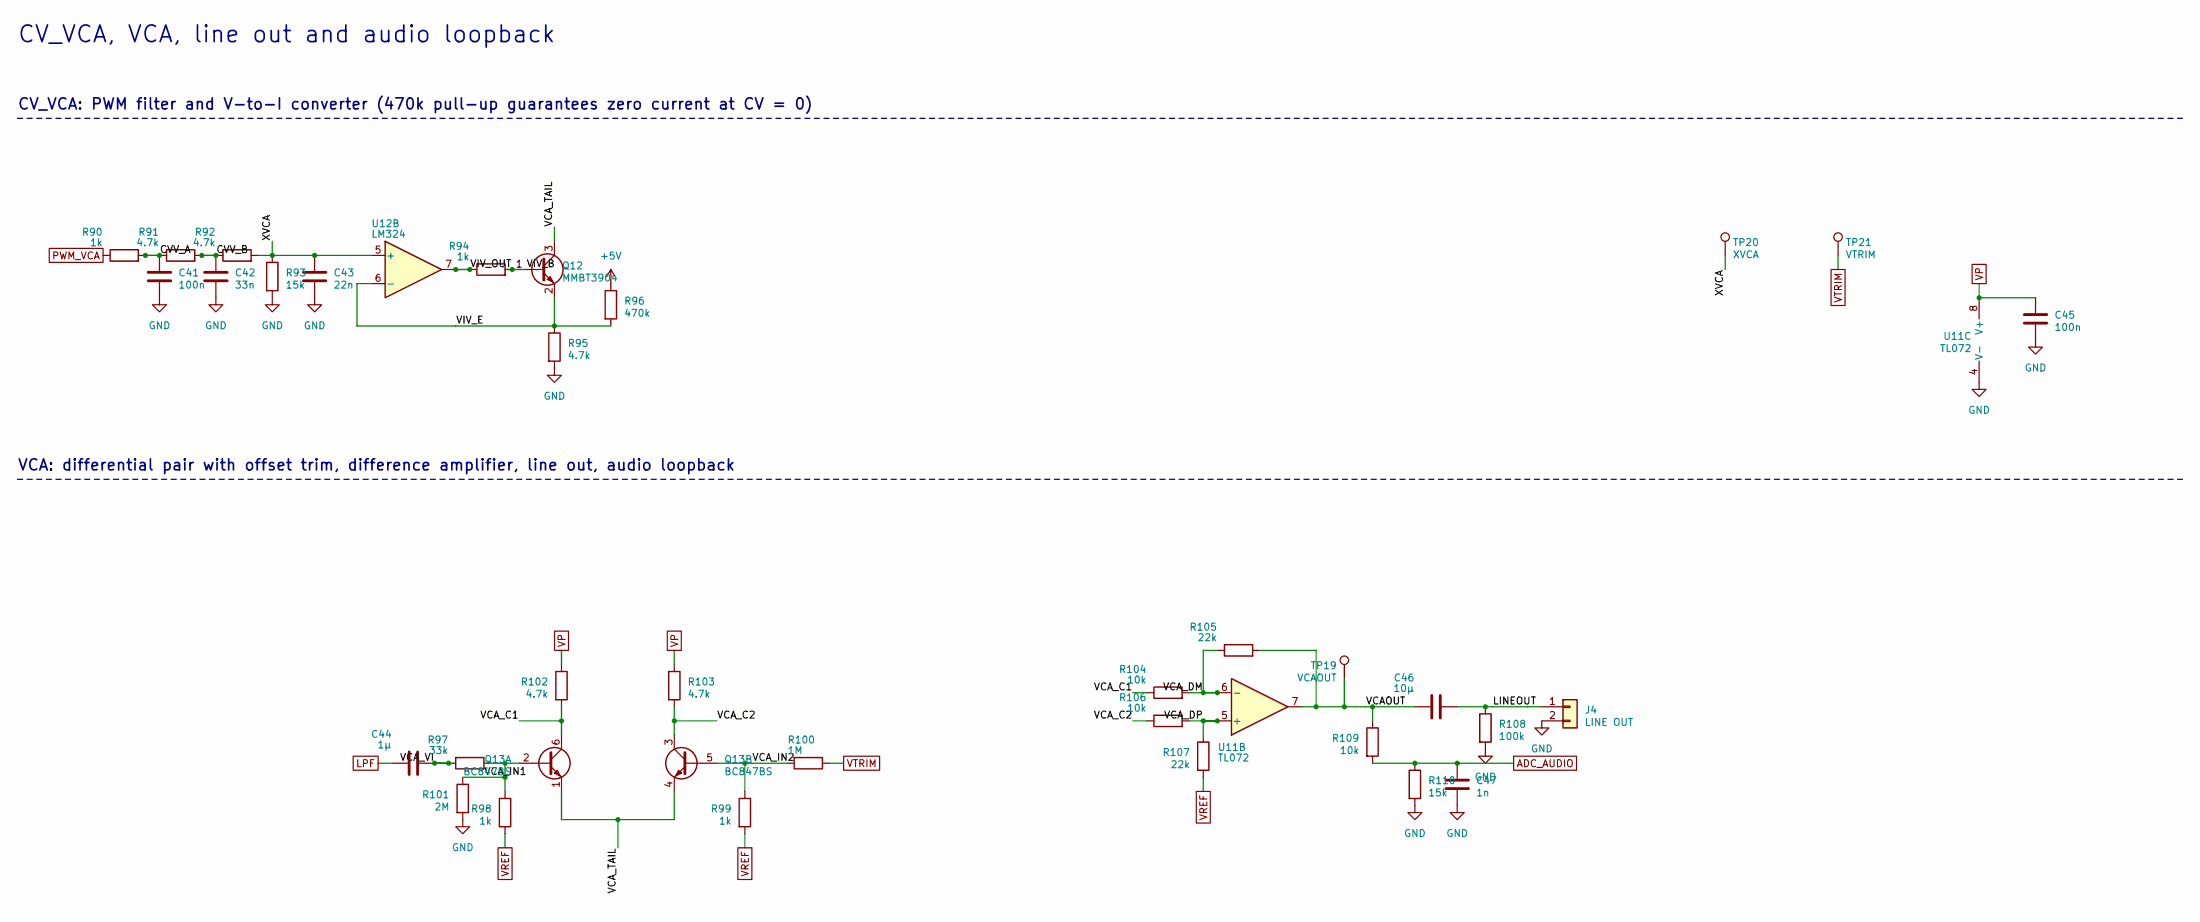
[picture p108: schematic vca.kicad_sch, TouchSynth — CV_VCA, VCA, line out and audio loopback]

Parts:
C41, C45: 100n; C_0603_1608Metric; LCSC C14663
C42: 33n; C_0603_1608Metric; LCSC C21117
C43: 22n; C_0603_1608Metric; LCSC C21122
C44: 1µ; C_0603_1608Metric; LCSC C15849
C46: 10µ; C_0603_1608Metric; LCSC C19702
C47: 1n; C_0603_1608Metric; LCSC C1588
J4: LINE OUT; PinHeader_1x02_P2.54mm_Vertical
Q12: MMBT3904; SOT-23; LCSC C20526
Q13: BC847BS; SOT-363_SC-70-6; LCSC C41375126
R90, R94, R98, R99: 1k; R_0603_1608Metric; LCSC C21190
R91, R92, R95, R102, R103: 4.7k; R_0603_1608Metric; LCSC C23162
R93, R110: 15k; R_0603_1608Metric; LCSC C22809
R96: 470k; R_0603_1608Metric; LCSC C23178
R97: 33k; R_0603_1608Metric; LCSC C4216
R100: 1M; R_0603_1608Metric; LCSC C22935
R101: 2M; R_0603_1608Metric; LCSC C22976
R104, R106, R109: 10k; R_0603_1608Metric; LCSC C25804
R105, R107: 22k; R_0603_1608Metric; LCSC C31850
R108: 100k; R_0603_1608Metric; LCSC C25803
TP19: VCAOUT; TestPoint_Pad_D1.0mm
TP20: XVCA; TestPoint_Pad_D1.0mm
TP21: VTRIM; TestPoint_Pad_D1.0mm
U11: TL072; SOIC-8_3.9x4.9mm_P1.27mm; LCSC C6961
U12: LM324; SOIC-14_3.9x8.7mm_P1.27mm; LCSC C71035

Connections:
+5V: R96.1; also elsewhere on the board
/vca/CVV_A: C41.1, R90.2, R91.1
/vca/CVV_B: C42.1, R91.2, R92.1
/vca/LINEOUT: C46.2, J4.1, R108.1
/vca/VCAOUT: C46.1, R105.2, R109.1, TP19.1, U11.7
/vca/VCA_C1: Q13.6 (C1), R102.2, R104.1
/vca/VCA_C2: Q13.3 (C2), R103.2, R106.1
/vca/VCA_DM: R104.2, R105.1, U11.6 (-)
/vca/VCA_DP: R106.2, R107.1, U11.5 (+)
/vca/VCA_IN1: Q13.2 (B1), R97.2, R98.1, R101.1
/vca/VCA_IN2: Q13.5 (B2), R99.1, R100.2
/vca/VCA_TAIL: Q12.3 (C), Q13.1 (E1), Q13.4 (E2)
/vca/VCA_VI: C44.2, R97.1
/vca/VIV_B: Q12.1 (B), R94.2
/vca/VIV_E: Q12.2 (E), R95.1, R96.2, U12.6 (-)
/vca/VIV_OUT: R94.1, U12.7
/vca/XVCA: C43.1, R92.2, R93.1, TP20.1, U12.5 (+)
ADC_AUDIO: C47.1, R109.2, R110.1; also elsewhere on the board
GND: C41.2, C42.2, C43.2, C45.2, C47.2, J4.2, R93.2, R95.2, R101.2, R108.2, R110.2, U11.4 (V-); also elsewhere on the board
LPF: C44.1; also elsewhere on the board
PWM_VCA: R90.1; also elsewhere on the board
VP: C45.1, R102.1, R103.1, U11.8 (V+); also elsewhere on the board
VREF: R98.2, R99.2, R107.2; also elsewhere on the board
VTRIM: R100.1, TP21.1; also elsewhere on the board

Notes on the sheet:
CV_VCA, VCA, line out and audio loopback
CV_VCA: PWM filter and V-to-I converter (470k pull-up guarantees zero current at CV = 0)
VCA: differential pair with offset trim, difference amplifier, line out, audio loopback

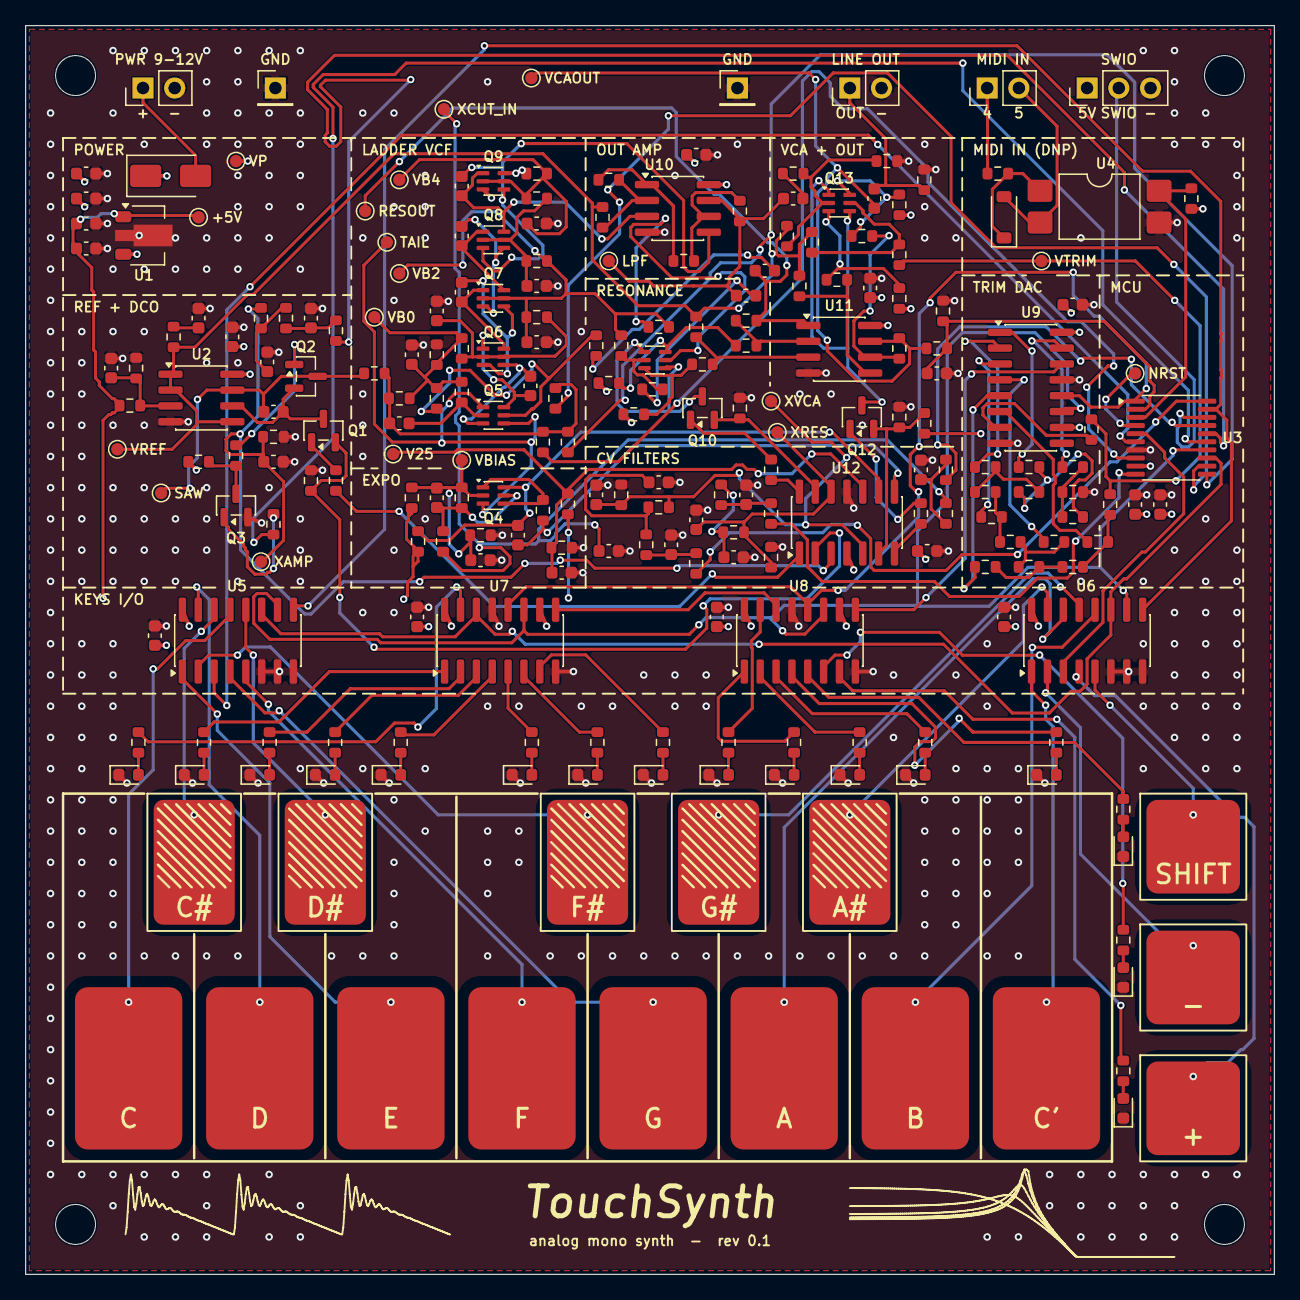
[picture p109: board touchsynth.kicad_pcb from above]

Board: 4 copper layers, 100.0 x 100.0 mm, 246 parts (0 on the bottom side), 166 nets.

Other parts of the board:
H1, H2, H3, H4: M3; MountingHole_3.2mm_M3
