cpldcpu/TouchSynth/firmware/touchsynth/funconfig.h

#ifndef _FUNCONFIG_H
#define _FUNCONFIG_H

#define FUNCONF_SYSTICK_USE_HCLK 1     /* SysTick at 48 MHz: 1 kHz control tick, Delay_Us */
#define FUNCONF_USE_DEBUGPRINTF  1     /* console over SWIO (minichlink -T) */

#endif
