cpldcpu/TouchSynth/sim/behav/bwv565_toccata.py

"""J. S. Bach, Toccata in D minor BWV 565 (public domain), measures 1-30 (first half, before the Fugue).
Extracted with sim/behav/musicxml.py from a MusicXML encoding (BWV_0565.xml, CapToMusic 2.10, 2020; three
staves: right hand, left hand, pedal). Times in quarter notes from the beginning."""
# (start, duration, midi, part 0 RH / 1 LH / 2 pedal, ornaments)
NOTES = [
    (0.0000, 0.5000, 81, 0, 'mordent'),
    (0.0000, 0.5000, 69, 0, 'mordent'),
    (0.6250, 0.0625, 79, 0, ''),
    (0.6250, 0.0625, 67, 0, ''),
    (0.6875, 0.0625, 77, 0, ''),
    (0.6875, 0.0625, 65, 0, ''),
    (0.7500, 0.0625, 76, 0, ''),
    (0.7500, 0.0625, 64, 0, ''),
    (0.8125, 0.0625, 74, 0, ''),
    (0.8125, 0.0625, 62, 0, ''),
    (0.8750, 0.1250, 73, 0, ''),
    (0.8750, 0.1250, 61, 0, ''),
    (1.0000, 0.2500, 74, 0, ''),
    (1.0000, 0.2500, 62, 0, ''),
    (2.0000, 0.5000, 69, 0, 'mordent'),
    (2.0000, 0.5000, 57, 1, 'mordent'),
    (2.6250, 0.1250, 64, 0, ''),
    (2.6250, 0.1250, 52, 1, ''),
    (2.7500, 0.1250, 65, 0, ''),
    (2.7500, 0.1250, 53, 1, ''),
    (2.8750, 0.1250, 61, 0, ''),
    (2.8750, 0.1250, 49, 1, ''),
    (3.0000, 0.2500, 62, 0, ''),
    (3.0000, 0.2500, 50, 1, ''),
    (4.0000, 0.5000, 57, 1, 'mordent'),
    (4.0000, 0.5000, 45, 1, 'mordent'),
    (4.6250, 0.0625, 55, 1, ''),
    (4.6250, 0.0625, 43, 1, ''),
    (4.6875, 0.0625, 53, 1, ''),
    (4.6875, 0.0625, 41, 1, ''),
    (4.7500, 0.0625, 52, 1, ''),
    (4.7500, 0.0625, 40, 1, ''),
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
TEMPI = [(1, 0.0, 30.0, 'Adagio. Toccata und Fuge in d-Moll.'), (3, 8.0, None, ''), (4, 12.0, 90.0, 'Prestissimo.'), (10, 36.0, 50.0, 'Lento.'), (12, 44.0, None, 'Allegro.'), (22, 84.0, 80.0, 'Prestissimo.'), (27, 104.0, 40.0, 'Maestoso.'), (30, 116.0, 80.0, '')]
