cpldcpu/TouchSynth/(commit log)

2026-09-26 Initial project: spec, JLCPCB parts lists, datasheets, ch32fun submodule
    [jlcpcb_basic_and_promotional_parts.csv, jlcpcb_basic_parts.csv, jlcpcb_promotional_extended_parts.csv]
2026-09-26 Simulations S1-S7, simulation report, verification plan, spec v0.2
    - ngspice models and per-block scripts (DCO, CV filters, ladder VCF, VCA,
    touch, full voice to WAV, power)
    - report-style figures (PDF+PNG) and CSV results in docs/
    - design changes from simulation folded into spec.md
    - verification & validation plan with sim-derived limits
    [s1_dco.csv, s2_cv.csv, s3_cutoff.csv, s3_selfosc.csv, s4_vca_feedthrough.csv, s4_vca_gain.csv, s4_vca_thd.csv, s5_touch.csv]
2026-09-26 Drop temperature sensor, keep NRST on PD7, accept power-on pop
    74HC595 LATCH back on PD4; cutoff drift (-13 cent/K) accepted for the
    demonstrator, optional firmware re-tune via audio loopback.
2026-09-26 Behavioural model, audio examples, demo tunes; fix CV network loading
    - sim/behav: firmware + analog behavioural model (numba), calibrated from
    ngspice results; validation against S6; 19 feature clips + 3 demo tunes
    - CV filter networks made load-aware (LIN ratio was 0.36 instead of 0.6,
    EXP span 67 %); all simulations now drive CVs through the real networks
    - VCA R_E 3k -> 4.7k, loopback divider 10k/15k
    - report revision 2, spec and V&V plan updated
    [behav_cal.csv, behav_validation.csv, s1_cal.csv, s1_dco.csv, s2_cv.csv, s3_cal.csv, s3_cutoff.csv, s3_res_peaks.csv]
2026-09-26 KiCad 10 schematic generated from hw/design.py
    - design.py: single source of truth (229 parts, LCSC basic/promo picks,
    sim names for traceability), 7 sheets with sub-block groups
    - gen_sch.py: schematic writer (stdlib symbols, label-based connections)
    - TouchSynth.pretty: touch key footprints (copper under solder mask)
    - checks: ERC 0 violations; exported netlist == design; 145 simulated
    elements match the schematic (check_sim.py)
    [dco.kicad_sch, mcu.kicad_sch, power.kicad_sch, resonance.kicad_sch, touch_led.kicad_sch, touchsynth.kicad_sch, vca.kicad_sch, vcf.kicad_sch]
2026-09-26 Schematic v2: hand-drawn sheet layouts with wires; MIDI in DNP
    - draw.py/gen_sch2.py/layouts.py: placement + wiring per block, automatic
    labels for remaining split nets, short detection, junctions, KiCad
    endpoint-only connection semantics
    - all 7 sheets laid out (ladder drawn as a transistor stack, diff amps,
    integrator with reset, R-2R DAC, ...); ERC 0 violations, netlist == design,
    145 simulated elements match
    - MIDI input parts marked DNP (footprints kept)
    - docs/touchsynth_schematic.pdf
    [dco.kicad_sch, mcu.kicad_sch, power.kicad_sch, resonance.kicad_sch, touch_led.kicad_sch, touchsynth.kicad_sch, vca.kicad_sch, vcf.kicad_sch]
2026-09-27 PCB placement by functional block, silkscreen art, discrete LED resistors
    - gen_pcb.py / pcb_place.py: 100 x 100 mm 2-layer board; keys, LEDs, connectors and test points fixed,
    ICs anchored per block, remaining parts placed greedily by connectivity inside their block
    - blocks tile the circuit area with a 0.35 mm street for the dashed silkscreen frames and a reserved
    title tab each (pcb_art.py); piano keybed with hatched black keys; logo, resonant saw and ladder
    response curves on the front; signal-flow diagram on the back
    - LED resistor arrays replaced by 16 discrete 4.7k 0603 (basic part) next to each LED
    - deterministic schematic UUIDs, net name labels for PCB parity, op-amp re-pairi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
    [dco.kicad_sch, mcu.kicad_sch, power.kicad_sch, resonance.kicad_sch, touch_led.kicad_sch, touchsynth.kicad_pcb, touchsynth.kicad_sch, vca.kicad_sch]
2026-09-27 4-layer PCB: keys I/O row, trim DAC by the VCA, full routing and fab outputs
    - 4 layers: F.Cu signals, In1 solid GND, In2 split power (VP analog / +5V digital / GND under the keys),
    B.Cu signals; no plane and no foreign tracks under the touch pads
    - floorplan: analog blocks 72 x 36 mm in signal-flow order, right column MIDI / trim DAC / MCU,
    keys I/O row (touch muxes, LED shift registers) directly above the keys; shorter white keys,
    function pads flush with the keybed; test points inside their blocks, two THT scope-ground pins
    - routing pipeline: plane stitch vias, pre-routed plane nets, Freerouting, GND via grid, island
    check, A* maze router for leftovers (pcb_maze.py), rip-up repai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
    [dco.kicad_sch, mcu.kicad_sch, power.kicad_sch, resonance.kicad_sch, touch_led.kicad_sch, touchsynth.kicad_pcb, touchsynth.kicad_sch, vca.kicad_sch]
2026-09-27 LaTeX design report (rev 0.1)
    docs/report/touchsynth_report.tex: requirements, architecture, circuit design, simulations S1-S7,
    behavioural model, 4-layer PCB, BOM with cost, firmware outline, V&V plan, open points, schematic
    appendix. Tables (BOM, floorplan, statistics) are generated from the design data by gen_tables.py.
2026-09-27 Firmware 0.1 (CH32V003 / V002 / V006) and longer demo tunes
    - firmware/touchsynth: dithered CV PWM (TIM1), DCO reset/pulse/sub (TIM2), noise, 595 chain (LEDs + trim
    DAC), CD4051 touch scan, loopback capture, MIDI in, 1 kHz voice engine mirroring the behavioural model,
    SHIFT/-/+ UI, demo tune player, SWIO test console; 11.7 KB flash on the CH32V003
    - tables.h generated from the simulation results and tunes.py (gen_tables.py)
    - check_pins.py: firmware pins vs. netlist, KiCad symbol and remap tables of both chip families;
    the V00x remap codes differ from the V003 (TIM1_RM 0010, TIM2_RM 010) - resolves the open spec point
    - demo tunes: prelude bars 1-19, full Ode to Joy theme, acid A A B A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
    [board.h, check_pins.py, console.c, examples.py, funconfig.h, gen_tables.py, hw.c, hw.h]
2026-10-18 Board 1 bring-up, multitrack demo pieces and percussion engine
    Bring-up and tests of board 1 (CH32V006):
    - B1-B12 and functional tests T1, T2, T4-T12 measured; results, figures and
    findings in the report (section 10) and the verification plan
    - simulation models corrected (78L05 load current, TL072 supply current)
    - firmware fixes: trim DAC MSB, ADC re-arm on V00x, touch calibration
    (warm-up, 64-scan statistics, threshold floor, debounce), LED display,
    manual mode left on key touch; new console commands for diagnostics
    Demo music:
    - tune format with control steps (cutoff / resonance ramps), hold / tie,
    per-tune step time; multitrack parts on the CH32V006
    - TouchSynth Demo, Purcell's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
    [dco_36.csv, dco_43.csv, dco_48.csv, dco_55.csv, dco_60.csv, dco_67.csv, dco_72.csv, dco_79.csv]
2026-10-18 PWM DAC mode and a modal timpani (kettle) on the CH32V006
    The pulse output becomes a PWM DAC for digital voices that pass through the
    analog filter and VCA:
    - TIM2 centre-aligned at 93.75 kHz (8-bit, symmetric pulses), DMA1 channel 2
    loads the duty from a ring buffer; 15.625 kHz samples, linear interpolation,
    first-order noise shaping; the DCO is held in reset meanwhile
    - S8 (ngspice): edge-aligned vs centre-aligned vs interpolated vs ideal DAC;
    centred pulses remove the 0.6 % second harmonic, interpolation lowers the
    sampling images by 23 dB
    - dsp.c: modal drum synthesis in fixed point (17 resonators, two banks,
    restrikes, soft clipper), refill loop in SRAM, run from the main loop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
    [hw_board1_kettle.csv, s8_dac.csv]
2026-10-18 Clean scope recordings; PWM carrier crosstalk earmarked for a board revision
    - scope.py: .u8 takes store the scope's raw 8-bit samples at full rate;
    mix_parts.py decimates them with a FIR low-pass instead of a 2-sample
    average; *CLS before each recording clears stale scope errors
    - record_parts.sh: raw takes and no console polling during a take (each
    exchange blocks the main loop ~20 ms, which caused DAC dropouts)
    - March timpani recorded again with the committed firmware
    - report: carrier crosstalk at the line out (5.8 mV at 93.75 kHz, past filter
    and VCA) and how a 200 kSa/s scope take folds it into the audio band; board
    revision item (slower PULSE edges, routing) with a 375 kHz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
